prs2026/Lyra-flight-computer/Hardware/datasheets/Radio module based TI CC1200. - Radio modules, Dongles_files/ABUIABACGAAgv4mNmwYokPiDzgMw6Ac46Ac.jpg

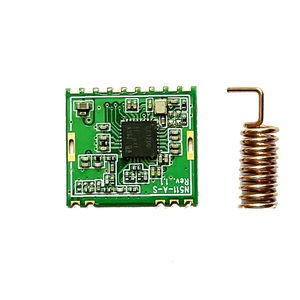
Hardware/datasheets/Radio module based TI CC1200. - Radio modules, Dongles_files/ABUIABACGAAgv4mNmwYokPiDzgMw6Ac46Ac.jpg
