prs2026/Lyra-flight-computer/Hardware/datasheets/Radio module based TI CC1200. - Radio modules, Dongles_files/ABUIABACGAAguJqjggYo55KYYjDoBzjnBw.jpg

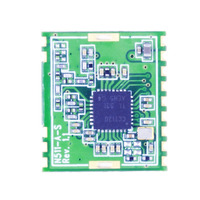
Hardware/datasheets/Radio module based TI CC1200. - Radio modules, Dongles_files/ABUIABACGAAguJqjggYo55KYYjDoBzjnBw.jpg
