prs2026/Lyra-flight-computer/README.md

# Lyra-flight-computer
 repo for the lyra flight computer
