prs2026/Lyra-flight-computer/Hardware/kicad/lero ground station/design.rtf

Overview:
pico connected to a 4 line LCD, speaker, radio and sd

voice sythesis? or otherwise voice output on a speaker
battery charging circuit?

workings:
recieve data from lyra, log to sd card and display on the lcd.

stuff to display
Altitude
lat + long when I add gps
MET
