prs2026/Lyra-flight-computer/Hardware/datasheets/Radio module based TI CC1200. - Radio modules, Dongles_files/ABUIABAEGAAg1KeBlQYo9vu29QQwpAc46gY.png

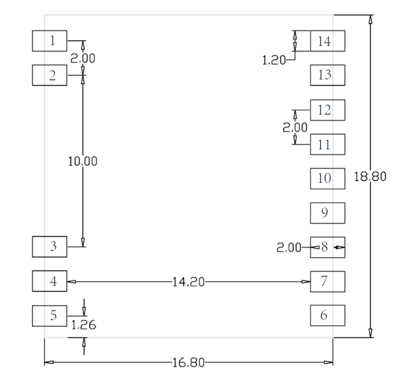
Hardware/datasheets/Radio module based TI CC1200. - Radio modules, Dongles_files/ABUIABAEGAAg1KeBlQYo9vu29QQwpAc46gY.png
