prs2026/Lyra-flight-computer/Hardware/datasheets/Radio module based TI CC1200. - Radio modules, Dongles_files/ABUIABAEGAAgr9ThggYow-nh9QQwoAY4wAI.png

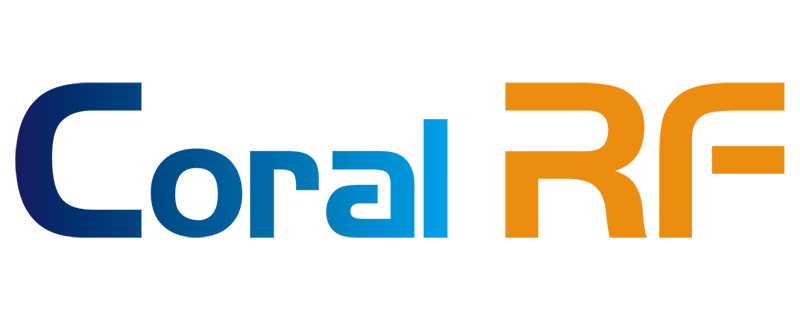
Hardware/datasheets/Radio module based TI CC1200. - Radio modules, Dongles_files/ABUIABAEGAAgr9ThggYow-nh9QQwoAY4wAI.png
