prs2026/Lyra-flight-computer/Hardware/datasheets/Radio module based TI CC1200. - Radio modules, Dongles_files/ABUIABAEGAAgvt3XlAYovsDUowUwhgo4zQQ.png

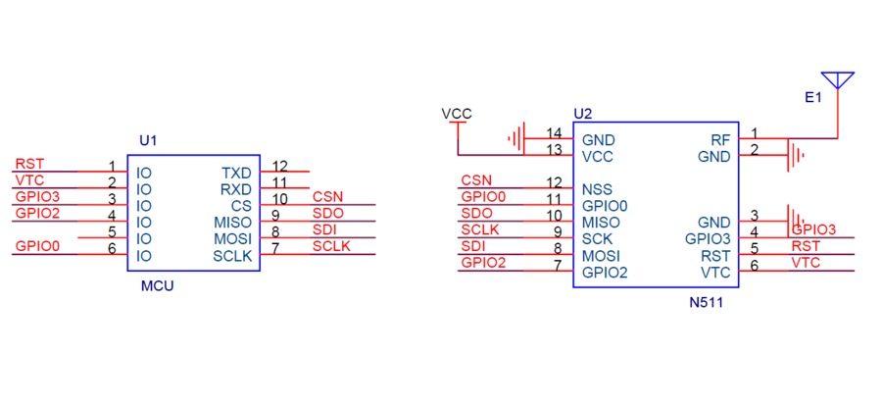
Hardware/datasheets/Radio module based TI CC1200. - Radio modules, Dongles_files/ABUIABAEGAAgvt3XlAYovsDUowUwhgo4zQQ.png
