prs2026/Lyra-flight-computer/Software/Ground/lero reciver/audio player arduino/circuit sd addeptor.jpg

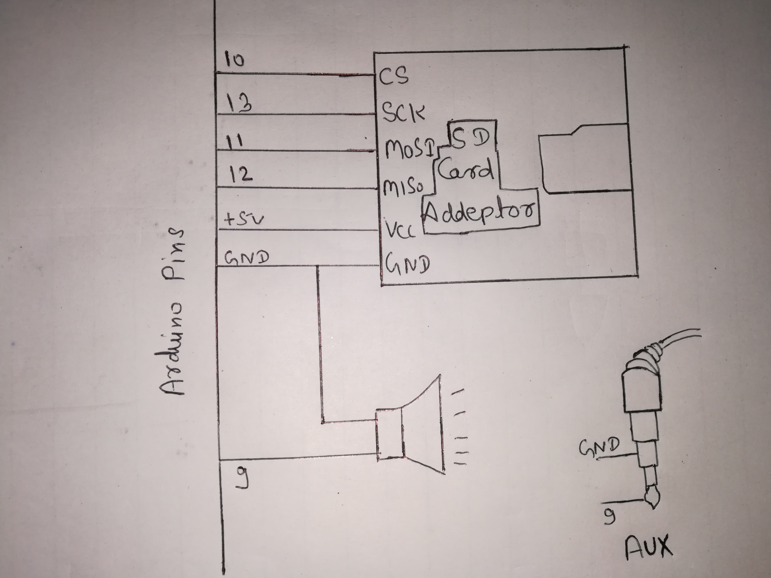
Software/Ground/lero reciver/audio player arduino/circuit sd addeptor.jpg
