prs2026/Lyra-flight-computer/Hardware/kicad/Leo/jlcpcb/production_files/BOM-LEO.csv

Comment | Designator | Footprint | LCSC
1k | R10,R11,R12,R14,R17,R28,R3 | R_0402_1005Metric | C11702
AO3401A | Q1,Q3 | SOT-23 | C15127
100n | C1,C12,C13,C16,C17,C2,C21,C22,C23,C24,C25,C26,C27,C3,C4,C50,C8,C9 | C_0402_1005Metric | C1525
D_Schottky | D1 | D_SOD-323F | C191023
RT9013-33GB_C19268157 | U6 | SOT-23-5_L2.9-W1.6-P0.95-LS2.8-BR | C19268157
BMI088 | U2 | LGA-16_L4.5-W3.0-P0.50-BL | C194919
RP2040 | U8 | QFN-56-1EP_7x7mm_P0.4mm_EP3.2x3.2mm | C2040
AO3400A | Q2,Q4,Q5,Q9 | SOT-23 | C20917
22R | R15,R18 | R_0402_1005Metric | C25092
30k | R2,R20,R22,R24,R26 | R_0402_1005Metric | C25105
51k | R21,R23,R25,R27,R4 | R_0402_1005Metric | C25794
5.1k | R1,R13,R16 | R_0402_1005Metric | C25905
SX1M12.000M10F30TNN | X2 | OSC-SMD_4P-L2.0-W1.6-BL | C2901608
USB_B_Micro | J7 | MICRO-USB-SMD_U254-051T-4BHJ25-F2S | C381143
LIS3MDLTR | U4 | LGA-12_L2.0-W2.0-P0.50-BL | C478483
ADXL375BCCZ-RL7 | U5 | LGA-14_L5.0-W3.0-P0.80-BL | C481898
1u | C18,C19,C32,C5,C6 | C_0402_1005Metric | C52923
BMP388 | U3 | SENSORM-SMD_BMP388 | C779278
10u | C7 | C_0603_1608Metric | C96446
W25Q128JVS | U9 | SOIC-8_5.23x5.23mm_P1.27mm | C97521
