prs2026/Lyra-flight-computer/Hardware/kicad/Lyra_flight_computer/lyrav3revised/lyrav3r1/power use.xlsx

part | datasheet | max power draw (mA) | total power draw
rp2040 | https://datasheets.raspberrypi.com/rp2040/rp2040-datasheet.pdf | 50 | 201
flash | http://www.winbond.com/resource-files/w25q128jv_dtr%20revc%2003272018%20plus.pdf | 25
high g accel | https://lcsc.com/product-detail/New-Arrivals_Analog-Devices-ADI-ADXL375BCCZ-RL7_C481898.html | 0.2
bmp390 | https://www.mouser.com/pdfdocs/BST-BMP388-DS001-01.pdf | 0.8
bmi088 | https://download.mikroe.com/documents/datasheets/BMI088_Datasheet.pdf | 5
sx1262 |  | 120
