prs2026/Lyra-flight-computer/CamControl/camcontrol stm32/camcontrol stm32.step

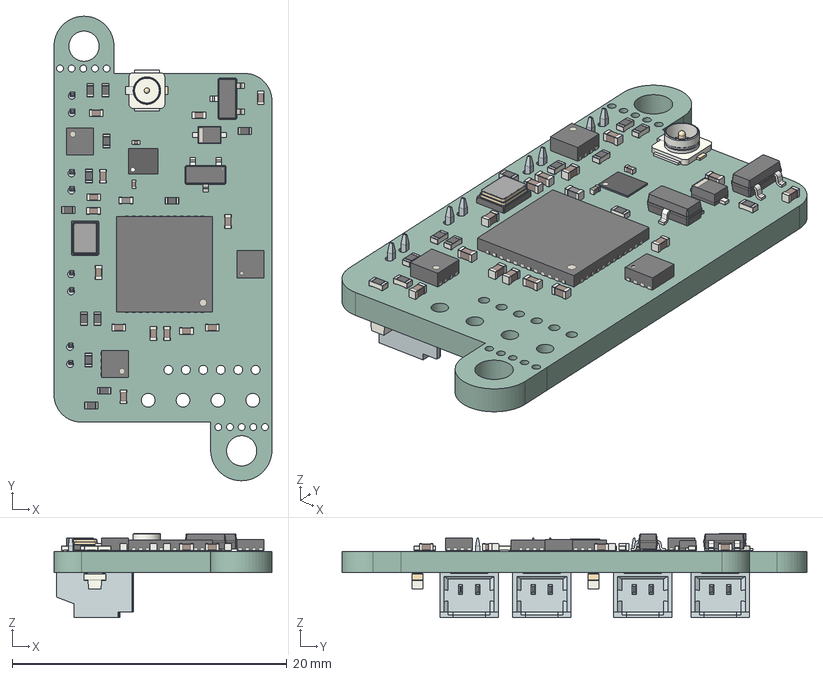
[picture p7: CAD file, 2025-12-25]
CamControl/camcontrol stm32/camcontrol stm32.step
15.9 x 33.8 x 6.13 mm
C_0402_1005Metric x 14
R_0402_1005Metric x 12
D_SOD-323F
C_0201_0603Metric x 2
CSPG-8_L2.1-W1.8_BALFHB-WL-03D3
SOT-23 x 2
DFN-8_2x2mm_P0.5mm x 2
WSON-8-1EP_2x2mm_P0.5mm_EP0.9x1.6mm
QFN-48-1EP_7x7mm_P0.5mm_EP5.15x5.15mm
Crystal_SMD_2520-4Pin_2.5x2.0mm
U.FL_Hirose_U.FL-R-SMT-1_Vertical
L_0402_1005Metric
LED_0603_1608Metric x 2
camcontrol stm32_PCB
