prs2026/Lyra-flight-computer/Hardware/kicad/Lyra_flight_computer/lyrav3r1/lyrav3r2/Lyrav3r2.step

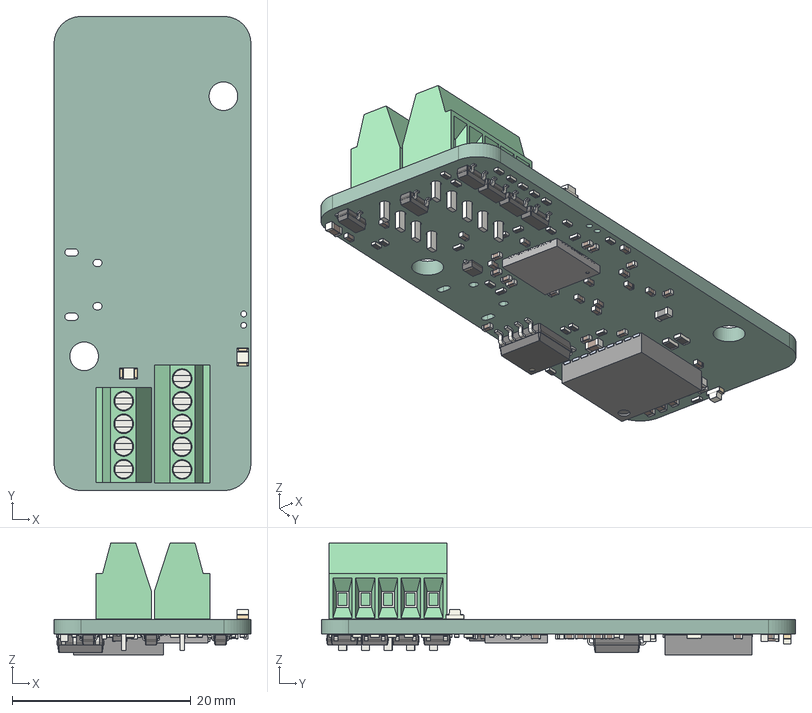
[picture p9: CAD file, 2024-06-25]
Hardware/kicad/Lyra_flight_computer/lyrav3r1/lyrav3r2/Lyrav3r2.step
22.0 x 53.0 x 12.5 mm
TerminalBlock_Phoenix_MPT_05_5_254_1x05_P254mm_Horizontal
TerminalBlock_Phoenix_MPT_05_4_254_1x04_P254mm_Horizontal
LED_0805_2012Metric x 2
C_0402_1005Metric x 28
R_0402_1005Metric x 24
C_0603_1608Metric x 7
SOT_23 x 6
SOIC_8_5275x5275mm_P127mm
D_SOD_323F
QFN_56_1EP_7x7mm_P04mm_EP32x32mm
R_0603_1608Metric x 2
L_0603_1608Metric
LED_0603_1608Metric
L_0402_1005Metric
ASSEMBLY
lyrav3r2_PCB
