prs2026/Lyra-flight-computer/Hardware/kicad/Lyra_flight_computer/lyrav3r1/recivier/recivier.step

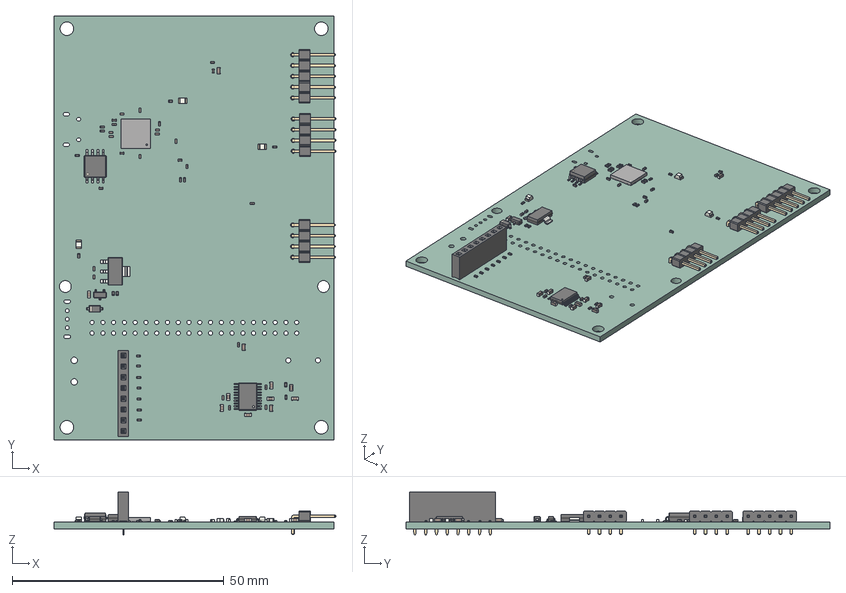
[picture p10: CAD file, 2024-04-02]
Hardware/kicad/Lyra_flight_computer/lyrav3r1/recivier/recivier.step
66.4 x 100.0 x 10.1 mm
R_0402_1005Metric x 20
QFN_56_1EP_7x7mm_P04mm_EP32x32mm
C_0402_1005Metric x 24
TSSOP_20_44x65mm_P065mm
C_0603_1608Metric x 11
PinHeader_1x04_P254mm_Horizontal x 2
D_SOD_123
PinHeader_1x05_P254mm_Horizontal
SOT_23
LED_0805_2012Metric x 3
SOIC_8_5275x5275mm_P127mm
PinSocket_1x08_P254mm_Vertical
SOT_223
recivier_PCB
