prs2026/Lyra-flight-computer/Hardware/kicad/Lyra_flight_computer/lyrav3revised/lyrav3r1/Lyrav3.step

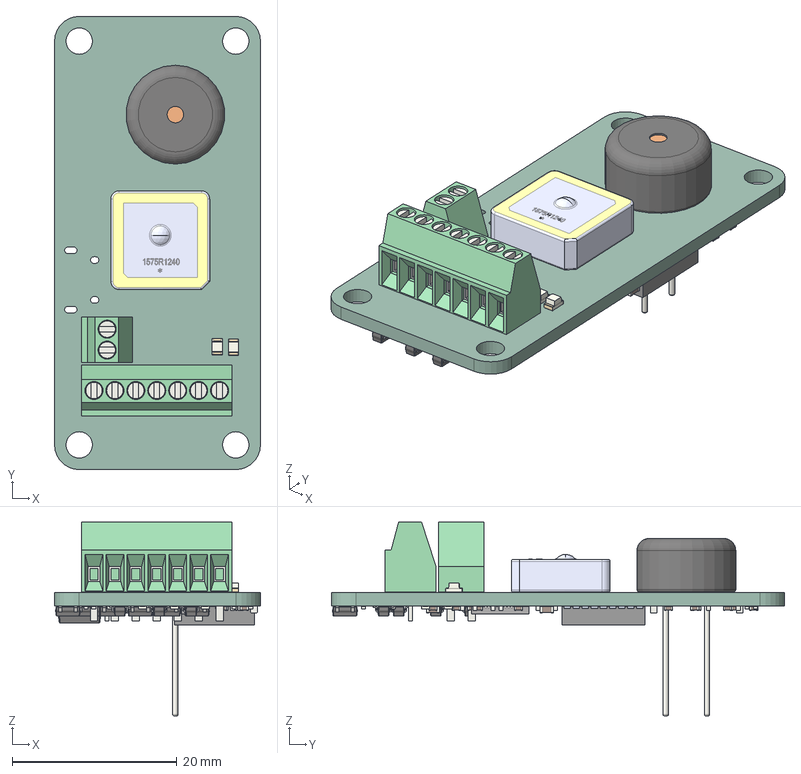
[picture p11: CAD file, 2024-10-01]
Hardware/kicad/Lyra_flight_computer/lyrav3revised/lyrav3r1/Lyrav3.step
25.0 x 55.0 x 23.5 mm
Buzzer_TDK_PS1240P02BT
TerminalBlock_Phoenix_MPT_05_7_254_1x07_P254mm_Horizontal
APAE1575R1240ABDD1-T
TerminalBlock_Phoenix_MPT_05_2_254_1x02_P254mm_Horizontal
LED_0805_2012Metric x 2
C_0402_1005Metric x 29
R_0402_1005Metric x 18
SOT_23 x 10
SOIC_8_5275x5275mm_P127mm
D_SOD_323F
QFN_56_1EP_7x7mm_P04mm_EP32x32mm
C_0603_1608Metric x 4
L_0402_1005Metric x 2
DFN-6_L1.5-W1.0-H0.7-P0.50
ASSEMBLY
lyrav3r1_PCB
