prs2026/Lyra-flight-computer/Hardware/kicad/Lyra_flight_computer/lyrav3revised/lyrav3r2/Lora E22-900MM22S.STEP

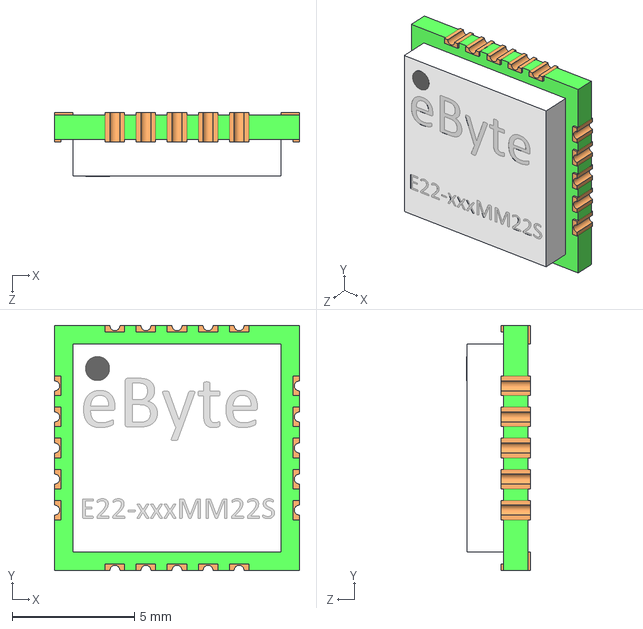
[picture p12: CAD file, 2024-06-25]
Hardware/kicad/Lyra_flight_computer/lyrav3revised/lyrav3r2/Lora E22-900MM22S.STEP
10.0 x 10.0 x 2.61 mm
