prs2026/Lyra-flight-computer/Hope/Hope/Hope.step

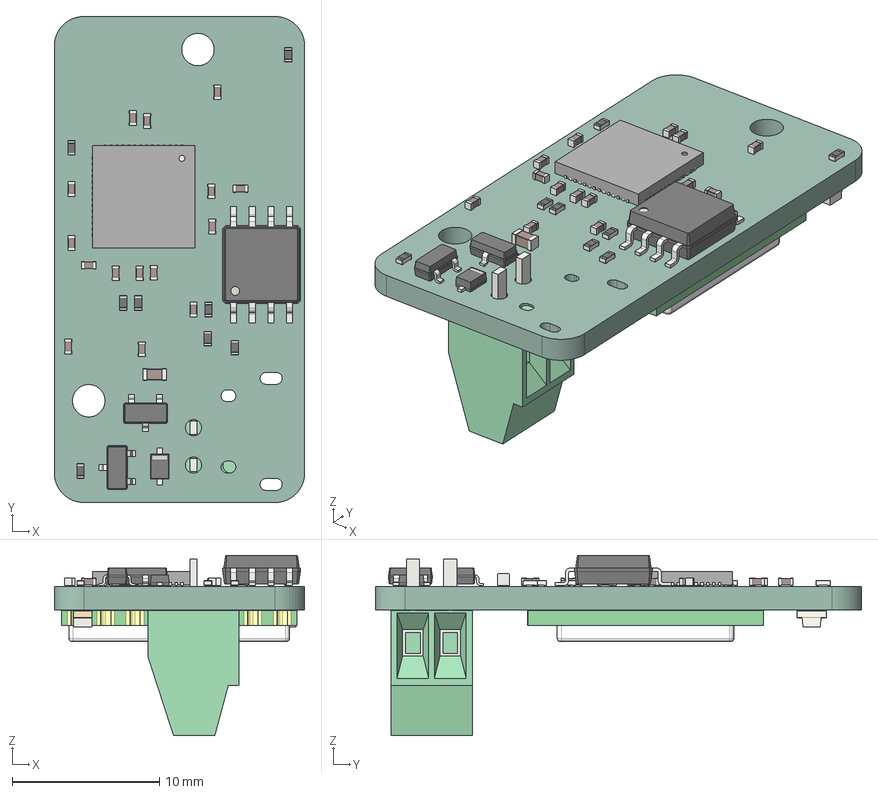
[picture p13: CAD file, 2025-02-11]
Hope/Hope/Hope.step
17.0 x 33.0 x 12.3 mm
C_0402_1005Metric x 15
R_0402_1005Metric x 8
SOT_23 x 2
D_SOD_323F
SOIC_8_5275x5275mm_P127mm
QFN_56_1EP_7x7mm_P04mm_EP32x32mm
C_0603_1608Metric
TerminalBlock_Phoenix_MPT_05_2_254_1x02_P254mm_Horizontal
WIRELM-SMD_16P-L16.0-W16.0-P2.00_LORA-CC68-915MHZ-TCXO
LED_0805_2012Metric x 2
Hope_PCB
