prs2026/Lyra-flight-computer/it sure is getting hot in here/it sure is getting ROUND in here/it sure is getting hot in hererev1.step

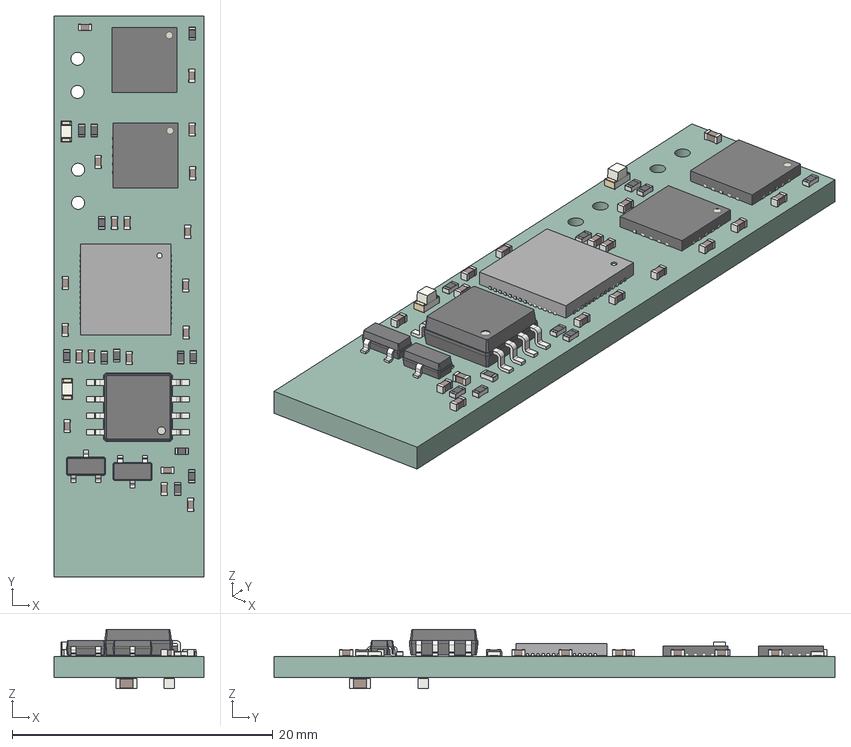
[picture p14: CAD file, 2025-09-30]
it sure is getting hot in here/it sure is getting ROUND in here/it sure is getting hot in hererev1.step
11.5 x 43.0 x 4.55 mm
LED_0603_1608Metric x 2
C_0402_1005Metric x 19
R_0402_1005Metric x 12
QFN-20-1EP_5x5mm_Pitch0.65mm x 2
SOT_23 x 2
QFN_56_1EP_7x7mm_P04mm_EP32x32mm
SOIC_8_5275x5275mm_P127mm
C_0603_1608Metric x 2
it sure is getting hot in here_PCB
