prs2026/Lyra-flight-computer/Metrumizer/metrumizer/metrumizer.step

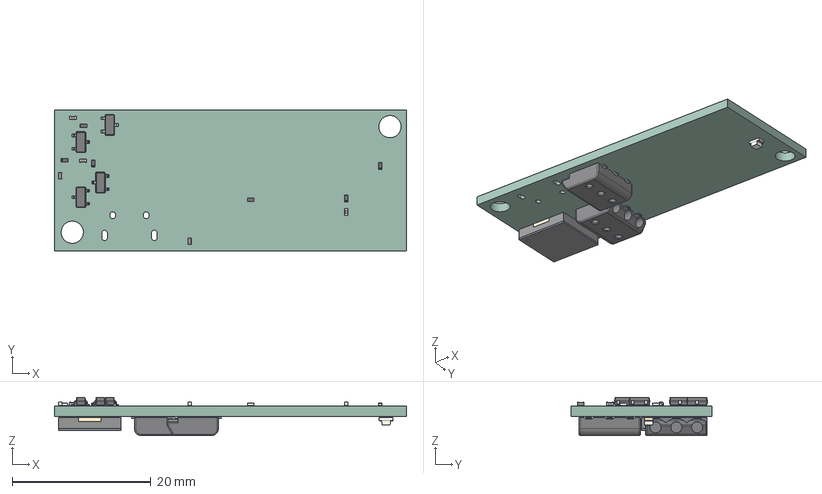
[picture p15: CAD file, 2025-12-25]
Metrumizer/metrumizer/metrumizer.step
50.8 x 20.3 x 5.53 mm
C_0402_1005Metric x 4
R_0402_1005Metric x 6
SOT-23 x 4
L_0402_1005Metric
LED_0805_2012Metric
PKMCS0909E4000-R1
2059-323_998-403_HI x 2
metrumizer_PCB
