prs2026/Lyra-flight-computer/Hardware/kicad/Leo/LEO.step

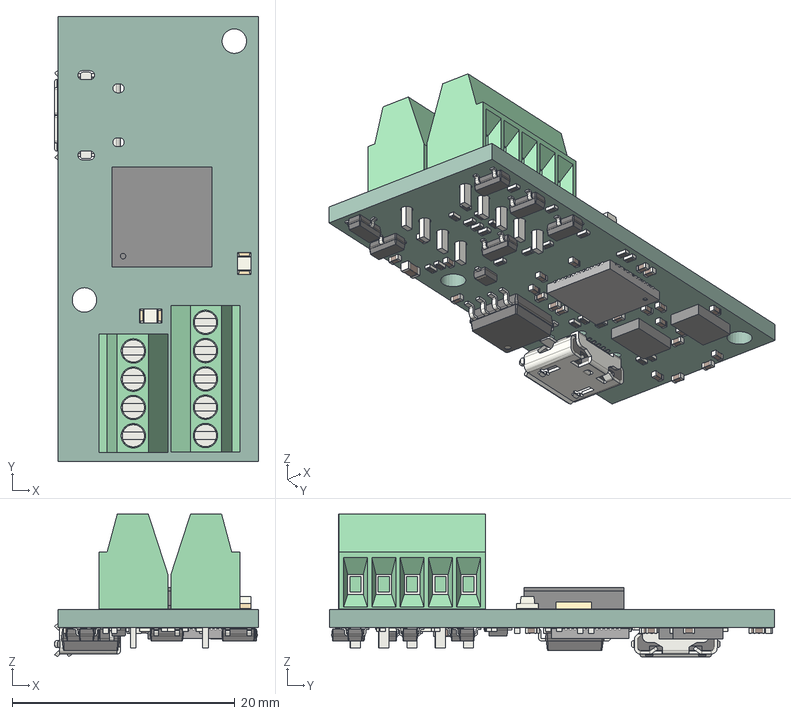
[picture p16: CAD file, 2024-10-01]
Hardware/kicad/Leo/LEO.step
18.3 x 40.0 x 12.8 mm
PKMCS0909E4000-R1
TerminalBlock_Phoenix_MPT_05_5_254_1x05_P254mm_Horizontal
TerminalBlock_Phoenix_MPT_05_4_254_1x04_P254mm_Horizontal
LED_0805_2012Metric x 2
R_0402_1005Metric x 22
C_0402_1005Metric x 23
SOT_23 x 6
SOIC_8_5275x5275mm_P127mm
D_SOD_323F
QFN_56_1EP_7x7mm_P04mm_EP32x32mm
C_0603_1608Metric
BMI088 x 2
USB_Micro-B_Molex_47346-0001
lyrav3r2_PCB
