prs2026/Lyra-flight-computer/Hardware/kicad/Lyra_flight_computer/lyrav3revised/lyrav3r1/Lyrav3r2.step

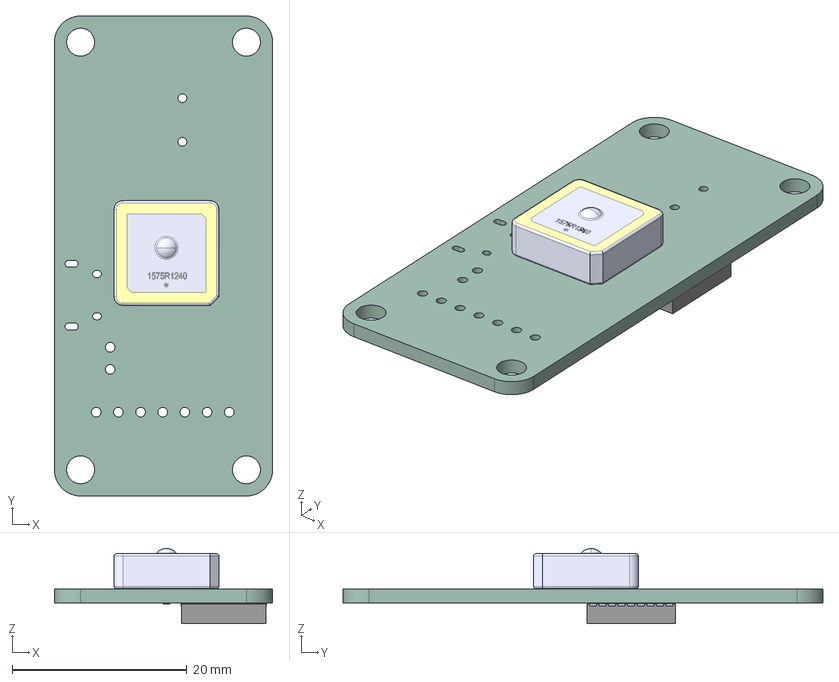
[picture p17: CAD file, 2024-04-06]
Hardware/kicad/Lyra_flight_computer/lyrav3revised/lyrav3r1/Lyrav3r2.step
25.0 x 55.0 x 8.60 mm
APAE1575R1240ABDD1-T
ASSEMBLY
lyrav3r1_PCB
