prs2026/Lyra-flight-computer/it sure is getting hot in here/it sure is getting ROUND in here/it sure is getting hot in hererev2.step

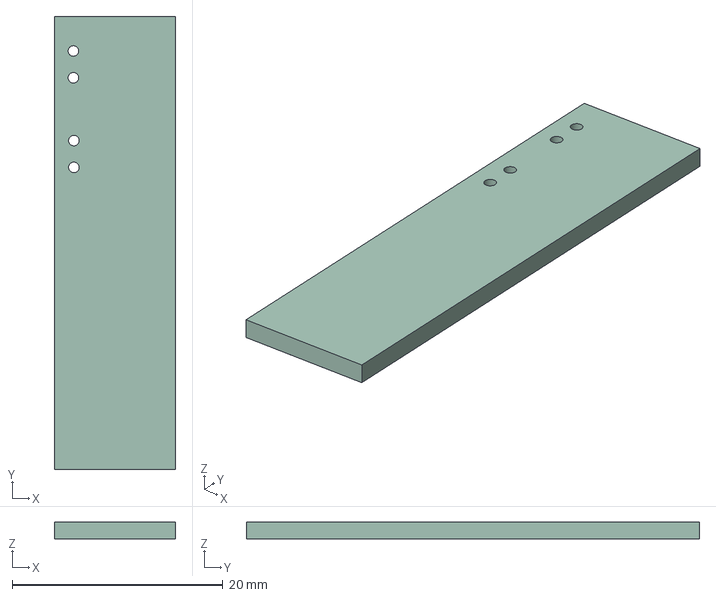
[picture p18: CAD file, 2025-09-30]
it sure is getting hot in here/it sure is getting ROUND in here/it sure is getting hot in hererev2.step
11.5 x 43.0 x 1.60 mm
