prs2026/Lyra-flight-computer/it sure is getting hot in here/it sure is getting ROUND in here/it sure is getting hot in here.step

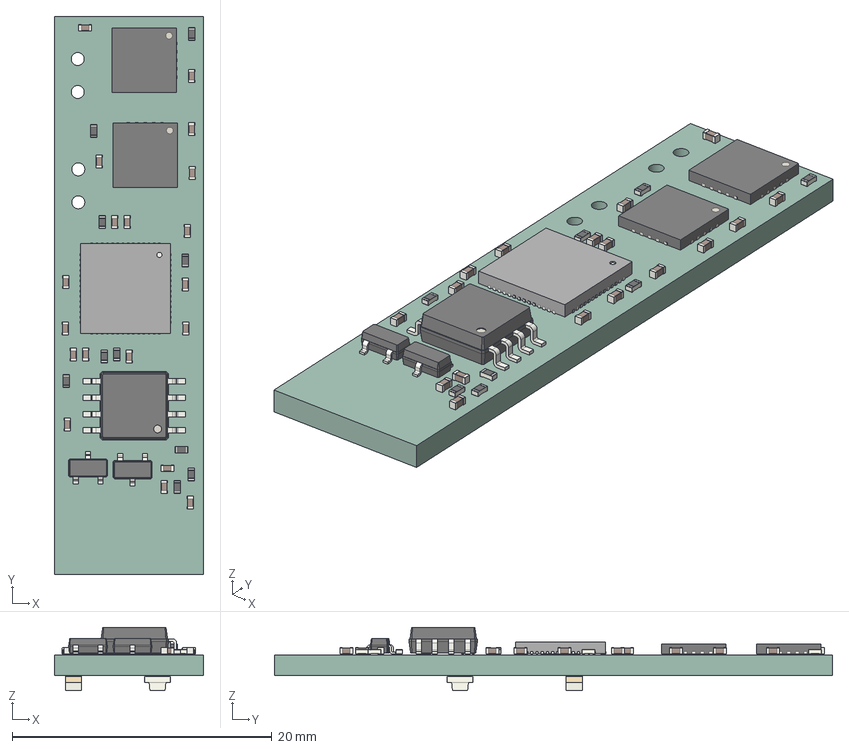
[picture p19: CAD file, 2025-08-10]
it sure is getting hot in here/it sure is getting ROUND in here/it sure is getting hot in here.step
11.5 x 43.0 x 4.86 mm
C_0402_1005Metric x 19
R_0402_1005Metric x 10
QFN-20-1EP_5x5mm_Pitch0.65mm x 2
SOT_23 x 2
QFN_56_1EP_7x7mm_P04mm_EP32x32mm
SOIC_8_5275x5275mm_P127mm
LED_0805_2012Metric x 2
it sure is getting hot in here_PCB
