prs2026/Lyra-flight-computer/Hardware/kicad/screw switch/screw switch.step

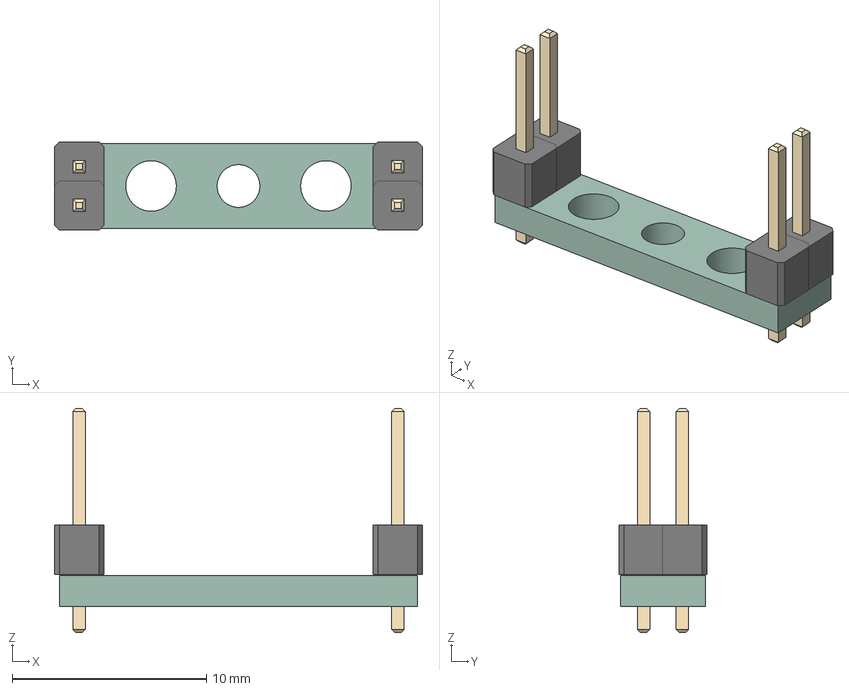
[picture p20: CAD file, 2024-04-09]
Hardware/kicad/screw switch/screw switch.step
18.9 x 4.54 x 11.5 mm
PinHeader_1x01_P254mm_Vertical x 4
screw switch_PCB
