prs2026/Lyra-flight-computer/it sure is getting hot in here/ISIGHIH Firmware/test/test.csv

index | checksum | uptime mp | uptime nav | missiontime | errorflag mp | errorflag NAV | accel x | accel y | accel z | accelworld x | accelworld y | accelworld z | mag x | mag y | mag z | accelhighg x | accelhighg y | accelhighg z | gyro x | gyro y | gyro z | euler x | euler y | euler z | quat w | quat x | quat y | quat z | quatadj w | quatadj x | quatadj y | quatadj z | altitude | presusre | verticalvel | filtered vvel | maxalt | altitudeagl | filtered alt | imutemp | barotemp | abs imu accel | abs adxl accel | pad altitude | baro max alt | mag raw x | mag raw y | mag raw z | cov x | cov y | cov z | sats | status | met | filtered accel | state | battstate | pyros fired | pyros cont
newfile
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
