prs2026/Lyra-flight-computer/it sure is getting hot in here/ISIGHIH Firmware/datatesting/test1.csv

index | checksum | uptime mp | uptime nav | errorflag mp | errorflag NAV | accel x | accel y | accel z | accelworld x | accelworld y | accelworld z | accelhighg x | accelhighg y | accelhighg z | gyro x | gyro y | gyro z | euler x | euler y | euler z | quat w | quat x | quat y | quat z | altitude | presusre | verticalvel | filtered vvel | altitudeagl | filtered alt | imutemp | barotemp | state | checksum2
0 | 101 | 0 | 0 | 1 | 1 | 0.000000 | 0.000000 | 0.000000 | 0.000000 | 0.000000 | 0.000000 | 0.000000 | 0.000000 | 0.000000 | 0.000000 | 0.000000 | 0.000000 | 0.000000 | 0.000000 | 0.000000 | 1.000000 | 0.000000 | 0.000000 | 0.000000 | 0.000000 | 0.000000 | 0.000000 | 0.000000 | 0.000000 | 0.000000 | 0.000000 | 0.000000 | 0.000000 | 0 | 0.000000 | 202
1 | 101 | 3313 | 0 | 1 | 1 | 0.000000 | 0.000000 | 0.000000 | 0.000000 | 0.000000 | 0.000000 | 0.000000 | 0.000000 | 0.000000 | 0.000000 | 0.000000 | 0.000000 | 0.000000 | 0.000000 | 0.000000 | 1.000000 | 0.000000 | 0.000000 | 0.000000 | 0.000000 | 0.000000 | 0.000000 | 0.000000 | 0.000000 | 0.000000 | 0.000000 | 0.000000 | 0.000000 | 0 | 0.000000 | 202
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
