prs2026/Lyra-flight-computer/avionics/Lyra_flight_computer/flight logs/pyxisflight1.CSV

checksum | uptime mp | uptime nav | errorflag mp | errorflag nav | accel x | accel y | accel z | gyro x | gyro y | gyro z | mag x | mag y | mag z | magraw x | magraw y | magraw z | euler x | euler y | euler z | quat w | quat x | quat y | quat z | altitude | pressure | verticalvel | maxrecorded alt | altitudeagl | filteredalt | imutemp | barotemp | state | checksum2
101 | 1260387 | 1252626 | 0 | 0 | -0.177125 | 0.500252 | 9.898839 | 0.354960 | 0.654396 | 0.094211 | -18.479397 | 40.888618 | -0.321543 | -3787.000000 | 3631.000000 | -22.000000 | 4.268216 | -86.976380 | 69.927217 | 0.608846 | -0.371965 | -0.579086 | 0.394471 | 1214.335449 | 87473.000000 | -0.153709 | 1.551636 | 1.353394 | 1.311904 | 35.000000 | 38.999214 | 0 | 202
101 | 1262394 | 1262310 | 0 | 0 | -0.164170 | 0.498941 | 9.900160 | -0.031020 | -0.137473 | 0.366430 | -18.503839 | 40.928665 | -0.643087 | -3791.000000 | 3638.000000 | -44.000000 | 6.118524 | -86.963007 | 71.786914 | 0.608505 | -0.371485 | -0.579361 | 0.395046 | 1214.402954 | 87475.445312 | 0.144479 | 1.561157 | 1.420898 | 1.417515 | 35.000000 | 39.003880 | 0 | 202
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
