prs2026/Lyra-flight-computer/avionics/Lyra_flight_computer/flight logs/zubeflight2.CSV

checksum | uptime mp | uptime nav | errorflag mp | errorflag nav | accel x | accel y | accel z | gyro x | gyro y | gyro z | mag x | mag y | mag z | magraw x | magraw y | magraw z | euler x | euler y | euler z | quat w | quat x | quat y | quat z | altitude | pressure | verticalvel | maxrecorded alt | altitudeagl | filteredalt | imutemp | barotemp | state | checksum2
101 | 322135 | 319105 | 0 | 0 | 0.817812 | -0.598308 | 9.834366 | 0.809239 | 0.152227 | 0.883112 | -6.972553 | 43.217102 | 1.885414 | -1904.000000 | 4038.000000 | 129.000000 | 135.472240 | -84.195230 | -143.862936 | 0.502630 | -0.454448 | -0.574046 | 0.459687 | 1232.238037 | 87282.765625 | -0.061910 | 1.455688 | 1.273315 | 1.265883 | 24.500000 | 26.545038 | 0 | 202
101 | 324143 | 324058 | 0 | 0 | 0.809029 | -0.578547 | 9.845196 | -0.207328 | -0.027697 | 1.396003 | -6.862555 | 43.148449 | 2.002338 | -1886.000000 | 4026.000000 | 137.000000 | 134.648765 | -84.231286 | -144.430975 | 0.501874 | -0.455240 | -0.572778 | 0.461307 | 1232.297607 | 87282.640625 | -0.013684 | 1.455688 | 1.332886 | 1.337708 | 24.500000 | 26.582432 | 0 | 202
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
