prs2026/Lyra-flight-computer/Hardware/kicad/Lyra_flight_computer/lyra2/flightlogs/LOGFILE1.CSV

rkf | accel_x | accel_y | accel_z | gyro_x | gyro_y | gyro_z | yaw | pitch | roll | imutemp | pressure | altitude | bmptemp | verticalvelocity | apoogee | state | uptime(milliseconds) | errorflag
0 | 7.6707 | 2.2548 | 6.0145 | -2.6630 | -0.3867 | -7.9365 | -12.9903 | 52.2393 | 115.8277 | 42.2500 | 87770.4375 | 0.7114 | 44.9905 | 0.2433 | 1.1755 | 0 | 10086 | 1
0 | 8.1281 | 2.4733 | 6.9114 | -2.7241 | -18.9009 | 1.4930 | -24.4018 | 40.8634 | 112.7664 | 42.2500 | 87768.1953 | 0.9207 | 45.0091 | 0.4742 | 0.9836 | 0 | 15105 | 1
0 | 7.2967 | 0.4414 | 6.7489 | 10.6792 | -3.0667 | 6.2736 | -14.8426 | 43.7264 | 103.0412 | 42.3750 | 87771.7578 | 0.5874 | 45.0371 | 0.2137 | 0.8574 | 0 | 20126 | 1
0 | 0.4011 | 4.0184 | 6.9703 | 26.1231 | 9.7951 | 99.4248 | -8.1210 | 4.0689 | 118.1751 | 42.2500 | 87775.4688 | 0.2404 | 45.0558 | 0.0591 | 0.4431 | 0 | 25144 | 1
0 | 7.6908 | 1.2518 | -6.9152 | 1.7443 | 4.4224 | -64.9015 | -13.7254 | 129.7925 | 196.4875 | 42.2500 | 87778.9922 | -0.0884 | 45.0745 | 0.8932 | 0.0254 | 0 | 30168 | 1
0 | 7.6858 | 2.2824 | -6.2808 | 2.4095 | -1.6501 | -0.1044 | -8.1023 | 126.9644 | 205.8139 | 42.3750 | 87784.9766 | -0.6482 | 45.0978 | -0.1191 | -0.0959 | 0 | 35187 | 1
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
