prs2026/Lyra-flight-computer/Hardware/kicad/Lyra_flight_computer/lyra2/flightlogs/LOGFILE2.CSV

rkf | accel_x | accel_y | accel_z | gyro_x | gyro_y | gyro_z | yaw | pitch | roll | imutemp | pressure | altitude | bmptemp | verticalvelocity | apoogee | state | uptime(milliseconds) | errorflag
0 | -3.7295 | -3.6840 | 8.2413 | 33.6469 | 25.9462 | 10.0709 | 22.4820 | 72.9950 | -118.7534 | 36.7500 | 87765.0469 | -0.1695 | 39.0041 | -0.3835 | 0.6638 | 0 | 5044 | 13
0 | -9.1001 | 1.9223 | 0.0818 | 0.5207 | 0.6981 | 3.0420 | 28.9402 | 45.6147 | -104.1561 | 37.0000 | 87764.7500 | -0.1423 | 39.2377 | 0.7099 | 1.1240 | 0 | 10079 | 13
0 | -9.3395 | -1.0897 | 0.0492 | 1.2762 | 2.3584 | -67.7009 | 28.8891 | 44.0842 | -98.6166 | 37.0000 | 87768.8828 | -0.5283 | 39.3218 | -1.4756 | 0.1786 | 0 | 15119 | 13
0 | -9.2847 | 0.1643 | 0.1077 | 0.6949 | 1.0328 | 2.9314 | 28.4602 | 43.1427 | -75.2206 | 37.1250 | 87766.6016 | -0.3149 | 39.5647 | 0.2551 | 0.1786 | 0 | 20159 | 13
0 | -9.2298 | 0.1659 | 0.1012 | -0.8025 | 1.1831 | -0.2098 | 28.2379 | 43.6688 | -75.5935 | 37.2500 | 87768.4219 | -0.4853 | 39.6534 | -0.5595 | -0.2153 | 1 | 23169 | 13
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
