prs2026/Lyra-flight-computer/Hardware/kicad/Lyra_flight_computer/lyra2/flightlogs/logfile1extra.csv

rkf | accel_x | accel_y | accel_z | gyro_x | gyro_y | gyro_z | yaw | pitch | roll | imutemp | pressure | altitude | bmptemp | verticalvelocity | apoogee | state | uptime(milliseconds) | errorflag
0 | -5.2565 | 7.7158 | 0.0306 | -1.1594 | 0.5281 | -0.5354 | 7.9160 | 3.6631 | 1.6007 | 35.3750 | 87792.5859 | -0.0549 | 37.5651 | 0.0201 | 0.0413 | 0 | 24377 | 17
0 | -4.5564 | 8.2435 | 0.0412 | -1.1815 | 0.1890 | -0.1505 | -8.0245 | 3.1181 | 15.5720 | 35.5000 | 87789.5313 | 0.2303 | 37.6118 | 0.5812 | 0.2303 | 0 | 29405 | 17
0 | -4.5749 | 8.2821 | 0.0289 | 1.3406 | -1.3274 | -0.4210 | -8.1074 | 3.9333 | 16.5389 | 35.3750 | 87791.8203 | 0.0164 | 37.6165 | 0.2073 | 0.2179 | 0 | 34434 | 17
0 | -4.5648 | 8.2559 | 0.0379 | 1.8378 | 0.0462 | 0.7308 | -6.8887 | 3.8337 | 17.8306 | 35.5000 | 87789.9609 | 0.1902 | 37.6118 | 0.9829 | 0.3293 | 0 | 39462 | 17
0 | -4.5641 | 8.2812 | 0.0279 | 0.9119 | 1.7478 | -0.4768 | -6.2480 | 4.9239 | 18.0851 | 35.5000 | 87790.1250 | 0.1749 | 37.6118 | 0.5542 | 0.1749 | 0 | 44491 | 17
0 | -4.5375 | 8.2948 | 0.0337 | -2.3078 | 1.0144 | 1.0347 | -6.4187 | 6.7012 | 18.6357 | 35.3750 | 87792.4141 | -0.0391 | 37.5511 | -0.6751 | 0.3639 | 0 | 49519 | 17
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
