prs2026/Lyra-flight-computer/LOGS/far 2 2.3/testtoob log extended - Copy.csv

index | checksum | uptime mp | uptime nav | errorflag mp | errorflag NAV | accel x | accel y | accel z | accelworld x | accelworld y | accelworld z | accelhighg x | accelhighg y | accelhighg z | gyro x | gyro y | gyro z | euler x | euler y | euler z | quat w | quat x | quat y | quat z | altitude | presusre | verticalvel | filtered vvel | maxalt | altitudeagl | filtered alt | imutemp | barotemp | state | battstate | pyros fired | pyros cont | pyros state | checksum2\r
402 | 101 | 0 | 4762 | 1 | 1 | 5.561176 | 7.471936 | -2.966817 | -0.603268 | -0.905820 | 0.106805 | 4.613962 | 3.926993 | -2.289769 | -21.898614 | 3.279074 | 51.950026 | 23.021863 | 28.322990 | 30.302933 | 0.904320 | 0.249424 | 0.180828 | 0.295456 | 665.099548 | 94178.500000 | -0.238210 | 0.871282 | 0.153809 | 0.044678 | 0.054113 | 14.375000 | 18.877949 | 0 | 4.900000 | 8 | 0 | 0 | 202
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
