prs2026/Lyra-flight-computer/LOGS/tubular ( 1-28-24)/testtube flight 1 01,28,2024, 10,42,35.csv

index | checksum | uptime mp | uptime nav | errorflag mp | errorflag NAV | accel x | accel y | accel z | accelworld x | accelworld y | accelworld z | accelhighg x | accelhighg y | accelhighg z | gyro x | gyro y | gyro z | euler x | euler y | euler z | quat w | quat x | quat y | quat z | altitude | presusre | verticalvel | filtered vvel | maxalt | altitudeagl | filtered alt | imutemp | barotemp | state | battstate | pyros fired | checksum2\r
1506 | 101 | 0 | 4903 | 1 | 1 | 0.604244 | 8.325612 | 4.687630 | -1.343446 | -1.501359 | -0.441733 | -0.191296 | 3.926993 | 5.398644 | 18.185664 | 22.453166 | 30.348269 | 141.085699 | 141.591584 | -135.261651 | 0.864001 | -0.207666 | 0.432524 | 0.152647 | 1306.548096 | 87044.625000 | -1.100749 | 0.323913 | 0.548218 | 0.090820 | 0.198481 | 12.000000 | 16.719513 | 0 | 0.000000 | 0 | 202
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
