prs2026/Lyra-flight-computer/Hardware/kicad/Lyra_flight_computer/lyrav3revised/lyrav3r1/lyrav3r1.pdf

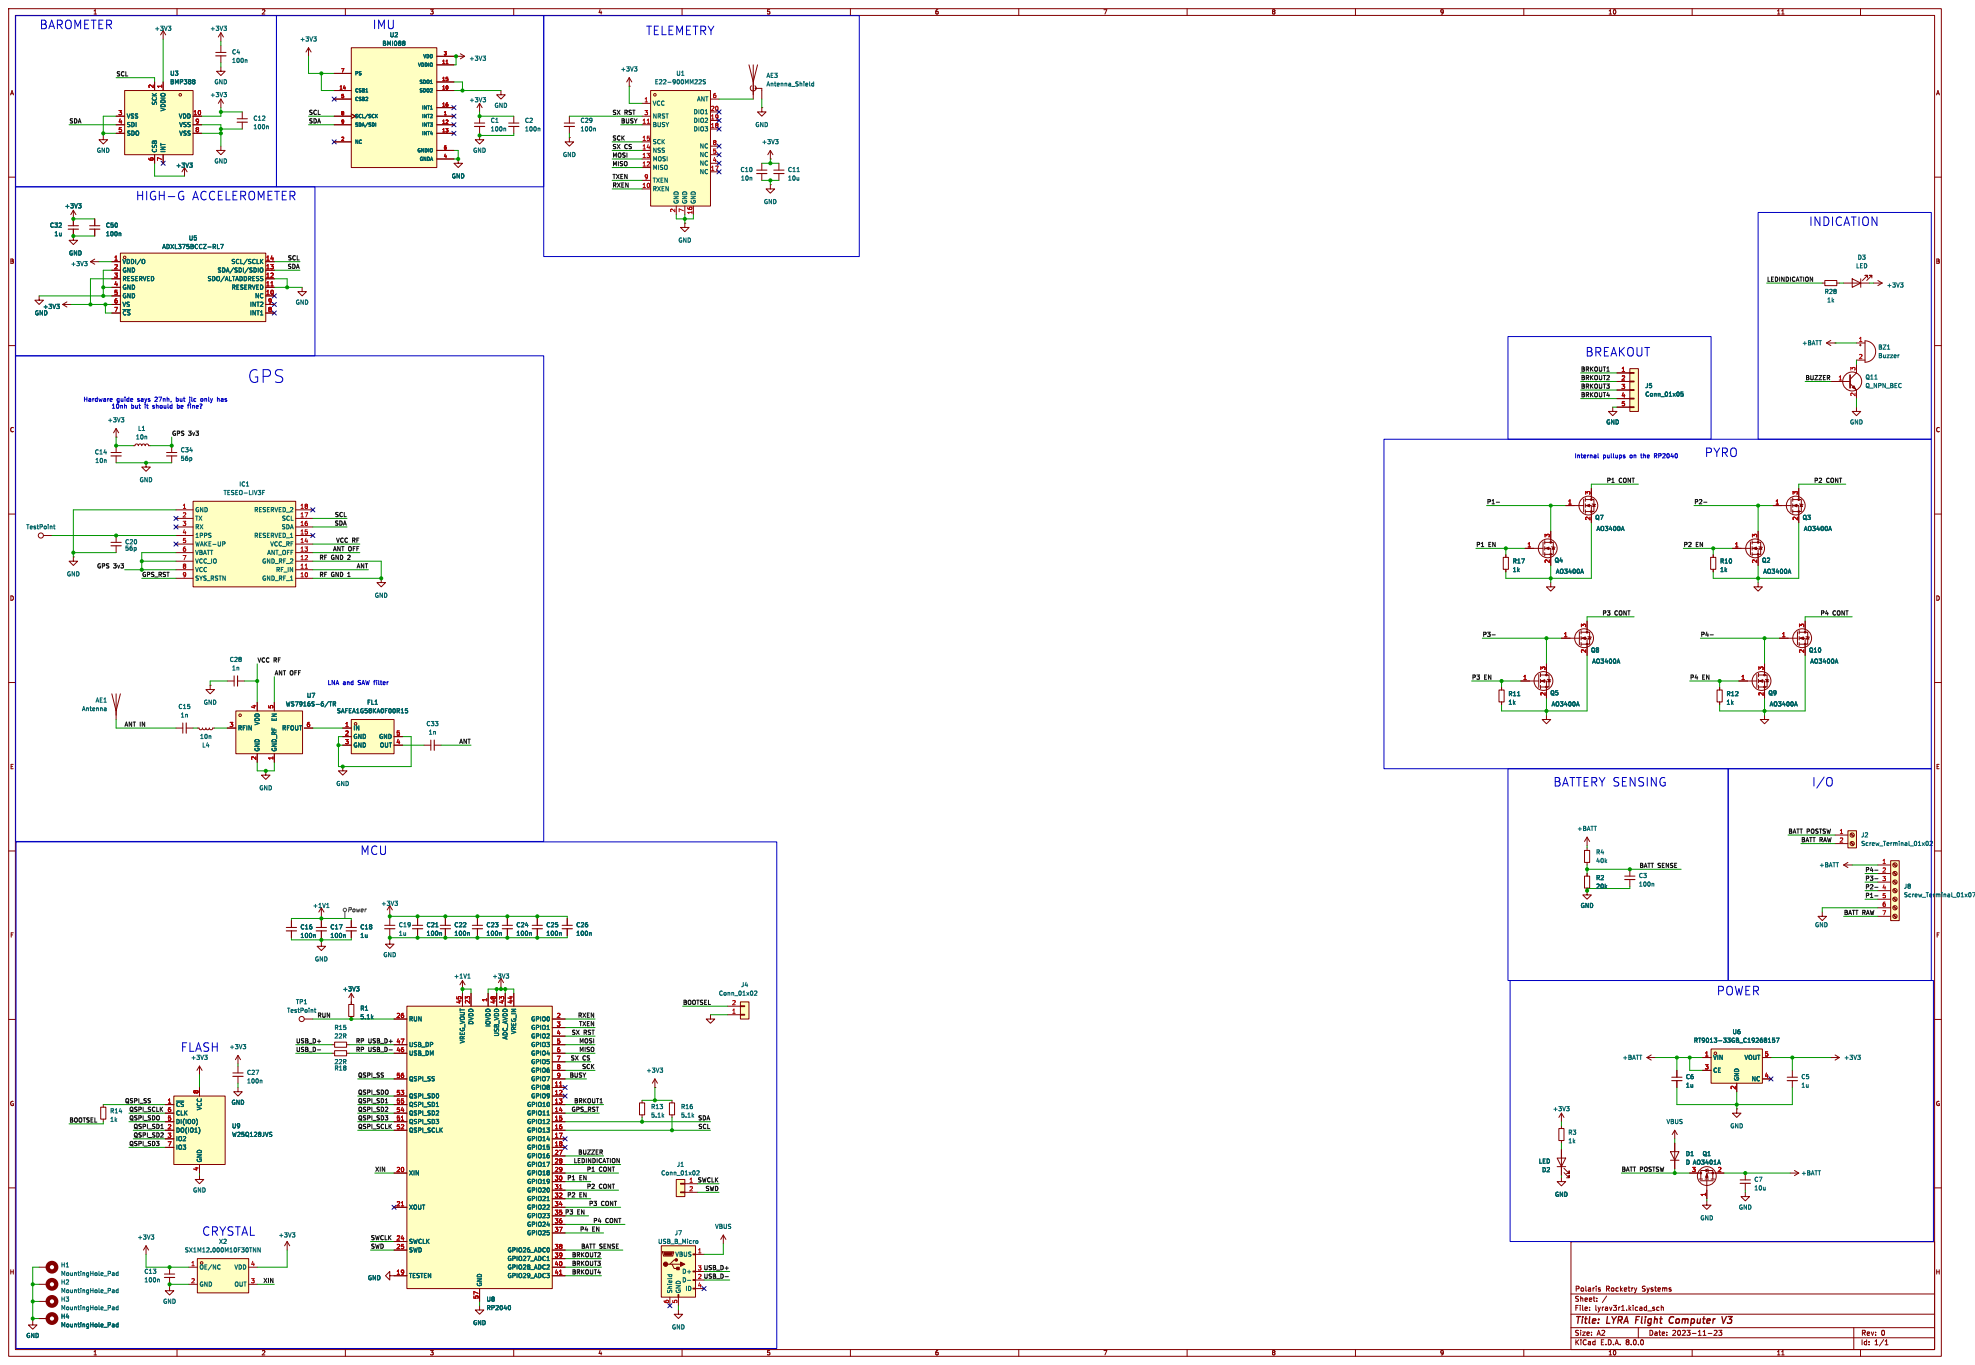
[picture p21: page 1]

+3V3 +3V3 GND
Hardware guide says 27nh, but jlc only has 10nh but it should be fine? FLASH

BATT SENSE RF GND 1

ANT OFF VCC RF
