prs2026/Lyra-flight-computer/CamControl/camcontrol stm32/shhematic print 12.5.25 1.10 pm.pdf

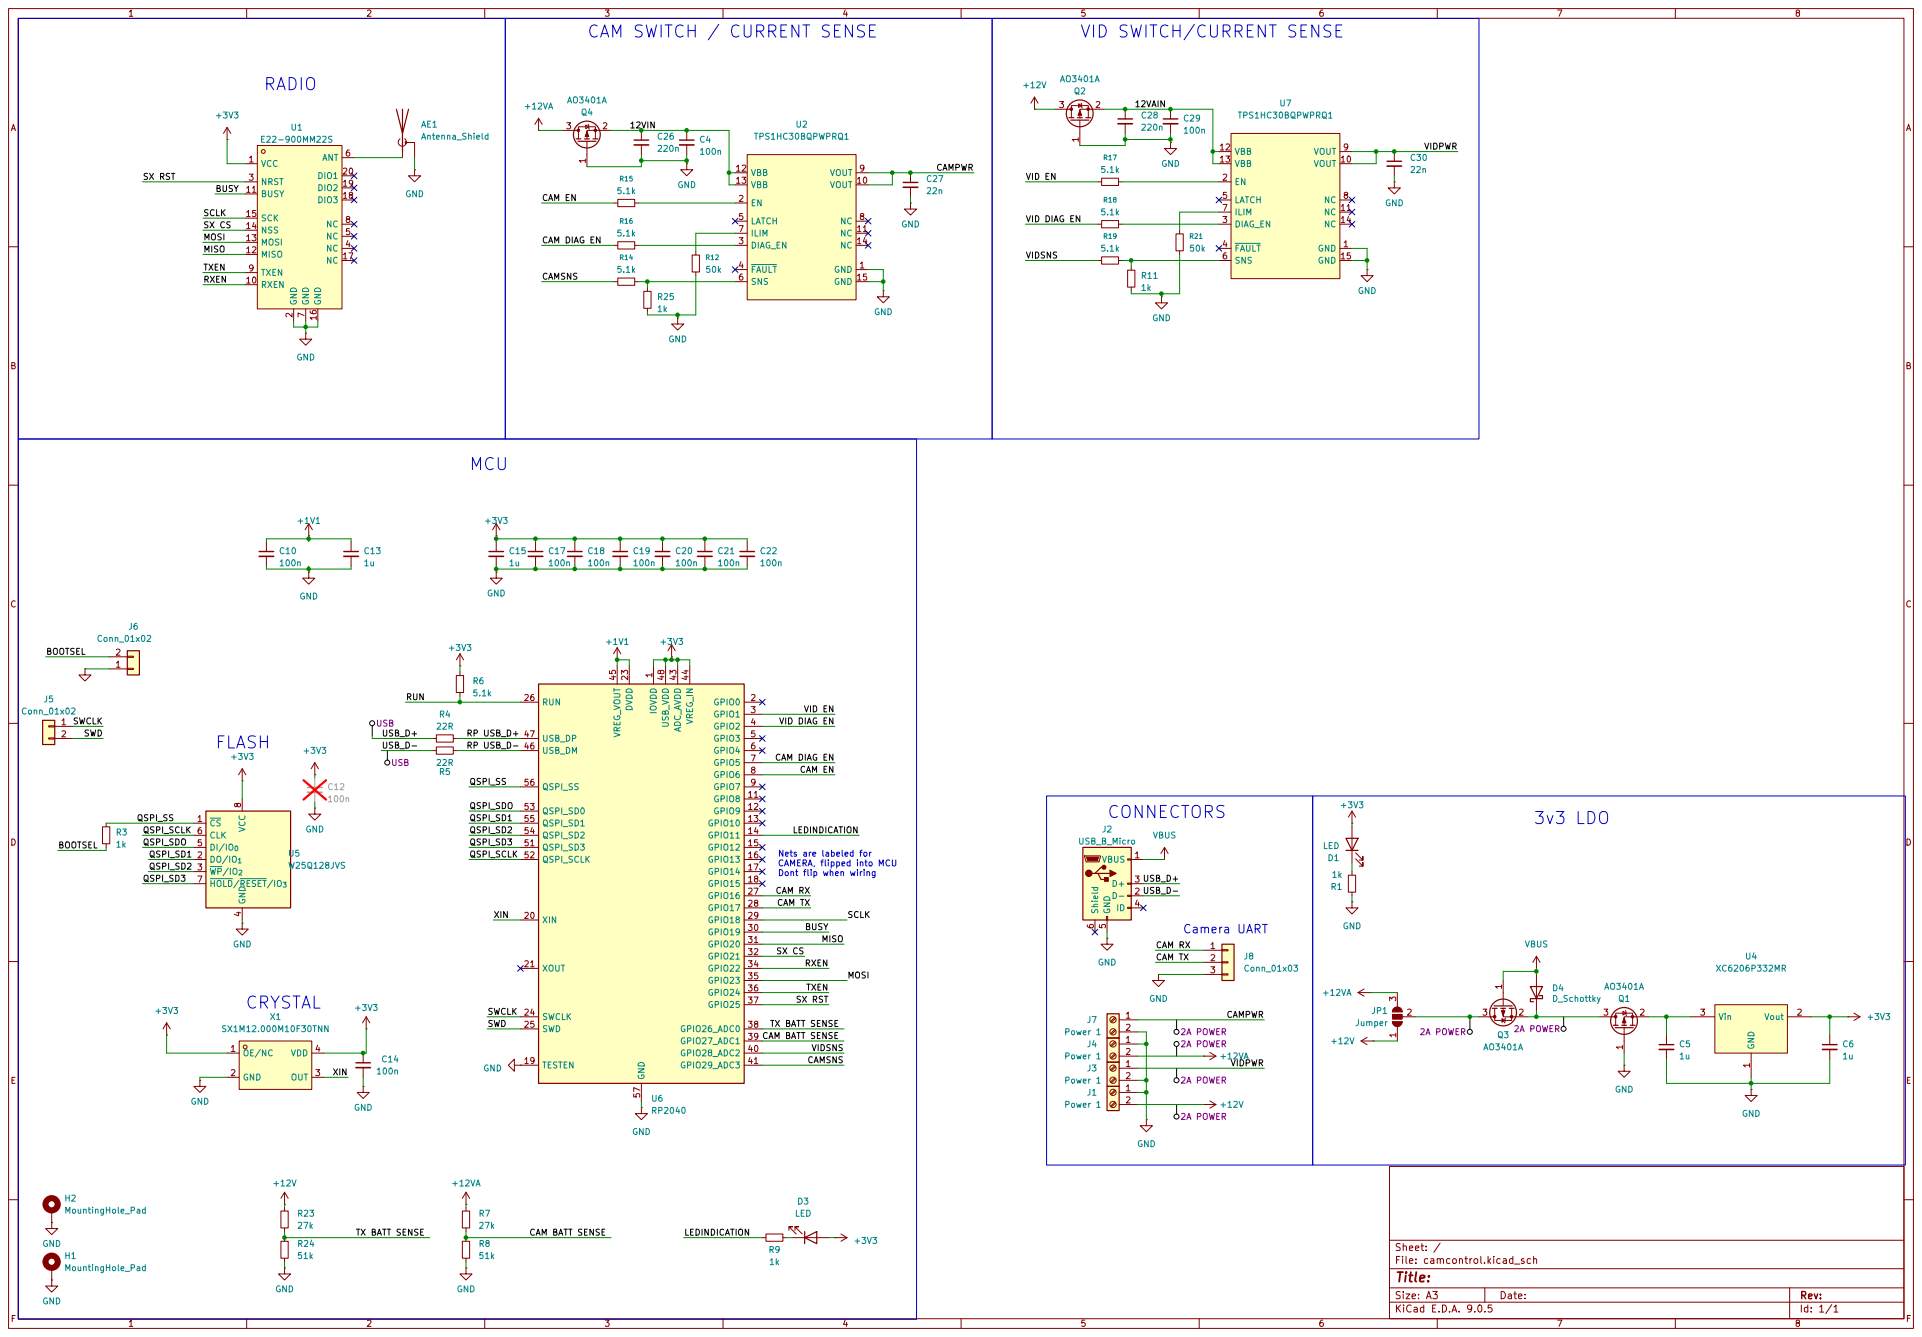
[picture p22: page 1]
