prs2026/Lyra-flight-computer/Hardware/kicad/Lyra_flight_computer/lyrav3revised/lyrav3r1/schematic fixedled.pdf

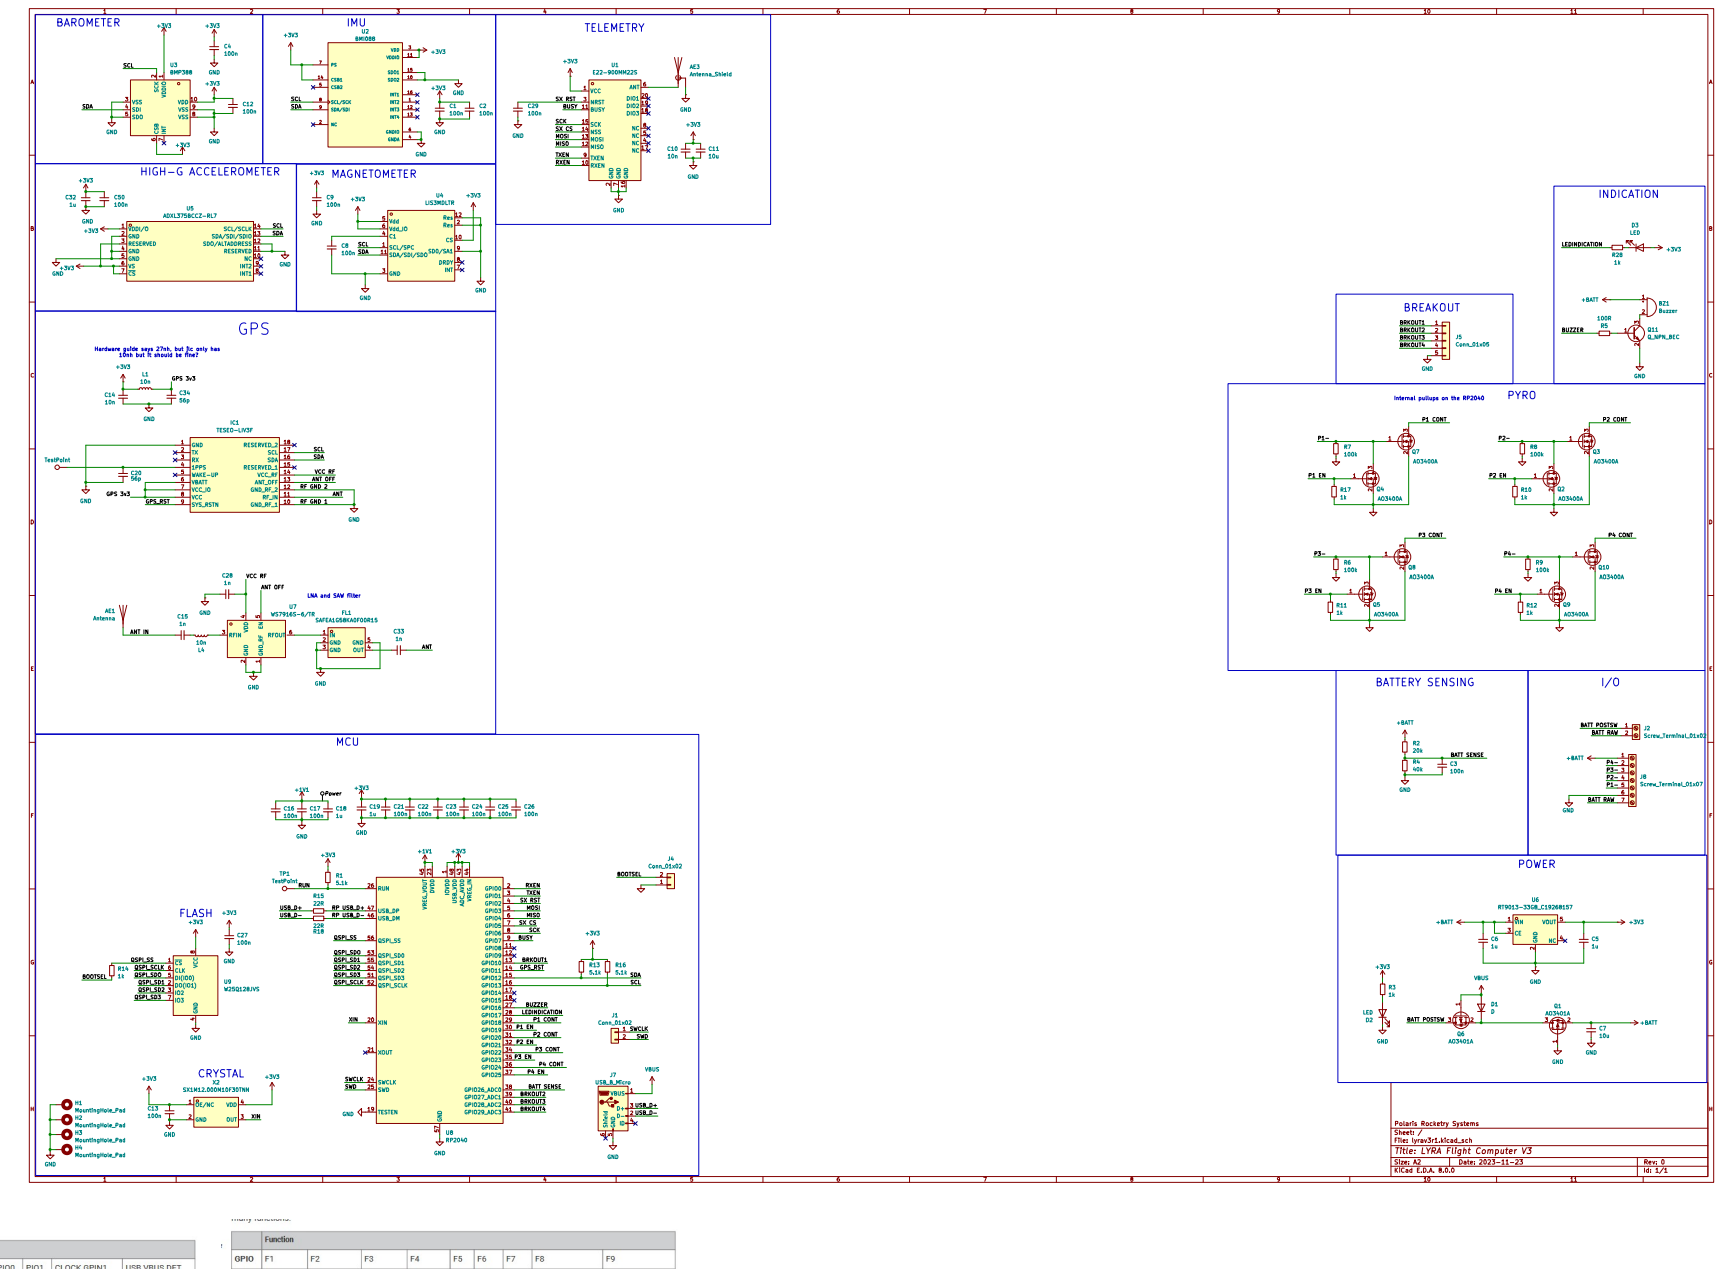
[picture p27: page 1]
