prs2026/Lyra-flight-computer/Hardware/kicad/Lyra_flight_computer/lyrav3revised/lyrav3r1/schematicfixe2d.pdf

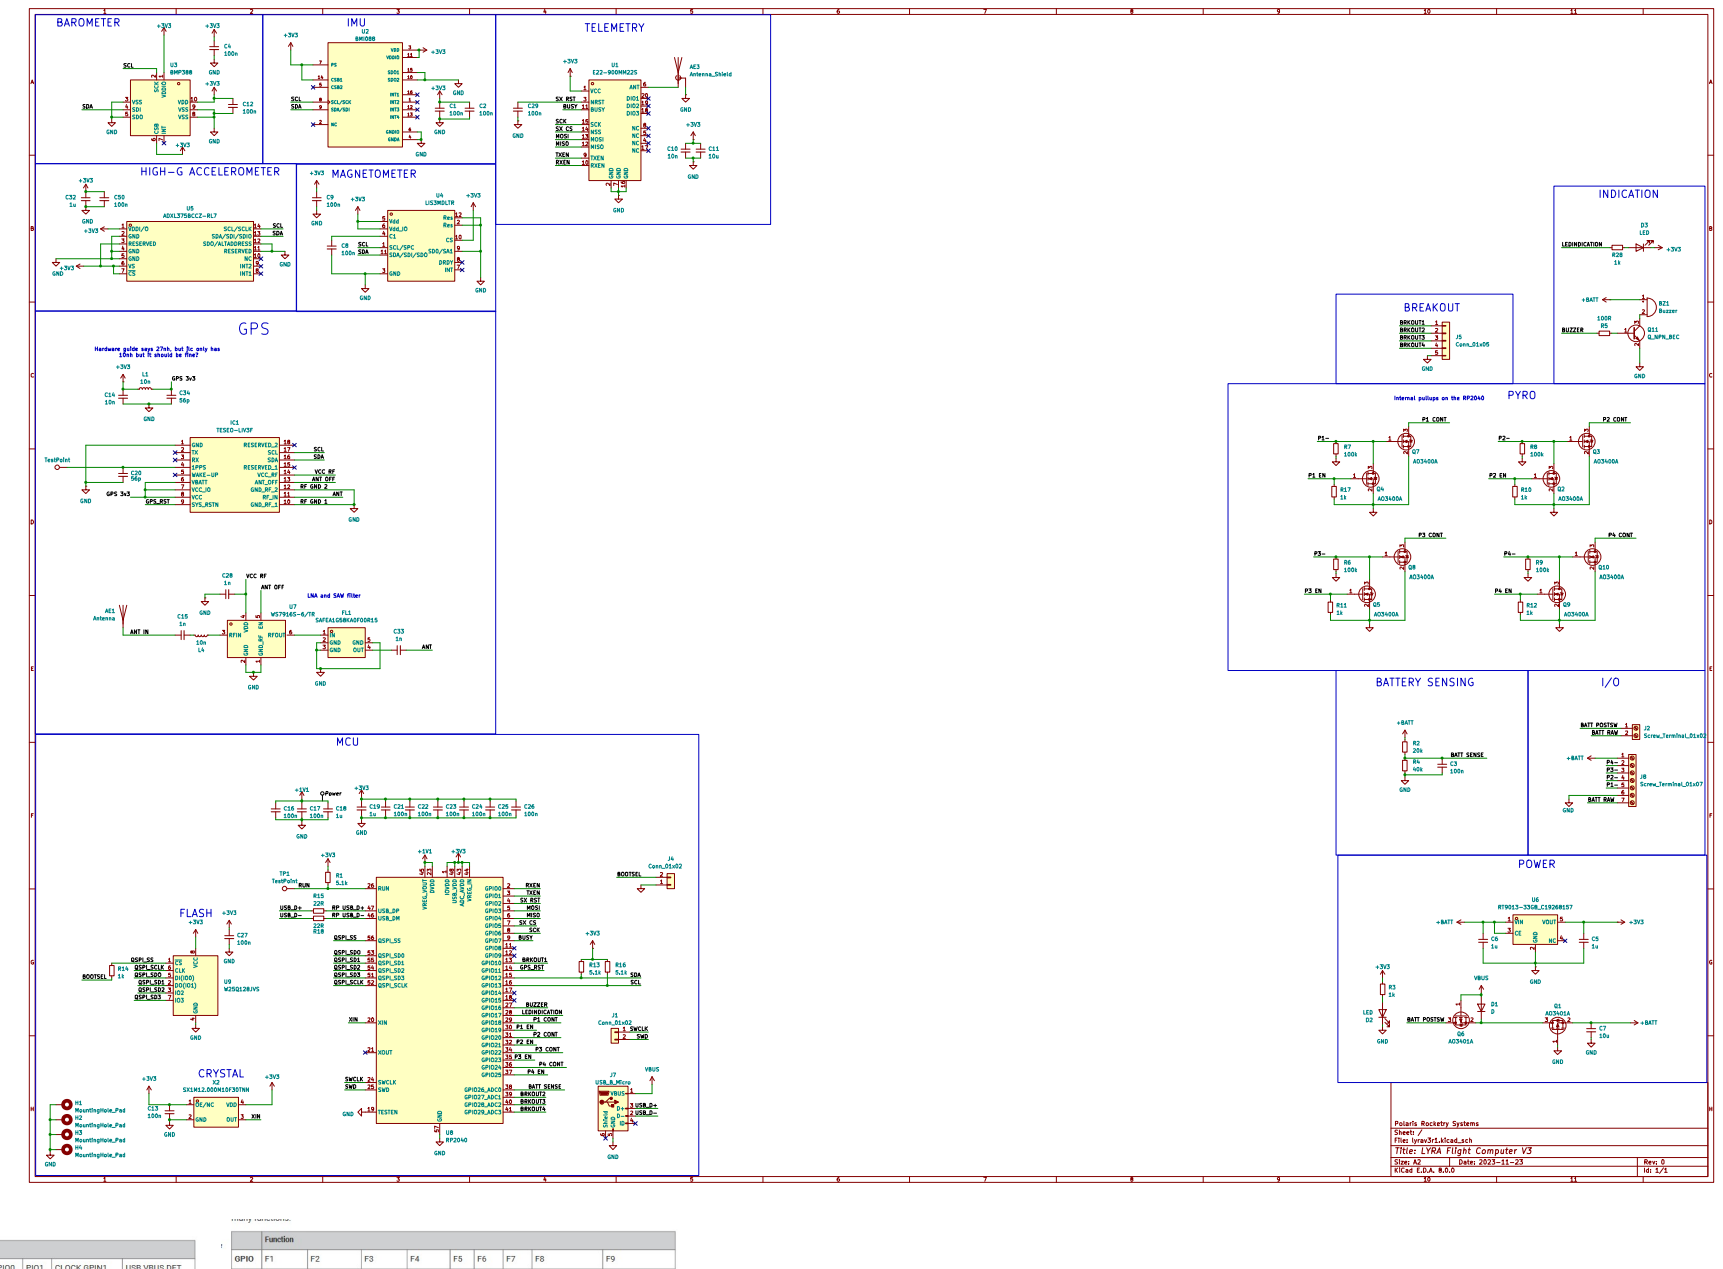
[picture p28: page 1]
