prs2026/Lyra-flight-computer/Hardware/kicad/Lyra_flight_computer/lyrav3revised/lyrav3r1/schematicfixed.pdf

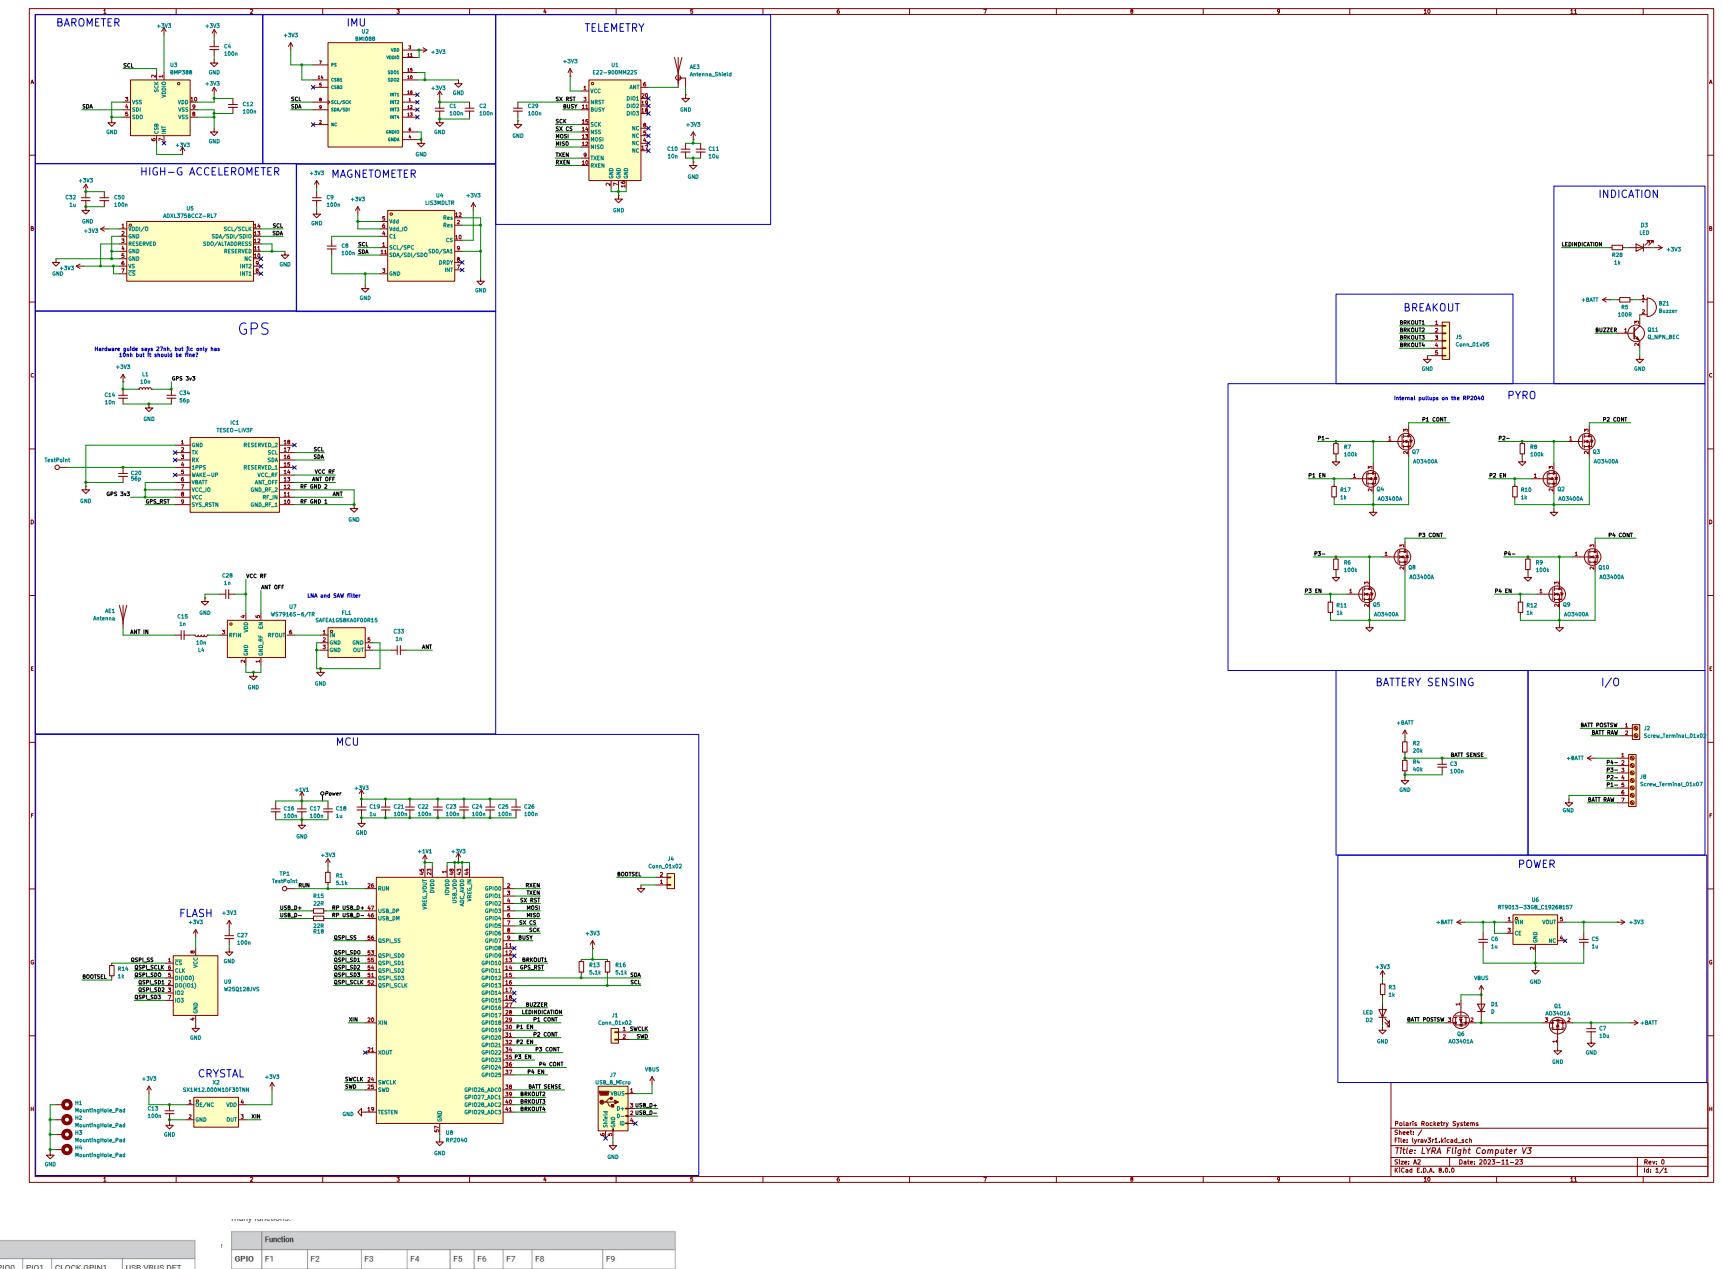
[picture p29: page 1]
