prs2026/Lyra-flight-computer/Hardware/kicad/Lyra_flight_computer/lyrav3revised/recivier/schematicr1.pdf

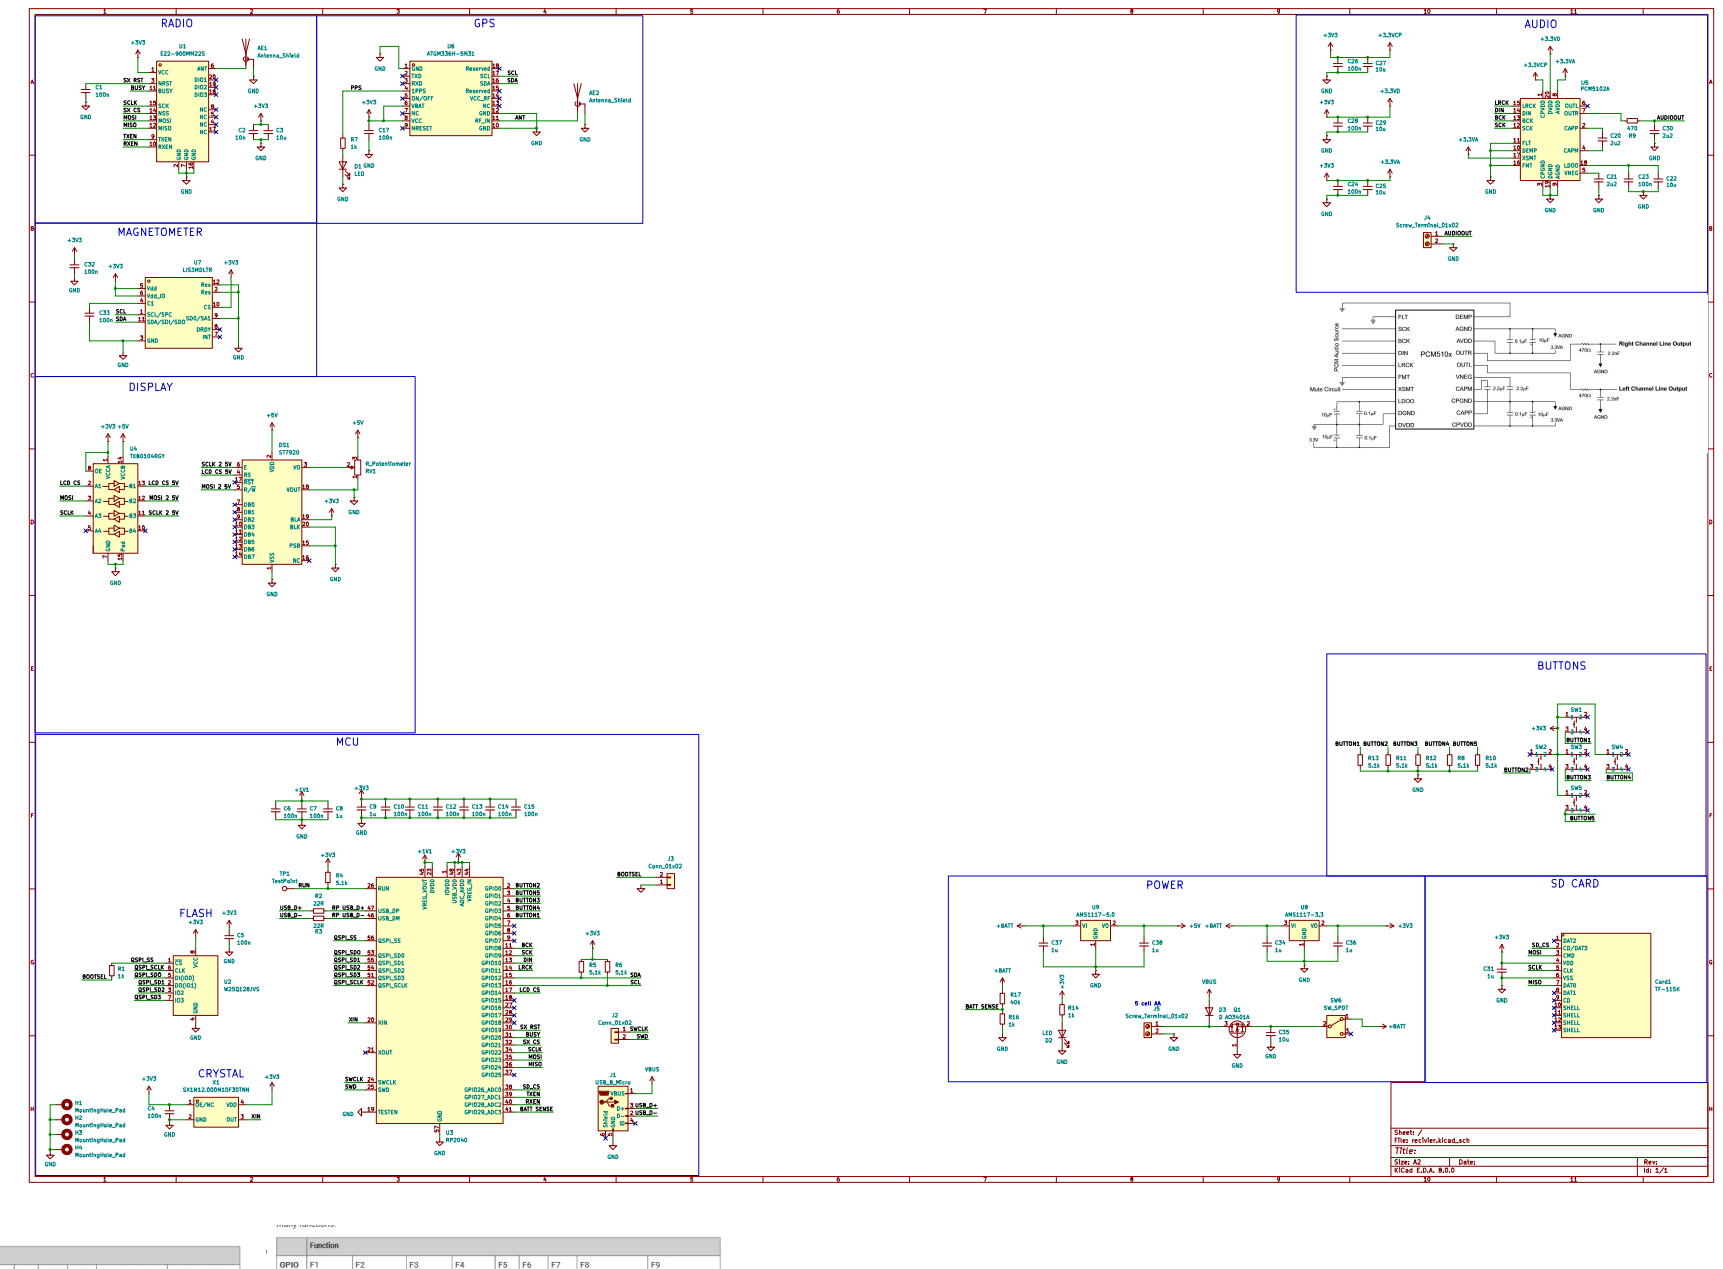
[picture p34: page 1]
