prs2026/Lyra-flight-computer/Hardware/kicad/Lyra_flight_computer/lyrav3revised/lyrav3r1/schematic pdf.pdf

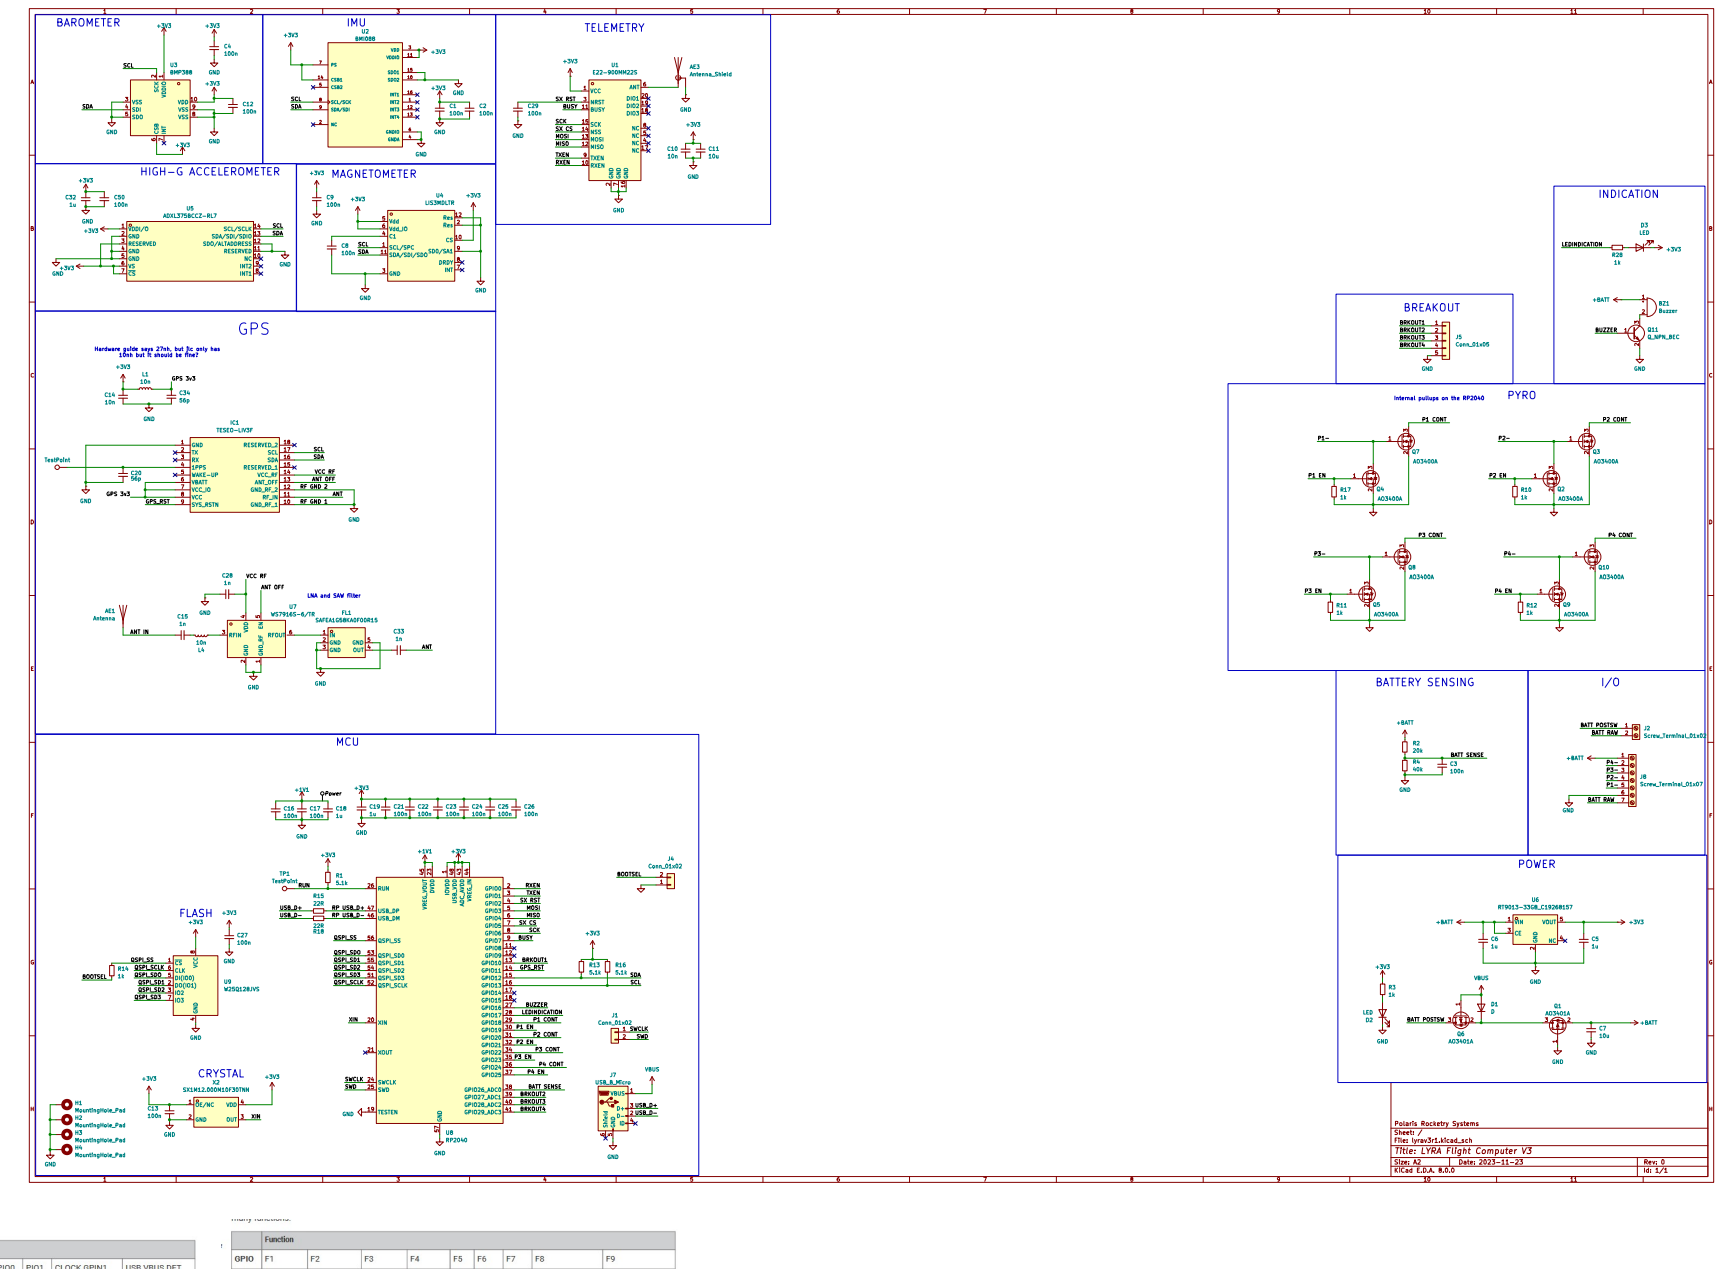
[picture p39: page 1]
