prs2026/Lyra-flight-computer/Hardware/kicad/Lyra_flight_computer/lyrav3revised/lyrav3r1/lyrav3r1-B_Cu.pdf

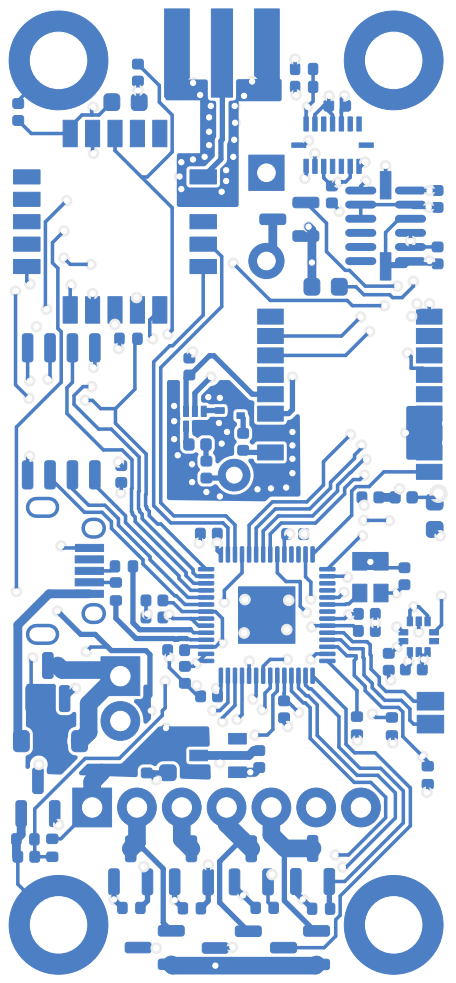
[picture p44: page 1]
