prs2026/Lyra-flight-computer/Hardware/kicad/Lyra_flight_computer/lyrav3revised/lyrav3r1/lyrav3r1-In1_Cu.pdf

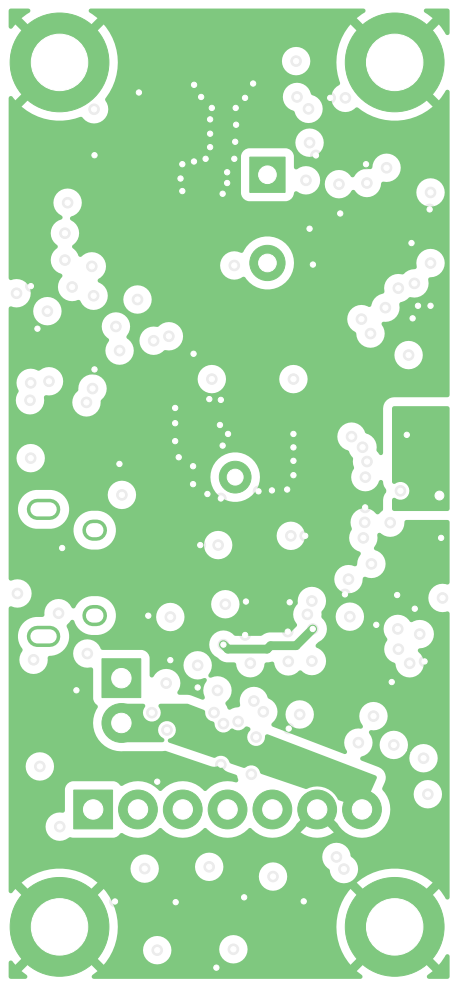
[picture p46: page 1]
