prs2026/Lyra-flight-computer/Hardware/kicad/Lyra_flight_computer/lyrav3revised/lyrav3r1/lyrav3r1-In2_Cu.pdf

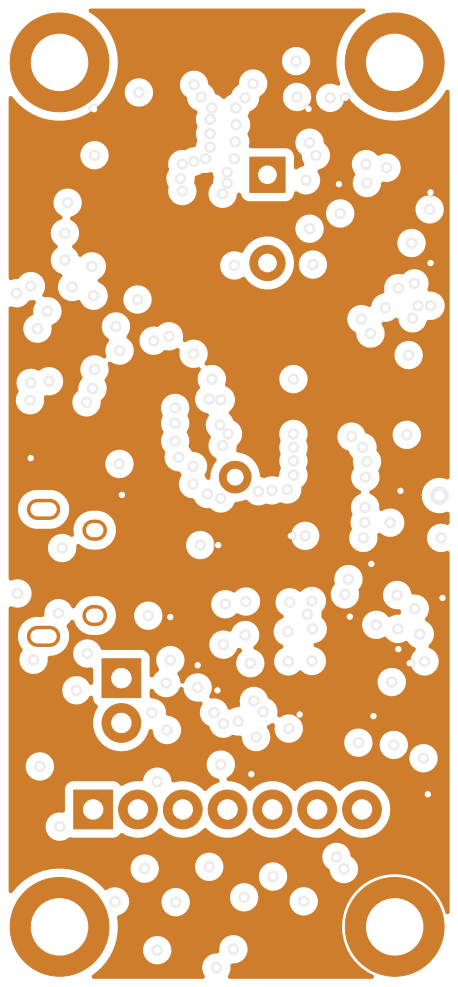
[picture p47: page 1]
