prs2026/Lyra-flight-computer/(list of files, drawings)

Other design files:
avionics/kicad/Lyra_flight_computer/lyra V3/freerouting.dsn
