prs2026/Lyra-flight-computer/CamControl/camcontrol stm32/camcontrol stm32.kicad_pcb

## KiCad design CamControl/camcontrol stm32/camcontrol stm32.kicad_pcb (2026-04-21)

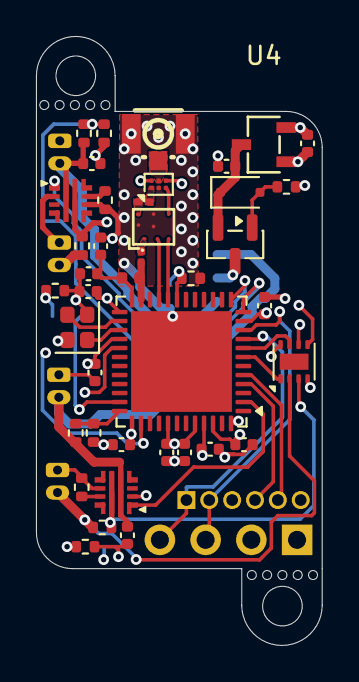
[picture p48: board camcontrol stm32.kicad_pcb from above]

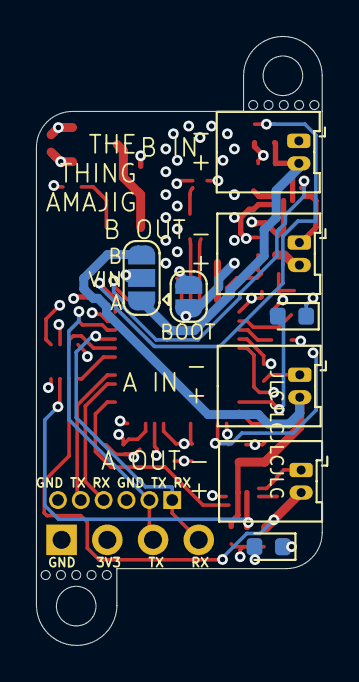
[picture p49: board camcontrol stm32.kicad_pcb from below]

Board: 4 copper layers, 15.9 x 33.8 mm, 52 parts (12 on the bottom side), 40 nets.

Parts:
AE1: Antenna_Shield; ANT-SMD_1909763-1
C1, C5, C6, C12: 1u; C_0402_1005Metric
C2: 68p; C_0201_0603Metric
C3: 100p; C_0201_0603Metric
C4, C7: 47n; C_0402_1005Metric
C8, C9, C10, C11, C13, C14, C22: 100n; C_0402_1005Metric
C18: 470n; C_0402_1005Metric
D1, D2: LED; LED_0603_1608Metric
D3: D_Zener; D_SOD-323F
H1, H2: MountingHole; MountingHole_2.2mm_M2_DIN965
J1, J3, J4, J7: Power 1; Molex_PicoBlade_53048-0210_1x02_P1.25mm_Horizontal
J2: Conn_01x04; PinHeader_1x04_P2.54mm_Vertical
J5: Conn_01x06; PinHeader_1x06_P1.27mm_Vertical
J6: Conn_01x02; SolderJumper-2_P1.3mm_Open_RoundedPad1.0x1.5mm
JP1: Jumper; SolderJumper-3_P1.3mm_Open_RoundedPad1.0x1.5mm
L1: 47n; L_0402_1005Metric
Q1: AO3401A; SOT-23
R1, R7: 1k; R_0402_1005Metric
R2, R6: 510; R_0402_1005Metric
R3, R5: 10m; R_0402_1005Metric
R4: 33k; R_0402_1005Metric
R8, R23: 15k; R_0402_1005Metric
R9, R10, R24: 51k; R_0402_1005Metric
U1: BGS12P2L6; Infineon_PG-TSNP-6-10_0.7x1.1mm_0.7x1.1mm_P0.4mm
U2: BALFHB-WL-02D3; CSPG-8_L2.1-W1.8_BALFHB-WL-03D3
U3: STM32WLE4CCUx; QFN-48-1EP_7x7mm_P0.5mm_EP5.6x5.6mm
U4: DS8242; SOT-23-3_L2.9-W1.6-P1.90-LS2.8-BR
U5, U6: TPS25970LRPWR; QFN-10-2x2-hotrod
U7: INA2180; WSON-8-1EP_2x2mm_P0.5mm_EP0.9x1.6mm
Y1: 32MHz; Crystal_SMD_2016-4Pin_2.0x1.6mm

Connections:
+3V3: C6.1, C8.1, C9.1, C10.1, C11.1, C13.1, C14.1, C22.1, D1.2 (A), J2.2, U1.4 (VDD), U3.11 (VDD), U3.25 (VDDPA), U3.28 (VDDRF), U3.37 (VBAT), U3.41 (VDDA), U3.44 (VDD), U3.46 (VDDSMPS), U4.2 (Vout), U7.8 (VS)
+12V: C12.1, J1.2, JP1.1 (A), R23.1, U6.5 (IN)
+12VA: C1.1, J4.2, JP1.3 (B), R8.1, U5.5 (IN)
/BATT SENSE A: R8.2, R9.1, U3.36 (PA13)
/BATT SENSE B: R23.2, R24.1, U3.12 (PA4)
/BOOTSEL: J6.2, R4.2, U3.19 (PH3)
/CAM1 RX: J2.4, J5.1, U3.9 (PA2)
/CAM1 TX: J2.3, J5.2, U3.10 (PA3)
/CAM2 RX: J5.4, U3.4 (PB6)
/CAM2 TX: J5.5, U3.5 (PB7)
/CURRENT SENSE A: U3.7 (PA0), U7.1 (OUT1)
/CURRENT SENSE B: U3.8 (PA1), U7.7 (OUT2)
/LED INDICATION: D2.2 (A), U3.35 (PA12)
/OSC_IN: U3.26 (OSC_IN), Y1.3
/OSC_OUT: U3.27 (OSC_OUT), Y1.1
/PRWA EN: U3.2 (PB4), U5.1 (EN/UVLO)
/PWR A: J7.2, R5.2, U7.2 (IN-1)
/PWR A SENS: R5.1, U5.6 (OUT), U7.3 (IN+1)
/PWR B: J3.2, R3.2, U7.6 (IN-2)
/PWR B SENS: R3.1, U6.6 (OUT), U7.5 (IN+2)
/PWRB EN: U3.13 (PA5), U6.1 (EN/UVLO)
/RF CTRL: U1.6 (CTRL), U3.38 (PC13)
/VFBSMPS: C18.1, U3.29 (VDDRF1V55), U3.45 (VFBSMPS)
/VR_PA: C4.2, C7.2, L1.1, U3.24 (VR_PA)
GND: AE1.2 (Shield), C1.2, C4.1, C5.2, C6.2, C7.1, C8.2, C9.2, C10.2, C11.2, C12.2, C13.2, C14.2, C18.2, C22.2, J1.1, J2.1, J3.1, J4.1, J5.3, J5.6, J6.1, J7.1, R1.2, R2.2, R4.1, R6.2, R7.2, R9.2, R10.2, R24.2, U1.2 (GND), U2.B1 (GND2), U2.B2 (GND3), U2.C2 (GND1), U3.48 (VSSSMPS), U3.49 (VSS), U4.1 (GND), U5.2 (OLVO), U5.8 (GND), U6.2 (OLVO), U6.8 (GND), U7.4 (GND), Y1.2, Y1.4
unnamed: AE1.1 (A), U1.5 (RFIN)
unnamed: D1.1 (K), R1.1
unnamed: D2.1 (K), R7.1
unnamed: D3.2 (A), Q1.1 (G), R10.1
unnamed: C5.1, D3.1 (K), Q1.2 (S), U4.3 (Vin)
unnamed: JP1.2 (C), Q1.3 (D)
unnamed: U1.3 (RF1), U2.C3 (RFI_in)
unnamed: C2.1, U1.1 (RF2)
unnamed: U2.A2 (RFI_N_out), U3.21 (RFI_N)
unnamed: U2.A3 (RFI_P_out), U3.20 (RFI_P)
unnamed: C3.1, U2.A1 (RFO_in)
unnamed: C2.2, U2.C1 (RFO_out)
unnamed: C3.2, L1.2, U3.23 (RFO_HP)
unnamed: R6.1, U5.9 (ILM)
unnamed: R2.1, U6.9 (ILM)
