prs2026/Lyra-flight-computer/Hardware/kicad/Leo/LEO.kicad_pcb

## KiCad design Hardware/kicad/Leo/LEO.kicad_pcb (2025-12-25)

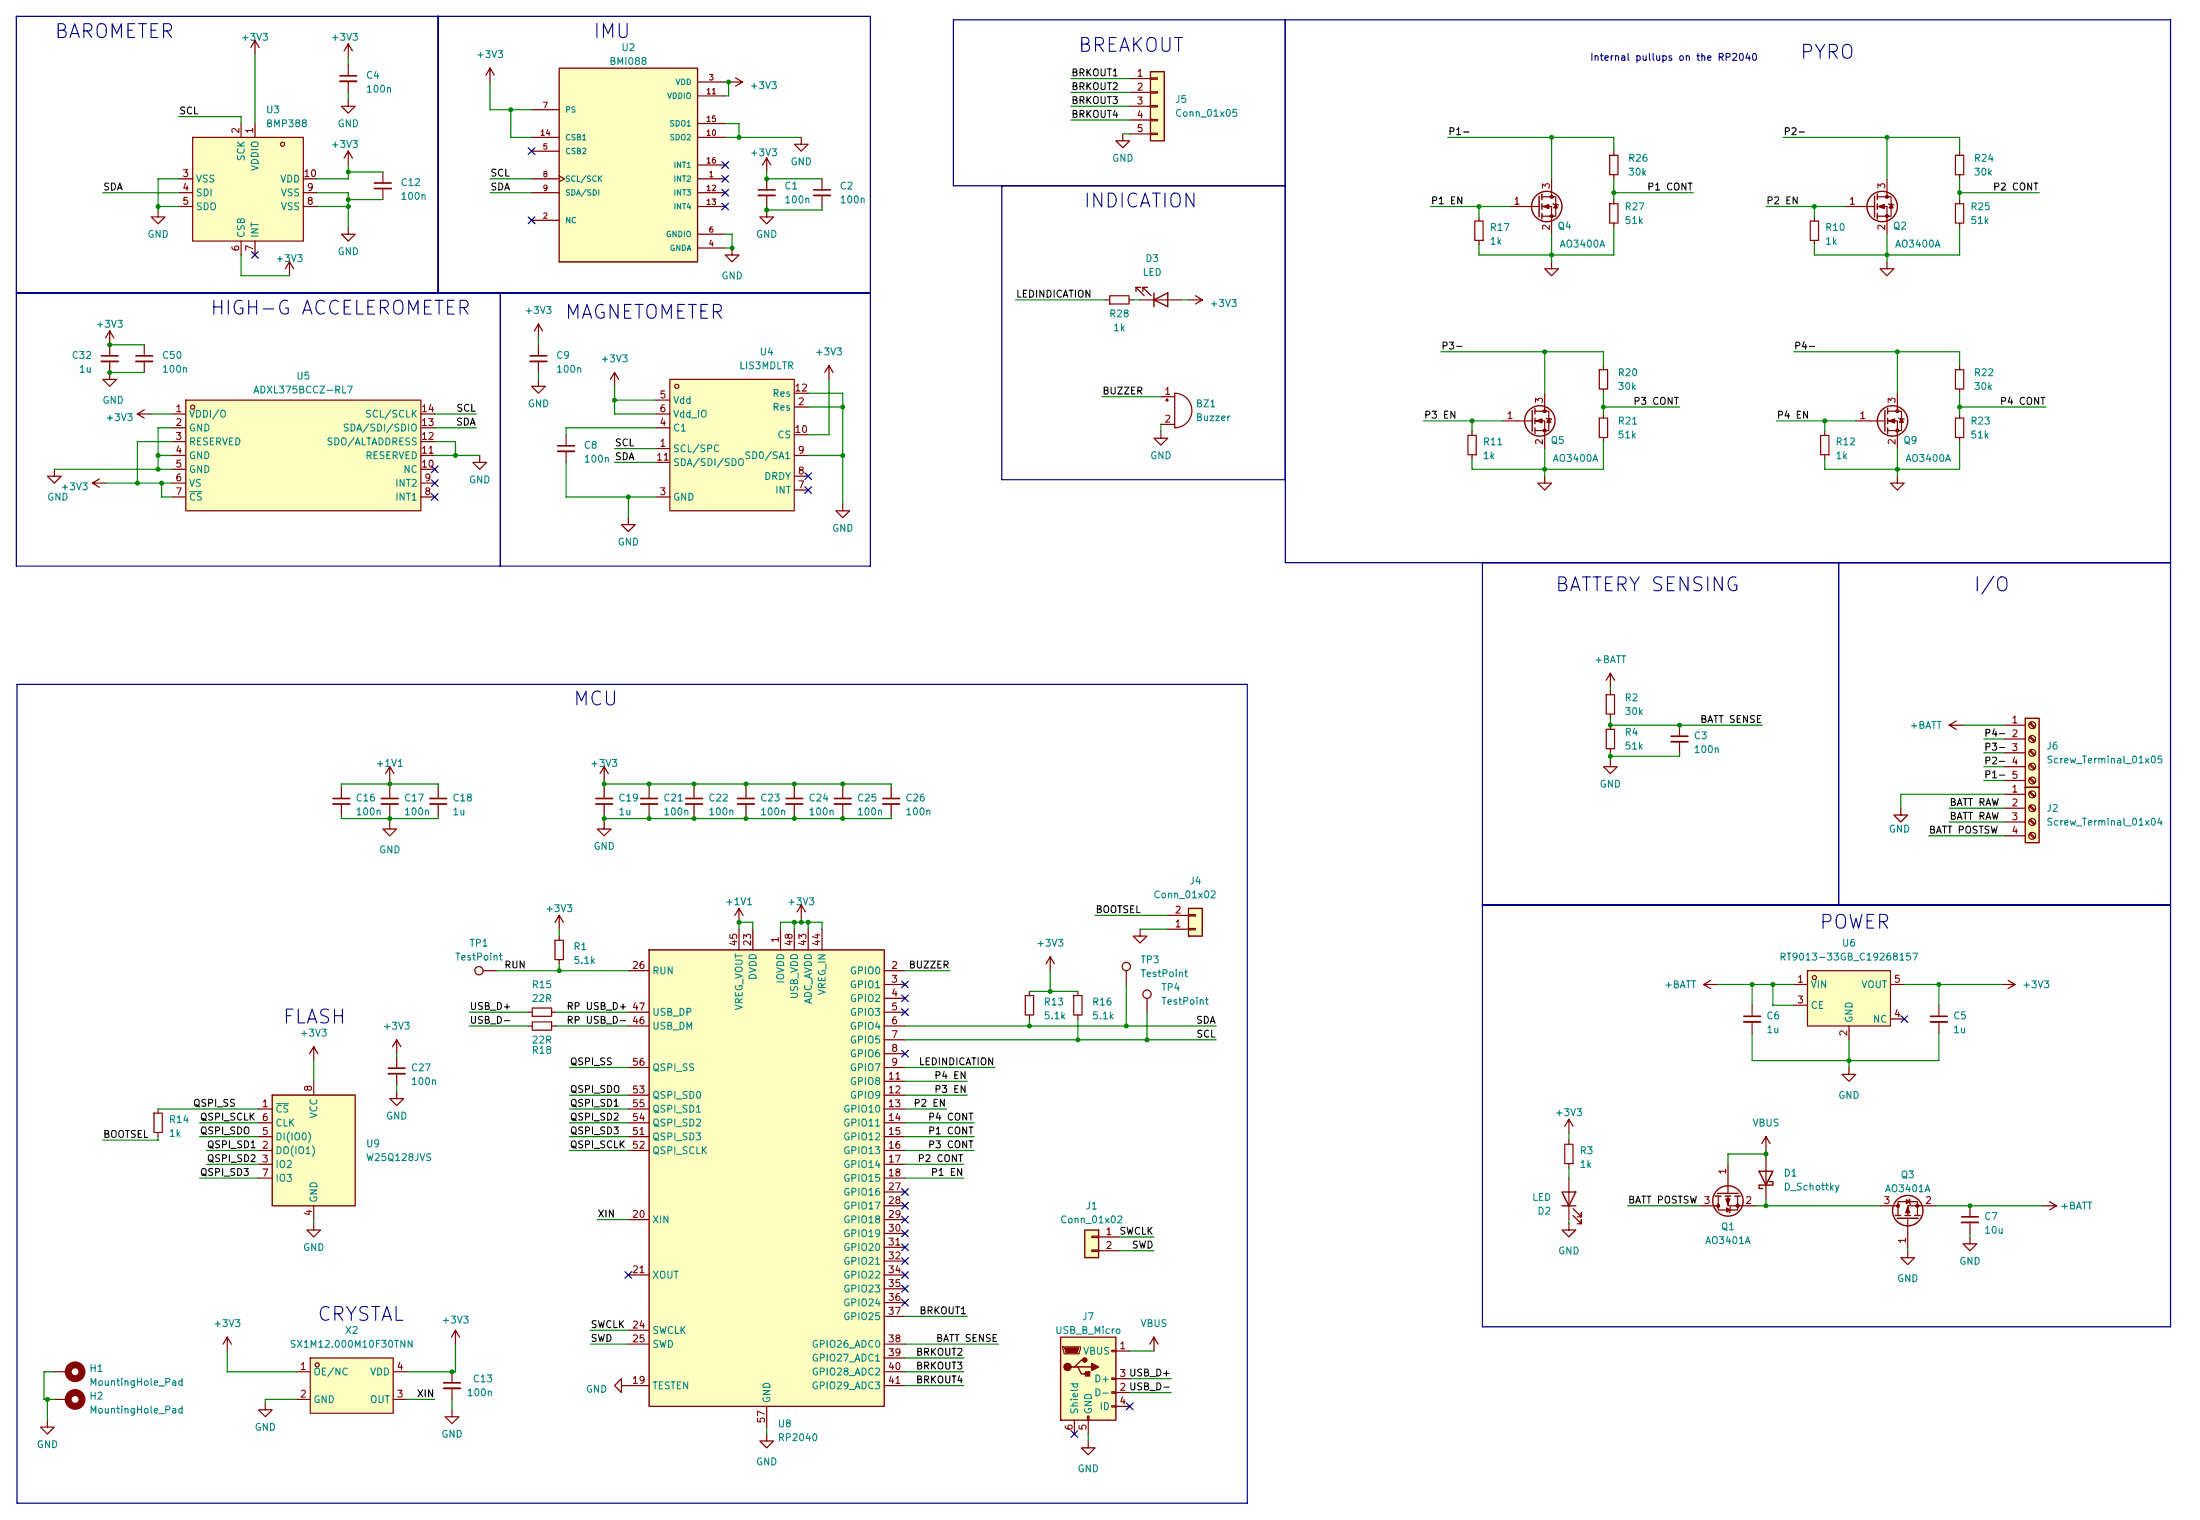
[picture p50: schematic LEO.kicad_sch, LYRA Flight Computer V3]

Parts:
BZ1: Buzzer; PKMCS0909E4000R1; Part # CPE-163
C1, C2, C3, C4, C8, C9, C12, C13, C16, C17, C21, C22, C23, C24, C25, C26, C27, C50: 100n; C_0402_1005Metric; LCSC Part C1525
C5, C6, C18, C19, C32: 1u; C_0402_1005Metric; LCSC Part C52923
C7: 10u; C_0603_1608Metric; LCSC Part C96446
D1: D_Schottky; D_SOD-323F; LCSC Part C191023
D2, D3: LED; LED_0805_2012Metric
H1, H2: MountingHole_Pad; MountingHole_2.2mm_M2_DIN965_Pad
J1: Conn_01x02; SolderJumper-2_P1.3mm_Open_Pad1.0x1.5mm
J2: Screw_Terminal_01x04; TerminalBlock_Phoenix_MPT-0,5-4-2.54_1x04_P2.54mm_Horizontal
J4: Conn_01x02; SolderJumper-2_P1.3mm_Open_RoundedPad1.0x1.5mm
J5: Conn_01x05; Pad_01x_05
J6: Screw_Terminal_01x05; TerminalBlock_Phoenix_MPT-0,5-5-2.54_1x05_P2.54mm_Horizontal
J7: USB_B_Micro; MICRO-USB-SMD_U254-051T-4BHJ25-F2S; LCSC Part C381143
Q1, Q3: AO3401A; SOT-23; LCSC Part C15127
Q2, Q4, Q5, Q9: AO3400A; SOT-23; LCSC Part C20917
R1, R13, R16: 5.1k; R_0402_1005Metric; LCSC Part C25905
R2, R20, R22, R24, R26: 30k; R_0402_1005Metric; LCSC Part C25105
R3, R10, R11, R12, R14, R17, R28: 1k; R_0402_1005Metric; LCSC Part C11702
R4, R21, R23, R25, R27: 51k; R_0402_1005Metric
R15, R18: 22R; R_0402_1005Metric; LCSC Part C25092
TP1, TP3, TP4: TestPoint; TestPoint_Pad_1.0x1.0mm
U2: BMI088; LGA-16_L4.5-W3.0-P0.50-BL; LCSC Part C194919
U3: BMP388; SENSORM-SMD_BMP388; LCSC Part C779278
U4: LIS3MDLTR; LGA-12_L2.0-W2.0-P0.50-BL; LCSC Part C478483
U5: ADXL375BCCZ-RL7; LGA-14_L5.0-W3.0-P0.80-BL; LCSC Part C481898
U6: RT9013-33GB_C19268157; SOT-23-5_L2.9-W1.6-P0.95-LS2.8-BR; LCSC Part C19268157
U8: RP2040; QFN-56-1EP_7x7mm_P0.4mm_EP3.2x3.2mm; LCSC Part C2040
U9: W25Q128JVS; SOIC-8_5.23x5.23mm_P1.27mm; LCSC Part C97521
X2: SX1M12.000M10F30TNN; OSC-SMD_4P-L2.0-W1.6-BL; LCSC Part C2901608

Connections:
+1V1: C16.1, C17.1, C18.1, U8.23 (DVDD), U8.45 (VREG_VOUT), U8.50 (DVDD)
+3V3: C1.1, C2.1, C4.1, C5.1, C9.1, C12.1, C13.1, C19.1, C21.1, C22.1, C23.1, C24.1, C25.1, C26.1, C27.1, C32.1, C50.1, D3.2 (A), R1.1, R3.2, R13.1, R16.1, U2.3 (VDD), U2.7 (PS), U2.11 (VDDIO), U2.14 (CSB1), U3.1 (VDDIO), U3.6 (CSB), U3.10 (VDD), U4.5 (Vdd), U4.6 (Vdd_IO), U4.10 (CS), U5.1 (VDDI/O), U5.3 (RESERVED), U5.6 (VS), U5.7 (~CS), U6.5 (VOUT), U8.1 (IOVDD), U8.10 (IOVDD), U8.22 (IOVDD), U8.33 (IOVDD), U8.42 (IOVDD), U8.43 (ADC_AVDD), U8.44 (VREG_IN), U8.48 (USB_VDD), U8.49 (IOVDD), U9.8 (VCC), X2.1 (OE/NC), X2.4 (VDD)
+BATT: C6.1, C7.1, J6.1, Q3.2 (S), R2.1, U6.1 (VIN), U6.3 (CE)
/BATT POSTSW: J2.4, Q1.3 (D)
/BATT RAW: J2.2, J2.3
/BATT SENSE: C3.1, R2.2, R4.1, U8.38 (GPIO26_ADC0)
/BOOTSEL: J4.2, R14.2
/BRKOUT1: J5.1, U8.37 (GPIO25)
/BRKOUT2: J5.2, U8.39 (GPIO27_ADC1)
/BRKOUT3: J5.3, U8.40 (GPIO28_ADC2)
/BRKOUT4: J5.4, U8.41 (GPIO29_ADC3)
/BUZZER: BZ1.1 (+), U8.2 (GPIO0)
/LEDINDICATION: R28.1, U8.9 (GPIO7)
/P1 CONT: R26.2, R27.1, U8.15 (GPIO12)
/P1 EN: Q4.1 (G), R17.2, U8.18 (GPIO15)
/P1-: J6.5, Q4.3 (D), R26.1
/P2 CONT: R24.2, R25.1, U8.17 (GPIO14)
/P2 EN: Q2.1 (G), R10.2, U8.13 (GPIO10)
/P2-: J6.4, Q2.3 (D), R24.1
/P3 CONT: R20.2, R21.1, U8.16 (GPIO13)
/P3 EN: Q5.1 (G), R11.2, U8.12 (GPIO9)
/P3-: J6.3, Q5.3 (D), R20.1
/P4 CONT: R22.2, R23.1, U8.14 (GPIO11)
/P4 EN: Q9.1 (G), R12.2, U8.11 (GPIO8)
/P4-: J6.2, Q9.3 (D), R22.1
/QSPI_SCLK: U8.52 (QSPI_SCLK), U9.6 (CLK)
/QSPI_SD1: U8.55 (QSPI_SD1), U9.2 (DO(IO1))
/QSPI_SD2: U8.54 (QSPI_SD2), U9.3 (IO2)
/QSPI_SD3: U8.51 (QSPI_SD3), U9.7 (IO3)
/QSPI_SDO: U8.53 (QSPI_SD0), U9.5 (DI(IO0))
/QSPI_SS: R14.1, U8.56 (QSPI_SS), U9.1 (~CS)
/RP USB_D+: R15.2, U8.47 (USB_DP)
/RP USB_D-: R18.1, U8.46 (USB_DM)
/RUN: R1.2, TP1.1, U8.26 (RUN)
/SCL: R16.2, TP4.1, U2.8 (SCL/SCK), U3.2 (SCK), U4.1 (SCL/SPC), U5.14 (SCL/SCLK), U8.7 (GPIO5)
/SDA: R13.2, TP3.1, U2.9 (SDA/SDI), U3.4 (SDI), U4.11 (SDA/SDI/SDO), U5.13 (SDA/SDI/SDIO), U8.6 (GPIO4)
/SWCLK: J1.1, U8.24 (SWCLK)
/SWD: J1.2, U8.25 (SWD)
/USB_D+: J7.3 (D+), R15.1
/USB_D-: J7.2 (D-), R18.2
/XIN: U8.20 (XIN), X2.3 (OUT)
GND: BZ1.2 (-), C1.2, C2.2, C3.2, C4.2, C5.2, C6.2, C7.2, C8.2, C9.2, C12.2, C13.2, C16.2, C17.2, C18.2, C19.2, C21.2, C22.2, C23.2, C24.2, C25.2, C26.2, C27.2, C32.2, C50.2, D2.1 (K), H1.1, H2.1, J2.1, J4.1, J5.5, J7.5 (GND), Q2.2 (S), Q3.1 (G), Q4.2 (S), Q5.2 (S), Q9.2 (S), R4.2, R10.1, R11.1, R12.1, R17.1, R21.2, R23.2, R25.2, R27.2, U2.4 (GNDA), U2.6 (GNDIO), U2.10 (SDO2), U2.15 (SDO1), U3.3 (VSS), U3.5 (SDO), U3.8 (VSS), U3.9 (VSS), U4.2 (Res), U4.3 (GND), U4.9 (SD0/SA1), U4.12 (Res), U5.2 (GND), U5.4 (GND), U5.5 (GND), U5.11 (RESERVED), U5.12 (SDO/ALTADDRESS), U6.2 (GND), U8.19 (TESTEN), U8.57 (GND), U9.4 (GND), X2.2 (GND)
unnamed: D1.1 (K), Q1.2 (S), Q3.3 (D)
unnamed: D2.2 (A), R3.1
unnamed: D3.1 (K), R28.2
unnamed: C8.1, U4.4 (C1)
VBUS: D1.2 (A), J7.1 (VBUS), Q1.1 (G)

Notes on the sheet:
HIGH-G ACCELEROMETER
I/O
CRYSTAL
FLASH
IMU
POWER
MAGNETOMETER
BATTERY SENSING
Internal pullups on the RP2040
INDICATION
MCU
PYRO
BAROMETER
BREAKOUT

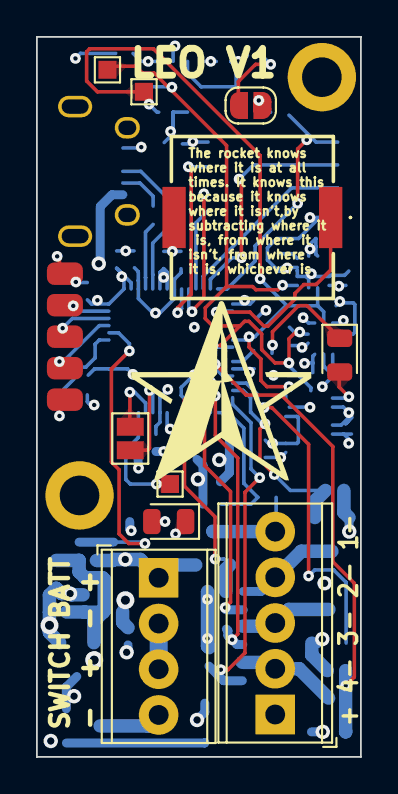
[picture p51: board LEO.kicad_pcb from above]

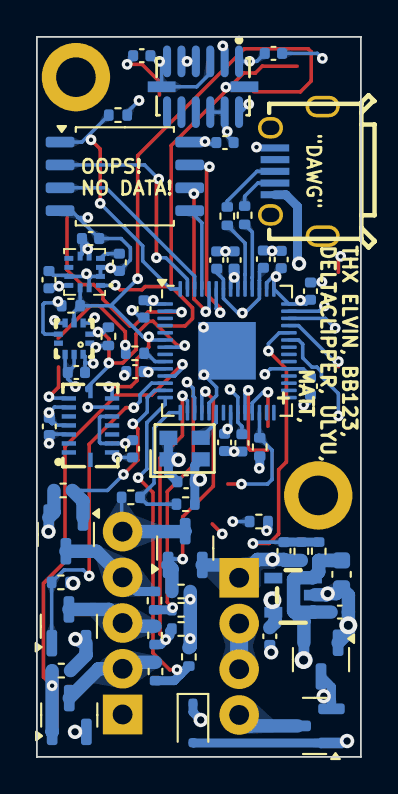
[picture p52: board LEO.kicad_pcb from below]

Board: 4 copper layers, 18.0 x 40.0 mm, 75 parts (62 on the bottom side), 47 nets.
