prs2026/Lyra-flight-computer/Metrumizer/metrumizer/metrumizer.kicad_pcb

## KiCad design Metrumizer/metrumizer/metrumizer.kicad_pcb (2025-12-25)

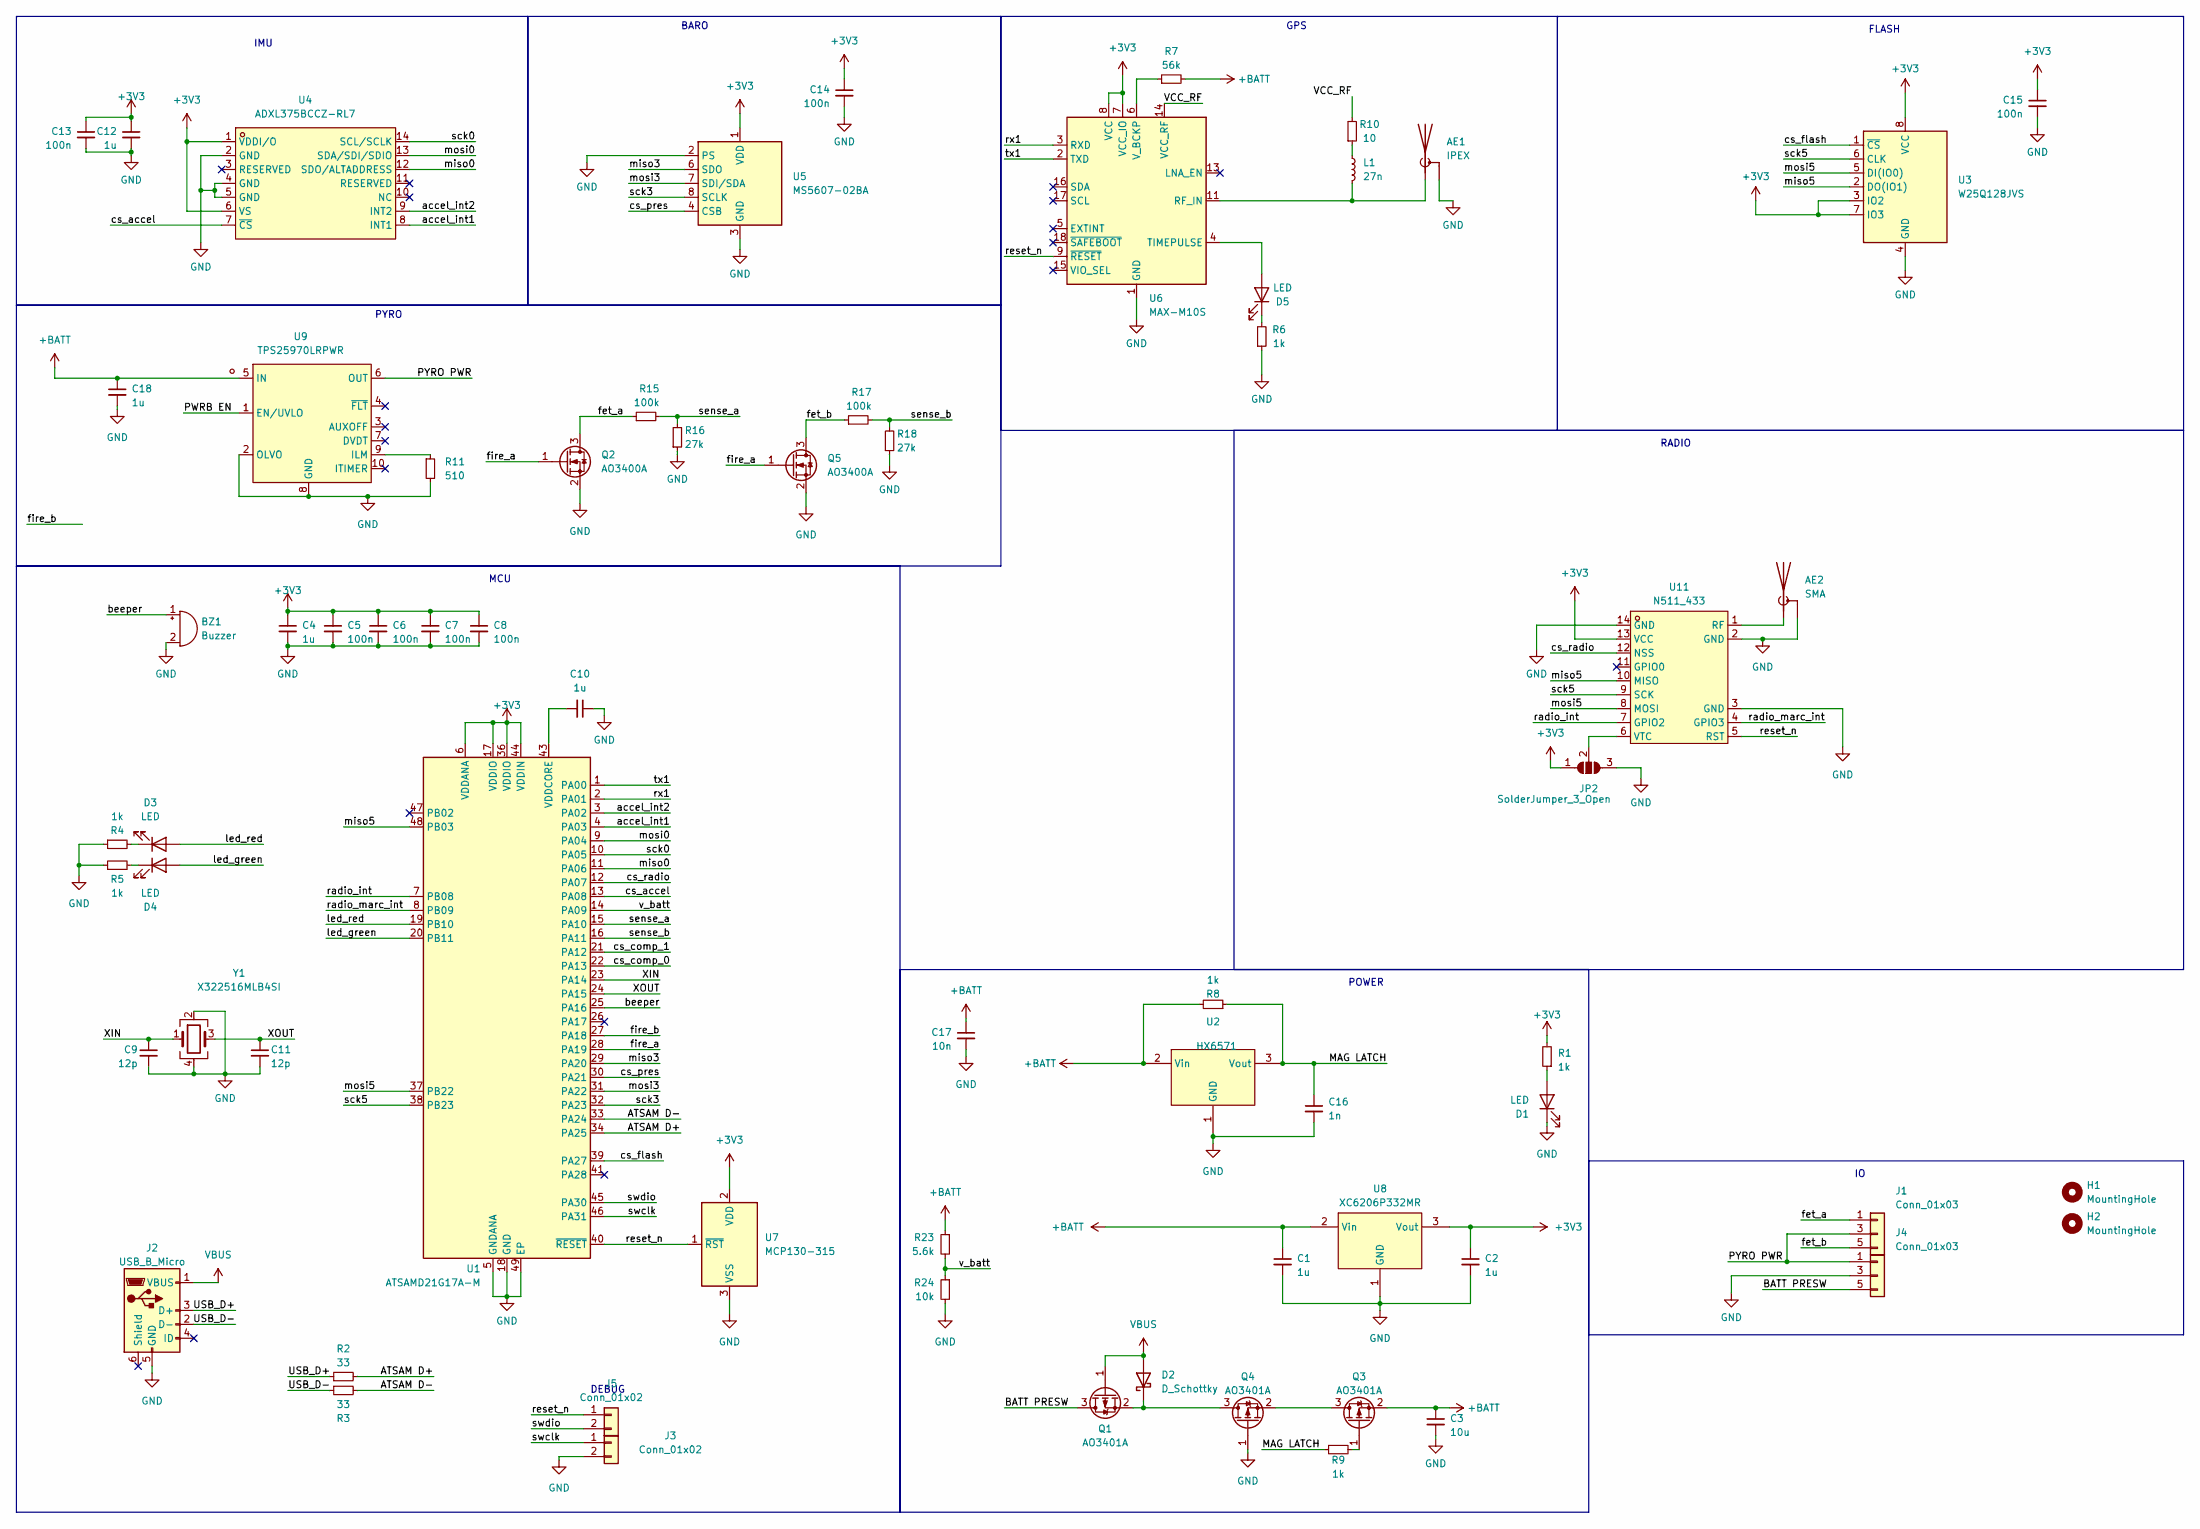
[picture p53: schematic metrumizer.kicad_sch]

Parts:
AE1: IPEX; ANT-SMD_1909763-1; LCSC Part C392444
AE2: SMA; CONN-SMD_KH-SMA-KE8-G; LCSC Part C530661
BZ1: Buzzer; PKMCS0909E4000R1; Part # CPE-163
C1, C2, C4, C10, C12, C18: 1u; C_0402_1005Metric; LCSC Part C52923
C3: 10u; C_0603_1608Metric; LCSC Part C96446
C5, C6, C7, C8, C13, C14, C15: 100n; C_0402_1005Metric; LCSC Part C1525
C9, C11: 12p; C_0402_1005Metric; LCSC Part C1547
C16: 1n; C_0402_1005Metric; LCSC Part C1523
C17: 10n; C_0402_1005Metric; LCSC Part C15195
D1, D3, D4, D5: LED; LED_0805_2012Metric
D2: D_Schottky; D_SOD-323F; LCSC Part C191023
H1, H2: MountingHole; MountingHole_3.2mm_M3
J1, J4: Conn_01x03; CONN3_2059-303&slash_998-403_WAG; Part # 2059-323/998-403
J2: USB_B_Micro; MICRO-USB-SMD_U254-051T-4BHJ25-F2S; LCSC Part C381143
J3, J5: Conn_01x02; SolderJumper-2_P1.3mm_Open_Pad1.0x1.5mm
JP2: SolderJumper_3_Open; SolderJumper-3_P1.3mm_Open_RoundedPad1.0x1.5mm
L1: 27n; L_0402_1005Metric; Part # LQG15HS27NJ02D; LCSC Part C18830
Q1, Q3, Q4: AO3401A; SOT-23; LCSC Part C15127
Q2, Q5: AO3400A; SOT-23
R1, R4, R5, R6, R8, R9: 1k; R_0402_1005Metric; LCSC Part C11702
R2, R3: 33; R_0402_1005Metric; LCSC Part C25105
R7: 56k; R_0402_1005Metric; LCSC Part C25796
R10: 10; R_0402_1005Metric; LCSC Part C11702
R11: 510; R_0402_1005Metric; LCSC Part C25123
R15, R17: 100k; R_0402_1005Metric; LCSC Part C11702
R16, R18: 27k; R_0402_1005Metric; LCSC Part C25771
R23: 5.6k; R_0402_1005Metric; LCSC Part C25908
R24: 10k; R_0402_1005Metric; LCSC Part C25744
U1: ATSAMD21G17A-M; QFN-48-1EP_7x7mm_P0.5mm_EP5.15x5.15mm; LCSC Part C614532
U2: HX6571; SOT-23-3_L2.9-W1.6-P1.90-LS2.8-BR; LCSC Part C495738
U3: W25Q128JVS; SOIC-8_5.23x5.23mm_P1.27mm; LCSC Part C97521
U4: ADXL375BCCZ-RL7; LGA-14_L5.0-W3.0-P0.80-BL; LCSC Part C481898
U5: MS5607-02BA; LGA-8_3x5mm_P1.25mm; LCSC Part C97627
U6: MAX-M10S; ublox_MAX
U7: MCP130-315; SOT-23; LCSC Part C625194
U8: XC6206P332MR; SOT-23-3; LCSC Part C5446
U9: TPS25970LRPWR; QFN-10-2x2-hotrod; LCSC Part C3662801
U11: N511_433; N511 433
Y1: X322516MLB4SI; Crystal_SMD_3225-4Pin_3.2x2.5mm; LCSC Part C5444547

Connections:
+3V3: C2.1, C4.1, C5.1, C6.1, C7.1, C8.1, C12.1, C13.1, C14.1, C15.1, JP2.1 (A), R1.2, U1.6 (VDDANA), U1.17 (VDDIO), U1.36 (VDDIO), U1.44 (VDDIN), U3.3 (IO2), U3.7 (IO3), U3.8 (VCC), U4.1 (VDDI/O), U4.6 (VS), U5.1 (VDD), U6.7 (VCC_IO), U6.8 (VCC), U7.2 (VDD), U8.3 (Vout), U11.13 (VCC)
+BATT: C1.1, C3.1, C17.1, C18.1, Q3.2 (S), R7.2, R8.2, R23.1, U2.2 (Vin), U8.2 (Vin), U9.5 (IN)
/ATSAM D+: R2.2, U1.34 (PA25)
/ATSAM D-: R3.2, U1.33 (PA24)
/BATT PRESW: J4.5 (Pin_3), J4.6 (Pin_3), Q1.3 (D)
/MAG LATCH: C16.1, R8.1, R9.1, U2.3 (Vout)
/PWRB EN: U9.1 (EN/UVLO)
/PYRO PWR: J1.3 (Pin_2), J1.4 (Pin_2), J4.1, J4.2 (Pin_1), U9.6 (OUT)
/USB_D+: J2.3 (D+), R2.1
/USB_D-: J2.2 (D-), R3.1
/VCC_RF: R10.2, U6.14 (VCC_RF)
/XIN: C9.1, U1.23 (PA14), Y1.1
/XOUT: C11.1, U1.24 (PA15), Y1.3
/accel_int1: U1.4 (PA03), U4.8 (INT1)
/accel_int2: U1.3 (PA02), U4.9 (INT2)
/beeper: BZ1.1 (+), U1.25 (PA16)
/cs_accel: U1.13 (PA08), U4.7 (~CS)
/cs_comp_0: U1.22 (PA13)
/cs_comp_1: U1.21 (PA12)
/cs_flash: U1.39 (PA27), U3.1 (~CS)
/cs_pres: U1.30 (PA21), U5.4 (CSB), U5.5 (CSB)
/cs_radio: U1.12 (PA07), U11.12 (NSS)
/fet_a: J1.1, J1.2 (Pin_1), Q2.3 (D), R15.1
/fet_b: J1.5 (Pin_3), J1.6 (Pin_3), Q5.3 (D), R17.1
/fire_a: Q2.1 (G), Q5.1 (G), U1.28 (PA19)
/fire_b: U1.27 (PA18)
/led_green: D4.2 (A), U1.20 (PB11)
/led_red: D3.2 (A), U1.19 (PB10)
/miso0: U1.11 (PA06), U4.12 (SDO/ALTADDRESS)
/miso3: U1.29 (PA20), U5.6 (SDO)
/miso5: U1.48 (PB03), U3.2 (DO(IO1)), U11.10 (MISO)
/mosi0: U1.9 (PA04), U4.13 (SDA/SDI/SDIO)
/mosi3: U1.31 (PA22), U5.7 (SDI/SDA)
/mosi5: U1.37 (PB22), U3.5 (DI(IO0)), U11.8 (MOSI)
/radio_int: U1.7 (PB08), U11.7 (GPIO2)
/radio_marc_int: U1.8 (PB09), U11.4 (GPIO3)
/reset_n: J5.1, U1.40 (~RESET), U6.9 (~RESET), U7.1 (~RST), U11.5 (RST)
/rx1: U1.2 (PA01), U6.3 (RXD)
/sck0: U1.10 (PA05), U4.14 (SCL/SCLK)
/sck3: U1.32 (PA23), U5.8 (SCLK)
/sck5: U1.38 (PB23), U3.6 (CLK), U11.9 (SCK)
/sense_a: R15.2, R16.2, U1.15 (PA10)
/sense_b: R17.2, R18.2, U1.16 (PA11)
/swclk: J3.1, U1.46 (PA31)
/swdio: J5.2, U1.45 (PA30)
/tx1: U1.1 (PA00), U6.2 (TXD)
/v_batt: R23.2, R24.1, U1.14 (PA09)
GND: AE1.2 (Shield), AE2.2 (Shield), BZ1.2 (-), C1.2, C2.2, C3.2, C4.2, C5.2, C6.2, C7.2, C8.2, C9.2, C10.1, C11.2, C12.2, C13.2, C14.2, C15.2, C16.2, C17.2, C18.2, D1.1 (K), J2.5 (GND), J3.2, J4.3 (Pin_2), J4.4 (Pin_2), JP2.3 (B), Q2.2 (S), Q4.1 (G), Q5.2 (S), R4.1, R5.1, R6.1, R11.2, R16.1, R18.1, R24.2, U1.5 (GNDANA), U1.18 (GND), U1.35 (GND), U1.42 (GND), U1.49 (EP), U2.1 (GND), U3.4 (GND), U4.2 (GND), U4.4 (GND), U4.5 (GND), U5.2 (PS), U5.3 (GND), U6.1 (GND), U6.10 (GND), U6.12 (GND), U7.3 (VSS), U8.1 (GND), U9.2 (OLVO), U9.8 (GND), U11.2 (GND), U11.3 (GND), U11.14 (GND), Y1.2, Y1.4
unnamed: AE1.1 (A), L1.2, U6.11 (RF_IN)
unnamed: AE2.1 (A), U11.1 (RF)
unnamed: D1.2 (A), R1.1
unnamed: D2.1 (K), Q1.2 (S), Q4.3 (D)
unnamed: D3.1 (K), R4.2
unnamed: D4.1 (K), R5.2
unnamed: D5.2 (A), U6.4 (TIMEPULSE)
unnamed: D5.1 (K), R6.2
unnamed: JP2.2 (C), U11.6 (VTC)
unnamed: L1.1, R10.1
unnamed: Q3.3 (D), Q4.2 (S)
unnamed: Q3.1 (G), R9.2
unnamed: C10.2, U1.43 (VDDCORE)
unnamed: R7.1, U6.6 (V_BCKP)
unnamed: R11.1, U9.9 (ILM)
VBUS: D2.2 (A), J2.1 (VBUS), Q1.1 (G)

Notes on the sheet:
IMU
PYRO
DEBUG
GPS
MCU
BARO
RADIO
POWER
FLASH

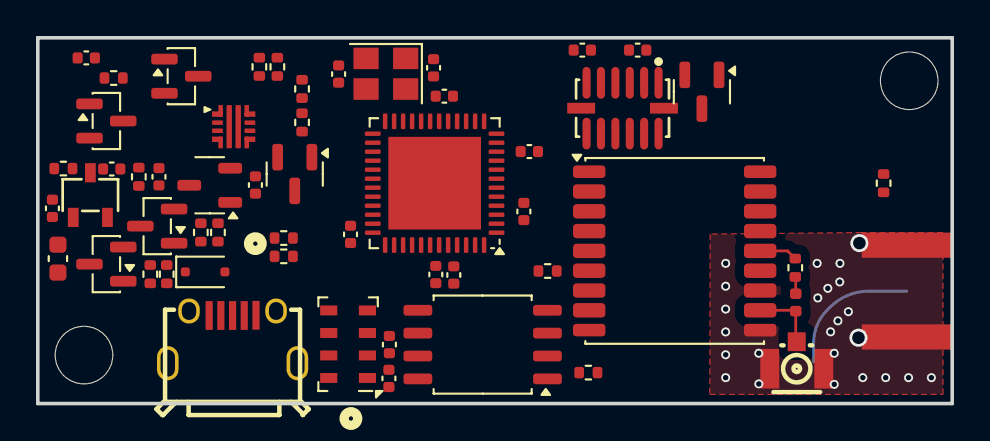
[picture p54: board metrumizer.kicad_pcb from above]

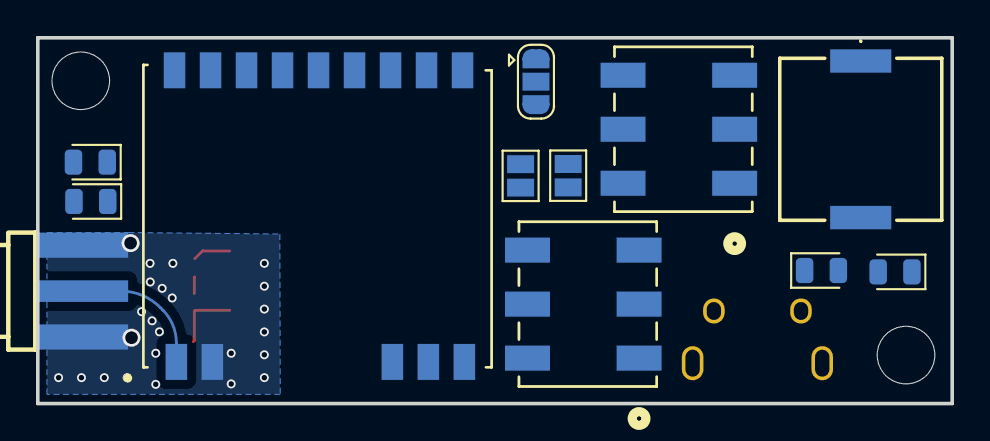
[picture p55: board metrumizer.kicad_pcb from below]

Board: 4 copper layers, 50.8 x 20.3 mm, 68 parts (13 on the bottom side), 60 nets.
