prs2026/Lyra-flight-computer/CamControl/camcontrol/camcontrol.kicad_pcb

## KiCad design CamControl/camcontrol/camcontrol.kicad_pcb (2025-12-04)

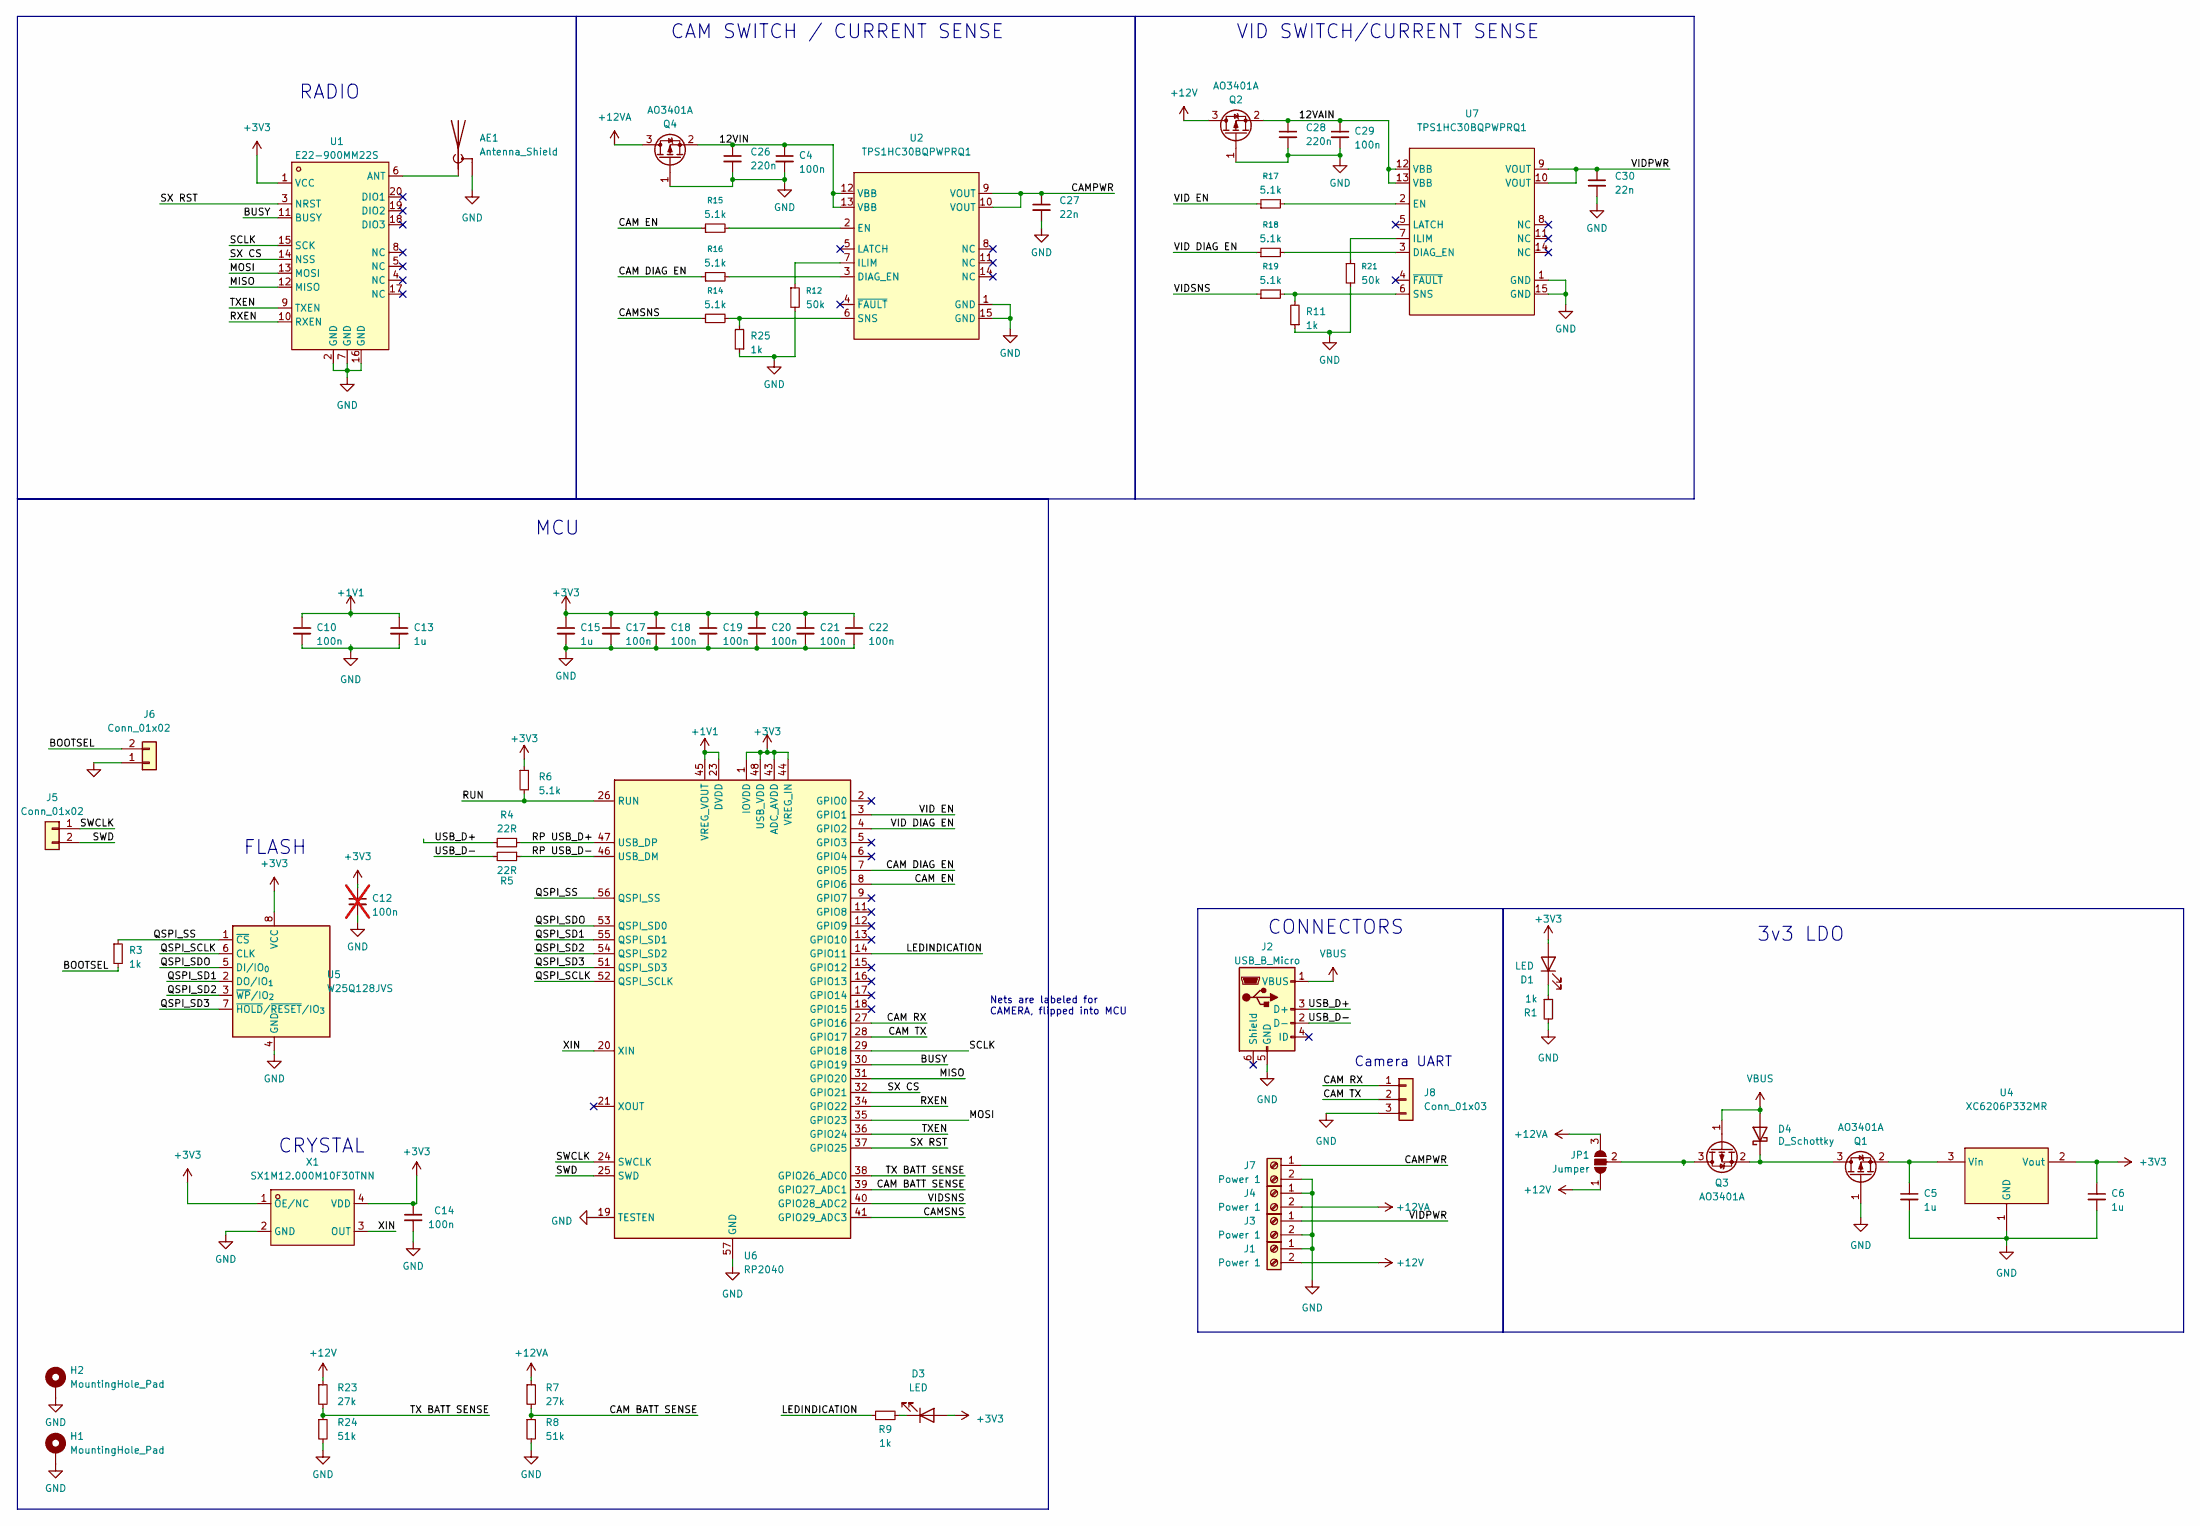
[picture p56: schematic camcontrol.kicad_sch]

Parts:
AE1: Antenna_Shield; ANT-SMD_1909763-1; LCSC Part C392444
C4, C10, C14, C17, C18, C19, C20, C21, C22, C29: 100n; C_0402_1005Metric; LCSC Part C1525
C5, C6, C13, C15: 1u; C_0402_1005Metric; LCSC Part C52923
C12: 100n; C_0402_1005Metric; LCSC Part C1525; not fitted
C26, C28: 220n; C_0402_1005Metric; LCSC Part C16772
C27, C30: 22n; C_0402_1005Metric; LCSC Part C1532
D1, D3: LED; LED_0603_1608Metric; LCSC Part C89811
D4: D_Schottky; D_SOD-323F; LCSC Part C191023
H1, H2: MountingHole_Pad; MountingHole_2.2mm_M2_DIN965_Pad
J1, J3, J4, J7: Power 1; wago2pin3mmspace
J2: USB_B_Micro; MICRO-USB-SMD_U254-051T-4BHJ25-F2S; LCSC Part C381143
J5: Conn_01x02; SolderJumper-2_P1.3mm_Open_Pad1.0x1.5mm
J6: Conn_01x02; SolderJumper-2_P1.3mm_Open_RoundedPad1.0x1.5mm
J8: Conn_01x03; PinHeader_1x03_P2.00mm_Vertical
JP1: Jumper; SolderJumper-3_P1.3mm_Open_RoundedPad1.0x1.5mm
Q1, Q2, Q3, Q4: AO3401A; SOT-23; LCSC Part C15127
R1, R3, R9, R11, R25: 1k; R_0402_1005Metric; LCSC Part C11702
R4, R5: 22R; R_0402_1005Metric; LCSC Part C25092
R6, R14, R15, R16, R17, R18, R19: 5.1k; R_0402_1005Metric; LCSC Part C25905
R7, R23: 27k; R_0402_1005Metric; LCSC Part C25771
R8, R24: 51k; R_0402_1005Metric; LCSC Part C25794
R12, R21: 50k; R_0402_1005Metric; LCSC Part C25897
U1: E22-900MM22S; WIRELM-SMD_E22-400MM22S; LCSC Part C5333984
U2, U7: TPS1HC30BQPWPRQ1; HTSSOP-14_L5.0-W4.4-P0.65-LS6.4-BL-EP-3; LCSC Part C7496534
U4: XC6206P332MR; SOT-23-3; LCSC Part C5446
U5: W25Q128JVS; SOIC-8_5.3x5.3mm_P1.27mm; LCSC Part C97521
U6: RP2040; QFN-56-1EP_7x7mm_P0.4mm_EP3.2x3.2mm; LCSC Part C2040
X1: SX1M12.000M10F30TNN; OSC-SMD_4P-L2.0-W1.6-BL; LCSC Part C2901608

Connections:
+1V1: C10.1, C13.1, U6.23 (DVDD), U6.45 (VREG_VOUT), U6.50 (DVDD)
+3V3: C6.1, C12.1, C14.1, C15.1, C17.1, C18.1, C19.1, C20.1, C21.1, C22.1, D1.2 (A), D3.2 (A), R6.1, U1.1 (VCC), U4.2 (Vout), U5.8 (VCC), U6.1 (IOVDD), U6.10 (IOVDD), U6.22 (IOVDD), U6.33 (IOVDD), U6.42 (IOVDD), U6.43 (ADC_AVDD), U6.44 (VREG_IN), U6.48 (USB_VDD), U6.49 (IOVDD), X1.1 (OE/NC), X1.4 (VDD)
+12V: J1.2, JP1.1 (A), Q2.3 (D), R23.1
+12VA: J4.2, JP1.3 (B), Q4.3 (D), R7.1
/12VAIN: C28.1, C29.1, Q2.2 (S), U7.12 (VBB), U7.13 (VBB)
/12VIN: C4.1, C26.1, Q4.2 (S), U2.12 (VBB), U2.13 (VBB)
/BOOTSEL: J6.2, R3.2
/BUSY: U1.11 (BUSY), U6.30 (GPIO19)
/CAM BATT SENSE: R7.2, R8.1, U6.39 (GPIO27_ADC1)
/CAM DIAG EN: R16.1, U6.7 (GPIO5)
/CAM EN: R15.1, U6.8 (GPIO6)
/CAM RX: J8.1, U6.27 (GPIO16)
/CAM TX: J8.2, U6.28 (GPIO17)
/CAMPWR: C27.1, J7.1, U2.9 (VOUT), U2.10 (VOUT)
/CAMSNS: R14.1, U6.41 (GPIO29_ADC3)
/LEDINDICATION: R9.1, U6.14 (GPIO11)
/MISO: U1.12 (MISO), U6.31 (GPIO20)
/MOSI: U1.13 (MOSI), U6.35 (GPIO23)
/QSPI_SCLK: U5.6 (CLK), U6.52 (QSPI_SCLK)
/QSPI_SD1: U5.2 (DO/IO_{1}), U6.55 (QSPI_SD1)
/QSPI_SD2: U5.3 (~WP/IO_{2}), U6.54 (QSPI_SD2)
/QSPI_SD3: U5.7 (~HOLD/~RESET/IO_{3}), U6.51 (QSPI_SD3)
/QSPI_SDO: U5.5 (DI/IO_{0}), U6.53 (QSPI_SD0)
/QSPI_SS: R3.1, U5.1 (~CS), U6.56 (QSPI_SS)
/RP USB_D+: R4.2, U6.47 (USB_DP)
/RP USB_D-: R5.1, U6.46 (USB_DM)
/RUN: R6.2, U6.26 (RUN)
/RXEN: U1.10 (RXEN), U6.34 (GPIO22)
/SCLK: U1.15 (SCK), U6.29 (GPIO18)
/SWCLK: J5.1, U6.24 (SWCLK)
/SWD: J5.2, U6.25 (SWD)
/SX CS: U1.14 (NSS), U6.32 (GPIO21)
/SX RST: U1.3 (NRST), U6.37 (GPIO25)
/TX BATT SENSE: R23.2, R24.1, U6.38 (GPIO26_ADC0)
/TXEN: U1.9 (TXEN), U6.36 (GPIO24)
/USB_D+: J2.3 (D+), R4.1
/USB_D-: J2.2 (D-), R5.2
/VID DIAG EN: R18.1, U6.4 (GPIO2)
/VID EN: R17.1, U6.3 (GPIO1)
/VIDPWR: C30.1, J3.1, U7.9 (VOUT), U7.10 (VOUT)
/VIDSNS: R19.1, U6.40 (GPIO28_ADC2)
/XIN: U6.20 (XIN), X1.3 (OUT)
GND: AE1.2 (Shield), C4.2, C5.2, C6.2, C10.2, C12.2, C13.2, C14.2, C15.2, C17.2, C18.2, C19.2, C20.2, C21.2, C22.2, C26.2, C27.2, C28.2, C29.2, C30.2, H1.1, H2.1, J1.1, J2.5 (GND), J3.2, J4.1, J6.1, J7.2, J8.3, Q1.1 (G), Q2.1 (G), Q4.1 (G), R1.2, R8.2, R11.1, R12.2, R21.2, R24.2, R25.1, U1.2 (GND), U1.7 (GND), U1.16 (GND), U2.1 (GND), U2.15 (GND), U4.1 (GND), U5.4 (GND), U6.19 (TESTEN), U6.57 (GND), U7.1 (GND), U7.15 (GND), X1.2 (GND)
unnamed: AE1.1 (A), U1.6 (ANT)
unnamed: D1.1 (K), R1.1
unnamed: D3.1 (K), R9.2
unnamed: D4.1 (K), Q1.3 (D), Q3.2 (S)
unnamed: JP1.2 (C), Q3.3 (D)
unnamed: C5.1, Q1.2 (S), U4.3 (Vin)
unnamed: R16.2, U2.3 (DIAG_EN)
unnamed: R15.2, U2.2 (EN)
unnamed: R12.1, U2.7 (ILIM)
unnamed: R14.2, R25.2, U2.6 (SNS)
unnamed: R18.2, U7.3 (DIAG_EN)
unnamed: R17.2, U7.2 (EN)
unnamed: R21.1, U7.7 (ILIM)
unnamed: R11.2, R19.2, U7.6 (SNS)
VBUS: D4.2 (A), J2.1 (VBUS), Q3.1 (G)

Notes on the sheet:
CONNECTORS
RADIO
FLASH
Camera UART
MCU
Nets are labeled for CAMERA, flipped into MCU
VID SWITCH/CURRENT SENSE
CAM SWITCH / CURRENT SENSE
3v3 LDO
CRYSTAL

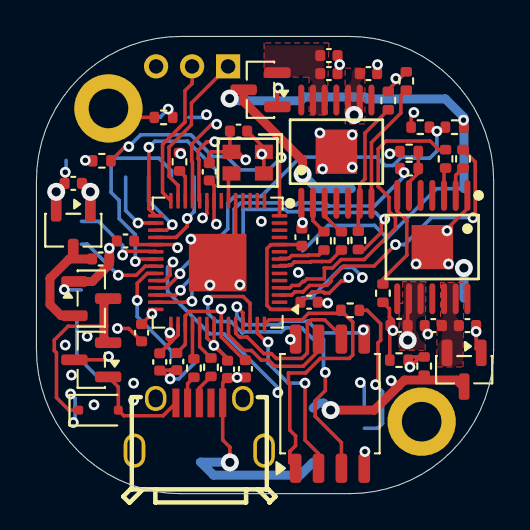
[picture p57: board camcontrol.kicad_pcb from above]

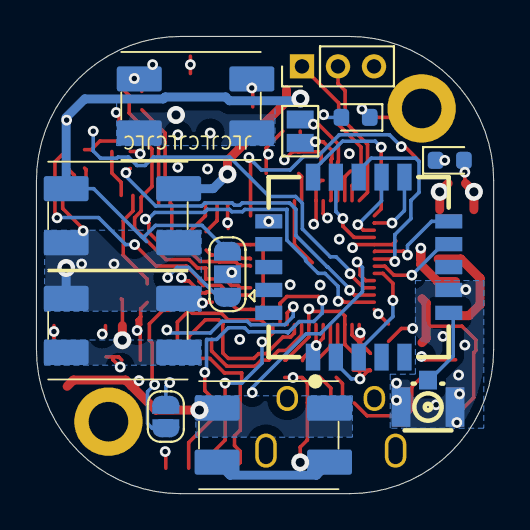
[picture p58: board camcontrol.kicad_pcb from below]

Board: 4 copper layers, 25.4 x 25.4 mm, 64 parts (12 on the bottom side), 58 nets.
