prs2026/Lyra-flight-computer/Hope/Hope/Hope.kicad_pcb

## KiCad design Hope/Hope/Hope.kicad_pcb (2025-12-03)

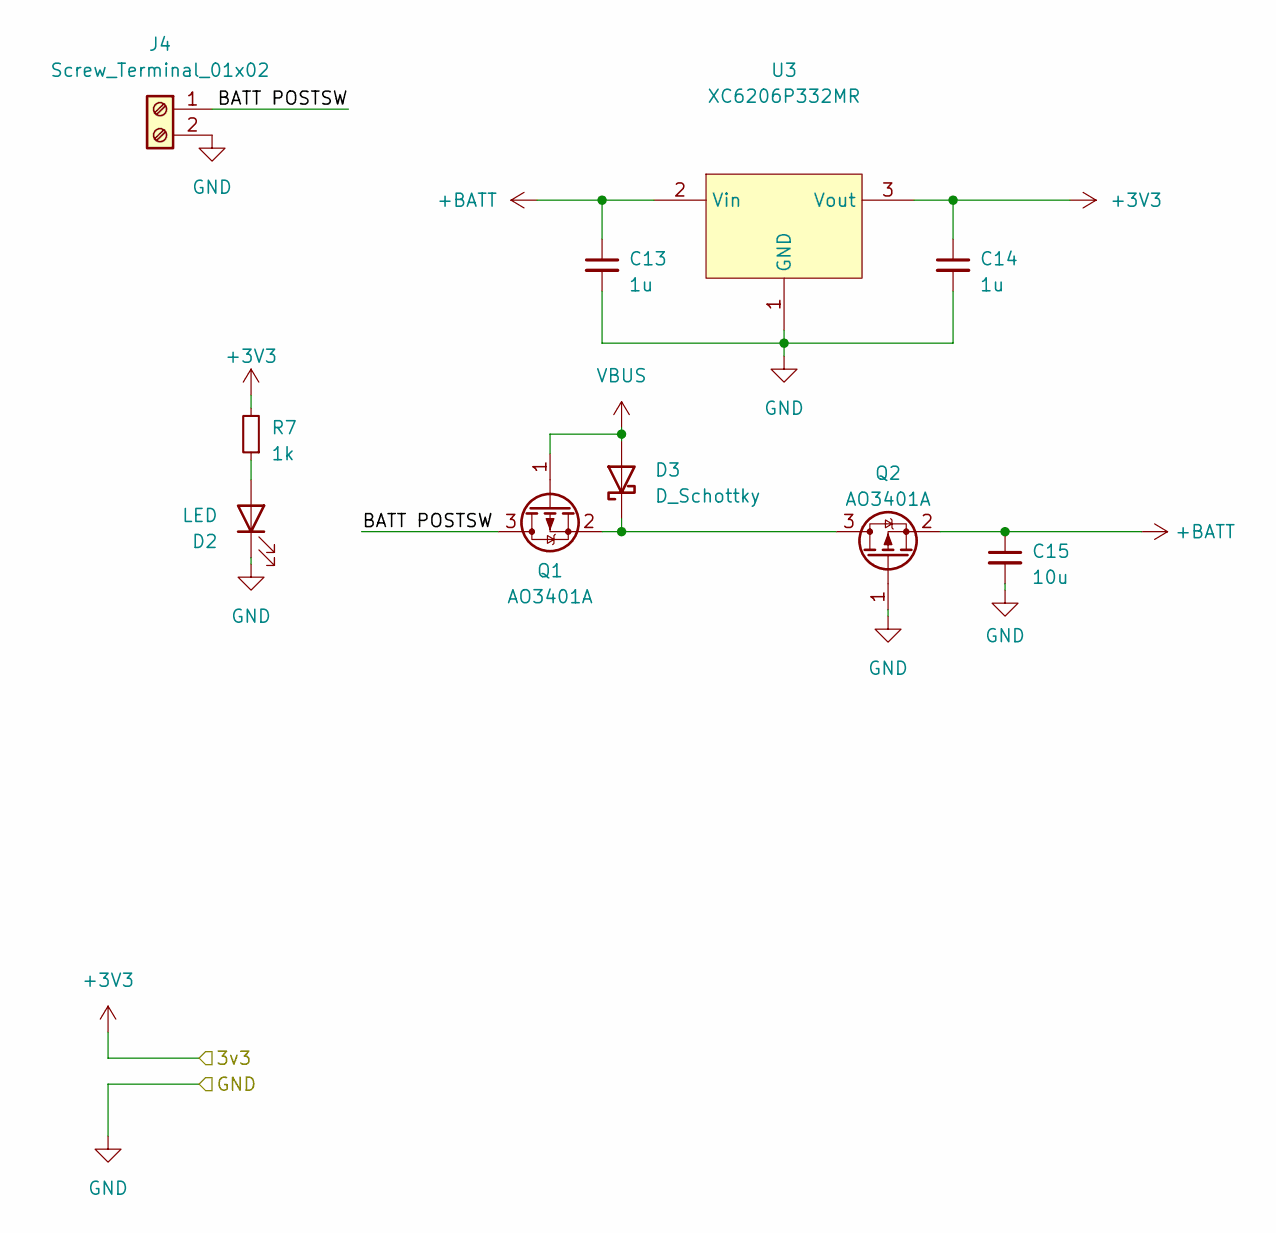
[picture p59: schematic Power.kicad_sch]

Parts:
C13, C14: 1u; C_0402_1005Metric; LCSC Part C52923
C15: 10u; C_0603_1608Metric; LCSC Part C96446
D2: LED; LED_0805_2012Metric
D3: D_Schottky; D_SOD-323F; LCSC Part C191023
J4: Screw_Terminal_01x02; TerminalBlock_Phoenix_MPT-0,5-2-2.54_1x02_P2.54mm_Horizontal
Q1, Q2: AO3401A; SOT-23; LCSC Part C15127
R7: 1k; R_0402_1005Metric; LCSC Part C11702
U3: XC6206P332MR; SOT-23-3_L2.9-W1.6-P1.90-LS2.8-BR; LCSC Part C5446

Connections:
+3V3: C14.1, R7.2, U3.3 (Vout); also elsewhere on the board
+BATT: C13.1, C15.1, Q2.2 (S), U3.2 (Vin); also elsewhere on the board
/Power/BATT POSTSW: J4.1, Q1.3 (D)
GND: C13.2, C14.2, C15.2, D2.1 (K), J4.2, Q2.1 (G), U3.1 (GND); also elsewhere on the board
unnamed: D2.2 (A), R7.1
unnamed: D3.1 (K), Q1.2 (S), Q2.3 (D)
VBUS: D3.2 (A), Q1.1 (G); also elsewhere on the board

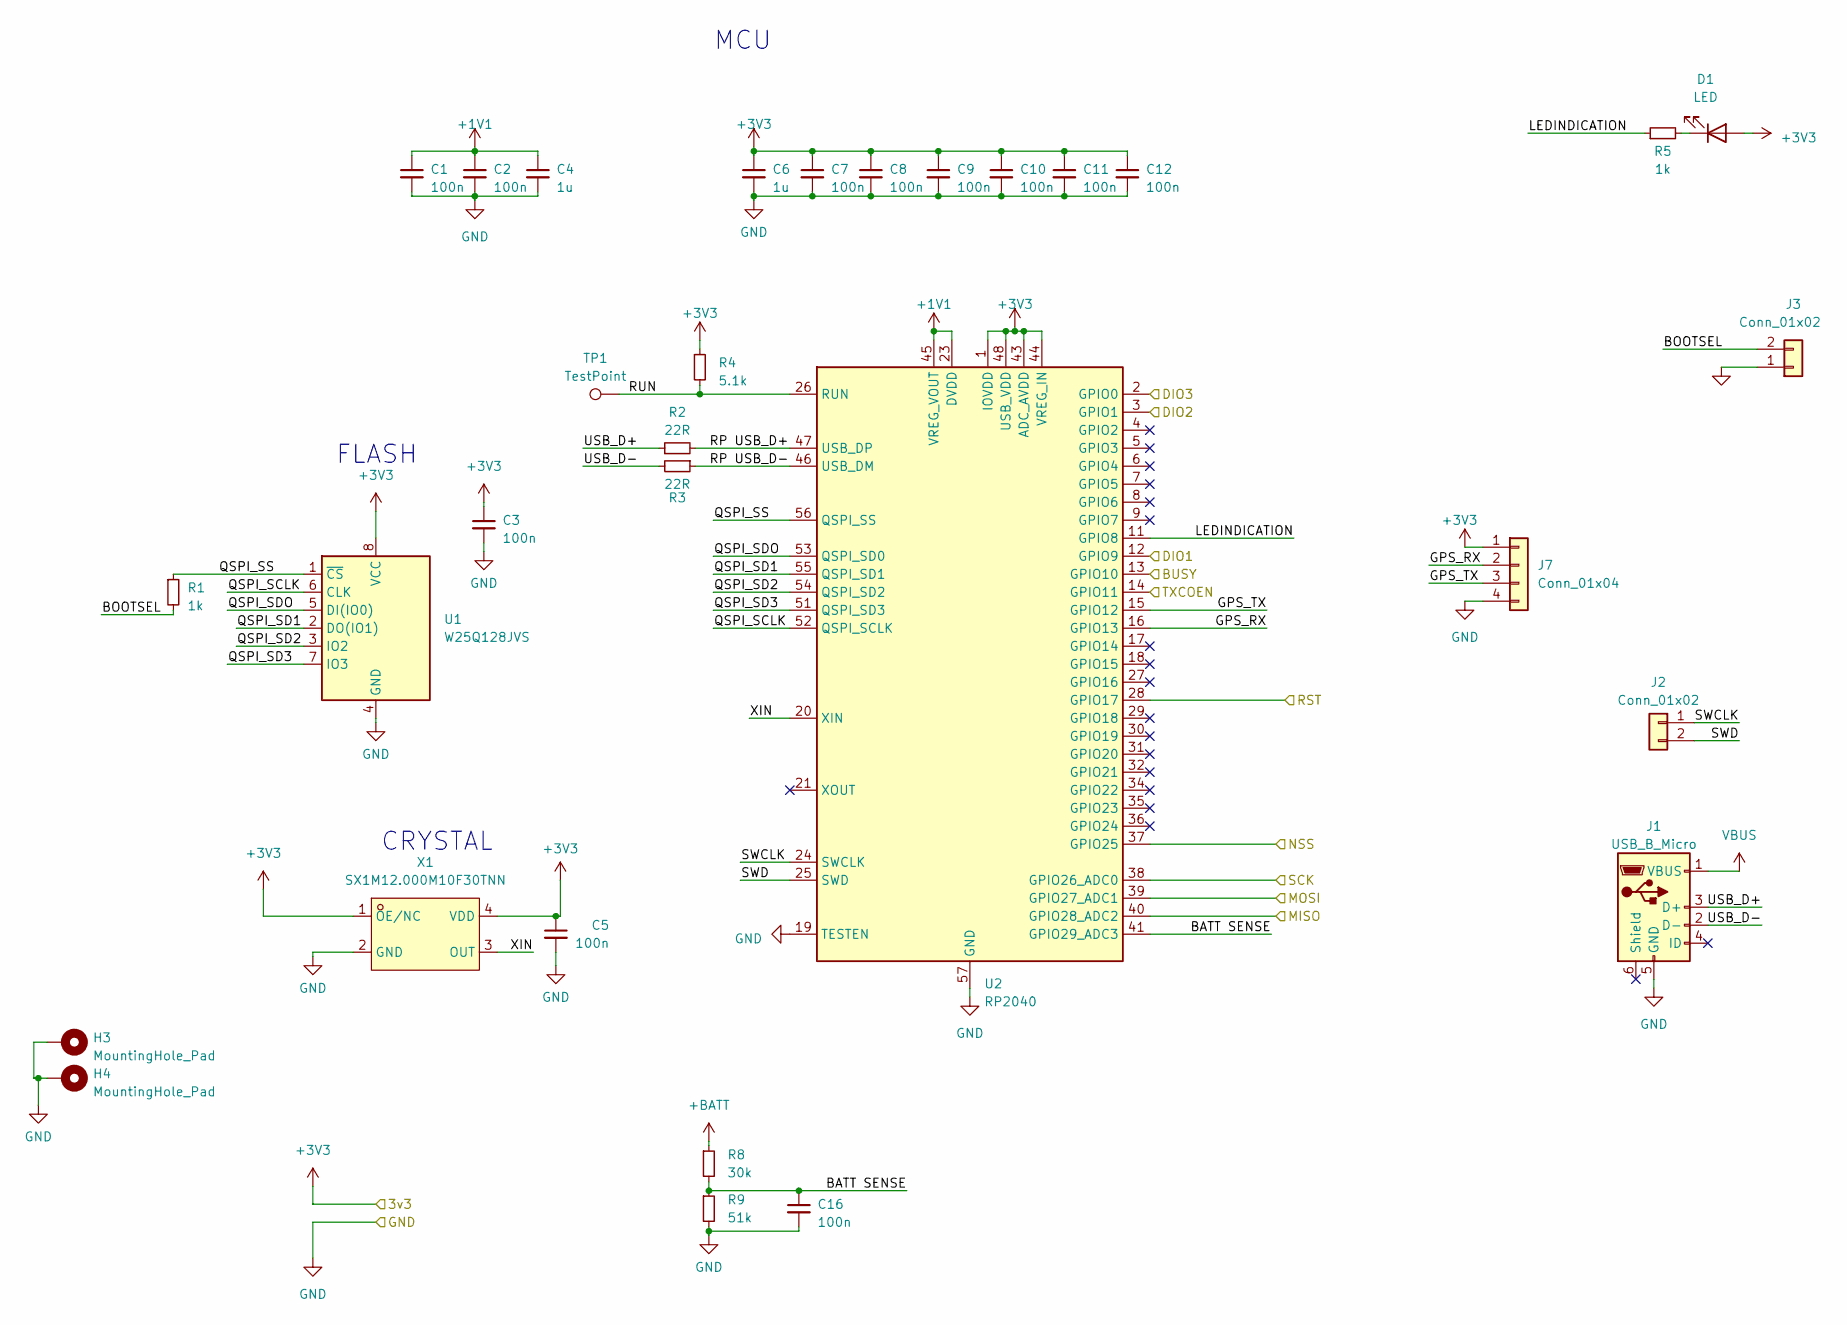
[picture p60: schematic MCU.kicad_sch]

Parts:
C1, C2, C3, C5, C7, C8, C9, C10, C11, C12, C16: 100n; C_0402_1005Metric; LCSC Part C1525
C4, C6: 1u; C_0402_1005Metric; LCSC Part C52923
D1: LED; LED_0805_2012Metric
H3, H4: MountingHole_Pad; MountingHole_2.2mm_M2_DIN965_Pad
J1: USB_B_Micro; MICRO-USB-SMD_U254-051T-4BHJ25-F2S; LCSC Part C381143
J2: Conn_01x02; SolderJumper-2_P1.3mm_Open_Pad1.0x1.5mm
J3: Conn_01x02; SolderJumper-2_P1.3mm_Open_RoundedPad1.0x1.5mm
J7: Conn_01x04; 4 pads 2.54mm spacign; LCSC Part C160404
R1, R5: 1k; R_0402_1005Metric; LCSC Part C11702
R2, R3: 22R; R_0402_1005Metric; LCSC Part C25092
R4: 5.1k; R_0402_1005Metric; LCSC Part C25905
R8: 30k; R_0402_1005Metric; LCSC Part C25105
R9: 51k; R_0402_1005Metric; LCSC Part C25794
TP1: TestPoint; TestPoint_Pad_1.0x1.0mm
U1: W25Q128JVS; SOIC-8_5.23x5.23mm_P1.27mm; LCSC Part C97521
U2: RP2040; QFN-56-1EP_7x7mm_P0.4mm_EP3.2x3.2mm; LCSC Part C2040
X1: SX1M12.000M10F30TNN; OSC-SMD_4P-L2.0-W1.6-BL; LCSC Part C2901608

Connections:
+1V1: C1.1, C2.1, C4.1, U2.23 (DVDD), U2.45 (VREG_VOUT), U2.50 (DVDD)
+3V3: C3.1, C5.1, C6.1, C7.1, C8.1, C9.1, C10.1, C11.1, C12.1, D1.2 (A), J7.1, R4.1, U1.8 (VCC), U2.1 (IOVDD), U2.10 (IOVDD), U2.22 (IOVDD), U2.33 (IOVDD), U2.42 (IOVDD), U2.43 (ADC_AVDD), U2.44 (VREG_IN), U2.48 (USB_VDD), U2.49 (IOVDD), X1.1 (OE/NC), X1.4 (VDD); also elsewhere on the board
+BATT: R8.1; also elsewhere on the board
/MCU/BATT SENSE: C16.1, R8.2, R9.1, U2.41 (GPIO29_ADC3)
/MCU/BOOTSEL: J3.2, R1.2
/MCU/BUSY: U2.13 (GPIO10); also elsewhere on the board
/MCU/DIO1: U2.12 (GPIO9); also elsewhere on the board
/MCU/DIO2: U2.3 (GPIO1); also elsewhere on the board
/MCU/DIO3: U2.2 (GPIO0); also elsewhere on the board
/MCU/GPS_RX: J7.2, U2.16 (GPIO13)
/MCU/GPS_TX: J7.3, U2.15 (GPIO12)
/MCU/LEDINDICATION: R5.1, U2.11 (GPIO8)
/MCU/MISO: U2.40 (GPIO28_ADC2); also elsewhere on the board
/MCU/MOSI: U2.39 (GPIO27_ADC1); also elsewhere on the board
/MCU/NSS: U2.37 (GPIO25); also elsewhere on the board
/MCU/QSPI_SCLK: U1.6 (CLK), U2.52 (QSPI_SCLK)
/MCU/QSPI_SD1: U1.2 (DO(IO1)), U2.55 (QSPI_SD1)
/MCU/QSPI_SD2: U1.3 (IO2), U2.54 (QSPI_SD2)
/MCU/QSPI_SD3: U1.7 (IO3), U2.51 (QSPI_SD3)
/MCU/QSPI_SDO: U1.5 (DI(IO0)), U2.53 (QSPI_SD0)
/MCU/QSPI_SS: R1.1, U1.1 (~CS), U2.56 (QSPI_SS)
/MCU/RP USB_D+: R2.2, U2.47 (USB_DP)
/MCU/RP USB_D-: R3.1, U2.46 (USB_DM)
/MCU/RST: U2.28 (GPIO17)
/MCU/RUN: R4.2, TP1.1, U2.26 (RUN)
/MCU/SCK: U2.38 (GPIO26_ADC0); also elsewhere on the board
/MCU/SWCLK: J2.1, U2.24 (SWCLK)
/MCU/SWD: J2.2, U2.25 (SWD)
/MCU/TXCOEN: U2.14 (GPIO11); also elsewhere on the board
/MCU/USB_D+: J1.3 (D+), R2.1
/MCU/USB_D-: J1.2 (D-), R3.2
/MCU/XIN: U2.20 (XIN), X1.3 (OUT)
GND: C1.2, C2.2, C3.2, C4.2, C5.2, C6.2, C7.2, C8.2, C9.2, C10.2, C11.2, C12.2, C16.2, H3.1, H4.1, J1.5 (GND), J3.1, J7.4, R9.2, U1.4 (GND), U2.19 (TESTEN), U2.57 (GND), X1.2 (GND); also elsewhere on the board
unnamed: D1.1 (K), R5.2
VBUS: J1.1 (VBUS); also elsewhere on the board

Notes on the sheet:
FLASH
MCU
CRYSTAL

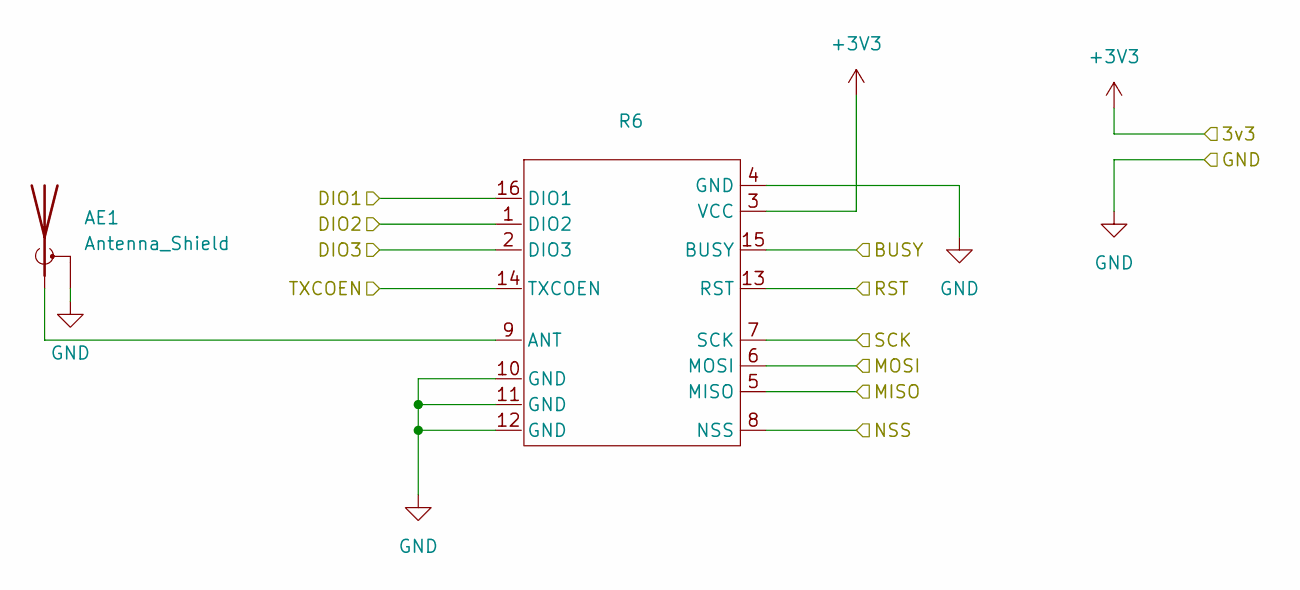
[picture p61: schematic Radio Module.kicad_sch]

Parts:
AE1: Antenna_Shield; CONN-SMD_KH-SMA-KE8-G; LCSC Part C530661
R6: WIRELM-SMD_16P-L16.0-W16.0-P2.00_LORA1280-TCXO

Connections:
+3V3: R6.3 (VCC); also elsewhere on the board
/MCU/BUSY: R6.15 (BUSY); also elsewhere on the board
/MCU/DIO1: R6.16 (DIO1); also elsewhere on the board
/MCU/DIO2: R6.1 (DIO2); also elsewhere on the board
/MCU/DIO3: R6.2 (DIO3); also elsewhere on the board
/MCU/MISO: R6.5 (MISO); also elsewhere on the board
/MCU/MOSI: R6.6 (MOSI); also elsewhere on the board
/MCU/NSS: R6.8 (NSS); also elsewhere on the board
/MCU/SCK: R6.7 (SCK); also elsewhere on the board
/MCU/TXCOEN: R6.14 (TXCOEN); also elsewhere on the board
/Radio Module/RST: R6.13 (RST)
GND: AE1.2 (Shield), R6.4 (GND), R6.10 (GND), R6.11 (GND), R6.12 (GND); also elsewhere on the board
unnamed: AE1.1 (A), R6.9 (ANT)

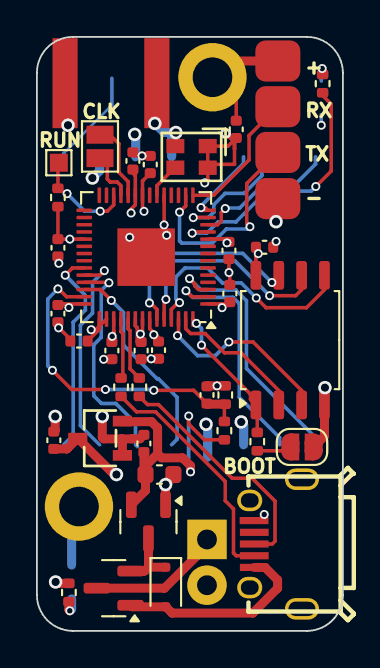
[picture p62: board Hope.kicad_pcb from above]

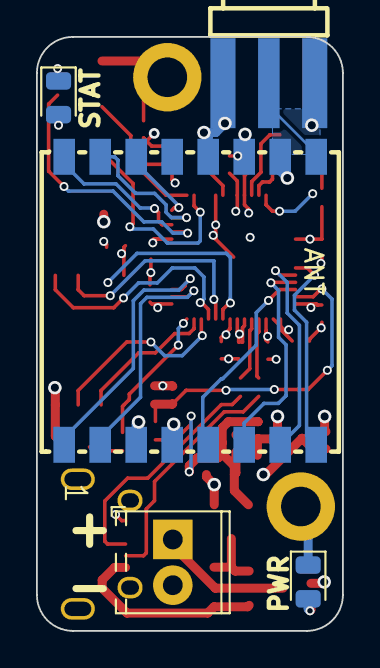
[picture p63: board Hope.kicad_pcb from below]

Board: 4 copper layers, 17.0 x 33.0 mm, 43 parts (5 on the bottom side), 38 nets.
