prs2026/Lyra-flight-computer/it sure is getting hot in here/it sure is getting ROUND in here/it sure is getting ROUND in here.kicad_pcb

## KiCad design it sure is getting hot in here/it sure is getting ROUND in here/it sure is getting ROUND in here.kicad_pcb (2025-10-21)

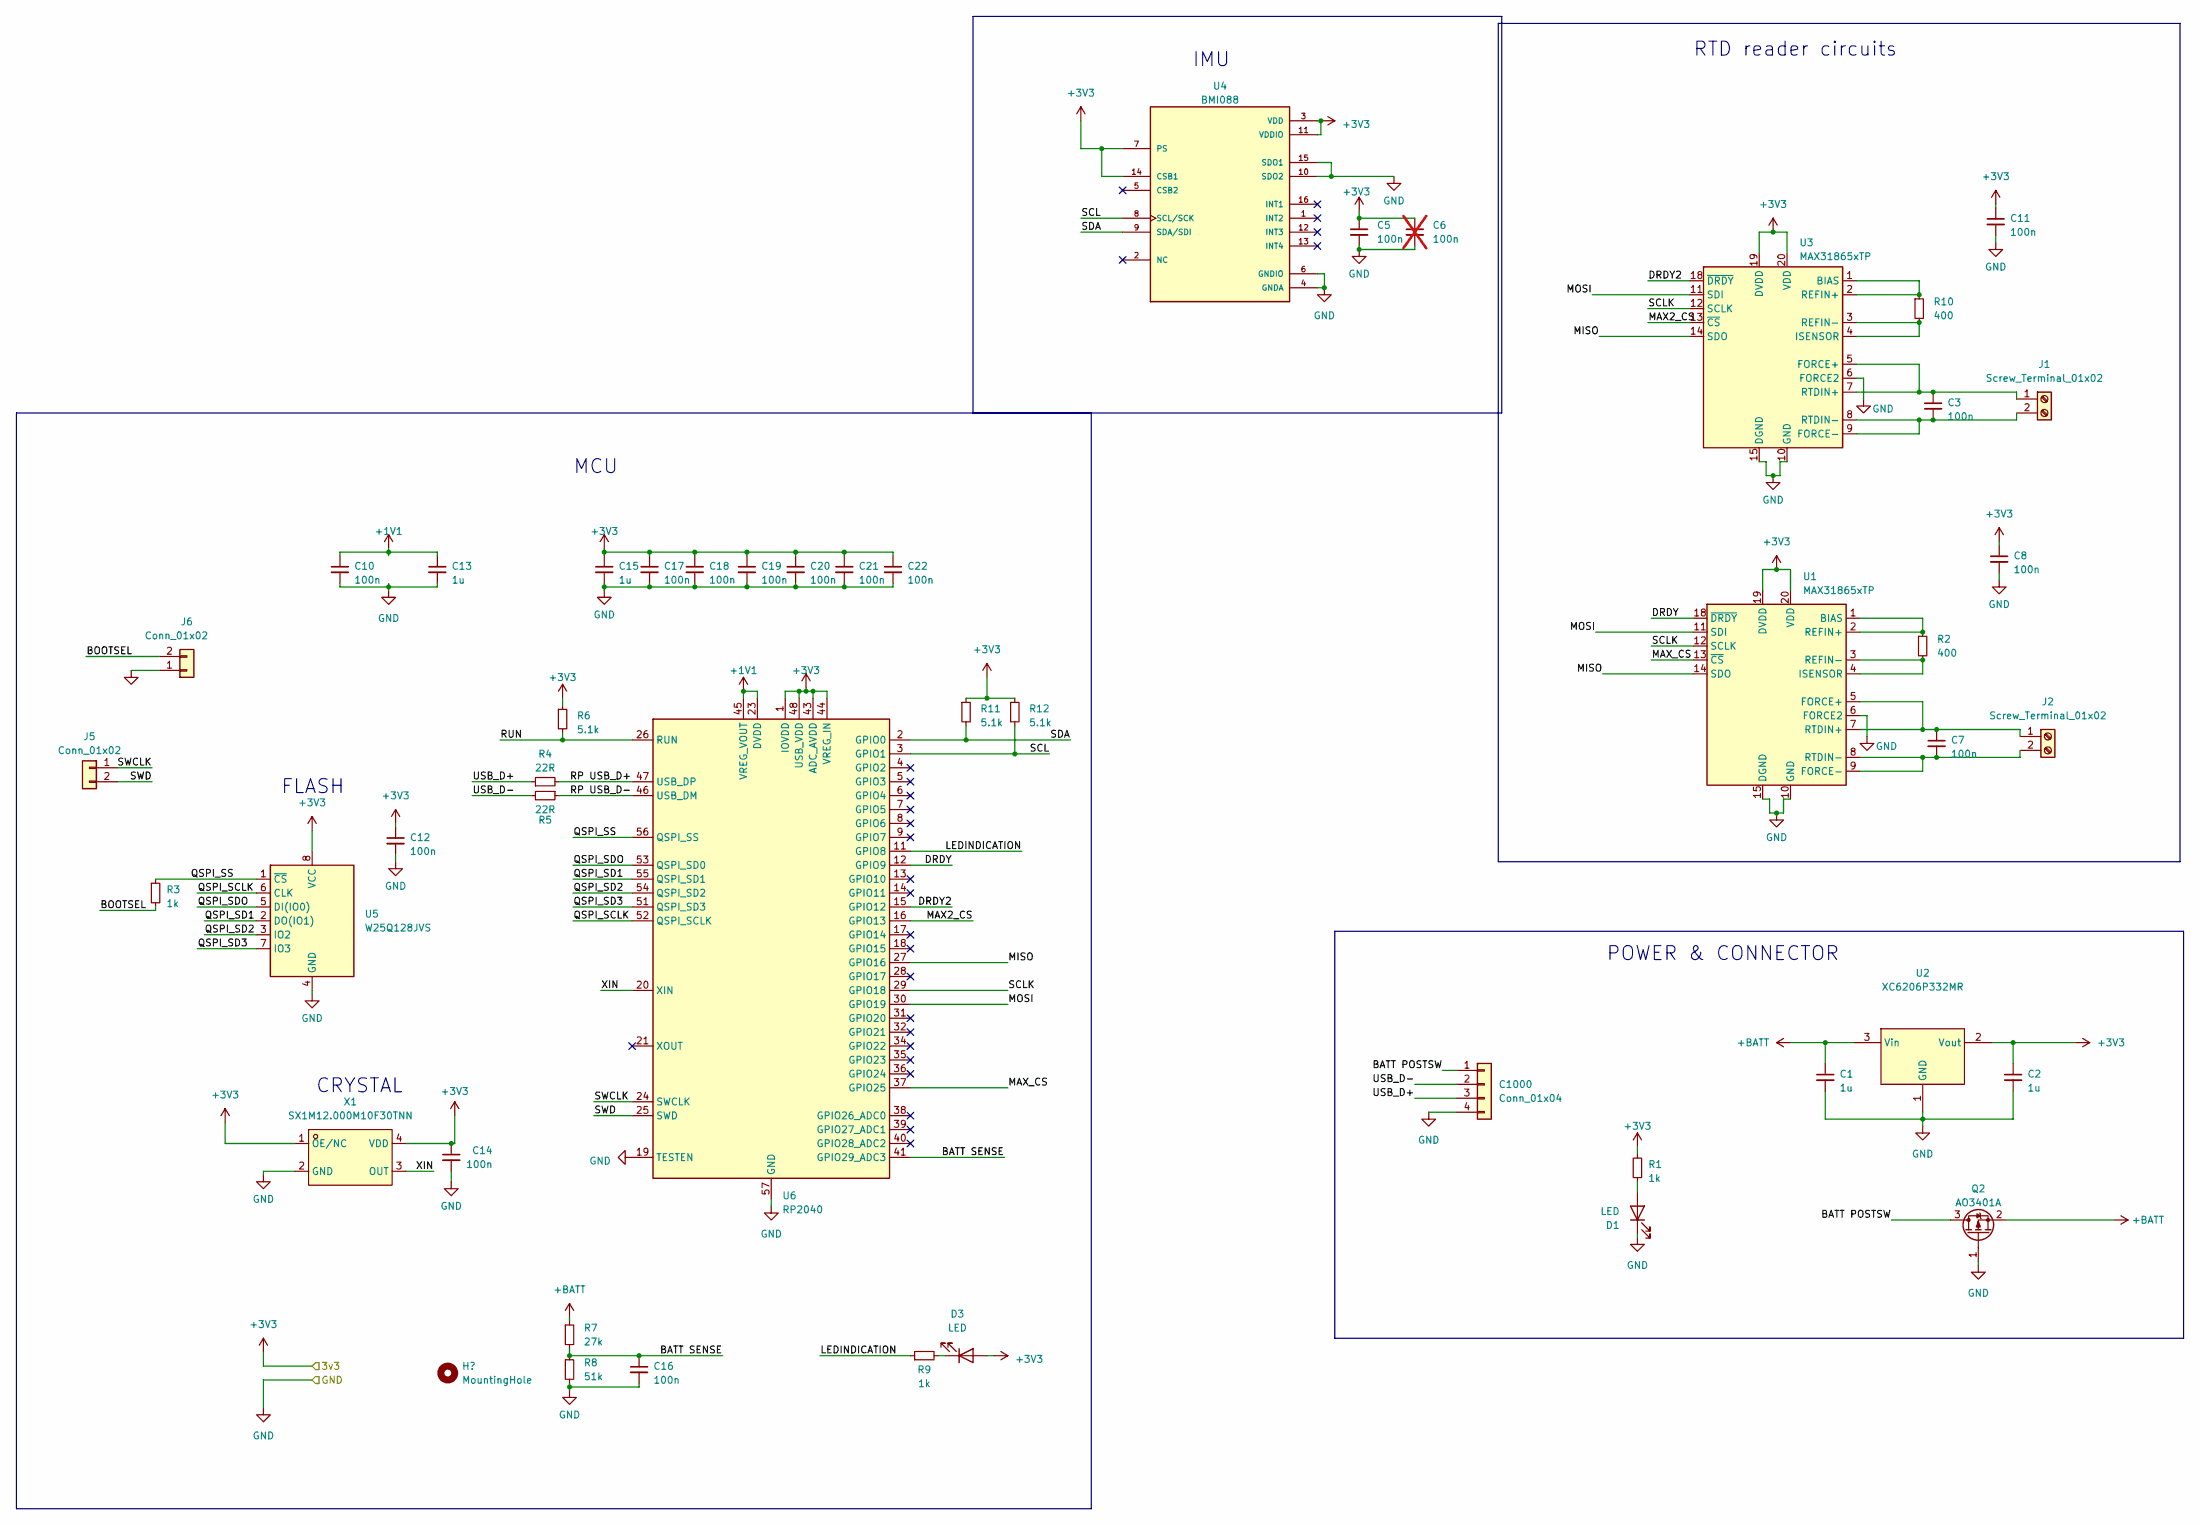
[picture p64: schematic it sure is getting ROUND in here.kicad_sch]

Parts:
C1, C2, C13, C15: 1u; C_0402_1005Metric; LCSC Part C52923
C3, C7, C8, C10, C11, C12, C14, C16, C17, C18, C19, C20, C21, C22: 100n; C_0402_1005Metric; LCSC Part C1525
C5: 100n; C_0603_1608Metric_Pad1.08x0.95mm_HandSolder; LCSC Part C1525
C6: 100n; C_0603_1608Metric_Pad1.08x0.95mm_HandSolder; LCSC Part C1525; not fitted
C1000: Conn_01x04; CONN-SMD_1.25-4PWB; LCSC Part C2905011
D1, D3: LED; LED_0603_1608Metric; LCSC Part C89811
J1, J2: Screw_Terminal_01x02; SolderJumper-2_P1.3mm_Open_Pad1.0x1.5mm
J5: Conn_01x02; SolderJumper-2_P1.3mm_Open_Pad1.0x1.5mm
J6: Conn_01x02; SolderJumper-2_P1.3mm_Open_RoundedPad1.0x1.5mm
Q2: AO3401A; SOT-23; LCSC Part C15127
R1, R3, R9: 1k; R_0402_1005Metric; LCSC Part C11702
R2, R10: 400; R_0402_1005Metric; LCSC Part C41042
R4, R5: 22R; R_0402_1005Metric; LCSC Part C25092
R6, R11, R12: 5.1k; R_0402_1005Metric; LCSC Part C25905
R7: 27k; R_0402_1005Metric; LCSC Part C25771
R8: 51k; R_0402_1005Metric; LCSC Part C25794
U1, U3: MAX31865xTP; TQFN-20-1EP_5x5mm_P0.65mm_EP3.25x3.25mm; LCSC Part C118474
U2: XC6206P332MR; SOT-23-3; LCSC Part C5446
U4: BMI088; LGA-16_L4.5-W3.0-P0.50-BL; LCSC Part C194919
U5: W25Q128JVS; SOIC-8_5.23x5.23mm_P1.27mm; LCSC Part C97521
U6: RP2040; QFN-56-1EP_7x7mm_P0.4mm_EP3.2x3.2mm; LCSC Part C2040
X1: SX1M12.000M10F30TNN; OSC-SMD_4P-L2.0-W1.6-BL; LCSC Part C2901608

Connections:
+1V1: C10.1, C13.1, U6.23 (DVDD), U6.45 (VREG_VOUT), U6.50 (DVDD)
+3V3: C2.1, C5.1, C6.1, C8.1, C11.1, C12.1, C14.1, C15.1, C17.1, C18.1, C19.1, C20.1, C21.1, C22.1, D3.2 (A), R1.2, R6.1, R11.1, R12.1, U1.19 (DVDD), U1.20 (VDD), U2.2 (Vout), U3.19 (DVDD), U3.20 (VDD), U4.3 (VDD), U4.7 (PS), U4.11 (VDDIO), U4.14 (CSB1), U5.8 (VCC), U6.1 (IOVDD), U6.10 (IOVDD), U6.22 (IOVDD), U6.33 (IOVDD), U6.42 (IOVDD), U6.43 (ADC_AVDD), U6.44 (VREG_IN), U6.48 (USB_VDD), U6.49 (IOVDD), X1.1 (OE/NC), X1.4 (VDD)
+BATT: C1.1, Q2.2 (S), R7.1, U2.3 (Vin)
/BATT POSTSW: C1000.1, Q2.3 (D)
/BATT SENSE: C16.1, R7.2, R8.1, U6.41 (GPIO29_ADC3)
/BOOTSEL: J6.2, R3.2
/DRDY: U1.18 (~DRDY), U6.12 (GPIO9)
/DRDY2: U3.18 (~DRDY), U6.15 (GPIO12)
/LEDINDICATION: R9.1, U6.11 (GPIO8)
/MAX2_CS: U3.13 (~CS), U6.16 (GPIO13)
/MAX_CS: U1.13 (~CS), U6.37 (GPIO25)
/MISO: U1.14 (SDO), U3.14 (SDO), U6.27 (GPIO16)
/MOSI: U1.11 (SDI), U3.11 (SDI), U6.30 (GPIO19)
/QSPI_SCLK: U5.6 (CLK), U6.52 (QSPI_SCLK)
/QSPI_SD1: U5.2 (DO(IO1)), U6.55 (QSPI_SD1)
/QSPI_SD2: U5.3 (IO2), U6.54 (QSPI_SD2)
/QSPI_SD3: U5.7 (IO3), U6.51 (QSPI_SD3)
/QSPI_SDO: U5.5 (DI(IO0)), U6.53 (QSPI_SD0)
/QSPI_SS: R3.1, U5.1 (~CS), U6.56 (QSPI_SS)
/RP USB_D+: R4.2, U6.47 (USB_DP)
/RP USB_D-: R5.1, U6.46 (USB_DM)
/RUN: R6.2, U6.26 (RUN)
/SCL: R12.2, U4.8 (SCL/SCK), U6.3 (GPIO1)
/SCLK: U1.12 (SCLK), U3.12 (SCLK), U6.29 (GPIO18)
/SDA: R11.2, U4.9 (SDA/SDI), U6.2 (GPIO0)
/SWCLK: J5.1, U6.24 (SWCLK)
/SWD: J5.2, U6.25 (SWD)
/USB_D+: C1000.3, R4.1
/USB_D-: C1000.2, R5.2
/XIN: U6.20 (XIN), X1.3 (OUT)
GND: C1.2, C2.2, C5.2, C6.2, C8.2, C10.2, C11.2, C12.2, C13.2, C14.2, C15.2, C16.2, C17.2, C18.2, C19.2, C20.2, C21.2, C22.2, C1000.4, D1.1 (K), J6.1, Q2.1 (G), R8.2, U1.6 (FORCE2), U1.10 (GND), U1.15 (DGND), U1.16 (GND), U1.21 (GND), U2.1 (GND), U3.6 (FORCE2), U3.10 (GND), U3.15 (DGND), U3.16 (GND), U3.21 (GND), U4.4 (GNDA), U4.6 (GNDIO), U4.10 (SDO2), U4.15 (SDO1), U5.4 (GND), U6.19 (TESTEN), U6.57 (GND), X1.2 (GND)
unnamed: D1.2 (A), R1.1
unnamed: D3.1 (K), R9.2
unnamed: C3.1, J1.1, U3.5 (FORCE+), U3.7 (RTDIN+)
unnamed: C3.2, J1.2, U3.8 (RTDIN-), U3.9 (FORCE-)
unnamed: C7.1, J2.1, U1.5 (FORCE+), U1.7 (RTDIN+)
unnamed: C7.2, J2.2, U1.8 (RTDIN-), U1.9 (FORCE-)
unnamed: R2.1, U1.1 (BIAS), U1.2 (REFIN+)
unnamed: R2.2, U1.3 (REFIN-), U1.4 (ISENSOR)
unnamed: R10.1, U3.1 (BIAS), U3.2 (REFIN+)
unnamed: R10.2, U3.3 (REFIN-), U3.4 (ISENSOR)

Notes on the sheet:
CRYSTAL
POWER & CONNECTOR
RTD reader circuits
FLASH
MCU
IMU

Board: 4 copper layers, 47 parts (16 on the bottom side), 41 nets, no tracks yet.
