prs2026/Lyra-flight-computer/Hardware/kicad/Lyra_flight_computer/lyrav3revised/recivier/recivier.kicad_pcb

## KiCad design Hardware/kicad/Lyra_flight_computer/lyrav3revised/recivier/recivier.kicad_pcb (2024-04-03)

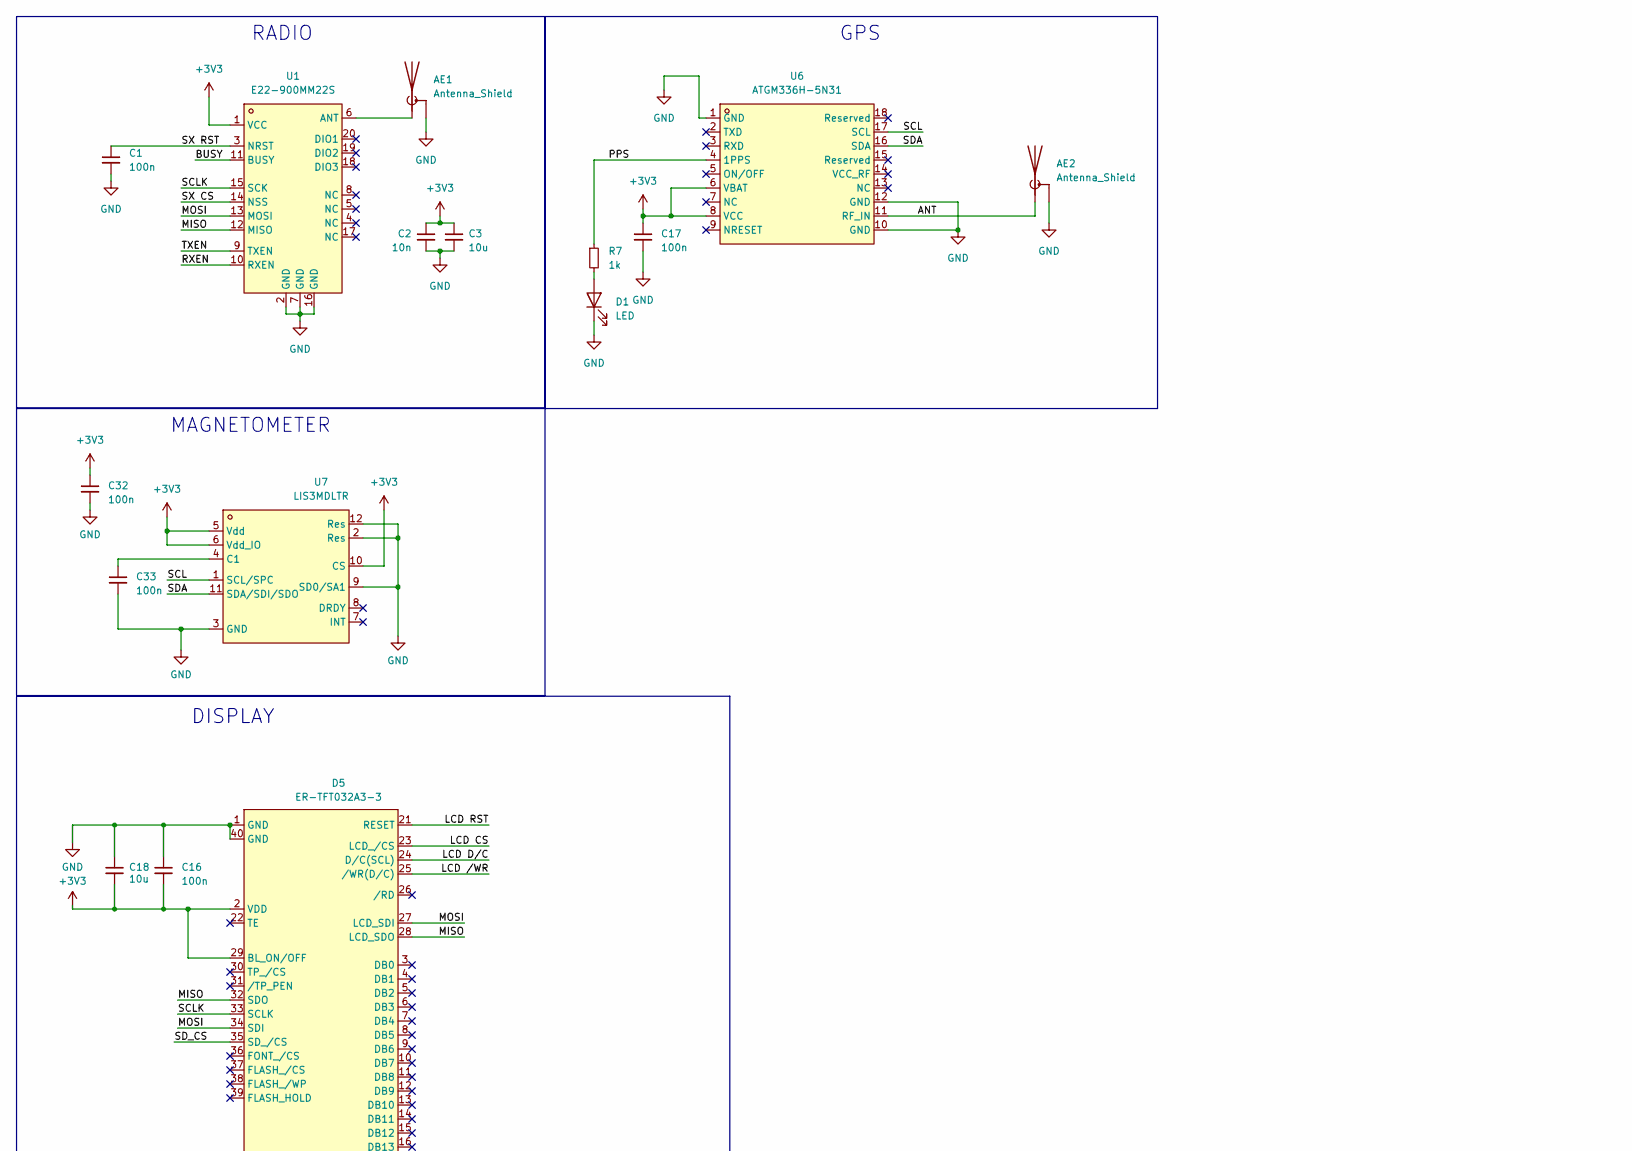
[picture p65: schematic recivier.kicad_sch, part in row 1, column 1]

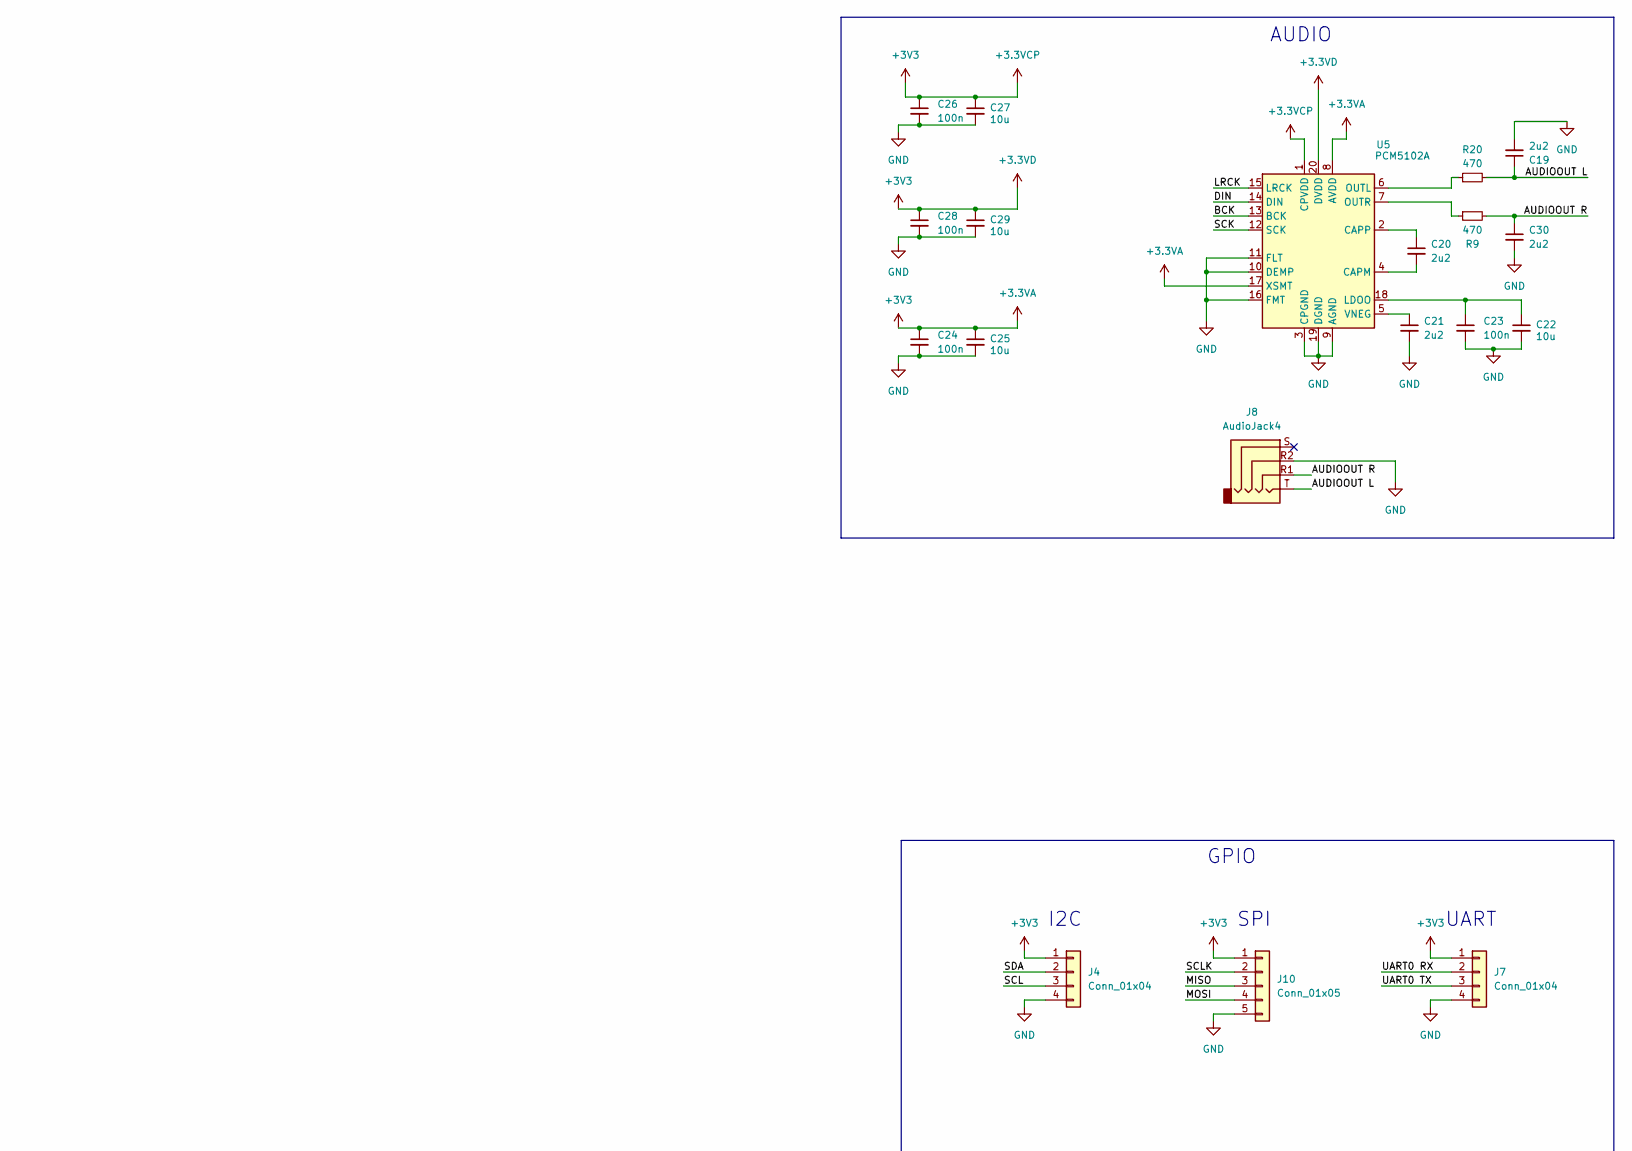
[picture p66: schematic recivier.kicad_sch, part in row 1, column 2]

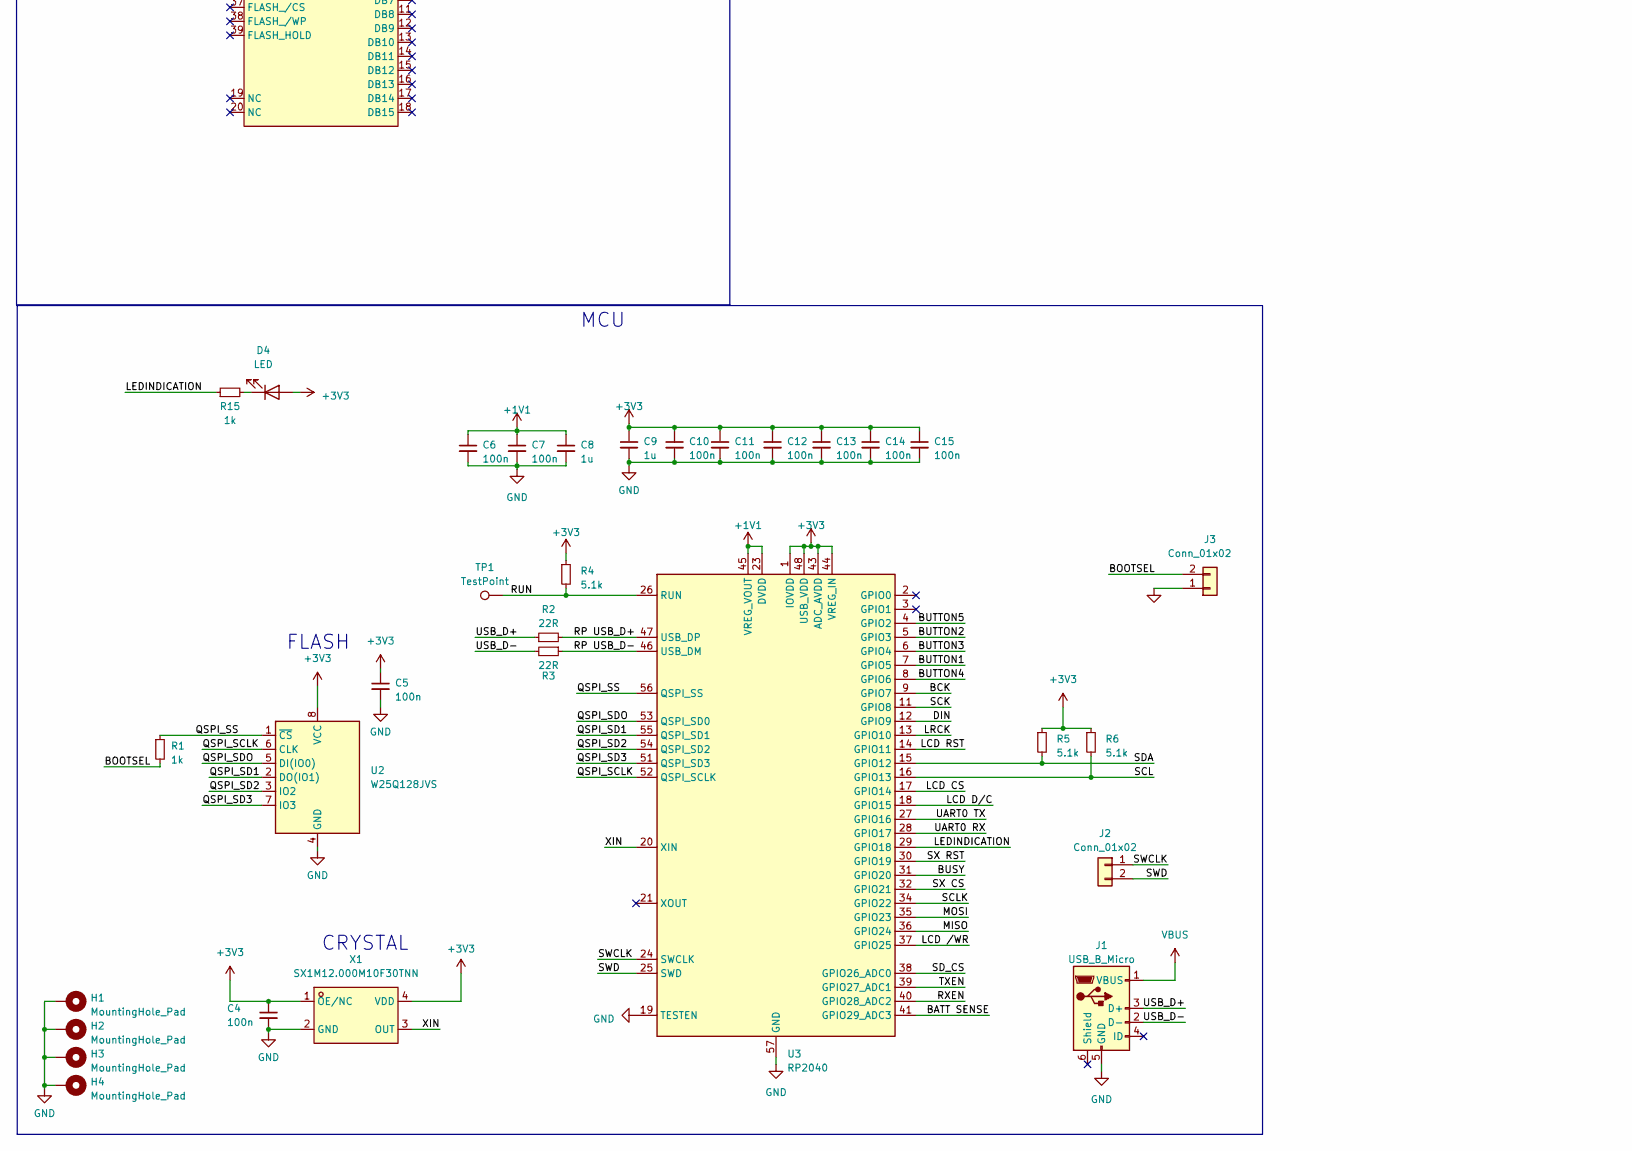
[picture p67: schematic recivier.kicad_sch, part in row 2, column 1]

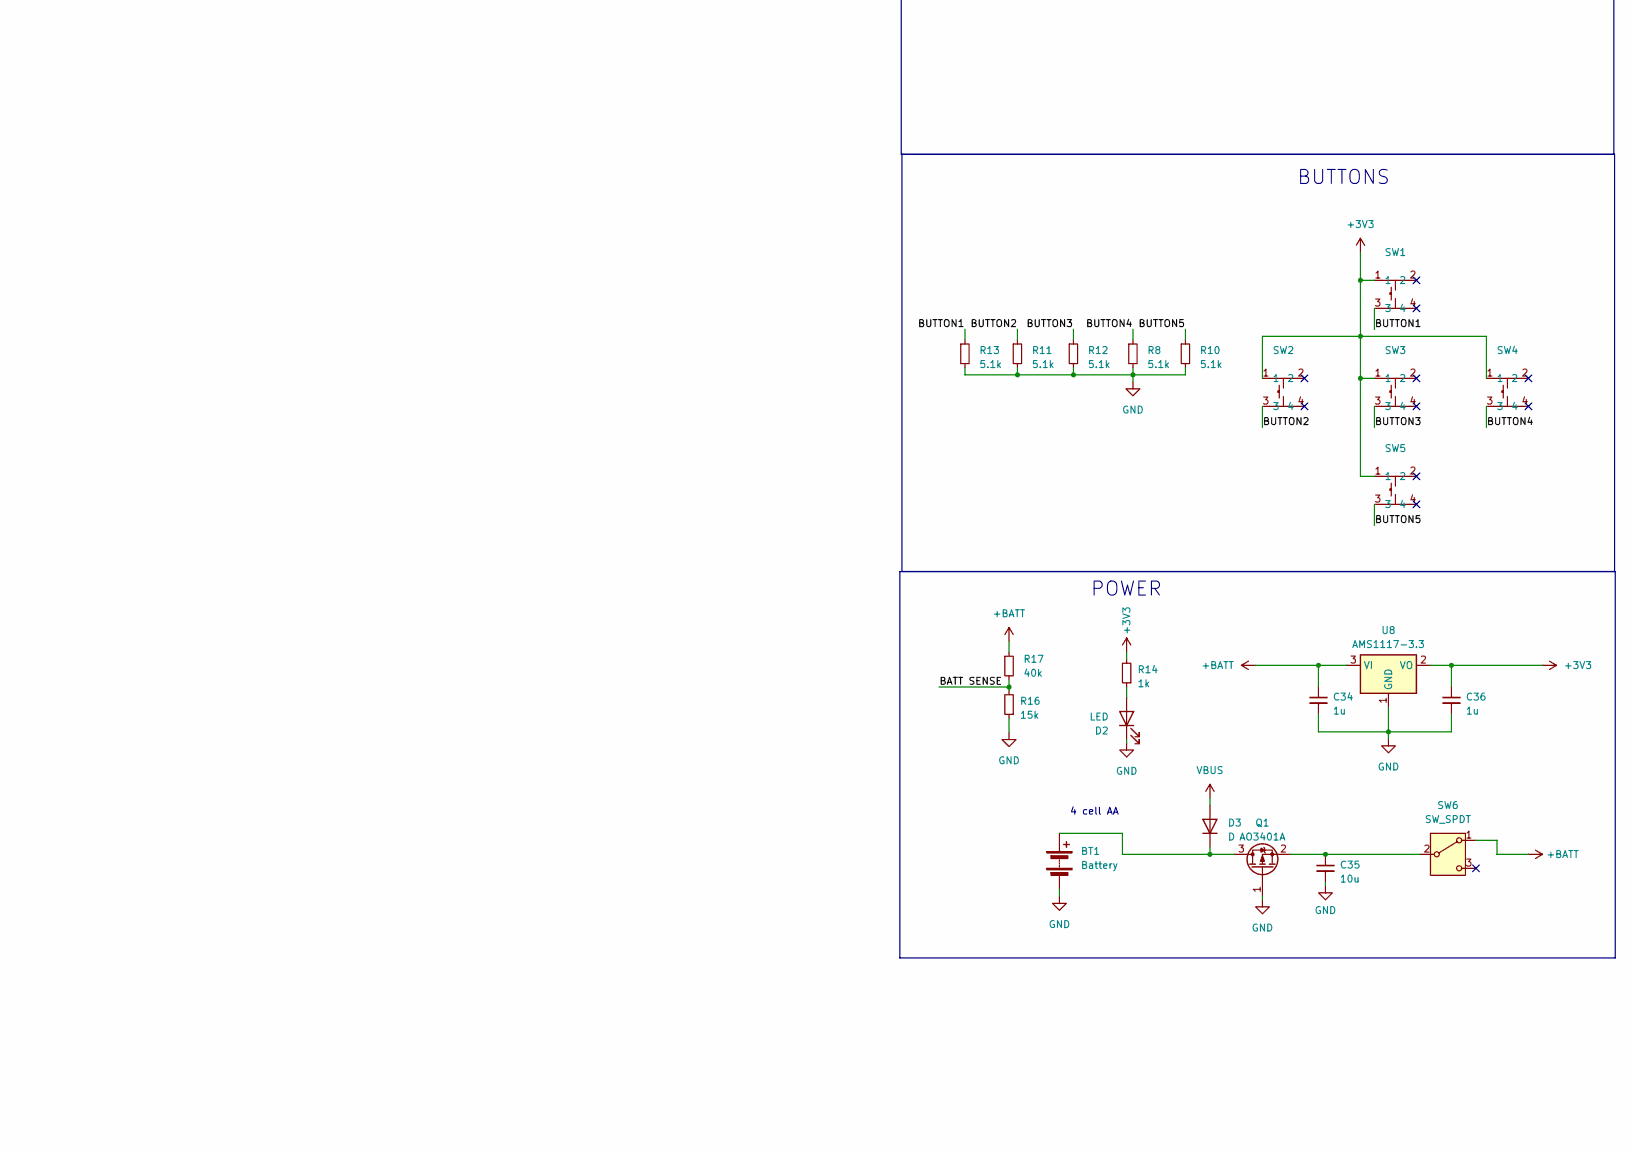
[picture p68: schematic recivier.kicad_sch, part in row 2, column 2]

Parts:
AE1: Antenna_Shield; CONN-SMD_KH-SMA-KE8-G; LCSC Part C530661
AE2: Antenna_Shield; ANT-SMD_1909763-1; LCSC Part C392444
BT1: Battery; 12BH349GR
C1, C4, C5, C6, C7, C10, C11, C12, C13, C14, C15, C16, C17, C23, C24, C26, C28, C32, C33: 100n; C_0402_1005Metric; LCSC Part C1525
C2: 10n; C_0402_1005Metric; LCSC Part C15195
C3, C18, C22, C25, C27, C29, C35: 10u; C_0603_1608Metric; LCSC Part C96446
C8, C9, C34, C36: 1u; C_0402_1005Metric; LCSC Part C52923
C19, C20, C21, C30: 2u2; C_0603_1608Metric; LCSC Part C23630
D1, D2, D4: LED; LED_0805_2012Metric; LCSC Part C2297
D3: D; D_SOD-123; LCSC Part C64898
D5: ER-TFT032A3-3; R-TFT032IPS-3.2
H1, H2, H3, H4: MountingHole_Pad; MountingHole_3.2mm_M3_DIN965_Pad
J1: USB_B_Micro; MICRO-USB-SMD_U254-051T-4BHJ25-F2S; LCSC Part C381143
J2: Conn_01x02; SolderJumper-2_P1.3mm_Open_Pad1.0x1.5mm
J3: Conn_01x02; SolderJumper-2_P1.3mm_Open_RoundedPad1.0x1.5mm
J4, J7: Conn_01x04; PinHeader_1x04_P2.54mm_Horizontal
J8: AudioJack4; AUDIO-SMD_PJ-320D; LCSC Part C521460
J10: Conn_01x05; PinHeader_1x05_P2.54mm_Horizontal
Q1: AO3401A; SOT-23; LCSC Part C15127
R1, R7, R14, R15: 1k; R_0402_1005Metric; LCSC Part C11702
R2, R3: 22R; R_0402_1005Metric; LCSC Part C25092
R4, R5, R6, R8, R10, R11, R12, R13: 5.1k; R_0402_1005Metric; LCSC Part C25905
R9, R20: 470; R_0402_1005Metric; LCSC Part C25117
R16: 15k; R_0402_1005Metric; LCSC Part C25756
R17: 40k; R_0402_1005Metric; LCSC Part C25086
SW1, SW2, SW3, SW4, SW5: K2-1102DP-L3SW-04; SW-TH_4P-L6.0-W6.0-P4.50-LS6.5; LCSC Part C493026
SW6: SW_SPDT; SW-TH_SK12D07VG4; LCSC Part C393937
TP1: TestPoint; TestPoint_Pad_1.0x1.0mm
U1: E22-900MM22S; WIRELM-SMD_E22-400MM22S
U2: W25Q128JVS; SOIC-8_5.23x5.23mm_P1.27mm; LCSC Part C97521
U3: RP2040; QFN-56-1EP_7x7mm_P0.4mm_EP3.2x3.2mm; LCSC Part C2040
U5: PCM5102A; TSSOP-20_4.4x6.5mm_P0.65mm; LCSC Part C107671
U6: ATGM336H-5N31; GPSM-SMD_ATGM336H-TR; LCSC Part C90770
U7: LIS3MDLTR; LGA-12_L2.0-W2.0-P0.50-BL; LCSC Part C478483
U8: AMS1117-3.3; SOT-223-3_TabPin2; LCSC Part C6186
X1: SX1M12.000M10F30TNN; OSC-SMD_4P-L2.0-W1.6-BL; LCSC Part C2901608

Connections:
+1V1: C6.1, C7.1, C8.1, U3.23 (DVDD), U3.45 (VREG_VOUT), U3.50 (DVDD)
+3.3VA: C2.1, C3.1, C4.1, C5.1, C9.1, C10.1, C11.1, C12.1, C13.1, C14.1, C15.1, C16.2, C17.1, C18.2, C24.1, C25.1, C26.1, C27.1, C28.1, C29.1, C32.1, C36.1, D4.2 (A), D5.2 (VDD), D5.29 (BL_ON/OFF), J4.1, J7.1, J10.1, R4.1, R5.1, R6.1, R14.2, SW1.1, SW2.1, SW3.1, SW4.1, SW5.1, U1.1 (VCC), U2.8 (VCC), U3.1 (IOVDD), U3.10 (IOVDD), U3.22 (IOVDD), U3.33 (IOVDD), U3.42 (IOVDD), U3.43 (ADC_AVDD), U3.44 (VREG_IN), U3.48 (USB_VDD), U3.49 (IOVDD), U5.1 (CPVDD), U5.8 (AVDD), U5.17 (XSMT), U5.20 (DVDD), U6.6 (VBAT), U6.8 (VCC), U7.5 (Vdd), U7.6 (Vdd_IO), U7.10 (CS), U8.2 (VO), X1.1 (OE/NC), X1.4 (VDD)
+BATT: C34.1, R17.1, SW6.1 (A), U8.3 (VI)
/ANT: AE2.1 (A), U6.11 (RF_IN)
/AUDIOOUT L: C19.1, J8.T, R20.2
/AUDIOOUT R: C30.1, J8.R1, R9.2
/BATT SENSE: R16.2, R17.2, U3.41 (GPIO29_ADC3)
/BCK: U3.9 (GPIO7), U5.13 (BCK)
/BOOTSEL: J3.2, R1.2
/BUSY: U1.11 (BUSY), U3.31 (GPIO20)
/BUTTON1: R13.1, SW1.3, U3.7 (GPIO5)
/BUTTON2: R11.1, SW2.3, U3.5 (GPIO3)
/BUTTON3: R12.1, SW3.3, U3.6 (GPIO4)
/BUTTON4: R8.1, SW4.3, U3.8 (GPIO6)
/BUTTON5: R10.1, SW5.3, U3.4 (GPIO2)
/DIN: U3.12 (GPIO9), U5.14 (DIN)
/LCD CS: D5.23 (LCD_/CS), U3.17 (GPIO14)
/LCD D/C: D5.24 (D/C(SCL)), U3.18 (GPIO15)
/LCD RST: D5.21 (RESET), U3.14 (GPIO11)
/LCD /WR: D5.25 (/WR(D/C)), U3.37 (GPIO25)
/LEDINDICATION: R15.1, U3.29 (GPIO18)
/LRCK: U3.13 (GPIO10), U5.15 (LRCK)
/MISO: D5.28 (LCD_SDO), D5.32 (SDO), J10.3, U1.12 (MISO), U3.36 (GPIO24)
/MOSI: D5.27 (LCD_SDI), D5.34 (SDI), J10.4, U1.13 (MOSI), U3.35 (GPIO23)
/PPS: R7.1, U6.4 (1PPS)
/QSPI_SCLK: U2.6 (CLK), U3.52 (QSPI_SCLK)
/QSPI_SD1: U2.2 (DO(IO1)), U3.55 (QSPI_SD1)
/QSPI_SD2: U2.3 (IO2), U3.54 (QSPI_SD2)
/QSPI_SD3: U2.7 (IO3), U3.51 (QSPI_SD3)
/QSPI_SDO: U2.5 (DI(IO0)), U3.53 (QSPI_SD0)
/QSPI_SS: R1.1, U2.1 (~CS), U3.56 (QSPI_SS)
/RP USB_D+: R2.2, U3.47 (USB_DP)
/RP USB_D-: R3.1, U3.46 (USB_DM)
/RUN: R4.2, TP1.1, U3.26 (RUN)
/RXEN: U1.10 (RXEN), U3.40 (GPIO28_ADC2)
/SCK: U3.11 (GPIO8), U5.12 (SCK)
/SCL: J4.3, R6.2, U3.16 (GPIO13), U6.17 (SCL), U7.1 (SCL/SPC)
/SCLK: D5.33 (SCLK), J10.2, U1.15 (SCK), U3.34 (GPIO22)
/SDA: J4.2, R5.2, U3.15 (GPIO12), U6.16 (SDA), U7.11 (SDA/SDI/SDO)
/SD_CS: D5.35 (SD_/CS), U3.38 (GPIO26_ADC0)
/SWCLK: J2.1, U3.24 (SWCLK)
/SWD: J2.2, U3.25 (SWD)
/SX CS: U1.14 (NSS), U3.32 (GPIO21)
/SX RST: C1.1, U1.3 (NRST), U3.30 (GPIO19)
/TXEN: U1.9 (TXEN), U3.39 (GPIO27_ADC1)
/UART0 RX: J7.2, U3.28 (GPIO17)
/UART0 TX: J7.3, U3.27 (GPIO16)
/USB_D+: J1.3 (D+), R2.1
/USB_D-: J1.2 (D-), R3.2
/XIN: U3.20 (XIN), X1.3 (OUT)
GND: AE1.2 (Shield), AE2.2 (Shield), BT1.2 (-), C1.2, C2.2, C3.2, C4.2, C5.2, C6.2, C7.2, C8.2, C9.2, C10.2, C11.2, C12.2, C13.2, C14.2, C15.2, C16.1, C17.2, C18.1, C19.2, C21.2, C22.2, C23.2, C24.2, C25.2, C26.2, C27.2, C28.2, C29.2, C30.2, C32.2, C33.2, C34.2, C35.2, C36.2, D1.1 (K), D2.1 (K), D5.1 (GND), D5.40 (GND), H1.1, H2.1, H3.1, H4.1, J1.5 (GND), J3.1, J4.4, J7.4, J8.R2, J10.5, Q1.1 (G), R8.2, R10.2, R11.2, R12.2, R13.2, R16.1, U1.2 (GND), U1.7 (GND), U1.16 (GND), U2.4 (GND), U3.19 (TESTEN), U3.57 (GND), U5.3 (CPGND), U5.9 (AGND), U5.10 (DEMP), U5.11 (FLT), U5.16 (FMT), U5.19 (DGND), U6.1 (GND), U6.10 (GND), U6.12 (GND), U7.2 (Res), U7.3 (GND), U7.9 (SD0/SA1), U7.12 (Res), U8.1 (GND), X1.2 (GND)
unnamed: AE1.1 (A), U1.6 (ANT)
unnamed: BT1.1 (+), D3.1 (K), Q1.3 (D)
unnamed: D1.2 (A), R7.2
unnamed: D2.2 (A), R14.1
unnamed: D4.1 (K), R15.2
unnamed: C35.1, Q1.2 (S), SW6.2 (B)
unnamed: C20.2, U5.4 (CAPM)
unnamed: C20.1, U5.2 (CAPP)
unnamed: C22.1, C23.1, U5.18 (LDOO)
unnamed: R20.1, U5.6 (OUTL)
unnamed: R9.1, U5.7 (OUTR)
unnamed: C21.1, U5.5 (VNEG)
unnamed: C33.1, U7.4 (C1)
VBUS: D3.2 (A), J1.1 (VBUS)

Notes on the sheet:
FLASH
4 cell AA
I2C
AUDIO
MAGNETOMETER
CRYSTAL
POWER
BUTTONS
GPS
RADIO
GPIO
DISPLAY
UART
SPI
MCU

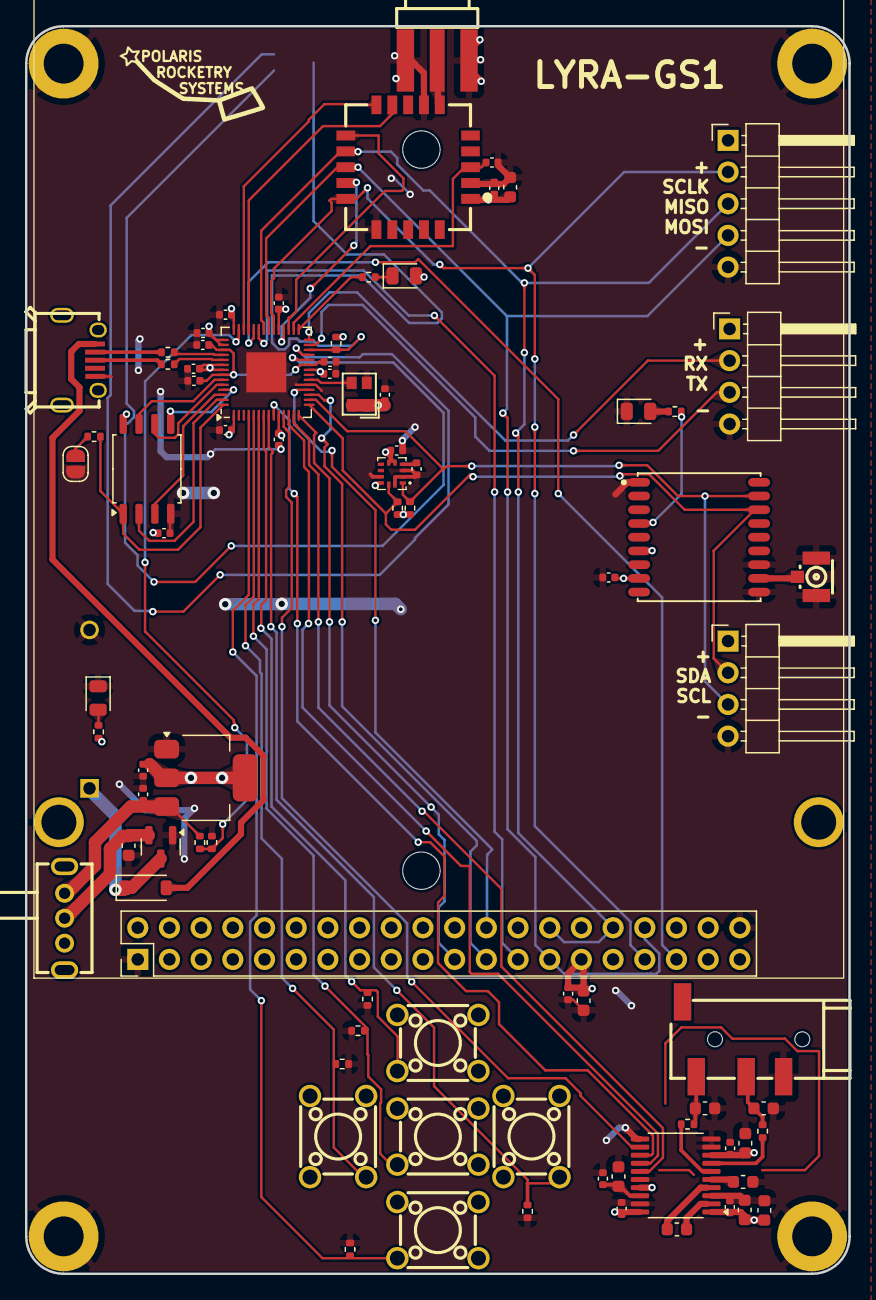
[picture p69: board recivier.kicad_pcb from above]

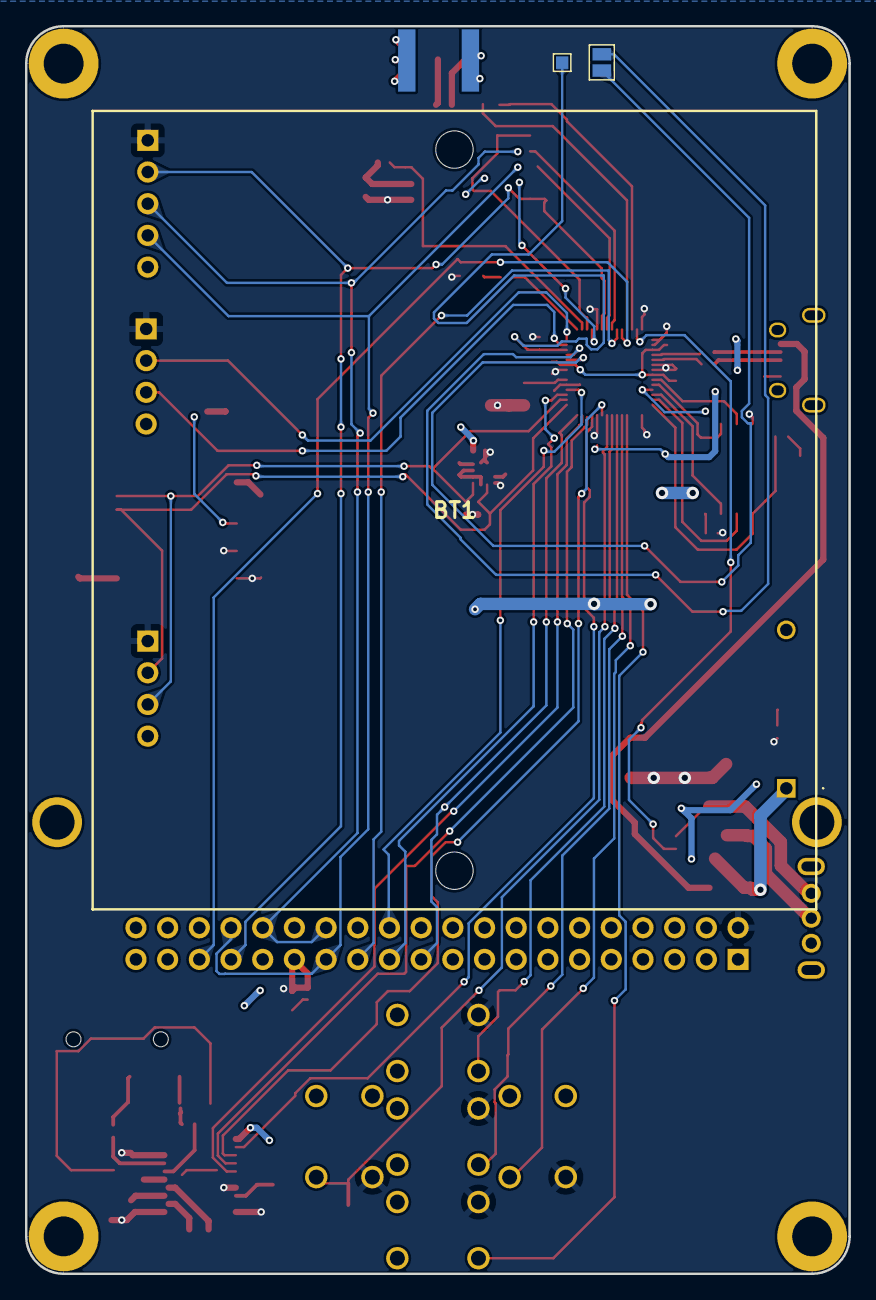
[picture p70: board recivier.kicad_pcb from below]

Board: 2 copper layers, 66.0 x 100.0 mm, 88 parts (3 on the bottom side), 65 nets.
