prs2026/Lyra-flight-computer/Hardware/kicad/screw switch/screw switch.kicad_pcb

## KiCad design Hardware/kicad/screw switch/screw switch.kicad_pcb (2024-04-09)

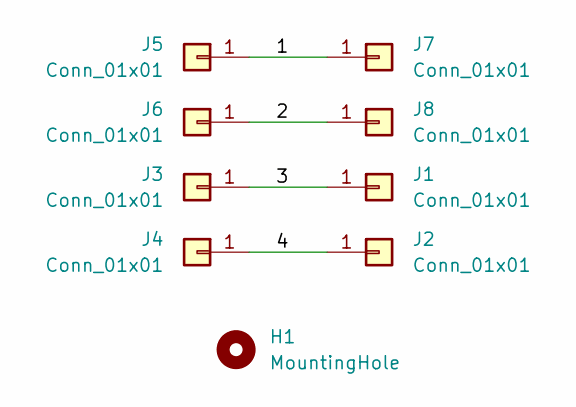
[picture p71: schematic screw switch.kicad_sch]

Parts:
H1: MountingHole; MountingHole_2.2mm_M2_DIN965
J1, J2, J7, J8: Conn_01x01; screwswitchpad
J3, J4, J5, J6: Conn_01x01; PinHeader_1x01_P2.54mm_Vertical

Connections:
/1: J5.1, J7.1
/2: J6.1, J8.1
/3: J1.1, J3.1
/4: J2.1, J4.1

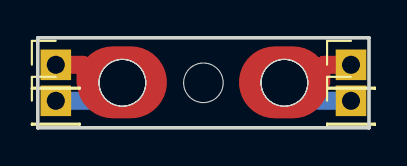
[picture p72: board screw switch.kicad_pcb from above]

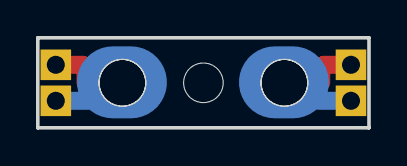
[picture p73: board screw switch.kicad_pcb from below]

Board: 2 copper layers, 18.4 x 5.0 mm, 9 parts (2 on the bottom side), 4 nets.
