prs2026/Lyra-flight-computer/Hardware/kicad/magswitch/magswitch/magswitch.kicad_pcb

## KiCad design Hardware/kicad/magswitch/magswitch/magswitch.kicad_pcb (2024-04-02, an earlier design)

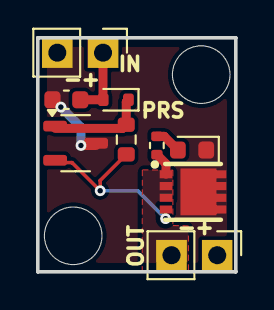
[picture p74: board magswitch.kicad_pcb from above]

Board: 2 copper layers, 11.0 x 13.0 mm, 11 parts (0 on the bottom side), 6 nets.

Parts:
C1: 10u; C_0603_1608Metric
D1: LED; LED_0603_1608Metric
D3: D_Schottky; D_SOD-523
H1, H2: MountingHole; MountingHole_3.2mm_M3
J1, J3: Conn_01x02; PinHeader_1x02_P2.54mm_Vertical
Q1: AON7508; PQFN-8_L3.0-W3.0-P0.65-LS3.2-BL
R1: 10k; R_0603_1608Metric
R3: 10k; R_0402_1005Metric
U1: SK1816G-AE3-R; SOT-23-3

Connections:
+BATT: C1.1, D3.2 (A), J1.1, J3.1
/SENSE OUT: Q1.4 (G), R1.2, U1.2 (VOUT)
/SWITCH: J1.2, Q1.1 (S), Q1.2 (S), Q1.3 (S), R3.2
GND: C1.2, D1.1 (K), J3.2, Q1.5 (D), Q1.6 (D), Q1.7 (D), Q1.8 (D), U1.3 (GND)
unnamed: D1.2 (A), R3.1
unnamed: D3.1 (K), R1.1, U1.1 (VIN)
