prs2026/Lyra-flight-computer/Hardware/kicad/Lyra_flight_computer/Lyra v2/Lyra V2/Lyra V2.kicad_pcb

## KiCad design Hardware/kicad/Lyra_flight_computer/Lyra v2/Lyra V2/Lyra V2.kicad_pcb (2023-11-15, an earlier design)

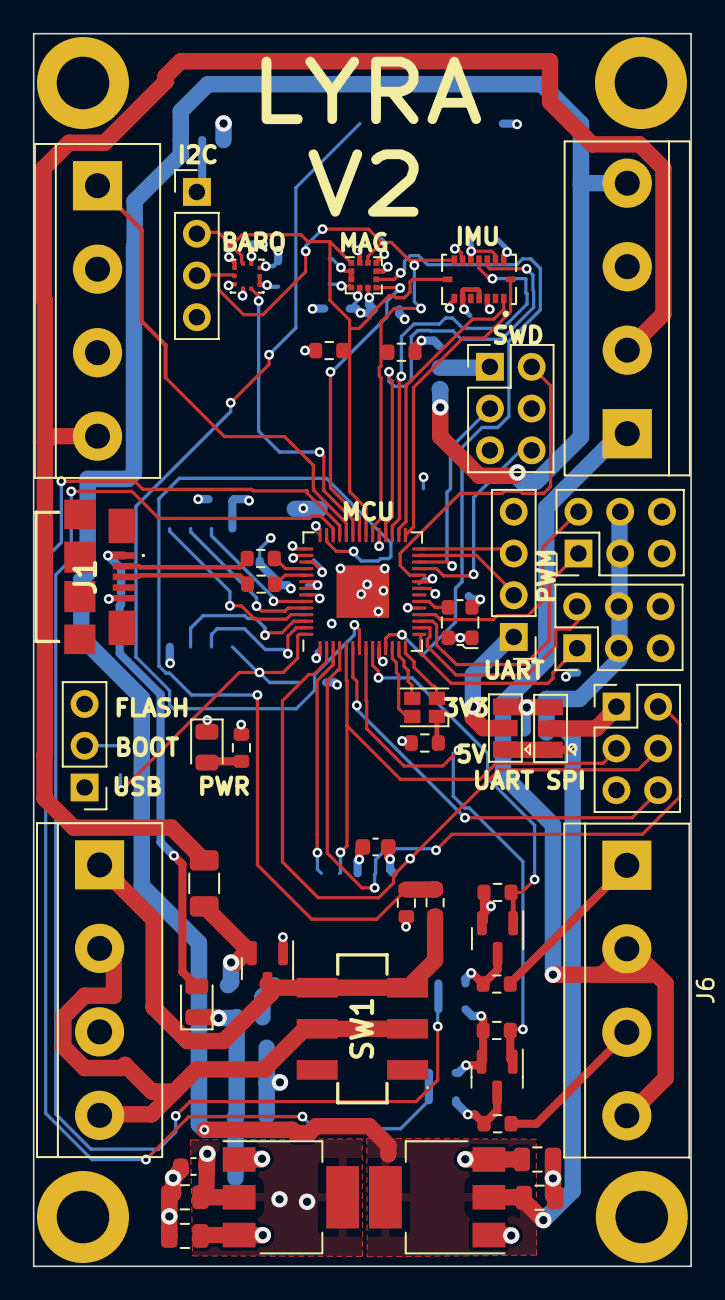
[picture p75: board Lyra V2.kicad_pcb from above]

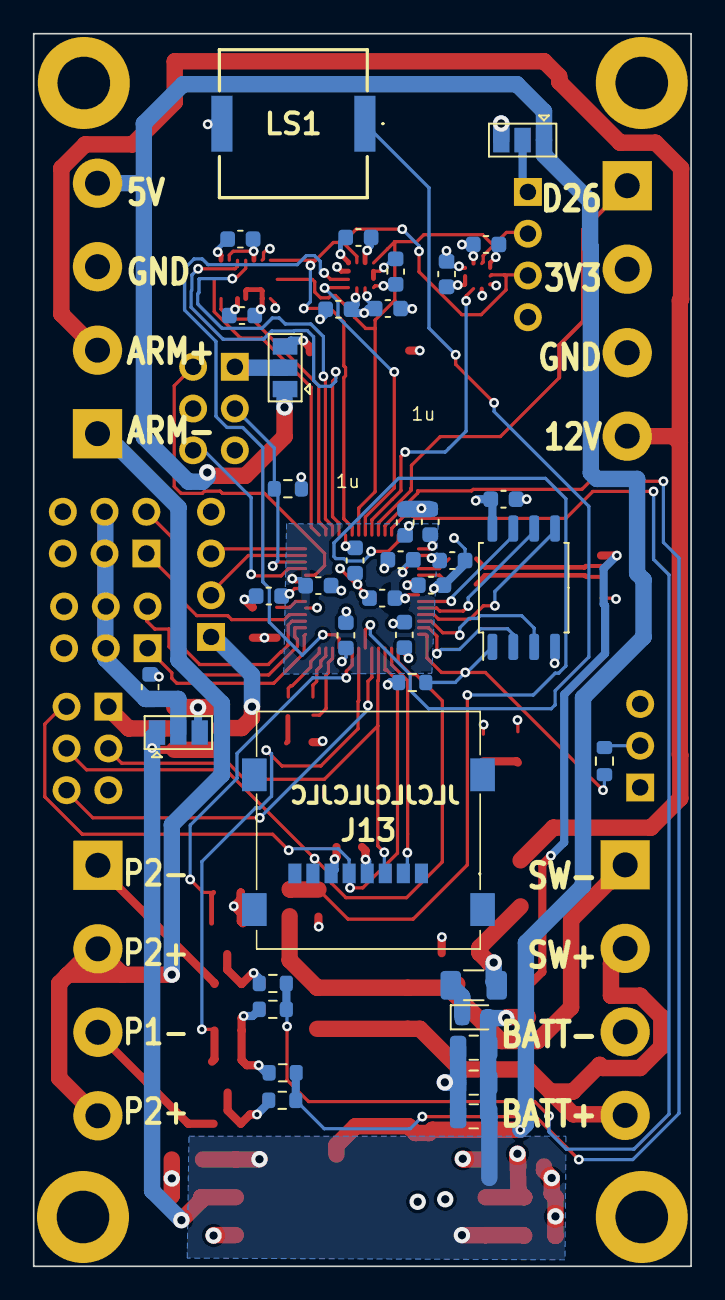
[picture p76: board Lyra V2.kicad_pcb from below]

Board: 4 copper layers, 40.0 x 75.0 mm, 90 parts (39 on the bottom side), 69 nets.

Parts:
C1, C4, C5, C6: 10u; C_0805_2012Metric
C2, C8: 22u; C_0805_2012Metric
C3, C9, C10, C14, C20, C21: 1u; C_0603_1608Metric
C7: 1u; C_0805_2012Metric
C11, C12, C13, C15, C16, C17, C18, C19, C22, C23, C24, C25, C27, C29, C30: 100n; C_0603_1608Metric
C26, C28: 100nf; C_0603_1608Metric
D1: D_Small; D_0805_2012Metric
D2: LED; LED_0805_2012Metric
D3: CLV1L-FKB; LED_Cree-PLCC4_2x2mm_CW
F1: 2a; Fuse_1206_3216Metric
F2: 200ma; Fuse_1206_3216Metric
FB1: FerriteBead_Small; D_0603_1608Metric
H1, H2, H3, H4: MountingHole_Pad; MountingHole_3.2mm_M3_DIN965_Pad
J1: USB_B_Micro; 101181920001LF
J2, J3, J5, J6: Screw_Terminal_01x04; TerminalBlock_bornier-4_P5.08mm
J4, J7, J8, J9: Conn_02x03_Odd_Even; PinHeader_2x03_P2.54mm_Vertical
J10, J11: Conn_01x04; PinHeader_1x04_P2.54mm_Vertical
J12: Conn_01x03; PinHeader_1x03_P2.54mm_Vertical
J13: MEM2067-02-180-00-A; MEM20670218000A
JP1, JP2, JP3, JP4, JP5: SolderJumper_3_Open; SolderJumper-3_P1.3mm_Open_Pad1.0x1.5mm
LS1: PKMCS0909E4000-R1; PKMCS0909E4000R1
Q1: AO3401A; SOT-23
Q2, Q3: BSS138; SOT-23
R1, R13: 1k; R_0603_1608Metric
R2, R3: 470R; R_0603_1608Metric
R4, R5: 10R; R_0603_1608Metric
R6, R8, R10: 20k; R_0603_1608Metric
R7, R9, R11: 6k; R_0603_1608Metric
R12: R_Small; R_0603_1608Metric
R14: DNF; R_0603_1608Metric
R15, R16: 27R; R_0603_1608Metric
R17, R18: 2k2; R_0603_1608Metric
R19: 10k; R_0603_1608Metric
SW1: SW_Push_DPDT; JS202011SCQN
U1: AZ1117-3.3; SOT-223-3_TabPin2
U2: AZ1117-5.0; SOT-223-3_TabPin2
U3: LIS3MDL; LGA-12_2x2mm_P0.5mm
U4: BMP390L; XDCR_BMP390L
U5: W25Q128JVS; SOIC-8_5.23x5.23mm_P1.27mm
U6: RP2040; QFN-56-1EP_7x7mm_P0.4mm_EP3.2x3.2mm
U7: BMI088; PQFN50P450X300X100-16N
X1: ECS-2520MV-xxx-xx; Oscillator_SMD_ECS_2520MV-xxx-xx-4Pin_2.5x2.0mm

Connections:
+1V1: C15.1, C17.1, C20.1, U6.23 (DVDD), U6.45 (VREG_VOUT), U6.50 (DVDD)
+3V3: C2.1, C3.1, C10.1, C11.1, C13.1, C14.2, C16.1, C18.1, C19.1, C21.1, C22.1, C23.1, C24.1, C25.1, C26.1, C27.1, C28.1, C29.1, C30.1, J2.2, J13.P4 (VDD), JP1.3 (B), JP2.3 (B), JP3.3 (B), JP4.3 (B), JP5.3 (B), R1.2, R12.2, R14.1, R17.1, R18.1, R19.1, U1.2 (VO), U3.5 (Vdd), U3.6 (Vdd_IO), U3.10 (~CS), U4.1 (VDDIO), U4.6 (~CS), U4.10 (VDD), U5.8 (VCC), U6.1 (IOVDD), U6.10 (IOVDD), U6.22 (IOVDD), U6.33 (IOVDD), U6.42 (IOVDD), U6.43 (ADC_AVDD), U6.44 (VREG_IN), U6.48 (USB_VDD), U6.49 (IOVDD), U7.3 (VDD), U7.7 (PS), U7.11 (VDDIO), U7.14 (CSB1), X1.1 (Tri-State), X1.4 (VDD)
+5V: C8.1, J5.4, JP1.1 (A), JP2.1 (A), JP3.1 (A), JP4.1 (A), JP5.1 (A), U2.2 (VO)
+12P: F1.2, J2.4, J5.2
+12V: J3.1, Q1.3 (D), R10.1, SW1.3 (C), SW1.4 (A)
+12VA: C1.1, C4.1, C5.1, C6.1, C7.1, D1.1 (K), FB1.2, U1.3 (VI), U2.3 (VI)
+BATT: J3.2, J3.4, SW1.2 (B), SW1.5 (B)
/ACCEL INT1: U6.29 (GPIO18), U7.16 (INT1)
/ACCEL INT2: U6.30 (GPIO19), U7.1 (INT2)
/BARO INT: U4.7 (INT/DNC), U6.37 (GPIO25)
/BATT SENSE: R10.2, R11.1, U6.41 (GPIO29_ADC3)
/BOOTSEL: J12.2, R13.2
/BRKOUT CS: J4.6, U6.6 (GPIO4)
/BUZZER: LS1.1 (+), U6.7 (GPIO5)
/GPIO26: J2.1, U6.38 (GPIO26_ADC0)
/GYRO INT3: U6.31 (GPIO20), U7.12 (INT3)
/GYRO INT4: U6.32 (GPIO21), U7.13 (INT4)
/I2C1 SCL: J10.2, R17.2, U3.1 (SCL/SPC), U4.2 (SCK/SCL), U6.35 (GPIO23), U7.8 (SCL/SCK)
/I2C1 SDA: J10.3, R18.2, U3.11 (SDA/SDI/SDO), U4.4 (SDI/SDO/SDA), U6.34 (GPIO22), U7.9 (SDA/SDI)
/I2C PWR: J10.1, JP2.2 (C)
/LEDBLUE: D3.4 (BK), U6.14 (GPIO11)
/LEDGREEN: D3.3 (GK), U6.13 (GPIO10)
/LEDRED: D3.2 (RK), U6.12 (GPIO9)
/MAG DRDY: U3.8 (DRDY), U6.11 (GPIO8)
/MAG INT: U3.7 (INT), U6.36 (GPIO24)
/P1 CONT: R6.2, R7.1, U6.40 (GPIO28_ADC2)
/P1 EN: Q3.1 (G), R3.2, U6.8 (GPIO6)
/P1-: J6.3, R5.1
/P2 CONT: R8.2, R9.1, U6.39 (GPIO27_ADC1)
/P2 EN: Q2.1 (G), R2.2, U6.9 (GPIO7)
/P2-: J6.1, R4.1
/PYRO PWR: J5.1, J6.2, J6.4
/QSPI_SCLK: U5.6 (CLK), U6.52 (QSPI_SCLK)
/QSPI_SD1: U5.2 (DO(IO1)), U6.55 (QSPI_SD1)
/QSPI_SD2: U5.3 (IO2), U6.54 (QSPI_SD2)
/QSPI_SD3: U5.7 (IO3), U6.51 (QSPI_SD3)
/QSPI_SDO: U5.5 (DI(IO0)), U6.53 (QSPI_SD0)
/QSPI_SS: R13.1, R14.2, U5.1 (~CS), U6.56 (QSPI_SS)
/RP USB_D+: R15.2, U6.47 (USB_DP)
/RP USB_D-: R16.1, U6.46 (USB_DM)
/RUN: J7.3, R19.2, U6.26 (RUN)
/SD CS: J13.P2 (CD/DAT3), U6.3 (GPIO1)
/SERVO1: J9.1, U6.15 (GPIO12)
/SERVO2: J9.2, U6.16 (GPIO13)
/SERVO3: J8.1, U6.17 (GPIO14)
/SERVO4: J8.2, U6.18 (GPIO15)
/SERVO PWR: C9.1, J8.3, J8.4, J9.3, J9.4, JP1.2 (C)
/SPI0 MISO: J4.4, J13.P7 (DAT0), U6.2 (GPIO0)
/SPI0 MOSI: J4.3, J13.P3 (CMD), U6.5 (GPIO3)
/SPI0 SCLK: J4.2, J13.P5 (CLK), U6.4 (GPIO2)
/SPI PWR: J4.1, JP3.2 (C)
/SWCLK: J7.2, U6.24 (SWCLK)
/SWD: J7.6, U6.25 (SWD)
/SWD PWR: J7.1, JP5.2 (C)
/UART0 RX: J11.3, U6.28 (GPIO17)
/UART0 TX: J11.2, U6.27 (GPIO16)
/UART PWR: J11.1, JP4.2 (C)
/USB_D+: J1.3 (D+), R15.1
/USB_D-: J1.2 (D-), R16.2
/XIN: U6.20 (XIN), X1.3 (OUT)
GND: C1.2, C2.2, C3.2, C4.2, C5.2, C6.2, C7.2, C8.2, C9.2, C10.2, C11.2, C12.2, C13.2, C14.1, C15.2, C16.2, C17.2, C18.2, C19.2, C20.2, C21.2, C22.2, C23.2, C24.2, C25.2, C26.2, C27.2, C28.2, C29.2, C30.2, D2.1 (K), H1.1, H2.1, H3.1, H4.1, J1.5 (GND), J2.3, J3.3, J4.5, J5.3, J7.4, J7.5, J8.5, J8.6, J9.5, J9.6, J10.4, J11.4, J12.1, J13.P6 (VSS), LS1.2 (-), Q1.1 (G), Q2.2 (S), Q3.2 (S), R2.1, R3.1, R7.2, R9.2, R11.2, U1.1 (GND), U2.1 (GND), U3.2 (GND), U3.3 (GND), U3.9 (SDO/SA1), U3.12 (GND), U4.3 (VSS/GND), U4.5 (SDO/DNC/SA0), U4.8 (VSS/GND__1), U4.9 (VSS/GND__2), U5.4 (GND), U6.19 (TESTEN), U6.57 (GND), U7.4 (GNDA), U7.6 (GNDIO), U7.10 (SDO2), U7.15 (SDO1), X1.2 (GND)
unnamed: D2.2 (A), R1.1
unnamed: D3.1 (A), R12.1
unnamed: F2.2, FB1.1
unnamed: F1.1, F2.1, Q1.2 (S)
unnamed: Q2.3 (D), R4.2, R6.1
unnamed: Q3.3 (D), R5.2, R8.1
unnamed: C12.1, U3.4 (C1)
VBUS: D1.2 (A), J1.1 (VBUS)
