prs2026/Lyra-flight-computer/Hardware/kicad/Lyra_flight_computer/lyra r1/lyra r1/lyra r1.kicad_pcb

## KiCad design Hardware/kicad/Lyra_flight_computer/lyra r1/lyra r1/lyra r1.kicad_pcb (2023-11-15)

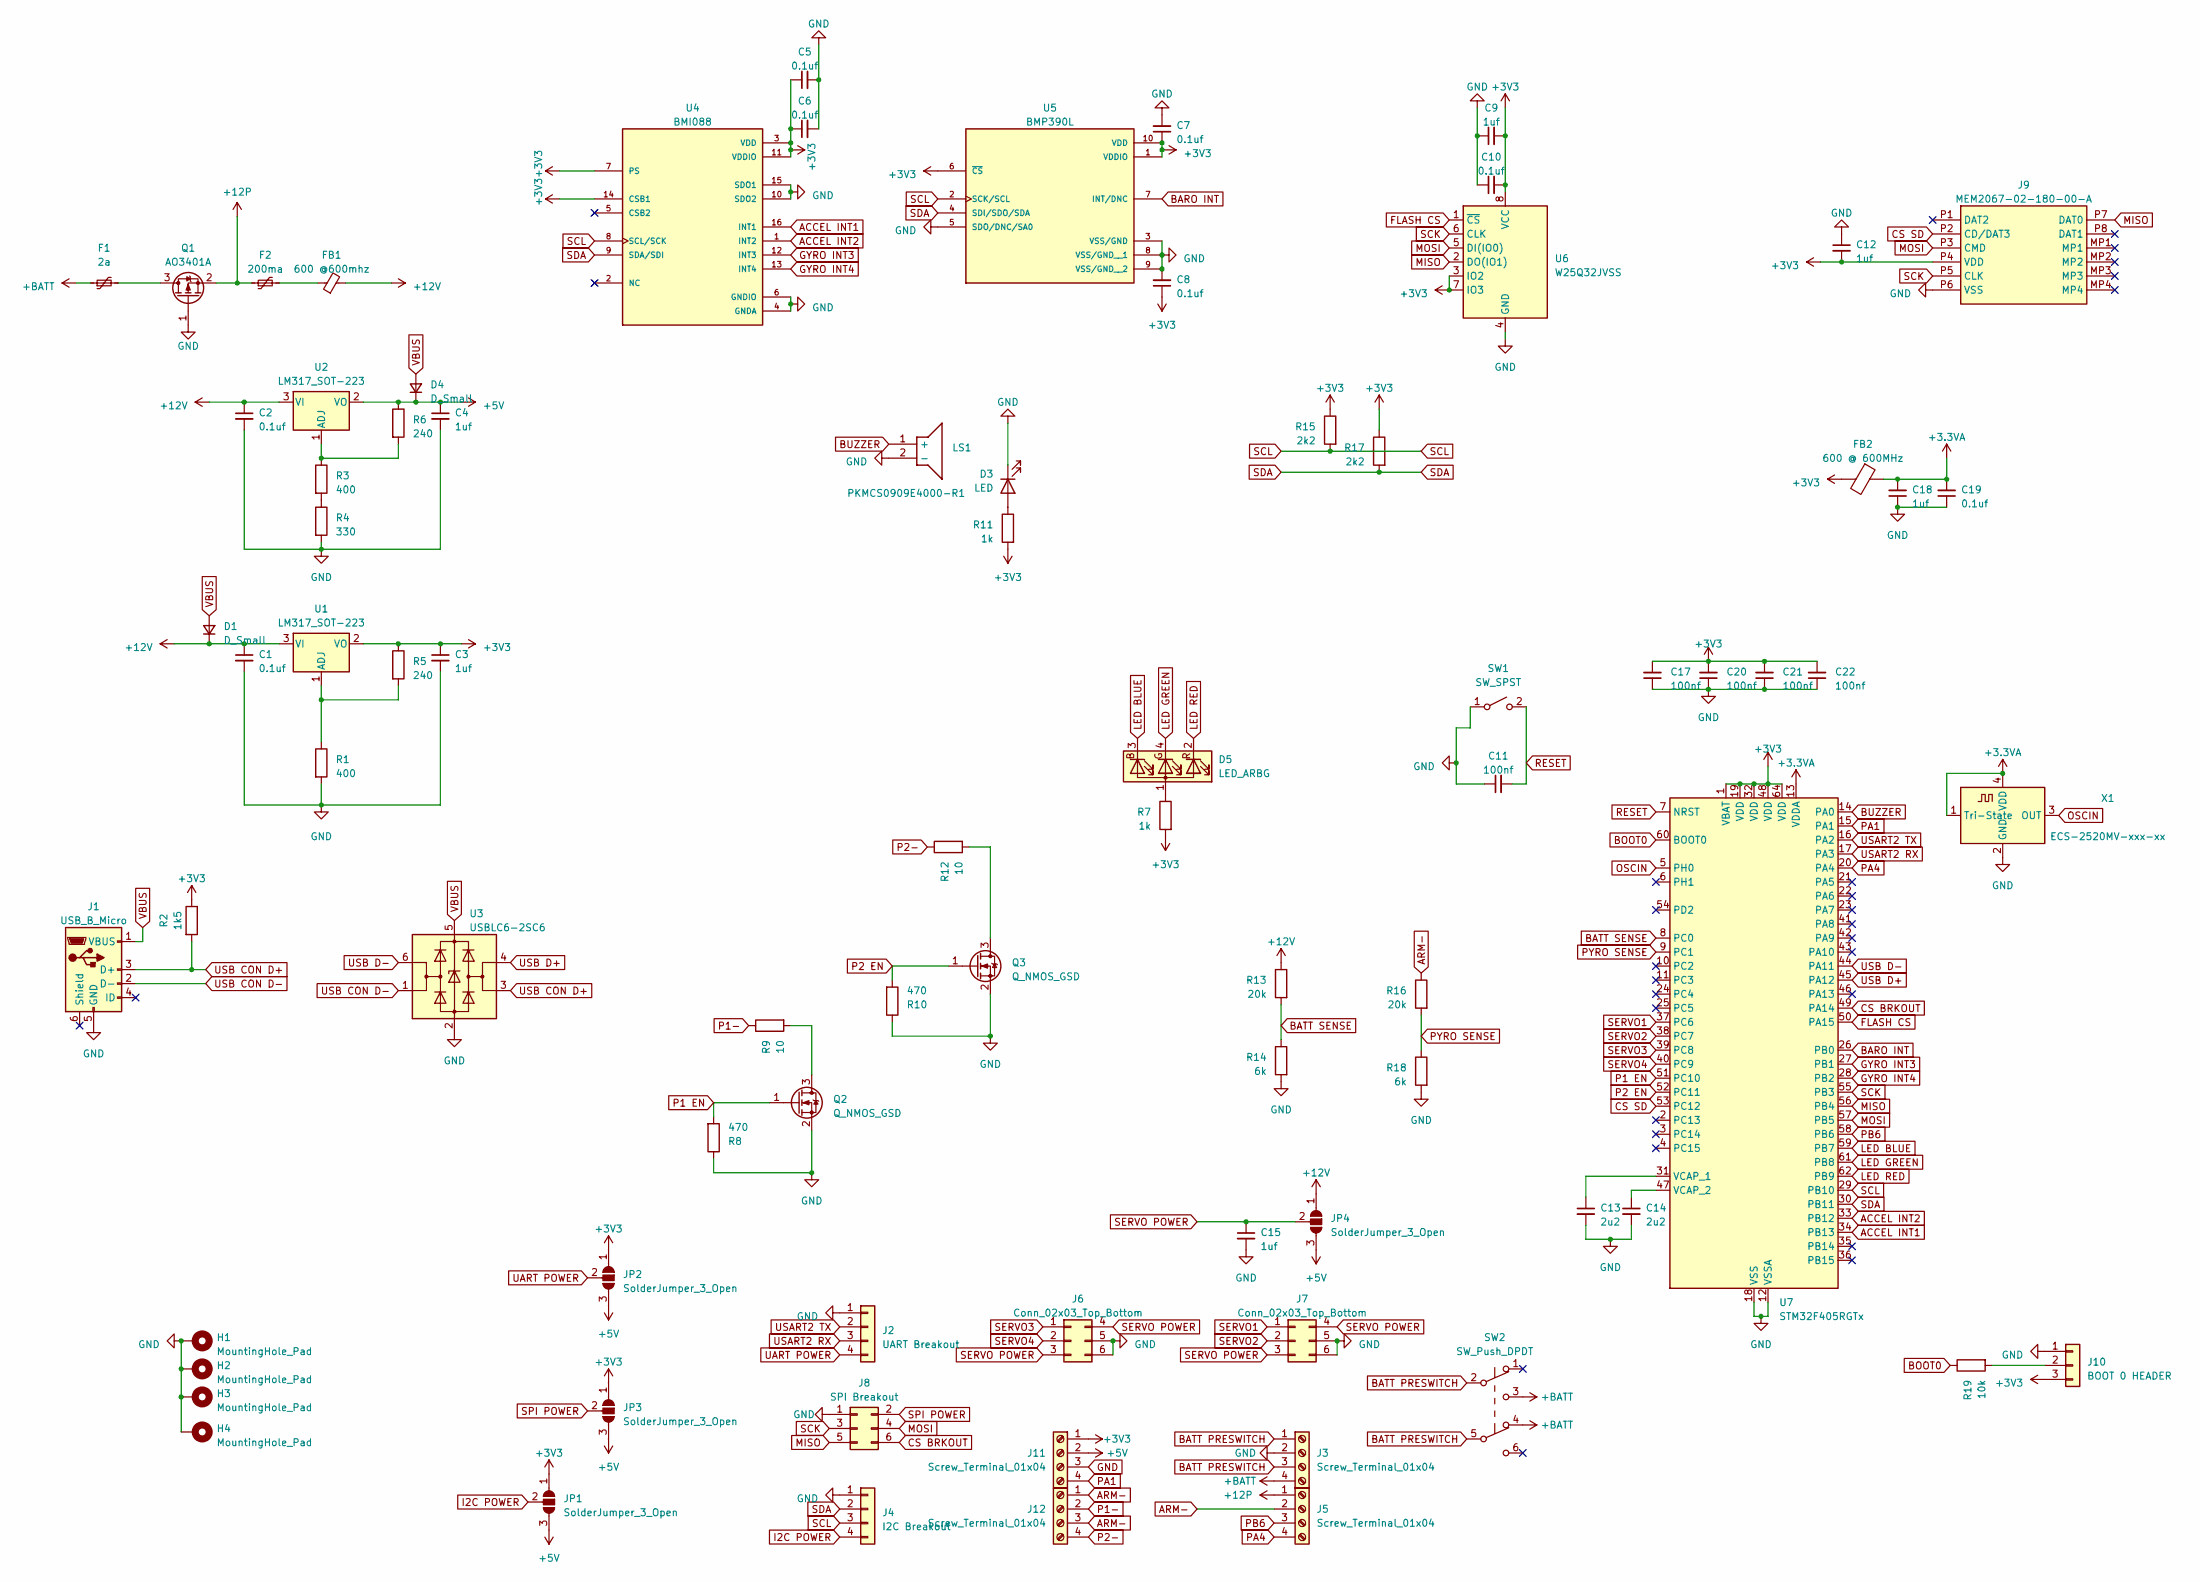
[picture p77: schematic lyra r1.kicad_sch]

Parts:
C1, C2: 0.1uf; C_0805_2012Metric
C3, C4, C15: 1uf; C_0805_2012Metric
C5, C6, C7, C8, C10, C19: 0.1uf; C_0603_1608Metric
C9, C12, C18: 1uf; C_0603_1608Metric
C11, C17, C20, C21, C22: 100nf; C_0603_1608Metric
C13, C14: 2u2; C_0603_1608Metric
D1, D4: D_Small; D_0805_2012Metric
D3: LED; LED_0805_2012Metric
D5: LED_ARBG; LED_Cree-PLCC4_2x2mm_CW
F1: 2a; Fuse_1206_3216Metric
F2: 200ma; Fuse_1206_3216Metric
FB1: 600 @600mhz; L_0603_1608Metric
FB2: 600 @ 600MHz; L_0603_1608Metric
H1, H2, H3, H4: MountingHole_Pad; MountingHole_3.2mm_M3_DIN965_Pad
J1: USB_B_Micro; USB_Micro-B_Amphenol_10104110_Horizontal
J2: UART Breakout; PinHeader_1x04_P2.54mm_Vertical
J3, J5, J11, J12: Screw_Terminal_01x04; TerminalBlock_bornier-4_P5.08mm
J4: I2C Breakout; PinHeader_1x04_P2.54mm_Vertical
J6, J7: Conn_02x03_Top_Bottom; PinHeader_2x03_P2.54mm_Vertical
J8: SPI Breakout; PinHeader_2x03_P2.54mm_Vertical
J9: MEM2067-02-180-00-A; MEM20670218000A; Mouser Part Number 640-MEM20670218000A
J10: BOOT 0 HEADER; PinHeader_1x03_P2.54mm_Vertical
JP1, JP2, JP3, JP4: SolderJumper_3_Open; SolderJumper-3_P1.3mm_Open_Pad1.0x1.5mm
LS1: PKMCS0909E4000-R1; PKMCS0909E4000R1; Mouser Part Number 81-PKMCS0909E4000-R1
Q1: AO3401A; SOT-23-3
Q2, Q3: Q_NMOS_GSD; SOT-23-3
R1: 400; R_0603_1608Metric
R2: 1k5; R_0603_1608Metric
R3: 400; R_0603_1608Metric_Pad0.98x0.95mm_HandSolder
R4: 330; R_0603_1608Metric_Pad0.98x0.95mm_HandSolder
R5, R6: 240; R_0603_1608Metric_Pad0.98x0.95mm_HandSolder
R7, R11: 1k; R_0603_1608Metric
R8, R10: 470; R_0603_1608Metric
R9, R12: 10; R_0603_1608Metric
R13, R16: 20k; R_0603_1608Metric
R14, R18: 6k; R_0603_1608Metric
R15, R17: 2k2; R_0603_1608Metric
R19: 10k; R_0603_1608Metric
SW1: SW_SPST; SW_SPST_CK_RS282G05A3
SW2: SW_Push_DPDT; JS202011SCQN
U1, U2: LM317_SOT-223; SOT-223-3_TabPin2
U3: USBLC6-2SC6; SOT-23-6
U4: BMI088; PQFN50P450X300X100-16N
U5: BMP390L; XDCR_BMP390L; PARTREV 1.7
U6: W25Q32JVSS; SOIC-8_5.23x5.23mm_P1.27mm
U7: STM32F405RGTx; LQFP-64_10x10mm_P0.5mm
X1: ECS-2520MV-xxx-xx; Oscillator_SMD_ECS_2520MV-xxx-xx-4Pin_2.5x2.0mm

Connections:
+3.3VA: C18.2, C19.2, FB2.1, U7.13 (VDDA), X1.1 (Tri-State), X1.4 (VDD)
+3V3: C3.1, C5.1, C6.1, C7.1, C8.1, C9.2, C10.2, C12.2, C17.2, C20.2, C21.2, C22.2, FB2.2, J9.P4 (VDD), J10.3, J11.1, JP1.1 (A), JP2.1 (A), JP3.1 (A), R2.1, R5.1, R7.2, R11.2, R15.1, R17.1, U1.2 (VO), U4.3 (VDD), U4.7 (PS), U4.11 (VDDIO), U4.14 (CSB1), U5.1 (VDDIO), U5.6 (~CS), U5.10 (VDD), U6.3 (IO2), U6.7 (IO3), U6.8 (VCC), U7.1 (VBAT), U7.19 (VDD), U7.32 (VDD), U7.48 (VDD), U7.64 (VDD)
+5V: C4.1, D4.1 (K), J11.2, JP1.3 (B), JP2.3 (B), JP3.3 (B), JP4.3 (B), R6.1, U2.2 (VO)
+12P: F2.1, J5.1, Q1.2 (S)
+12V: C1.1, C2.1, D1.1 (K), FB1.2, JP4.1 (A), R13.1, U1.3 (VI), U2.3 (VI)
+BATT: F1.1, J3.4, SW2.3 (C), SW2.4 (A)
ACCEL INT1: U4.16 (INT1), U7.34 (PB13)
ACCEL INT2: U4.1 (INT2), U7.33 (PB12)
ARM-: J5.2, J12.1, J12.3, R16.1
BARO INT: U5.7 (INT/DNC), U7.26 (PB0)
BATT PRESWITCH: J3.1, J3.3, SW2.2 (B), SW2.5 (B)
BATT SENSE: R13.2, R14.1, U7.8 (PC0)
BOOT0: R19.1, U7.60 (BOOT0)
BUZZER: LS1.1 (+), U7.14 (PA0)
CS BRKOUT: J8.6, U7.49 (PA14)
CS SD: J9.P2 (CD/DAT3), U7.53 (PC12)
FLASH CS: U6.1 (~CS), U7.50 (PA15)
GND: C1.2, C2.2, C3.2, C4.2, C5.2, C6.2, C7.2, C8.2, C9.1, C10.1, C11.1, C12.1, C13.2, C14.2, C15.2, C17.1, C18.1, C19.1, C20.1, C21.1, C22.1, D3.1 (K), H1.1, H2.1, H3.1, H4.1, J1.5 (GND), J2.1, J3.2, J4.1, J6.5, J6.6, J7.5, J7.6, J8.1, J9.P6 (VSS), J10.1, J11.3, LS1.2 (-), Q1.1 (G), Q2.2 (S), Q3.2 (S), R1.2, R4.2, R8.1, R10.1, R14.2, R18.2, SW1.1 (A), U3.2 (GND), U4.4 (GNDA), U4.6 (GNDIO), U4.10 (SDO2), U4.15 (SDO1), U5.3 (VSS/GND), U5.5 (SDO/DNC/SA0), U5.8 (VSS/GND__1), U5.9 (VSS/GND__2), U6.4 (GND), U7.12 (VSSA), U7.18 (VSS), U7.63 (VSS), X1.2 (GND)
GYRO INT3: U4.12 (INT3), U7.27 (PB1)
GYRO INT4: U4.13 (INT4), U7.28 (PB2)
I2C POWER: J4.4, JP1.2 (C)
LED BLUE: D5.3 (BK), U7.59 (PB7)
LED GREEN: D5.4 (GK), U7.61 (PB8)
LED RED: D5.2 (RK), U7.62 (PB9)
MISO: J8.5, J9.P7 (DAT0), U6.2 (DO(IO1)), U7.56 (PB4)
MOSI: J8.4, J9.P3 (CMD), U6.5 (DI(IO0)), U7.57 (PB5)
unnamed: D3.2 (A), R11.1
unnamed: D5.1 (A), R7.1
unnamed: F2.2, FB1.1
unnamed: J10.2, R19.2
unnamed: F1.2, Q1.3 (D)
unnamed: Q2.3 (D), R9.2
unnamed: Q3.3 (D), R12.2
unnamed: R3.2, R4.1
unnamed: R1.1, R5.2, U1.1 (ADJ)
unnamed: R3.1, R6.2, U2.1 (ADJ)
unnamed: C13.1, U7.31 (VCAP_1)
unnamed: C14.1, U7.47 (VCAP_2)
OSCIN: U7.5 (PH0), X1.3 (OUT)
P1 EN: Q2.1 (G), R8.2, U7.51 (PC10)
P1-: J12.2, R9.1
P2 EN: Q3.1 (G), R10.2, U7.52 (PC11)
P2-: J12.4, R12.1
PA1: J11.4, U7.15 (PA1)
PA4: J5.4, U7.20 (PA4)
PB6: J5.3, U7.58 (PB6)
PYRO SENSE: R16.2, R18.1, U7.9 (PC1)
RESET: C11.2, SW1.2 (B), U7.7 (NRST)
SCK: J8.3, J9.P5 (CLK), U6.6 (CLK), U7.55 (PB3)
SCL: J4.3, R15.2, U4.8 (SCL/SCK), U5.2 (SCK/SCL), U7.29 (PB10)
SDA: J4.2, R17.2, U4.9 (SDA/SDI), U5.4 (SDI/SDO/SDA), U7.30 (PB11)
SERVO1: J7.1, U7.37 (PC6)
SERVO2: J7.2, U7.38 (PC7)
SERVO3: J6.1, U7.39 (PC8)
SERVO4: J6.2, U7.40 (PC9)
SERVO POWER: C15.1, J6.3, J6.4, J7.3, J7.4, JP4.2 (C)
SPI POWER: J8.2, JP3.2 (C)
UART POWER: J2.4, JP2.2 (C)
USART2 RX: J2.3, U7.17 (PA3)
USART2 TX: J2.2, U7.16 (PA2)
USB CON D+: J1.3 (D+), R2.2, U3.3 (I/O2)
USB CON D-: J1.2 (D-), U3.1 (I/O1)
USB D+: U3.4 (I/O2), U7.45 (PA12)
USB D-: U3.6 (I/O1), U7.44 (PA11)
VBUS: D1.2 (A), D4.2 (A), J1.1 (VBUS), U3.5 (VBUS)

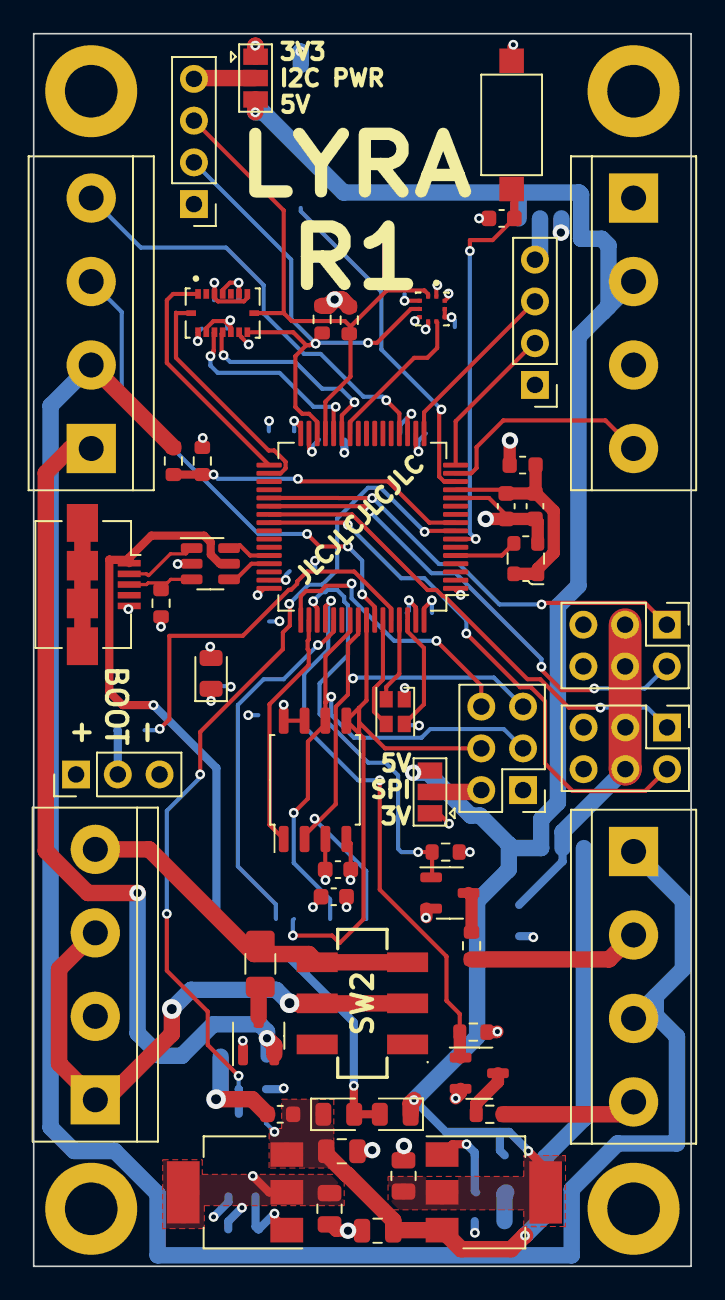
[picture p78: board lyra r1.kicad_pcb from above]

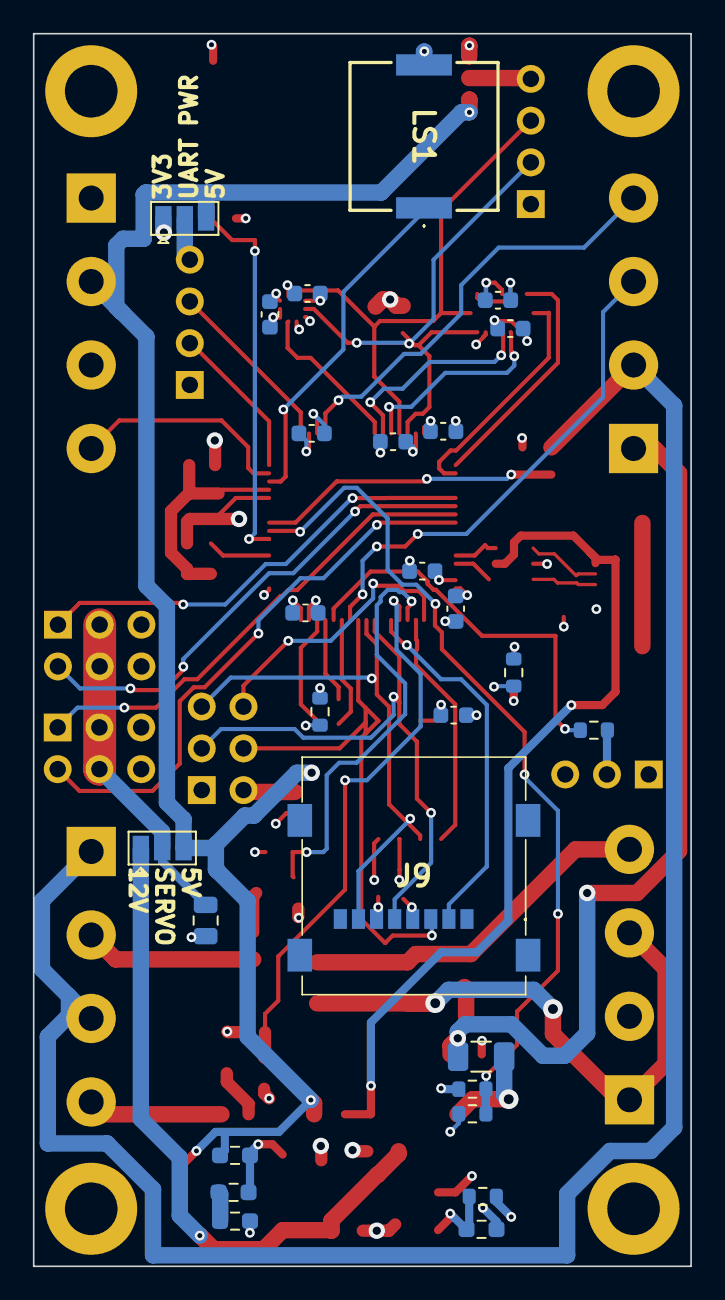
[picture p79: board lyra r1.kicad_pcb from below]

Board: 4 copper layers, 40.0 x 75.0 mm, 82 parts (27 on the bottom side), 65 nets.
