prs2026/Lyra-flight-computer/Hardware/kicad/Lyra_flight_computer/lyra flight comp/wolf flight comp.kicad_pcb

## KiCad design Hardware/kicad/Lyra_flight_computer/lyra flight comp/wolf flight comp.kicad_pcb (2023-11-15)

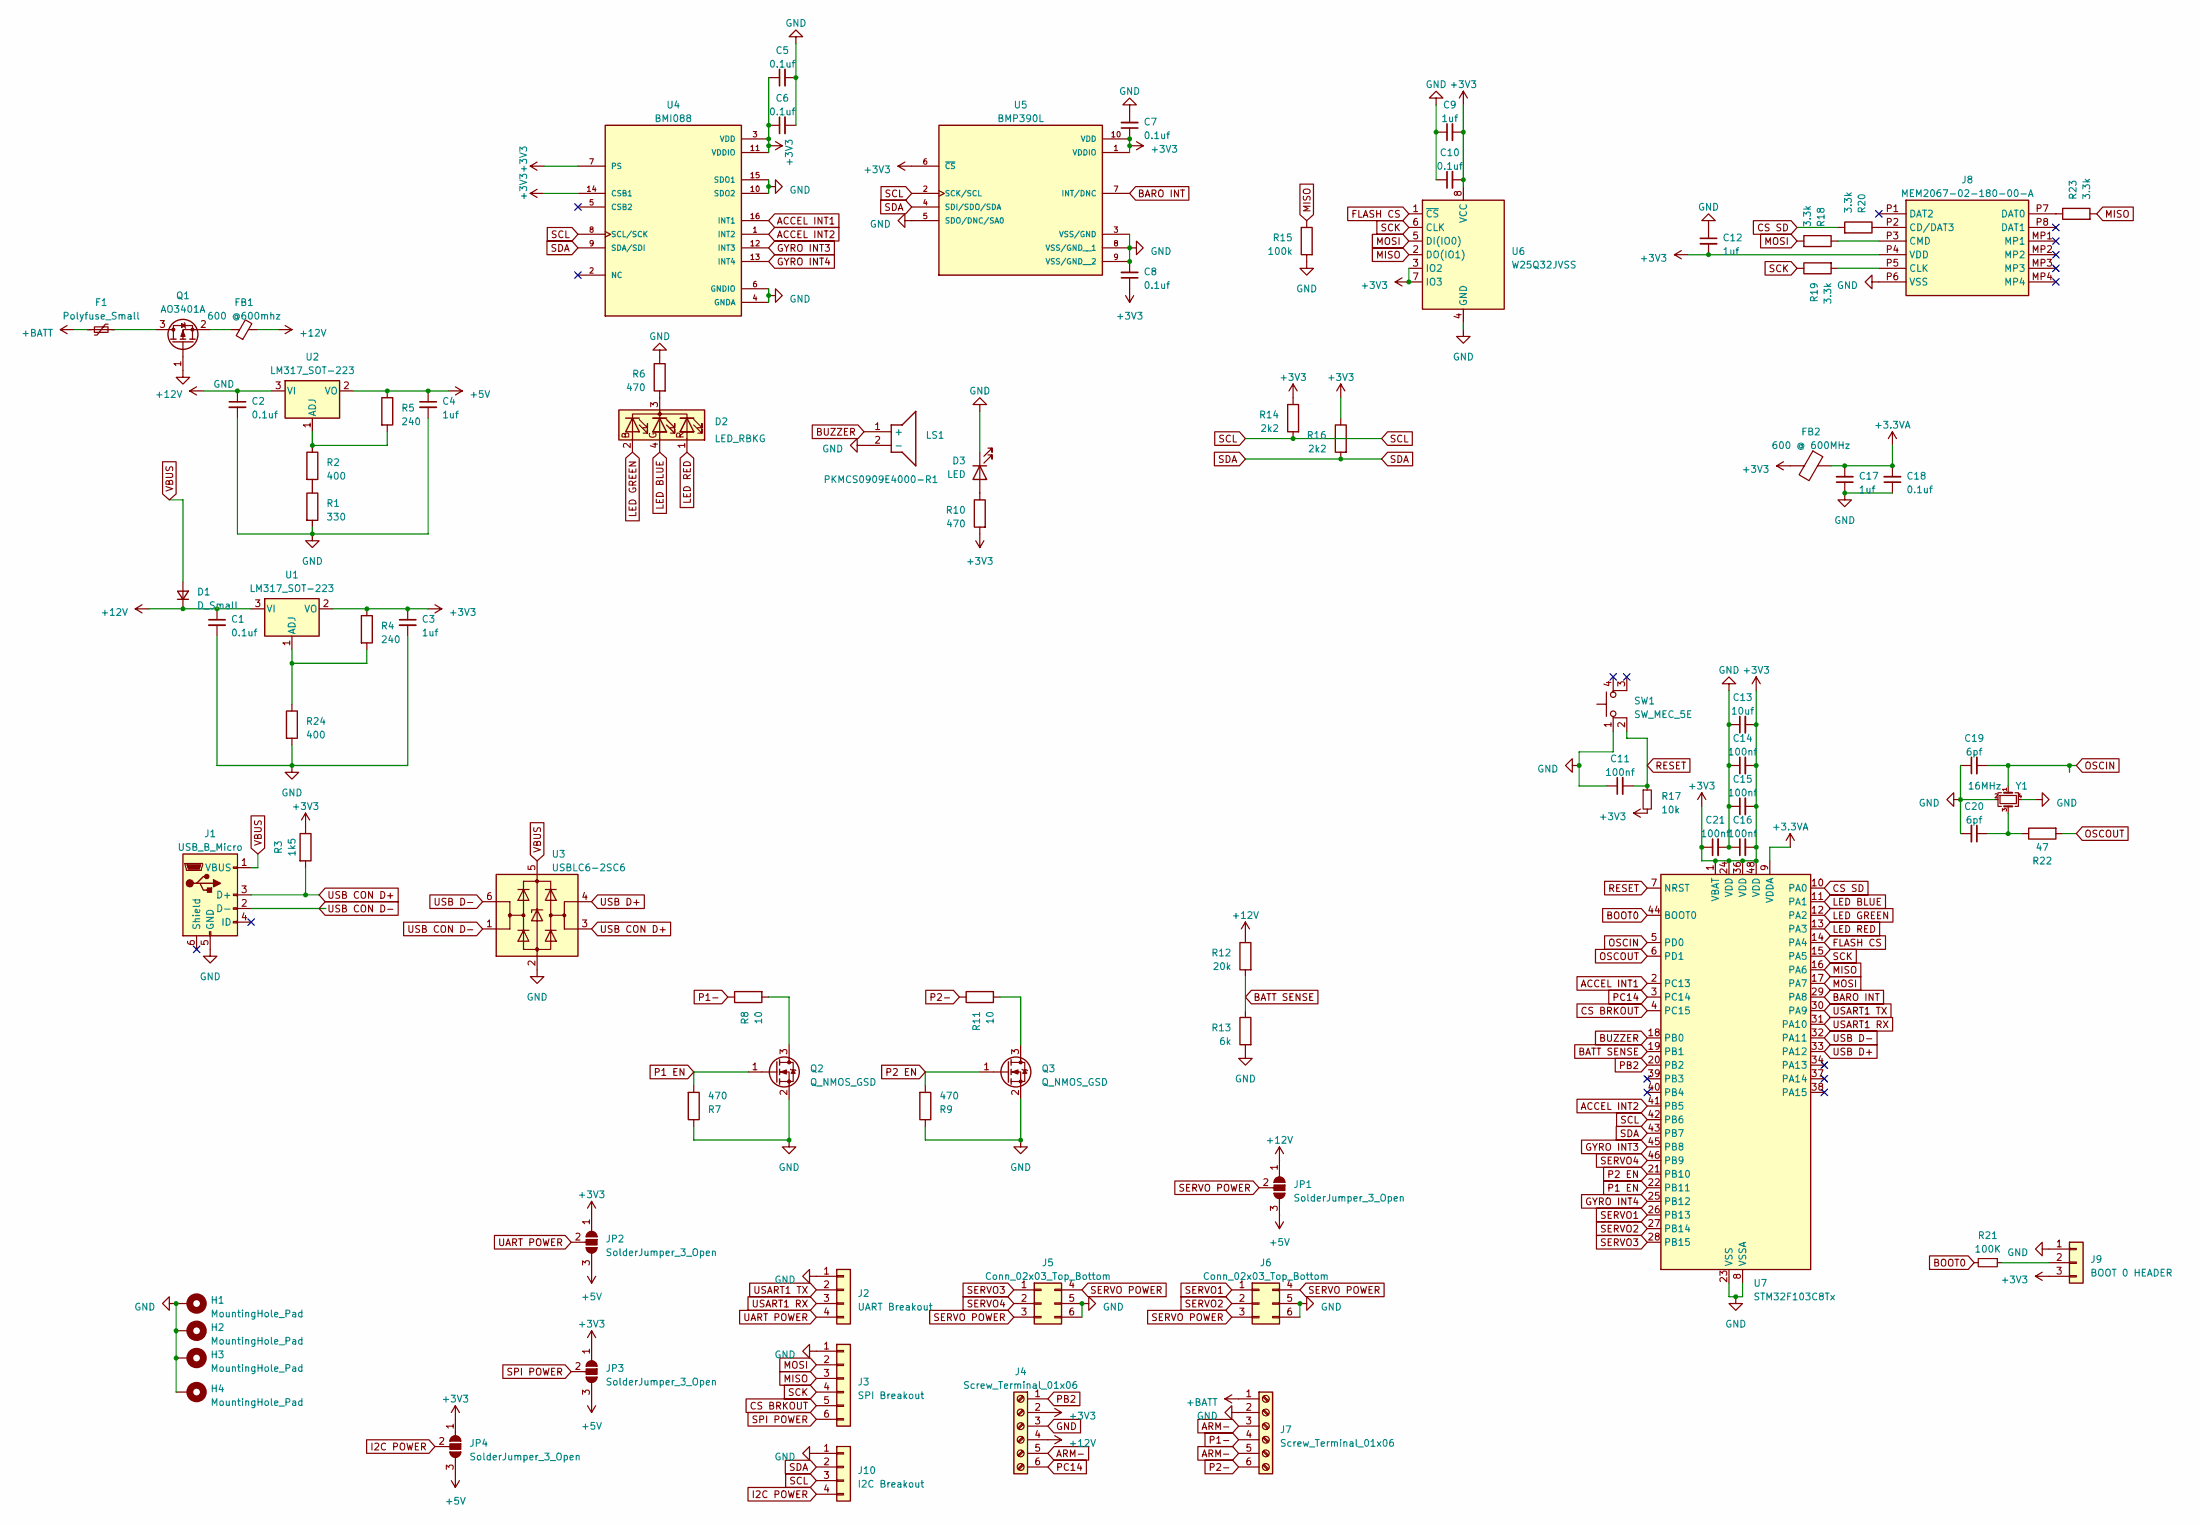
[picture p80: schematic wolf flight comp.kicad_sch]

Parts:
C1, C2: 0.1uf; C_0805_2012Metric
C3, C4: 1uf; C_0805_2012Metric
C5, C6, C7, C8, C10, C18: 0.1uf; C_0603_1608Metric
C9, C12, C17: 1uf; C_0603_1608Metric
C11, C14, C15, C16, C21: 100nf; C_0603_1608Metric
C13: 10uf; C_0805_2012Metric
C19, C20: 6pf; C_0603_1608Metric
D1: D_Small; D_0805_2012Metric
D2: LED_RBKG; LED_D5.0mm-4_RGB
D3: LED; LED_0805_2012Metric
F1: Polyfuse_Small; Fuse_1206_3216Metric
FB1: 600 @600mhz; L_0603_1608Metric
FB2: 600 @ 600MHz; L_0603_1608Metric
H1, H2, H3, H4: MountingHole_Pad; MountingHole_3.2mm_M3_DIN965_Pad
J1: USB_B_Micro; USB_Micro-B_Amphenol_10104110_Horizontal
J2: UART Breakout; PinHeader_1x04_P2.54mm_Vertical
J3: SPI Breakout; PinHeader_1x06_P2.54mm_Vertical
J4, J7: Screw_Terminal_01x06; TerminalBlock_Phoenix_MPT-0,5-6-2.54_1x06_P2.54mm_Horizontal
J5, J6: Conn_02x03_Top_Bottom; PinHeader_2x03_P2.54mm_Vertical
J8: MEM2067-02-180-00-A; MEM20670218000A; Mouser Part Number 640-MEM20670218000A
J9: BOOT 0 HEADER; PinHeader_1x03_P2.54mm_Vertical
J10: I2C Breakout; PinHeader_1x04_P2.54mm_Vertical
JP1, JP2, JP3, JP4: SolderJumper_3_Open; SolderJumper-3_P1.3mm_Open_Pad1.0x1.5mm
LS1: PKMCS0909E4000-R1; PKMCS0909E4000R1; Mouser Part Number 81-PKMCS0909E4000-R1
Q1: AO3401A; SOT-23-3
Q2, Q3: Q_NMOS_GSD; SOT-23-3
R1: 330; R_0603_1608Metric_Pad0.98x0.95mm_HandSolder
R2: 400; R_0603_1608Metric_Pad0.98x0.95mm_HandSolder
R3: 1k5; R_0603_1608Metric
R4, R5: 240; R_0603_1608Metric_Pad0.98x0.95mm_HandSolder
R6, R7, R9, R10: 470; R_0603_1608Metric
R8, R11: 10; R_0603_1608Metric
R12: 20k; R_0603_1608Metric
R13: 6k; R_0603_1608Metric
R14, R16: 2k2; R_0603_1608Metric
R15: 100k; R_0603_1608Metric
R17: 10k; R_0603_1608Metric
R18, R19, R20, R23: 3.3k; R_0603_1608Metric
R21: 100K; R_0603_1608Metric
R22: 47; R_0603_1608Metric
R24: 400; R_0603_1608Metric
SW1: SW_MEC_5E; SW_PUSH_6mm
U1, U2: LM317_SOT-223; SOT-223-3_TabPin2
U3: USBLC6-2SC6; SOT-666
U4: BMI088; PQFN50P450X300X100-16N
U5: BMP390L; XDCR_BMP390L; PARTREV 1.7
U6: W25Q32JVSS; SOIC-8_5.23x5.23mm_P1.27mm
U7: STM32F103C8Tx; LQFP-48_7x7mm_P0.5mm
Y1: 16MHz; Crystal_SMD_2520-4Pin_2.5x2.0mm; LCSC Part # C13738

Connections:
+3.3VA: C17.2, C18.2, FB2.1, U7.9 (VDDA)
+3V3: C3.1, C5.1, C6.1, C7.1, C8.1, C9.2, C10.2, C12.2, C13.2, C14.2, C15.2, C16.2, C21.1, FB2.2, J4.2, J8.P4 (VDD), J9.3, JP2.1 (A), JP3.1 (A), JP4.1 (A), R3.1, R4.1, R10.2, R14.1, R16.1, R17.2, U1.2 (VO), U4.3 (VDD), U4.7 (PS), U4.11 (VDDIO), U4.14 (CSB1), U5.1 (VDDIO), U5.6 (~CS), U5.10 (VDD), U6.3 (IO2), U6.7 (IO3), U6.8 (VCC), U7.1 (VBAT), U7.24 (VDD), U7.36 (VDD), U7.48 (VDD)
+5V: C4.1, JP1.3 (B), JP2.3 (B), JP3.3 (B), JP4.3 (B), R5.1, U2.2 (VO)
+12V: C1.1, C2.1, D1.1 (K), FB1.2, J4.4, JP1.1 (A), R12.1, U1.3 (VI), U2.3 (VI)
+BATT: F1.1, J7.1
ACCEL INT1: U4.16 (INT1), U7.2 (PC13)
ACCEL INT2: U4.1 (INT2), U7.41 (PB5)
ARM-: J4.5, J7.3, J7.5
BARO INT: U5.7 (INT/DNC), U7.29 (PA8)
BATT SENSE: R12.2, R13.1, U7.19 (PB1)
BOOT0: R21.2, U7.44 (BOOT0)
BUZZER: LS1.1 (+), U7.18 (PB0)
CS BRKOUT: J3.5, U7.4 (PC15)
CS SD: R20.2, U7.10 (PA0)
FLASH CS: U6.1 (~CS), U7.14 (PA4)
GYRO INT3: U4.12 (INT3), U7.45 (PB8)
GYRO INT4: U4.13 (INT4), U7.25 (PB12)
I2C POWER: J10.4, JP4.2 (C)
LED BLUE: D2.4 (GA), U7.11 (PA1)
LED GREEN: D2.2 (BA), U7.12 (PA2)
LED RED: D2.1 (RA), U7.13 (PA3)
MISO: J3.3, R15.1, R23.2, U6.2 (DO(IO1)), U7.16 (PA6)
MOSI: J3.2, R18.2, U6.5 (DI(IO0)), U7.17 (PA7)
unnamed: C20.1, R22.1, Y1.3
unnamed: D2.3 (K), R6.2
unnamed: D3.2 (A), R10.1
unnamed: J8.P2 (CD/DAT3), R20.1
unnamed: J8.P5 (CLK), R19.2
unnamed: J8.P3 (CMD), R18.1
unnamed: J8.P7 (DAT0), R23.1
unnamed: J9.2, R21.1
unnamed: F1.2, Q1.3 (D)
unnamed: FB1.1, Q1.2 (S)
unnamed: Q2.3 (D), R8.2
unnamed: Q3.3 (D), R11.2
unnamed: R2.1, R5.2, U2.1 (ADJ)
OSCIN: C19.2, U7.5 (PD0), Y1.1
OSCOUT: R22.2, U7.6 (PD1)
P1 EN: Q2.1 (G), R7.2, U7.22 (PB11)
P1-: J7.4, R8.1
P2 EN: Q3.1 (G), R9.2, U7.21 (PB10)
P2-: J7.6, R11.1
PB2: J4.1, U7.20 (PB2)
PC14: J4.6, U7.3 (PC14)
RESET: C11.2, R17.1, SW1.2, U7.7 (NRST)
SCK: J3.4, R19.1, U6.6 (CLK), U7.15 (PA5)
SCL: J10.3, R14.2, U4.8 (SCL/SCK), U5.2 (SCK/SCL), U7.42 (PB6)
SDA: J10.2, R16.2, U4.9 (SDA/SDI), U5.4 (SDI/SDO/SDA), U7.43 (PB7)
SERVO1: J6.1, U7.26 (PB13)
SERVO2: J6.2, U7.27 (PB14)
SERVO3: J5.1, U7.28 (PB15)
SERVO4: J5.2, U7.46 (PB9)
SERVO POWER: J5.3, J5.4, J6.3, J6.4, JP1.2 (C)
SPI POWER: J3.6, JP3.2 (C)
UART POWER: J2.4, JP2.2 (C)
USART1 RX: J2.3, U7.31 (PA10)
USART1 TX: J2.2, U7.30 (PA9)
USB CON D+: J1.3 (D+), R3.2, U3.3 (I/O2)
USB CON D-: J1.2 (D-), U3.1 (I/O1)
USB D+: U3.4 (I/O2), U7.33 (PA12)
USB D-: U3.6 (I/O1), U7.32 (PA11)
VBUS: D1.2 (A), J1.1 (VBUS), U3.5 (VBUS)

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
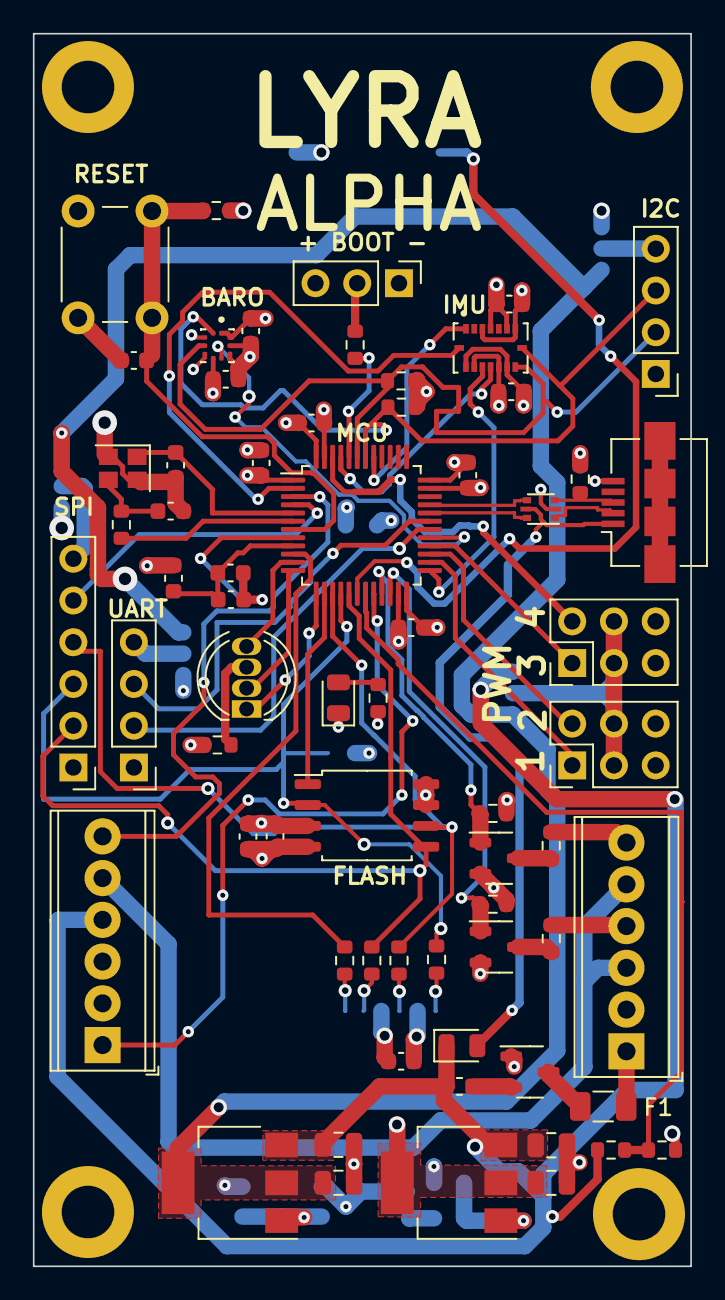
[picture p81: board wolf flight comp.kicad_pcb from above]

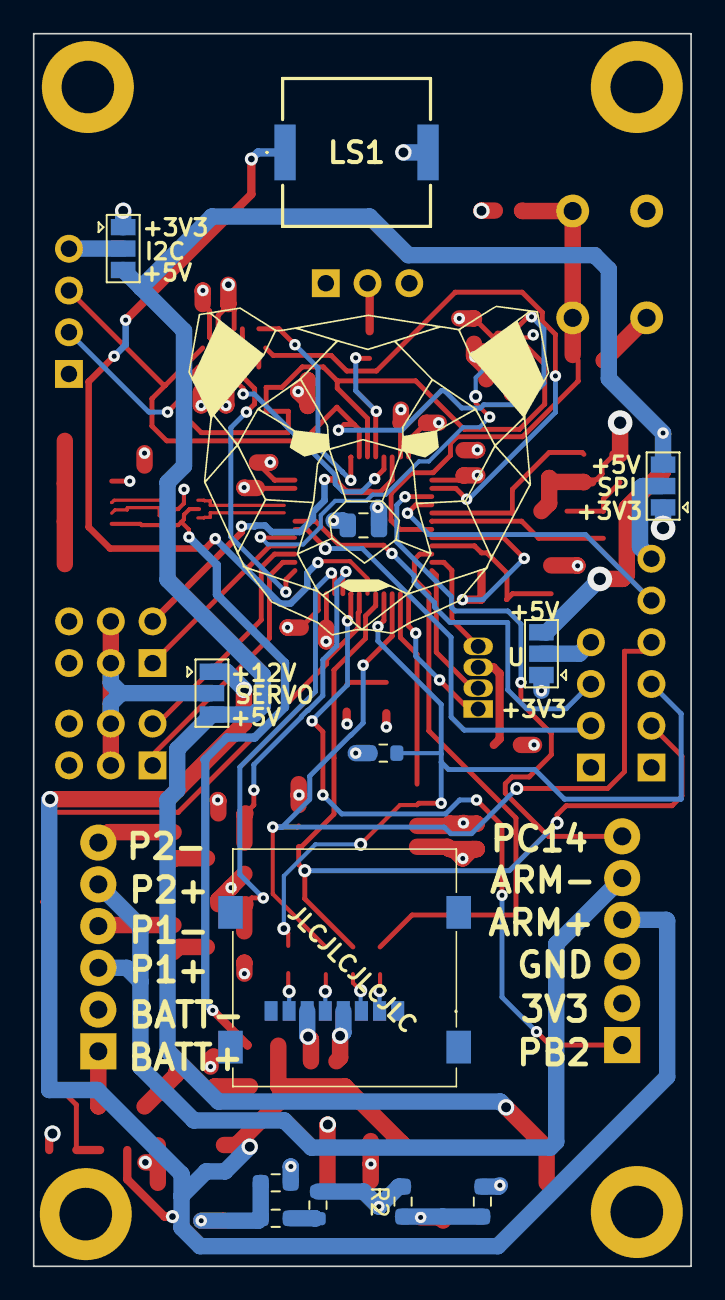
[picture p82: board wolf flight comp.kicad_pcb from below]

Board: 4 copper layers, 40.0 x 75.0 mm, 82 parts (13 on the bottom side), 65 nets.
