prs2026/Lyra-flight-computer/avionics/flight computer FOX/flight computer FOX.kicad_pcb

## KiCad design avionics/flight computer FOX/flight computer FOX.kicad_pcb (2023-11-15)

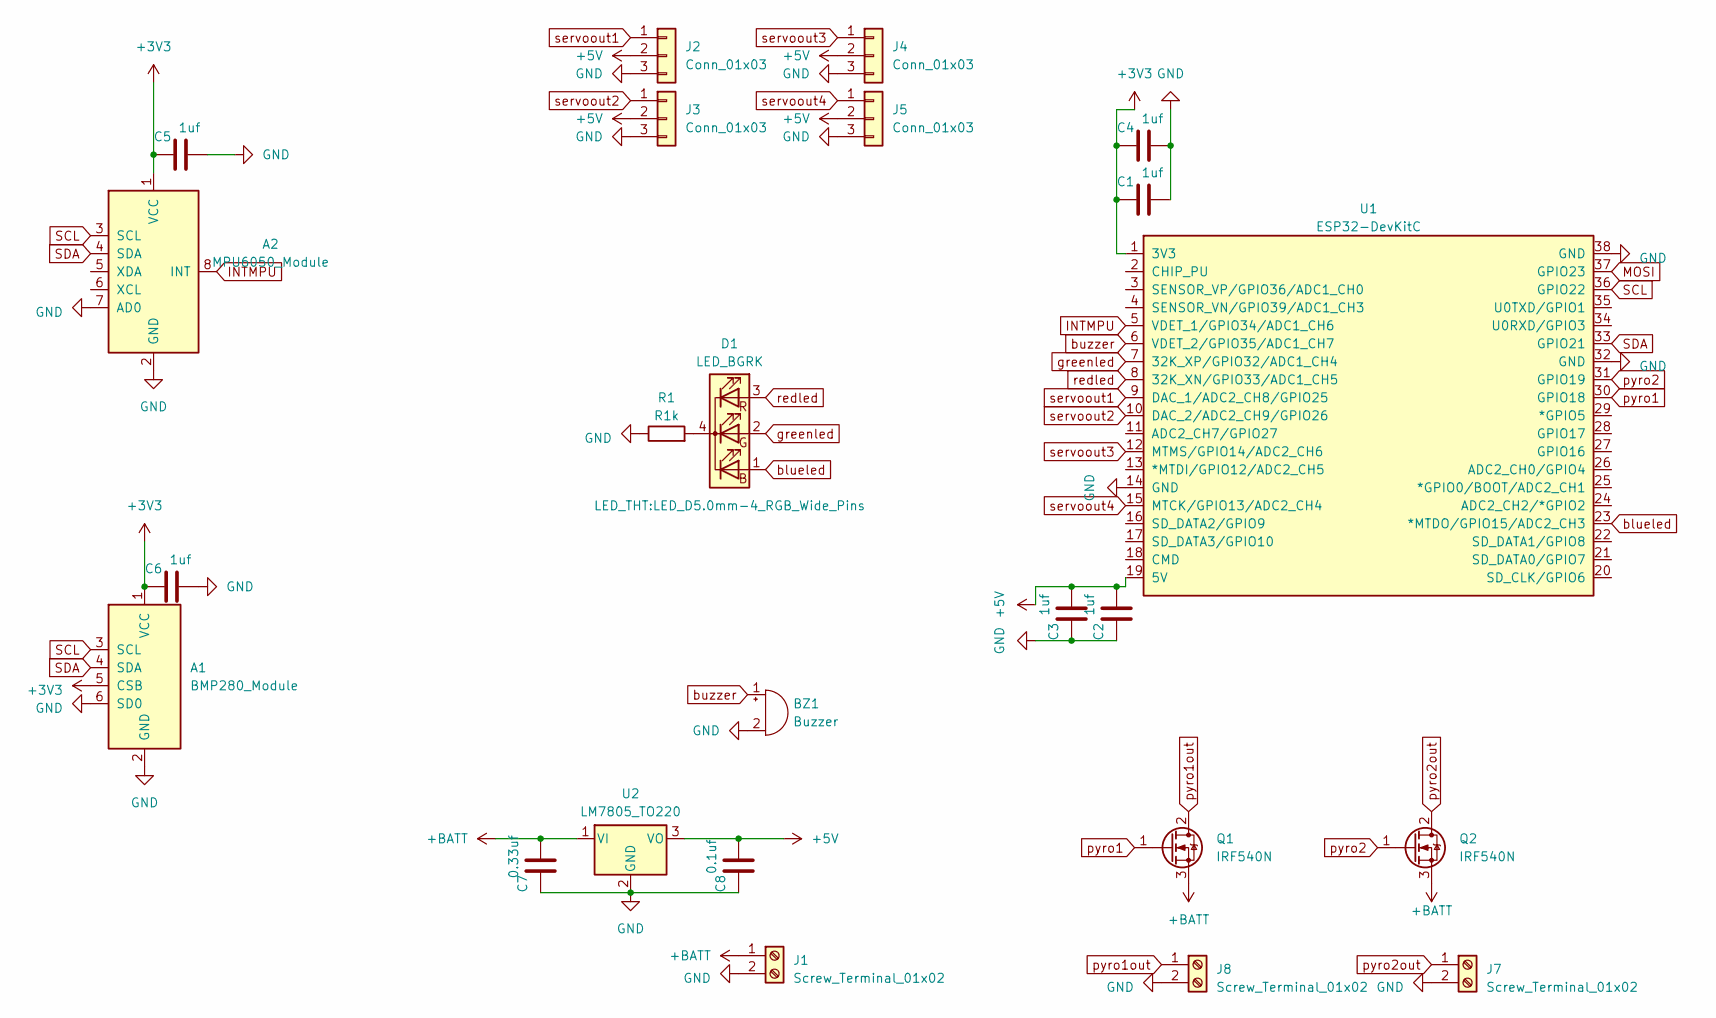
[picture p83: schematic flight computer FOX.kicad_sch]

Parts:
A1: BMP280_Module
A2: MPU6050_Module
BZ1: Buzzer; Buzzer_12x9.5RM7.6
C1, C2, C3, C4, C5, C6: 1uf; C_0805_2012Metric_Pad1.18x1.45mm_HandSolder
C7: 0.33uf; C_0805_2012Metric_Pad1.18x1.45mm_HandSolder
C8: 0.1uf; C_0805_2012Metric_Pad1.18x1.45mm_HandSolder
D1: LED_BGRK; LED_D5.0mm-4_RGB_Wide_Pins
J1, J7, J8: Screw_Terminal_01x02; TerminalBlock_bornier-2_P5.08mm
J2, J3, J4, J5: Conn_01x03; PinHeader_1x03_P2.54mm_Vertical
Q1, Q2: IRF540N; TO-220-3_Vertical
R1: R1k; R_0805_2012Metric_Pad1.20x1.40mm_HandSolder
U1: ESP32-DevKitC
U2: LM7805_TO220; TO-220-3_Vertical

Connections:
+3V3: A1.1 (VCC), A1.5 (CSB), A2.1 (VCC), C1.1, C4.1, C5.1, C6.1, U1.1 (3V3)
+5V: C2.2, C3.2, C8.2, J2.2, J3.2, J4.2, J5.2, U1.19 (5V), U2.3 (VO)
+BATT: C7.2, J1.1, Q1.3 (S), Q2.3 (S), U2.1 (VI)
GND: A1.2 (GND), A1.6 (SD0), A2.2 (GND), A2.7 (AD0), BZ1.2 (+), C1.2, C2.1, C3.1, C4.2, C5.2, C6.2, C7.1, C8.1, J1.2, J2.3, J3.3, J4.3, J5.3, J7.2, J8.2, R1.1, U1.14 (GND), U1.32 (GND), U1.38 (GND), U2.2 (GND)
INTMPU: A2.8 (INT), U1.5 (VDET_1/GPIO34/ADC1_CH6)
MOSI: U1.37 (GPIO23)
unnamed: D1.4 (K), R1.2
SCL: A1.3 (SCL), A2.3 (SCL), U1.36 (GPIO22)
SDA: A1.4 (SDA), A2.4 (SDA), U1.33 (GPIO21)
blueled: D1.1 (BA), U1.23 (*MTDO/GPIO15/ADC2_CH3)
buzzer: BZ1.1 (-), U1.6 (VDET_2/GPIO35/ADC1_CH7)
greenled: D1.2 (GA), U1.7 (32K_XP/GPIO32/ADC1_CH4)
pyro1: Q1.1 (G), U1.30 (GPIO18)
pyro1out: J8.1, Q1.2 (D)
pyro2: Q2.1 (G), U1.31 (GPIO19)
pyro2out: J7.1, Q2.2 (D)
redled: D1.3 (RA), U1.8 (32K_XN/GPIO33/ADC1_CH5)
servoout1: J2.1, U1.9 (DAC_1/ADC2_CH8/GPIO25)
servoout2: J3.1, U1.10 (DAC_2/ADC2_CH9/GPIO26)
servoout3: J4.1, U1.12 (MTMS/GPIO14/ADC2_CH6)
servoout4: J5.1, U1.15 (MTCK/GPIO13/ADC2_CH4)

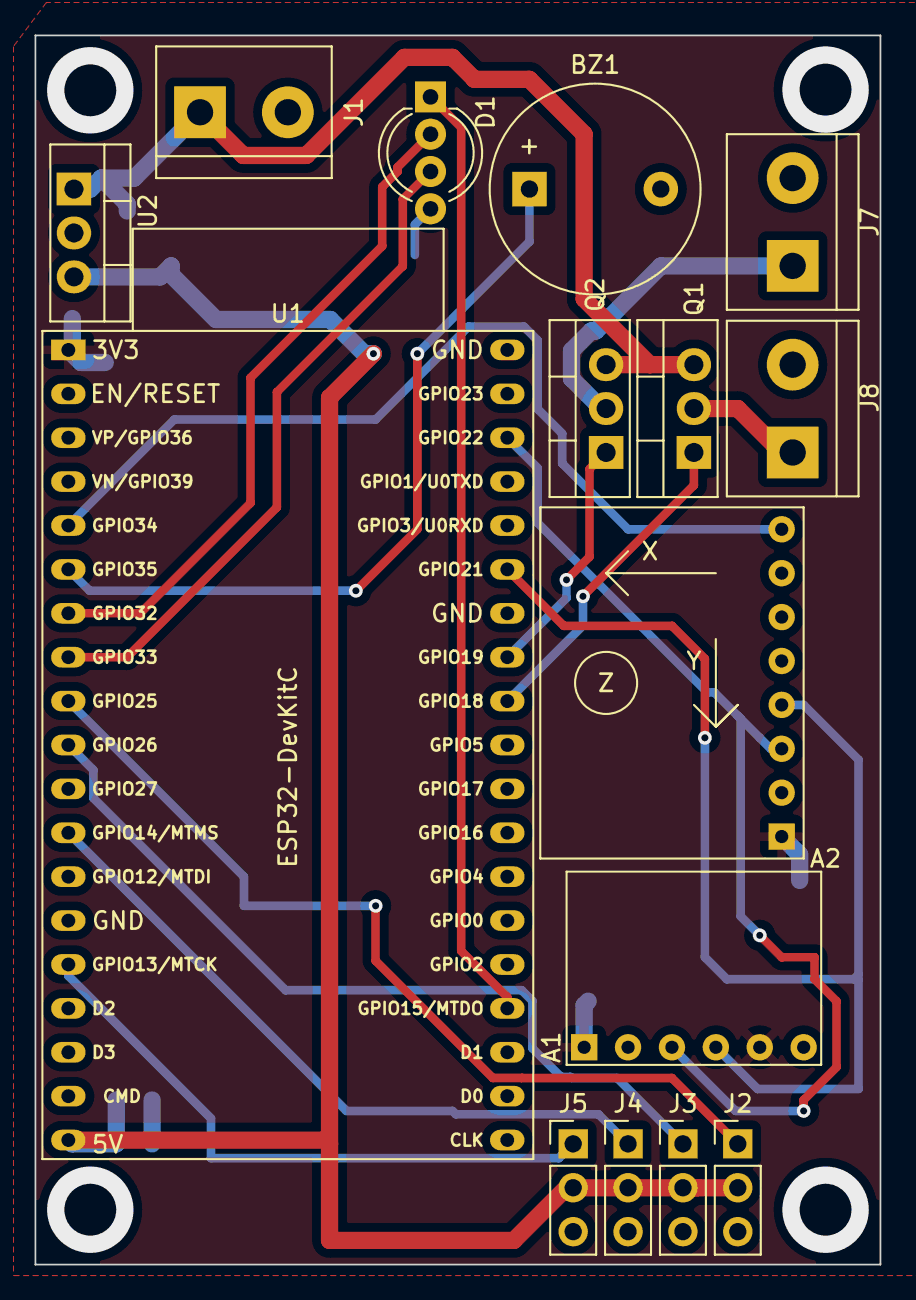
[picture p84: board flight computer FOX.kicad_pcb from above]

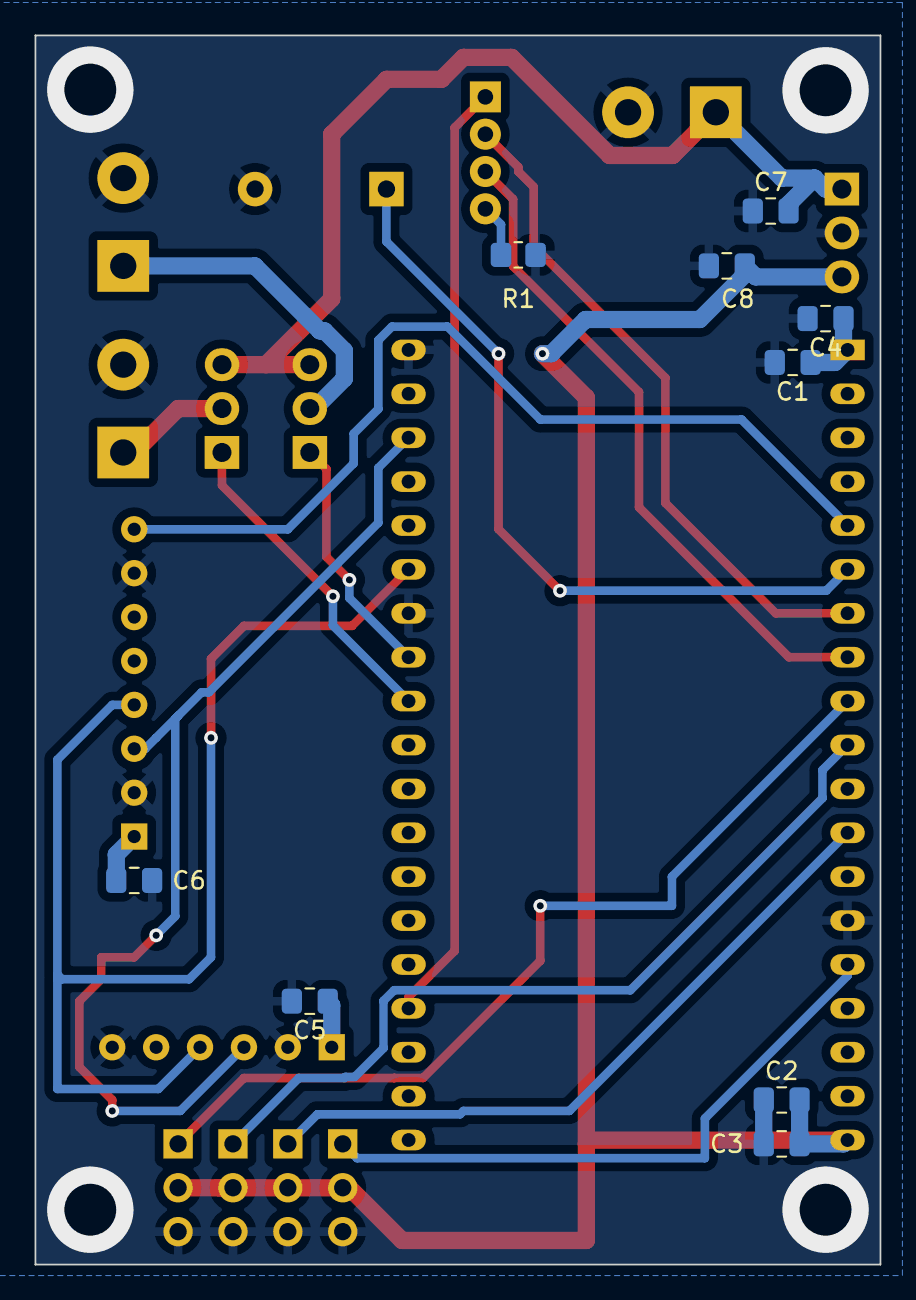
[picture p85: board flight computer FOX.kicad_pcb from below]

Board: 2 copper layers, 48.9 x 71.1 mm, 24 parts (9 on the bottom side), 20 nets.
