prs2026/Lyra-flight-computer/avionics/kicad/hyades/hyades/hyades.kicad_pcb

## KiCad design avionics/kicad/hyades/hyades/hyades.kicad_pcb (2023-11-15)

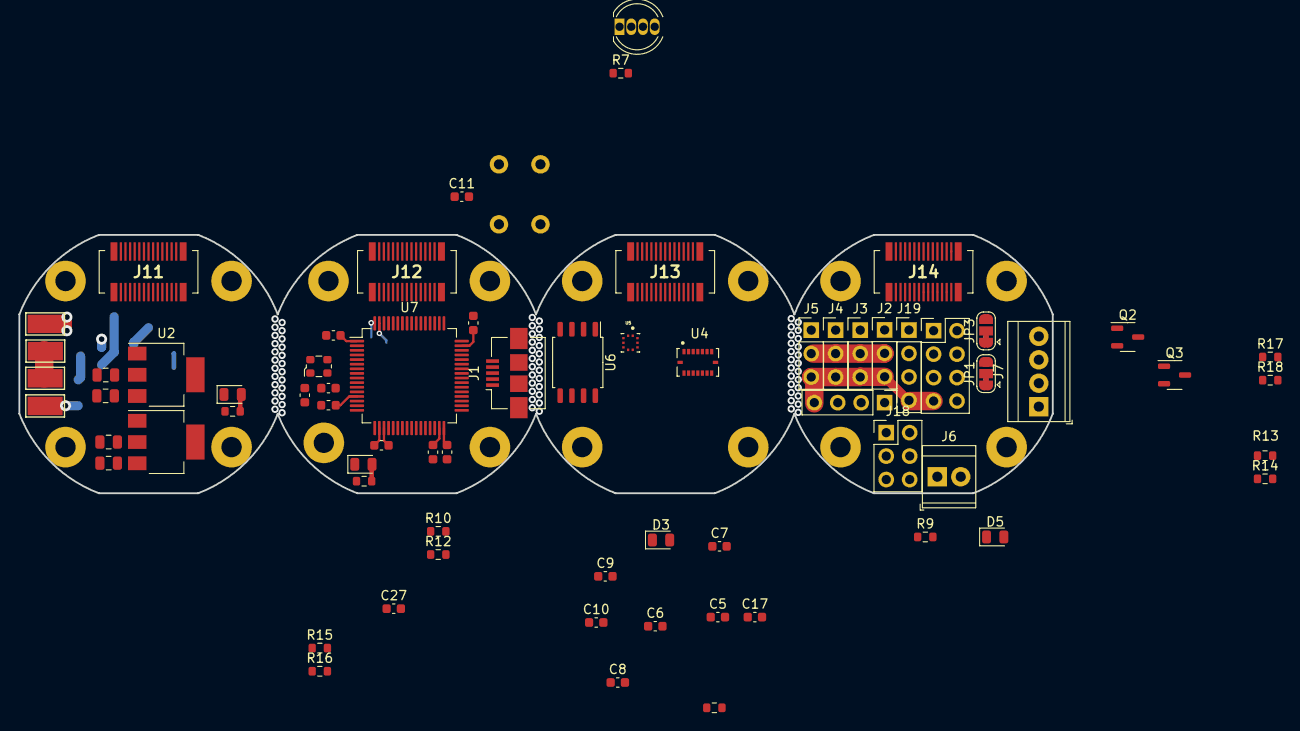
[picture p86: board hyades.kicad_pcb from above]

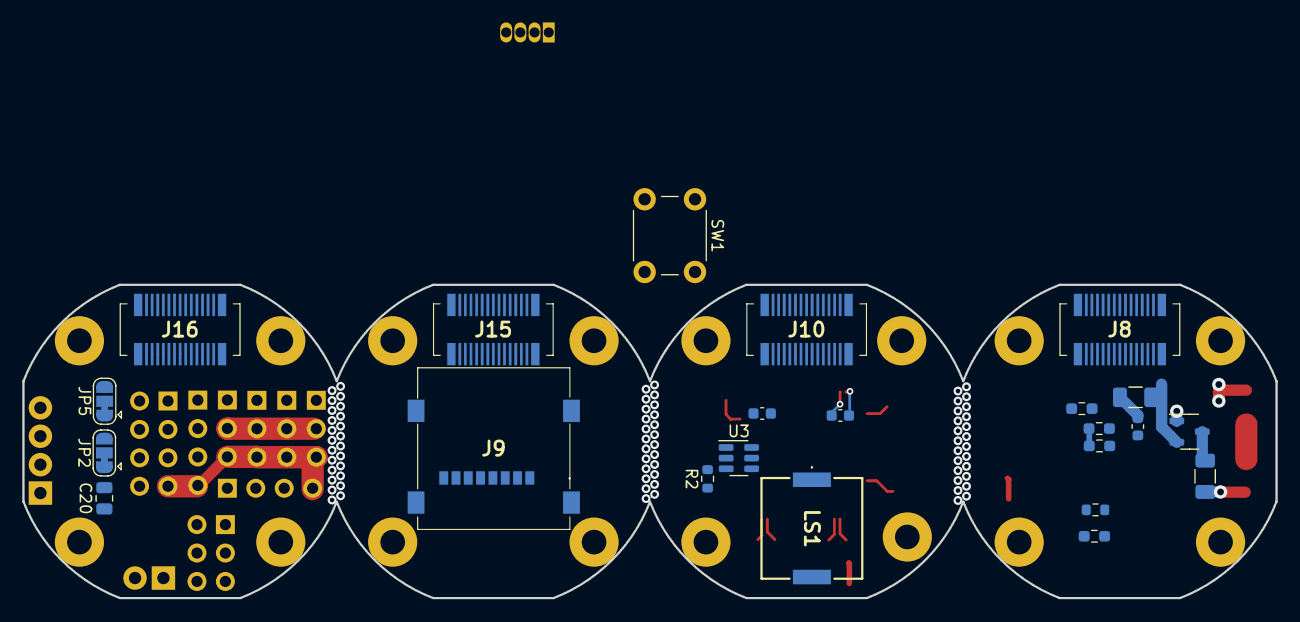
[picture p87: board hyades.kicad_pcb from below]

Board: 4 copper layers, 112.0 x 28.0 mm, 108 parts (23 on the bottom side), 64 nets.

Parts:
C1, C2: 0.1uf; C_0805_2012Metric
C3, C4: 1uf; C_0805_2012Metric
C5, C6, C7, C8, C10, C19: 0.1uf; C_0603_1608Metric
C9, C17, C18: 1uf; C_0603_1608Metric
C11, C12, C13, C14, C15, C16, C27: 100nf; C_0603_1608Metric
C20: 100uf; C_0805_2012Metric
C28, C29: 2u2; C_0603_1608Metric
D2: LED_GKRB; LED_D5.0mm-4_RGB
D3, D4, D5, D6: LED; LED_0805_2012Metric
F1: 2a; Fuse_1206_3216Metric
F2: 200ma; Fuse_1206_3216Metric
FB1: 600 @600mhz; L_0603_1608Metric
FB2: 600 @ 600MHz; L_0603_1608Metric
H1, H2, H3, H4, H5, H6, H7, H8, H9, H10, H11, H12, H13, H14, H15, H16: MountingHole_Pad; MountingHole_2.2mm_M2_Pad
J1: USB_B_Micro; USB_Micro-B_Amphenol_10104110_Horizontal
J2: Servo1; PinHeader_1x03_P2.54mm_Vertical
J3: Servo2; PinHeader_1x03_P2.54mm_Vertical
J4: Servo3; PinHeader_1x03_P2.54mm_Vertical
J5: Servo4; PinHeader_1x03_P2.54mm_Vertical
J6: Screw_Terminal_01x02; TerminalBlock_TE_282834-2_1x02_P2.54mm_Horizontal
J7: Screw_Terminal_01x04; TerminalBlock_TE_282834-4_1x04_P2.54mm_Horizontal
J8, J10, J15, J16: BOARDTOBOARDB; AXK5S30347YG
J9: MEM2067-02-180-00-A; MEM20670218000A
J11, J12, J13, J14: BOARDTOBOARDF; AXK5S30347YG
J17: Conn_02x04_Odd_Even; PinHeader_2x04_P2.54mm_Vertical
J18: SPI HEADER; PinHeader_2x03_P2.54mm_Vertical
J19: I2C HEADER; PinHeader_1x04_P2.54mm_Vertical
J20: UART HEADER; PinHeader_1x04_P2.54mm_Vertical
JP1: Servo Power; SolderJumper-3_P1.3mm_Bridged12_RoundedPad1.0x1.5mm
JP2: I2C POWER; SolderJumper-3_P1.3mm_Bridged12_RoundedPad1.0x1.5mm
JP3: UART POWER; SolderJumper-3_P1.3mm_Bridged12_RoundedPad1.0x1.5mm
JP5: SPI Power; SolderJumper-3_P1.3mm_Bridged12_RoundedPad1.0x1.5mm
LS1: PKMCS0909E4000-R1; PKMCS0909E4000R1
Q1: AO3401A; SOT-23-3
Q2, Q3: Q_NMOS_GSD; SOT-23-3
R1: 400; R_0603_1608Metric
R2: 1k5; R_0603_1608Metric
R3: 400; R_0603_1608Metric_Pad0.98x0.95mm_HandSolder
R4: 330; R_0603_1608Metric_Pad0.98x0.95mm_HandSolder
R5, R6: 240; R_0603_1608Metric_Pad0.98x0.95mm_HandSolder
R7, R8, R9, R11, R13, R17, R19: 470; R_0603_1608Metric
R10: 20k; R_0603_1608Metric
R12: 6k; R_0603_1608Metric
R14, R18: 10; R_0603_1608Metric
R15, R16: 2k2; R_0603_1608Metric
SW1: SW_MEC_5E; SW_PUSH_6mm
TP1, TP2, TP3, TP4: Connector; TestPoint_Keystone_5019_Minature
U1, U2: LM317_SOT-223; SOT-223-3_TabPin2
U3: USBLC6-2SC6; SOT-23-6
U4: BMI088; PQFN50P450X300X100-16N
U5: BMP390L; XDCR_BMP390L
U6: W25Q32JVSS; SOIC-8_5.23x5.23mm_P1.27mm
U7: STM32F405RGTx; LQFP-64_10x10mm_P0.5mm
X1: ECS-2520MV-xxx-xx; Oscillator_SMD_ECS_2520MV-xxx-xx-4Pin_2.5x2.0mm

Connections:
+3.3VA: C18.2, C19.2, FB2.1, U7.13 (VDDA), X1.1 (Tri-State), X1.4 (VDD)
+3V3: C3.1, C5.1, C6.1, C7.1, C8.1, C9.2, C10.2, C12.2, C13.2, C14.2, C15.2, C16.2, C17.2, C27.2, FB2.2, J8.1, J9.P4 (VDD), J10.1, J11.2, J12.2, J13.2, J14.2, J15.1, J16.1, J17.6, J17.8, JP2.1 (A), JP3.1 (A), JP5.1 (A), R2.1, R5.1, R8.2, R9.2, R11.2, R15.1, R16.1, R19.2, U1.2 (VO), U4.3 (VDD), U4.7 (PS), U4.11 (VDDIO), U4.14 (CSB1), U5.1 (VDDIO), U5.6 (~CS), U5.10 (VDD), U6.3 (IO2), U6.7 (IO3), U6.8 (VCC), U7.1 (VBAT), U7.19 (VDD), U7.32 (VDD), U7.48 (VDD), U7.64 (VDD)
+5V: C4.1, J8.4, J8.6, J10.4, J10.6, J11.3, J11.5, J12.3, J12.5, J13.3, J13.5, J14.3, J14.5, J15.4, J15.6, J16.4, J16.6, JP1.1 (A), JP2.3 (B), JP3.3 (B), JP5.3 (B), R6.1, U2.2 (VO)
+12P: F2.1, J6.1, J8.8, J8.10, J10.8, J10.10, J11.7, J11.9, J12.7, J12.9, J13.7, J13.9, J14.7, J14.9, J15.8, J15.10, J16.8, J16.10, J17.3, JP1.3 (B), Q1.2 (S), R10.1
+12V: C1.1, C2.1, FB1.2, U1.3 (VI), U2.3 (VI)
+BATT: TP1.1, TP3.1
ACCEL INT1: J8.18, J10.18, J11.17, J12.17, J13.17, J14.17, J15.18, J16.18, U4.16 (INT1), U7.28 (PB2)
ACCEL INT2: J8.16, J10.16, J11.15, J12.15, J13.15, J14.15, J15.16, J16.16, U4.1 (INT2), U7.27 (PB1)
ARM+: J6.2, J7.1, J7.3
BARO INT: J8.24, J10.24, J11.23, J12.23, J13.23, J14.23, J15.24, J16.24, U5.7 (INT/DNC), U7.57 (PB5)
BATT SENSE: R10.2, R12.1, U7.15 (PA1)
BUZZER: LS1.1 (+), U7.58 (PB6)
CS SD: J8.14, J9.P2 (CD/DAT3), J10.14, J11.13, J12.13, J13.13, J14.13, J15.14, J16.14, U7.25 (PC5)
FLASH CS: J8.12, J10.12, J11.11, J12.11, J13.11, J14.11, J15.12, J16.12, U6.1 (~CS), U7.24 (PC4)
GND: C1.2, C2.2, C3.2, C4.2, C5.2, C6.2, C7.2, C8.2, C9.1, C10.1, C11.1, C12.1, C13.1, C14.1, C15.1, C16.1, C17.1, C18.1, C19.1, C20.1, C27.1, C28.2, C29.2, D3.1 (K), D4.1 (K), D5.1 (K), D6.1 (K), H1.1, H2.1, H3.1, H4.1, H5.1, H6.1, H7.1, H8.1, H9.1, H10.1, H11.1, H12.1, H13.1, H14.1, H15.1, H16.1, J1.5 (GND), J2.3, J3.3, J4.3, J5.3, J8.29, J8.30, J9.P6 (VSS), J10.29, J10.30, J11.29, J11.30, J12.29, J12.30, J13.29, J13.30, J14.29, J14.30, J15.29, J15.30, J16.29, J16.30, J17.5, J17.7, J18.3, J19.4, J20.4, LS1.2 (-), Q1.1 (G), Q2.2 (S), Q3.2 (S), R1.2, R4.2, R7.1, R12.2, R13.1, R17.1, SW1.1, TP2.1, U3.2 (GND), U4.4 (GNDA), U4.6 (GNDIO), U4.10 (SDO2), U4.15 (SDO1), U5.3 (VSS/GND), U5.5 (SDO/DNC/SA0), U5.8 (VSS/GND__1), U5.9 (VSS/GND__2), U6.4 (GND), U7.12 (VSSA), U7.18 (VSS), U7.63 (VSS), X1.2 (GND)
GYRO INT3: J8.20, J10.20, J11.19, J12.19, J13.19, J14.19, J15.20, J16.20, U4.12 (INT3), U7.55 (PB3)
GYRO INT4: J8.22, J10.22, J11.21, J12.21, J13.21, J14.21, J15.22, J16.22, U4.13 (INT4), U7.56 (PB4)
I2C POWER: J19.1, JP2.2 (C)
LED BLUE: D2.4 (BA), U7.59 (PB7)
LED GREEN: D2.1 (GA), U7.61 (PB8)
LED RED: D2.3 (RA), U7.62 (PB9)
MISO: J8.23, J9.P7 (DAT0), J10.23, J11.24, J12.24, J13.24, J14.24, J15.23, J16.23, J18.5, U6.2 (DO(IO1)), U7.22 (PA6)
MOSI: J8.25, J9.P3 (CMD), J10.25, J11.26, J12.26, J13.26, J14.26, J15.25, J16.25, J18.6, U6.5 (DI(IO0)), U7.23 (PA7)
unnamed: D2.2 (K), R7.2
unnamed: D3.2 (A), R11.1
unnamed: D4.2 (A), R8.1
unnamed: D5.2 (A), R9.1
unnamed: D6.2 (A), R19.1
unnamed: F2.2, FB1.1
unnamed: F1.2, Q1.3 (D)
unnamed: Q2.3 (D), R14.2
unnamed: Q3.3 (D), R18.2
unnamed: R3.2, R4.1
unnamed: R1.1, R5.2, U1.1 (ADJ)
unnamed: R3.1, R6.2, U2.1 (ADJ)
unnamed: C29.1, U7.31 (VCAP_1)
unnamed: C28.1, U7.47 (VCAP_2)
OSCIN: U7.5 (PH0), X1.3 (OUT)
P1 EN: J8.26, J10.26, J11.25, J12.25, J13.25, J14.25, J15.26, J16.26, Q3.1 (G), R17.2, U7.33 (PB12)
P1-: J7.2, R18.1
P2 EN: J8.28, J10.28, J11.27, J12.27, J13.27, J14.27, J15.28, J16.28, Q2.1 (G), R13.2, U7.34 (PB13)
P2-: J7.4, R14.1
PB14: J8.27, J10.27, J11.28, J12.28, J13.28, J14.28, J15.27, J16.27, J17.1, U7.35 (PB14)
PB15: J8.7, J10.7, J11.8, J12.8, J13.8, J14.8, J15.7, J16.7, J17.2, U7.36 (PB15)
PC8: J8.2, J10.2, J11.1, J12.1, J13.1, J14.1, J15.2, J16.2, J18.2, U7.39 (PC8)
RESET: C11.2, SW1.2, U7.7 (NRST)
SCK: J8.21, J9.P5 (CLK), J10.21, J11.22, J12.22, J13.22, J14.22, J15.21, J16.21, J18.4, U6.6 (CLK), U7.21 (PA5)
SCL: J8.11, J10.11, J11.12, J12.12, J13.12, J14.12, J15.11, J16.11, J19.3, R15.2, U4.8 (SCL/SCK), U5.2 (SCK/SCL), U7.29 (PB10)
SDA: J8.9, J10.9, J11.10, J12.10, J13.10, J14.10, J15.9, J16.9, J19.2, R16.2, U4.9 (SDA/SDI), U5.4 (SDI/SDO/SDA), U7.30 (PB11)
SERVO1: J2.1, J8.13, J10.13, J11.14, J12.14, J13.14, J14.14, J15.13, J16.13, U7.37 (PC6)
SERVO2: J3.1, J8.15, J10.15, J11.16, J12.16, J13.16, J14.16, J15.15, J16.15, U7.38 (PC7)
SERVO3: J4.1, J8.17, J10.17, J11.18, J12.18, J13.18, J14.18, J15.17, J16.17, U7.40 (PC9)
SERVO4: J5.1, J8.19, J10.19, J11.20, J12.20, J13.20, J14.20, J15.19, J16.19, U7.26 (PB0)
SERVOPOWER: C20.2, J2.2, J3.2, J4.2, J5.2, JP1.2 (C)
SPI POWER: J18.1, JP5.2 (C)
TOGGLED12V: F1.1, TP4.1
UART POWER: J20.1, JP3.2 (C)
USART2 RX: J8.5, J10.5, J11.6, J12.6, J13.6, J14.6, J15.5, J16.5, J20.3, U7.17 (PA3)
USART2 TX: J8.3, J10.3, J11.4, J12.4, J13.4, J14.4, J15.3, J16.3, J20.2, U7.16 (PA2)
USB CON D+: J1.3 (D+), R2.2, U3.3 (I/O2)
USB CON D-: J1.2 (D-), U3.1 (I/O1)
USB D+: U3.4 (I/O2), U7.45 (PA12)
USB D-: U3.6 (I/O1), U7.44 (PA11)
VBUS: J1.1 (VBUS), U3.5 (VBUS)
