prs2026/Lyra-flight-computer/Hardware/kicad/Lyra_flight_computer/lyra flight comp/wolf flight compog.kicad_pcb

## KiCad design Hardware/kicad/Lyra_flight_computer/lyra flight comp/wolf flight compog.kicad_pcb (2023-11-15)

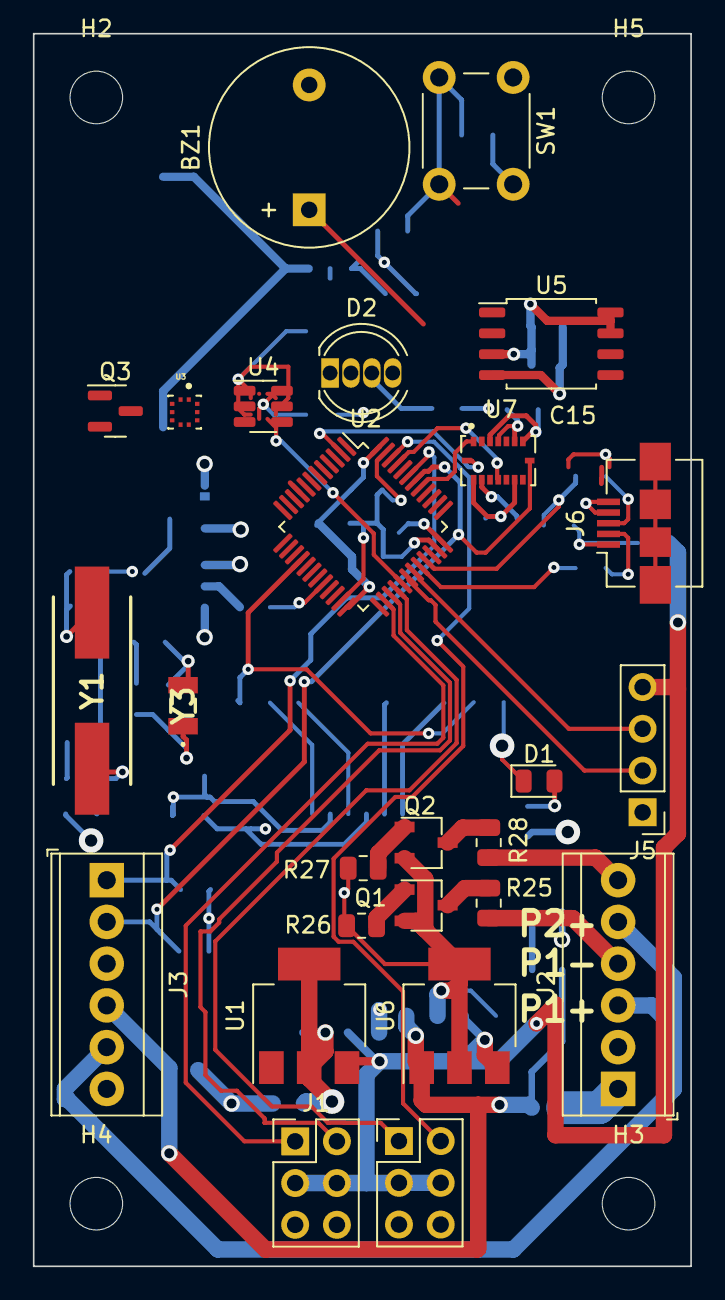
[picture p88: board wolf flight compog.kicad_pcb from above]

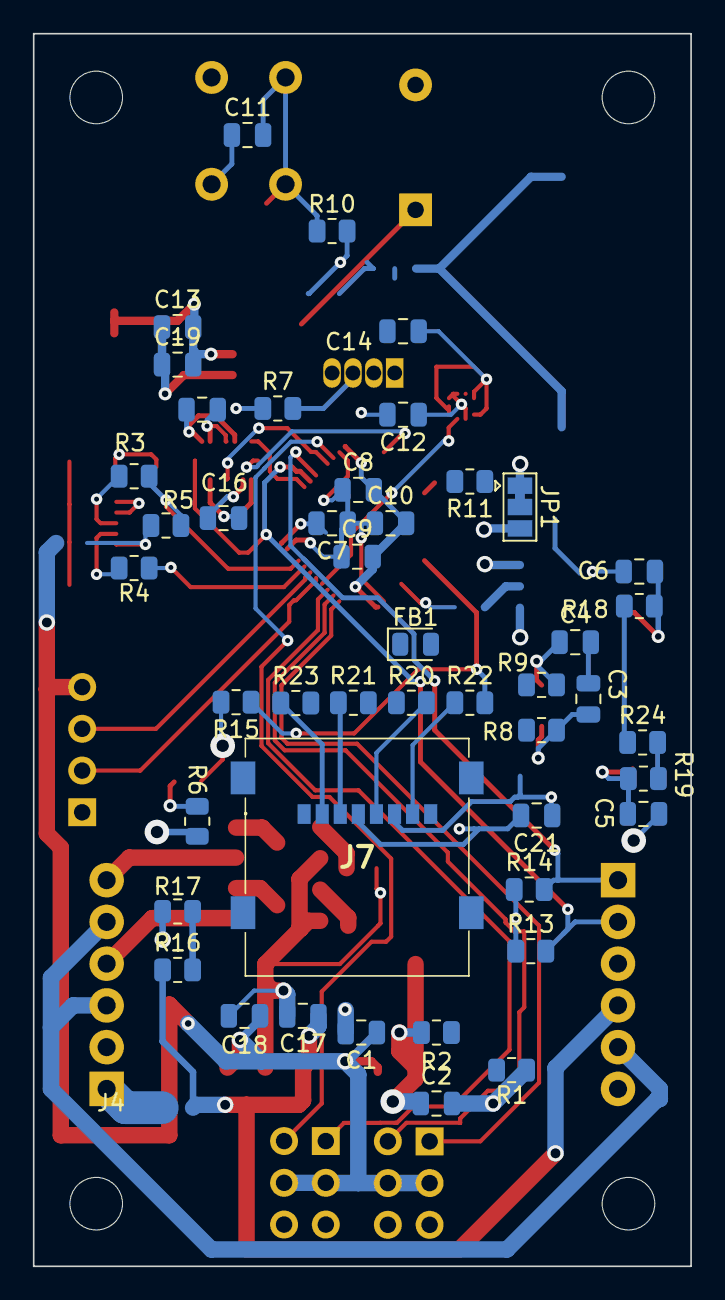
[picture p89: board wolf flight compog.kicad_pcb from below]

Board: 4 copper layers, 40.0 x 75.0 mm, 76 parts (46 on the bottom side), 58 nets.

Parts:
BZ1: Buzzer; Buzzer_12x9.5RM7.6
C1, C12, C13, C14, C15, C16, C17: 0.1uf; C_0805_2012Metric
C2, C18, C19, C21: 1uf; C_0805_2012Metric
C3, C4, C5, C6: 20pf; C_0805_2012Metric
C7: 10uf; C_0805_2012Metric
C8, C9, C10, C11: 100nf; C_0805_2012Metric
D1: LED; LED_0805_2012Metric
D2: LED_RBKG; LED_D5.0mm-4_RGB
FB1: FerriteBead; D_0805_2012Metric
H2, H3, H4, H5: MountingHole; MountingHole_3.2mm_M3
J1, J4: Conn_02x03_Top_Bottom; PinHeader_2x03_P2.54mm_Vertical
J2, J3: Screw_Terminal_01x06; TerminalBlock_TE_282834-6_1x06_P2.54mm_Horizontal
J5: Conn_01x04; PinHeader_1x04_P2.54mm_Vertical
J6: USB_B_Micro; USB_Micro-B_Amphenol_10104110_Horizontal
J7: MEM2067-02-180-00-A; MEM20670218000A
JP1: SolderJumper_3_Bridged12; SolderJumper-3_P1.3mm_Bridged12_Pad1.0x1.5mm
Q1, Q2: Q_NMOS_GSD; TSOT-23
Q3: AO3401A; SOT-23
R1: 390; R_0805_2012Metric
R2: 240; R_0805_2012Metric
R3, R4: 20; R_0805_2012Metric
R5: 1k5; R_0805_2012Metric
R6, R7, R26, R27: 470; R_0805_2012Metric
R8, R9, R18, R19: 0; R_0805_2012Metric
R10, R13, R14, R16, R17: 10k; R_0805_2012Metric
R11: 100K; R_0805_2012Metric
R15: 100k; R_0805_2012Metric
R20, R21, R22, R23: 3.3k; R_0805_2012Metric
R24: 1M; R_0805_2012Metric
R25, R28: 10; R_0805_2012Metric
SW1: SW_MEC_5E; SW_PUSH_6mm_H5mm
U1: LM317_SOT-223; SOT-223-3_TabPin2
U2: STM32F103C8Tx; LQFP-48_7x7mm_P0.5mm
U3: BMP390L; XDCR_BMP390L
U4: USBLC6-2SC6; SOT-23-6
U5: W25Q32JVSS; SOIC-8_5.23x5.23mm_P1.27mm
U6: LM7805_TO220; SOT-223-3_TabPin2
U7: BMI088; PQFN50P450X300X100-16N
Y1: ABLS-8.000MHZ-20-B-3-H-T; ABLS8000MHz20B3HT
Y3: SC32S-7PF20PPM; SC32S7PF20PPM

Connections:
+3V3: C2.1, C7.2, C8.2, C9.2, C10.2, C12.1, C13.2, C14.1, C15.1, C16.1, C19.2, C21.2, J7.P4 (VDD), JP1.3 (B), R2.1, R5.1, R6.2, R10.2, R13.1, R14.1, U1.2 (VO), U2.1 (VBAT), U2.24 (VDD), U2.36 (VDD), U2.48 (VDD), U3.1 (VDDIO), U3.6 (~CS), U3.10 (VDD), U5.3 (IO2), U5.7 (IO3), U5.8 (VCC), U7.3 (VDD), U7.7 (PS), U7.11 (VDDIO), U7.14 (CSB1)
+5V: C1.1, C18.1, J1.3, J1.4, J4.3, J4.4, J5.4, U1.3 (VI), U6.3 (VO)
+BATT: J2.1, J3.4, Q3.3 (D), R16.1
ACCEL INT1: U2.2 (PC13), U7.16 (INT1)
ACCEL INT2: U2.41 (PB5), U7.1 (INT2)
ARM-: J2.3, J2.5, J3.5
BARO INT: U2.29 (PA8), U3.7 (INT/DNC)
BATT SENSE: R16.2, R17.1
BOOT0: R11.2, U2.44 (BOOT0)
BUZZER: BZ1.1 (-), U2.18 (PB0)
CS SD: R23.2, U2.10 (PA0)
FLASH CS: U2.14 (PA4), U5.1 (~CS)
GND: BZ1.2 (+), C1.2, C2.2, C5.1, C6.2, C7.1, C8.1, C9.1, C10.1, C11.1, C12.2, C13.1, C14.2, C15.2, C16.2, C17.2, C18.2, C19.1, C21.1, D1.1 (K), J1.5, J1.6, J2.2, J3.3, J4.5, J4.6, J5.1, J6.4 (ID), J6.5 (GND), J7.P6 (VSS), JP1.1 (A), Q1.2 (S), Q2.2 (S), Q3.1 (G), R1.2, R7.1, R15.2, R17.2, R26.1, R27.1, SW1.1, U2.8 (VSSA), U2.23 (VSS), U2.35 (VSS), U2.47 (VSS), U3.3 (VSS/GND), U3.5 (SDO/DNC/SA0), U3.8 (VSS/GND__1), U3.9 (VSS/GND__2), U5.4 (GND), U6.2 (GND), U7.4 (GNDA), U7.6 (GNDIO), U7.10 (SDO2), U7.15 (SDO1)
GYRO INT3: U2.45 (PB8), U7.12 (INT3)
GYRO INT4: U2.25 (PB12), U7.13 (INT4)
LED BLUE: D2.4 (GA), U2.12 (PA2)
LED GREEN: D2.2 (BA), U2.13 (PA3)
LED RED: D2.1 (RA), U2.11 (PA1)
MISO: R15.1, R22.2, U2.16 (PA6), U5.2 (DO(IO1))
MOSI: R21.2, U2.17 (PA7), U5.5 (DI(IO0))
unnamed: C3.1, C4.2
unnamed: C3.2, R8.1, Y3.1
unnamed: C5.2, R19.1, Y1.2
unnamed: C6.1, R18.1, Y1.1
unnamed: D1.2 (A), R6.1
unnamed: D2.3 (K), R7.2
unnamed: J6.3 (D+), R3.2
unnamed: J6.2 (D-), R4.1
unnamed: J7.P2 (CD/DAT3), R23.1
unnamed: J7.P5 (CLK), R20.2
unnamed: J7.P3 (CMD), R21.1
unnamed: J7.P7 (DAT0), R22.1
unnamed: JP1.2 (C), R11.1
unnamed: Q1.3 (D), R25.2
unnamed: Q2.3 (D), R28.2
unnamed: C17.1, Q3.2 (S), U6.1 (VI)
unnamed: R1.1, R2.2, U1.1 (ADJ)
unnamed: C4.1, R9.1, Y3.2 (CRYSTAL_2)
OSCIN: R19.2, R24.2, U2.5 (PD0)
OSCIN2: R8.2, U2.3 (PC14)
OSCOUT: R18.2, R24.1, U2.6 (PD1)
OSCOUT2: R9.2, U2.4 (PC15)
P1-: J2.4, R25.1
P1EN: Q1.1 (G), R26.2
P2-: J2.6, R28.1
P2EN: Q2.1 (G), R27.2
RESET: C11.2, R10.1, SW1.2, U2.7 (NRST)
SCK: R20.1, U2.15 (PA5), U5.6 (CLK)
SCL: J3.2, R13.2, U2.42 (PB6), U3.2 (SCK/SCL), U7.8 (SCL/SCK)
SDA: J3.1, R14.2, U2.43 (PB7), U3.4 (SDI/SDO/SDA), U7.9 (SDA/SDI)
SERVO1: J1.1, U2.26 (PB13)
SERVO2: J1.2, U2.27 (PB14)
SERVO3: J4.1, U2.28 (PB15)
SERVO4: J4.2, U2.46 (PB9)
USART1 RX: J5.3, U2.31 (PA10)
USART1 TX: J5.2, U2.30 (PA9)
USB D+: R3.1, R5.2, U2.33 (PA12)
USB D-: R4.2, U2.32 (PA11)
