prs2026/Lyra-flight-computer/avionics/kicad/Lyra_flight_computer/lyra V3/Lyrav3og.kicad_pcb

## KiCad design avionics/kicad/Lyra_flight_computer/lyra V3/Lyrav3og.kicad_pcb (2023-11-27)

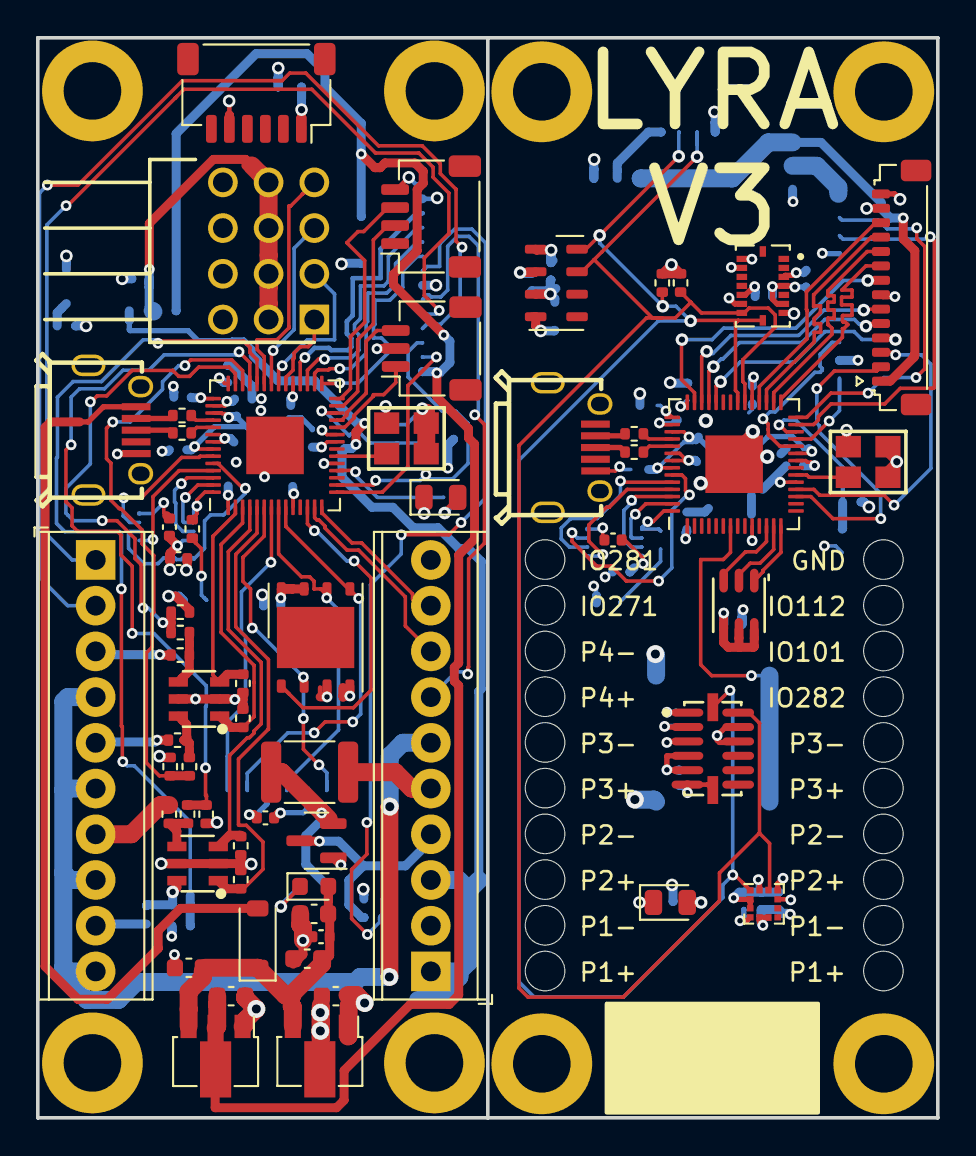
[picture p90: board Lyrav3og.kicad_pcb from above]

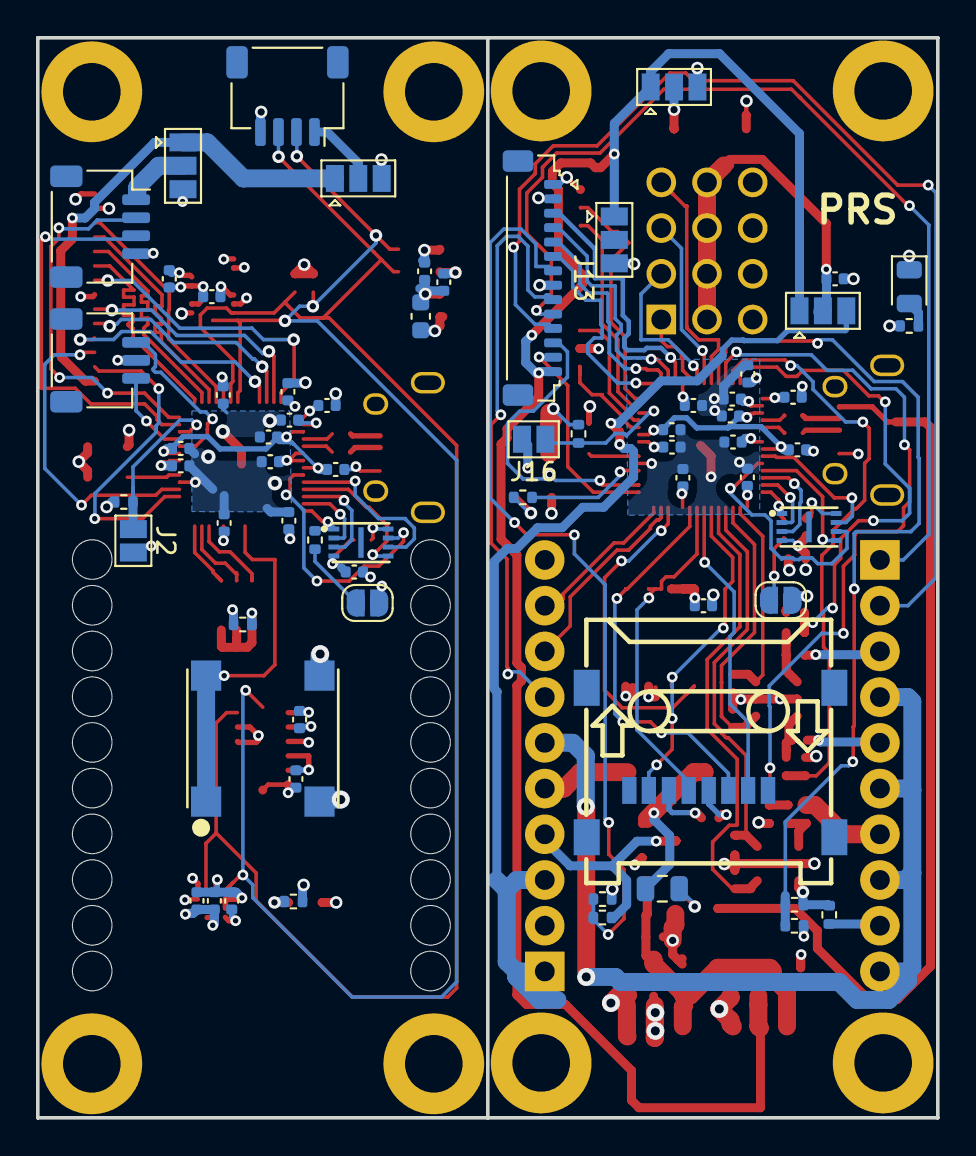
[picture p91: board Lyrav3og.kicad_pcb from below]

Board: 4 copper layers, 50.0 x 60.0 mm, 135 parts (66 on the bottom side), 114 nets.

Parts:
BUZZER1: MLT-7525; BUZ-SMD_4P-L7.5-W7.5-P7.59-TL
C1, C6, C7, C8, C9, C13, C15, C17, C19, C20, C21, C24, C25, C26, C27, C28, C29, C30, C32, C35, C38, C39, C40, C41, C42, C43, C44, C46: 100n; C_0402_1005Metric
C2, C3, C4, C5: 22u; C_0603_1608Metric
C10, C11: 10u; C_0603_1608Metric
C12, C14, C16, C22, C23, C33, C34, C36, C37: 1u; C_0402_1005Metric
C31, C45: 2u2; C_0402_1005Metric
Card2: TF-002-H18; SIM-SMD_TF-002-H18
D1: D_Small; D_SOD-123
D2, D3, D4: LED; LED_0805_2012Metric
F1: 2a; Fuse_1812_4532Metric
F2: 200ma; Fuse_0805_2012Metric
FB1: FerriteBead_Small; D_0603_1608Metric
H1, H2, H3, H4, H5, H6, H7, H8: MountingHole_Pad; MountingHole_3.2mm_M3_DIN965_Pad
H9, H10: Access Hole; 1x10 2.54mm pitch acess hole
J1, J3, J5: Conn_01x04; JST_SH_SM04B-SRSS-TB_1x04-1MP_P1.00mm_Horizontal
J2, J16: Conn_01x02; SolderJumper-2_P1.3mm_Open_Pad1.0x1.5mm
J4, J17: Conn_01x03; JST_SH_SM03B-SRSS-TB_1x03-1MP_P1.00mm_Horizontal
J6, J15: USB_B_Micro; MICRO-USB-SMD_U254-051T-4BHJ25-F2S
J7: Conn_02x03_Odd_Even; JST_SH_SM06B-SRSS-TB_1x06-1MP_P1.00mm_Horizontal
J8, J13: Conn_01x14; JST_SUR_SM14B-SURS-TF_1x14-1MP_P0.80mm_Horizontal
J9, J12: Conn_01x02; SolderJumper-2_P1.3mm_Open_RoundedPad1.0x1.5mm
J10: TSW-104-08-T-T-RA; HDRRA12W64P254_3X4_1016X254X810P
J11, J18: Screw_Terminal_01x10; TerminalBlock_Phoenix_MPT-0,5-10-2.54_1x10_P2.54mm_Horizont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
JP1, JP2, JP3, JP4, JP5: SolderJumper_3_Open; SolderJumper-3_P1.3mm_Open_Pad1.0x1.5mm
LED1: FM-Z2727RGBA-SH; LED-SMD_6P-L2.7-W2.8-TL
Q1: AO3401A; SOT-23
Q2, Q3: KY6802; SOT-23-6_L2.9-W1.6-P0.95-LS2.8-BL
R1, R4, R26, R27, R28, R32: 1k; R_0402_1005Metric
R2, R7, R8, R17, R18: 20k; R_0402_1005Metric
R3, R9, R10, R19, R20: 6k; R_0402_1005Metric
R5, R6, R15, R16: 10R; R_0402_1005Metric
R11, R12, R23, R24: 470R; R_0402_1005Metric
R13, R14: 2k2; R_0402_1005Metric
R21, R22, R29, R30: 27R; R_0402_1005Metric
R25, R31: 10k; R_0402_1005Metric
U1: AMS1117-5.0; SOT-89-3
U2: AMS1117-3.3; SOT-89-3
U3: W25Q32JVZP; WSON-8-1EP_6x5mm_P1.27mm_EP3.4x4.3mm
U4: BMI088; PQFN50P450X300X100-16N
U5: MPL3115A2; NXP_LGA-8_3x5mm_P1.25mm_H1.1mm
U6: ADXL375BCCZ-RL7; LGA-14_L5.0-W3.0-P0.80-BL
U7: LIS3MDL; LGA-12_2x2mm_P0.5mm
U8, U10: RP2040; QFN-56-1EP_7x7mm_P0.4mm_EP3.2x3.2mm
U9, U11: W25Q16JVUXIQ; USON-8_L3.0-W2.0-P0.50-BL-EP
X1, X2: S3D12.288000B20F30T; OSC-SMD_4P-L3.2-W2.5-BL_SIT8008BI

Connections:
+1V1: C20.1, C21.1, C22.1, U8.23 (DVDD), U8.45 (VREG_VOUT), U8.50 (DVDD)
+1V2: C6.1, C35.1, C36.1, U10.23 (DVDD), U10.45 (VREG_VOUT), U10.50 (DVDD)
+3V3: C1.1, C5.1, C7.1, C8.1, C9.1, C10.1, C14.1, C15.1, C16.1, C17.1, C23.1, C24.1, C25.1, C26.1, C27.1, C28.1, C29.1, C30.1, C31.1, C32.1, C34.2, C37.1, C38.1, C39.1, C40.1, C41.1, C42.1, C43.1, C44.1, C45.1, C46.1, Card2.4 (VDD), J8.13, J13.2, JP1.3 (B), JP2.3 (B), JP3.3 (B), JP4.3 (B), R1.2, R4.2, R13.1, R14.1, R25.1, R27.2, R31.1, U2.2 (VO), U3.3 (IO2), U3.7 (IO3), U3.8 (VCC), U4.3 (VDD), U4.7 (PS), U4.11 (VDDIO), U4.14 (CSB1), U5.1 (VDD), U5.4 (VDDIO), U6.1 (VDDI/O), U6.3 (RESERVED), U6.6 (VS), U6.7 (~CS), U7.5 (Vdd), U7.6 (Vdd_IO), U7.10 (~CS), U8.1 (IOVDD), U8.10 (IOVDD), U8.22 (IOVDD), U8.33 (IOVDD), U8.42 (IOVDD), U8.43 (ADC_AVDD), U8.44 (VREG_IN), U8.48 (USB_VDD), U8.49 (IOVDD), U9.8 (VCC), U10.1 (IOVDD), U10.10 (IOVDD), U10.22 (IOVDD), U10.33 (IOVDD), U10.42 (IOVDD), U10.43 (ADC_AVDD), U10.44 (VREG_IN), U10.48 (USB_VDD), U10.49 (IOVDD), U11.8 (VCC), X1.1 (Tri-state), X1.4 (VDD), X2.1 (Tri-state), X2.4 (VDD)
+5V: J8.1, JP2.1 (A), JP3.1 (A)
+5VD: C3.1, J13.14, JP1.1 (A), JP4.1 (A), JP5.1 (A), U1.2 (VO)
+12P: F1.2, J18.5
+12V: J18.4, Q1.3 (D), R2.1
+12VA: C2.1, C4.1, C11.1, C12.1, D1.1 (K), FB1.2, U1.3 (VI), U2.3 (VI)
+BATT: J18.1, J18.3, JP5.3 (B)
/ BOT RP USB_D+: R29.2, U10.47 (USB_DP)
/BATT SENSE: J8.8, U8.41 (GPIO29_ADC3)
/BATT SENSE BOT: J13.7, R2.2, R3.1
/BOOTSEL: J9.2, R26.2
/BOOTSEL BOT: J12.2, R32.2
/BOT RP USB_D-: R30.1, U10.46 (USB_DM)
/BOT USB_D+: J15.3 (D+), R29.1
/BOT USB_D-: J15.2 (D-), R30.2
/BRKOUT CS BOT: J7.6, U10.11 (GPIO8)
/BUZZER: BUZZER1.1 (+), BUZZER1.4, U8.7 (GPIO5)
/FLASH CS BOT: U3.1 (~CS), U10.12 (GPIO9)
/GPIO26: J8.4, U8.38 (GPIO26_ADC0)
/GPIO26 BOT: J11.2, J13.11
/GPIO27: J8.5, U8.39 (GPIO27_ADC1)
/GPIO27 BOT: J11.1, J13.10
/GPIO28: J8.6, U8.40 (GPIO28_ADC2)
/GPIO28 BOT: J13.9, J18.7
/GPIO 102 BOT: J18.8, U10.13 (GPIO10)
/GPIO 112 BOT: J18.9, U10.14 (GPIO11)
/I2C1 SCL: J3.2, R13.2, U4.8 (SCL/SCK), U5.8 (SCL), U6.14 (SCL/SCLK), U7.1 (SCL/SPC), U8.35 (GPIO23)
/I2C1 SDA: J3.3, R14.2, U4.9 (SDA/SDI), U5.7 (SDL), U6.13 (SDA/SDI/SDIO), U7.11 (SDA/SDI/SDO), U8.34 (GPIO22)
/I2C PWR: J3.1, JP2.2 (C)
/INT12: J8.3, U8.18 (GPIO15)
/INT12 BOT: J13.12, U10.16 (GPIO13)
/INT21: J8.2, U8.17 (GPIO14)
/INT21 BOT: J13.13, U10.15 (GPIO12)
/LED BOT: R28.2, U10.18 (GPIO15)
/LEDBLUE: LED1.1 (-), U8.14 (GPIO11)
/LEDGREEN: LED1.2 (-), U8.13 (GPIO10)
/LEDRED: LED1.3 (-), U8.12 (GPIO9)
/P1 CONT BOT: R7.2, R9.1, U10.38 (GPIO26_ADC0)
/P1 EN BOT: Q2.1 (G), R11.2, U10.5 (GPIO3)
/P1-: J11.9, R5.1
/P2 CONT BOT: R17.2, R19.1, U10.39 (GPIO27_ADC1)
/P2 EN BOT: Q2.3 (G), R23.2, U10.4 (GPIO2)
/P2-: J11.7, R15.1
/P3 CONT BOT: R8.2, R10.1, U10.40 (GPIO28_ADC2)
/P3 EN BOT: Q3.1 (G), R12.2, U10.3 (GPIO1)
/P3-: J11.5, R6.1
/P4 CONT BOT: R18.2, R20.1, U10.41 (GPIO29_ADC3)
/P4 EN BOT: Q3.3 (G), R24.2, U10.2 (GPIO0)
/P4-: J11.3, R16.1
/PYRO PWR: J11.4, J11.6, J11.8, J11.10, J18.6
/QSPI_SCLK: U8.52 (QSPI_SCLK), U9.6 (CLK)
/QSPI_SCLK BOT: U10.52 (QSPI_SCLK), U11.6 (CLK)
/QSPI_SD1: U8.55 (QSPI_SD1), U9.2 (DO(IO1))
/QSPI_SD1 BOT: U10.55 (QSPI_SD1), U11.2 (DO(IO1))
/QSPI_SD2: U8.54 (QSPI_SD2), U9.3 (WP#(IO2))
/QSPI_SD2 BOT: U10.54 (QSPI_SD2), U11.3 (WP#(IO2))
/QSPI_SD3: U8.51 (QSPI_SD3), U9.7 (HOLD#orRESET#(IO3))
/QSPI_SD3 BOT: U10.51 (QSPI_SD3), U11.7 (HOLD#orRESET#(IO3))
/QSPI_SDO: U8.53 (QSPI_SD0), U9.5 (DI(IO0))
/QSPI_SDO BOT: U10.53 (QSPI_SD0), U11.5 (DI(IO0))
/QSPI_SS: R26.1, U8.56 (QSPI_SS), U9.1 (~CS)
/QSPI_SS BOT: R32.1, U10.56 (QSPI_SS), U11.1 (~CS)
/RP USB_D+: R21.2, U8.47 (USB_DP)
/RP USB_D-: R22.1, U8.46 (USB_DM)
/RUN: J2.1, R25.2, U8.26 (RUN)
/RUN BOT: J16.1, R31.2, U10.26 (RUN)
/SD CS BOT: Card2.2 (CD/DAT3), U10.7 (GPIO5)
/SERVO1: J10.1, U10.34 (GPIO22)
/SERVO2: J10.4, U10.35 (GPIO23)
/SERVO3: J10.7, U10.36 (GPIO24)
/SERVO4: J10.10, U10.37 (GPIO25)
/SERVO PWR: C33.1, J10.2, J10.5, J10.8, J10.11, JP5.2 (C)
/SPI0 CSn: J8.12, U8.32 (GPIO21)
/SPI0 CSn BOT: J13.3, U10.32 (GPIO21)
/SPI0 MISO: J8.10, U8.30 (GPIO19)
/SPI0 MISO BOT: J13.5, U10.30 (GPIO19)
/SPI0 MOSI: J8.11, U8.31 (GPIO20)
/SPI0 MOSI BOT: J13.4, U10.31 (GPIO20)
/SPI0 SCK: J8.9, U8.29 (GPIO18)
/SPI0 SCK BOT: J13.6, U10.29 (GPIO18)
/SPI1 MISO BOT: Card2.7 (DAT0), J7.4, U3.2 (DO(IO1)), U10.6 (GPIO4)
/SPI1 MOSI BOT: Card2.3 (CMD), J7.3, U3.5 (DI(IO0)), U10.9 (GPIO7)
/SPI1 PWR BOT: J7.1, JP4.2 (C)
/SPI1 SCLK BOT: Card2.5 (CLX), J7.2, U3.6 (CLK), U10.8 (GPIO6)
/SWCLK: J4.1, U8.24 (SWCLK)
/SWCLK BOT: J17.1, U10.24 (SWCLK)
/SWD: J4.3, U8.25 (SWD)
/SWD BOT: J17.3, U10.25 (SWD)
/UART0 RX: J5.2, U8.28 (GPIO17)
/UART0 RX BOT: J1.3, U10.28 (GPIO17)
/UART0 TX: J5.3, U8.27 (GPIO16)
/UART0 TX BOT: J1.2, U10.27 (GPIO16)
/UART PWR: J5.1, JP3.2 (C)
/UART PWR BOT: J1.1, JP1.2 (C)
/USB_D+: J6.3 (D+), R21.1
/USB_D-: J6.2 (D-), R22.2
/XIN: U8.20 (XIN), X1.3 (OUTPUT)
/XIN BOT: U10.20 (XIN), X2.3 (OUTPUT)
GND: BUZZER1.2 (-), BUZZER1.3, C1.2, C2.2, C3.2, C4.2, C5.2, C6.2, C7.2, C8.2, C9.2, C10.2, C11.2, C12.2, C13.2, C14.2, C15.2, C16.2, C17.2, C19.2, C20.2, C21.2, C22.2, C23.2, C24.2, C25.2, C26.2, C27.2, C28.2, C29.2, C30.2, C31.2, C32.2, C33.2, C34.1, C35.2, C36.2, C37.2, C38.2, C39.2, C40.2, C41.2, C42.2, C43.2, C44.2, C45.2, C46.2, Card2.6 (VSS), D2.1 (K), D3.1 (K), D4.1 (K), H1.1, H2.1, H3.1, H4.1, H5.1, H6.1, H7.1, H8.1, J1.4, J2.2, J3.4, J4.2, J5.4, J6.5 (GND), J7.5, J8.7, J8.14, J9.1, J10.3, J10.6, J10.9, J10.12, J12.1, J13.1, J13.8, J15.5 (GND), J16.2, J17.2, J18.2, J18.10, Q1.1 (G), Q2.2 (S), Q2.5 (S), Q3.2 (S), Q3.5 (S), R3.2, R9.2, R10.2, R11.1, R12.1, R19.2, R20.2, R23.1, R24.1, U1.1 (GND), U2.1 (GND), U3.4 (GND), U4.4 (GNDA), U4.6 (GNDIO), U4.10 (SDO2), U4.15 (SDO1), U5.3 (GND), U6.2 (GND), U6.4 (GND), U6.5 (GND), U6.11 (RESERVED), U6.12 (SDO/ALTADDRESS), U7.2 (GND), U7.3 (GND), U7.9 (SDO/SA1), U7.12 (GND), U8.19 (TESTEN), U8.57 (GND), U9.4 (GND), U10.19 (TESTEN), U10.57 (GND), U11.4 (GND), X1.2 (GND), X2.2 (GND)
unnamed: D2.2 (A), R1.1
unnamed: D3.2 (A), R27.1
unnamed: D4.2 (A), R28.1
unnamed: F2.2, FB1.1
unnamed: LED1.4 (+), LED1.5 (+), LED1.6 (+), R4.1
unnamed: F1.1, F2.1, Q1.2 (S)
unnamed: Q2.6 (D), R5.2, R7.1
unnamed: Q2.4 (D), R15.2, R17.1
unnamed: Q3.6 (D), R6.2, R8.1
unnamed: Q3.4 (D), R16.2, R18.1
unnamed: C13.1, U5.2 (CAP)
unnamed: C19.1, U7.4 (C1)
VBUS: D1.2 (A), J15.1 (VBUS)
