prs2026/Lyra-flight-computer/Hardware/datasheets/STM32F4_REV2.kicad_sch

## KiCad design Hardware/datasheets/STM32F4_REV2.kicad_sch (2023-11-15)

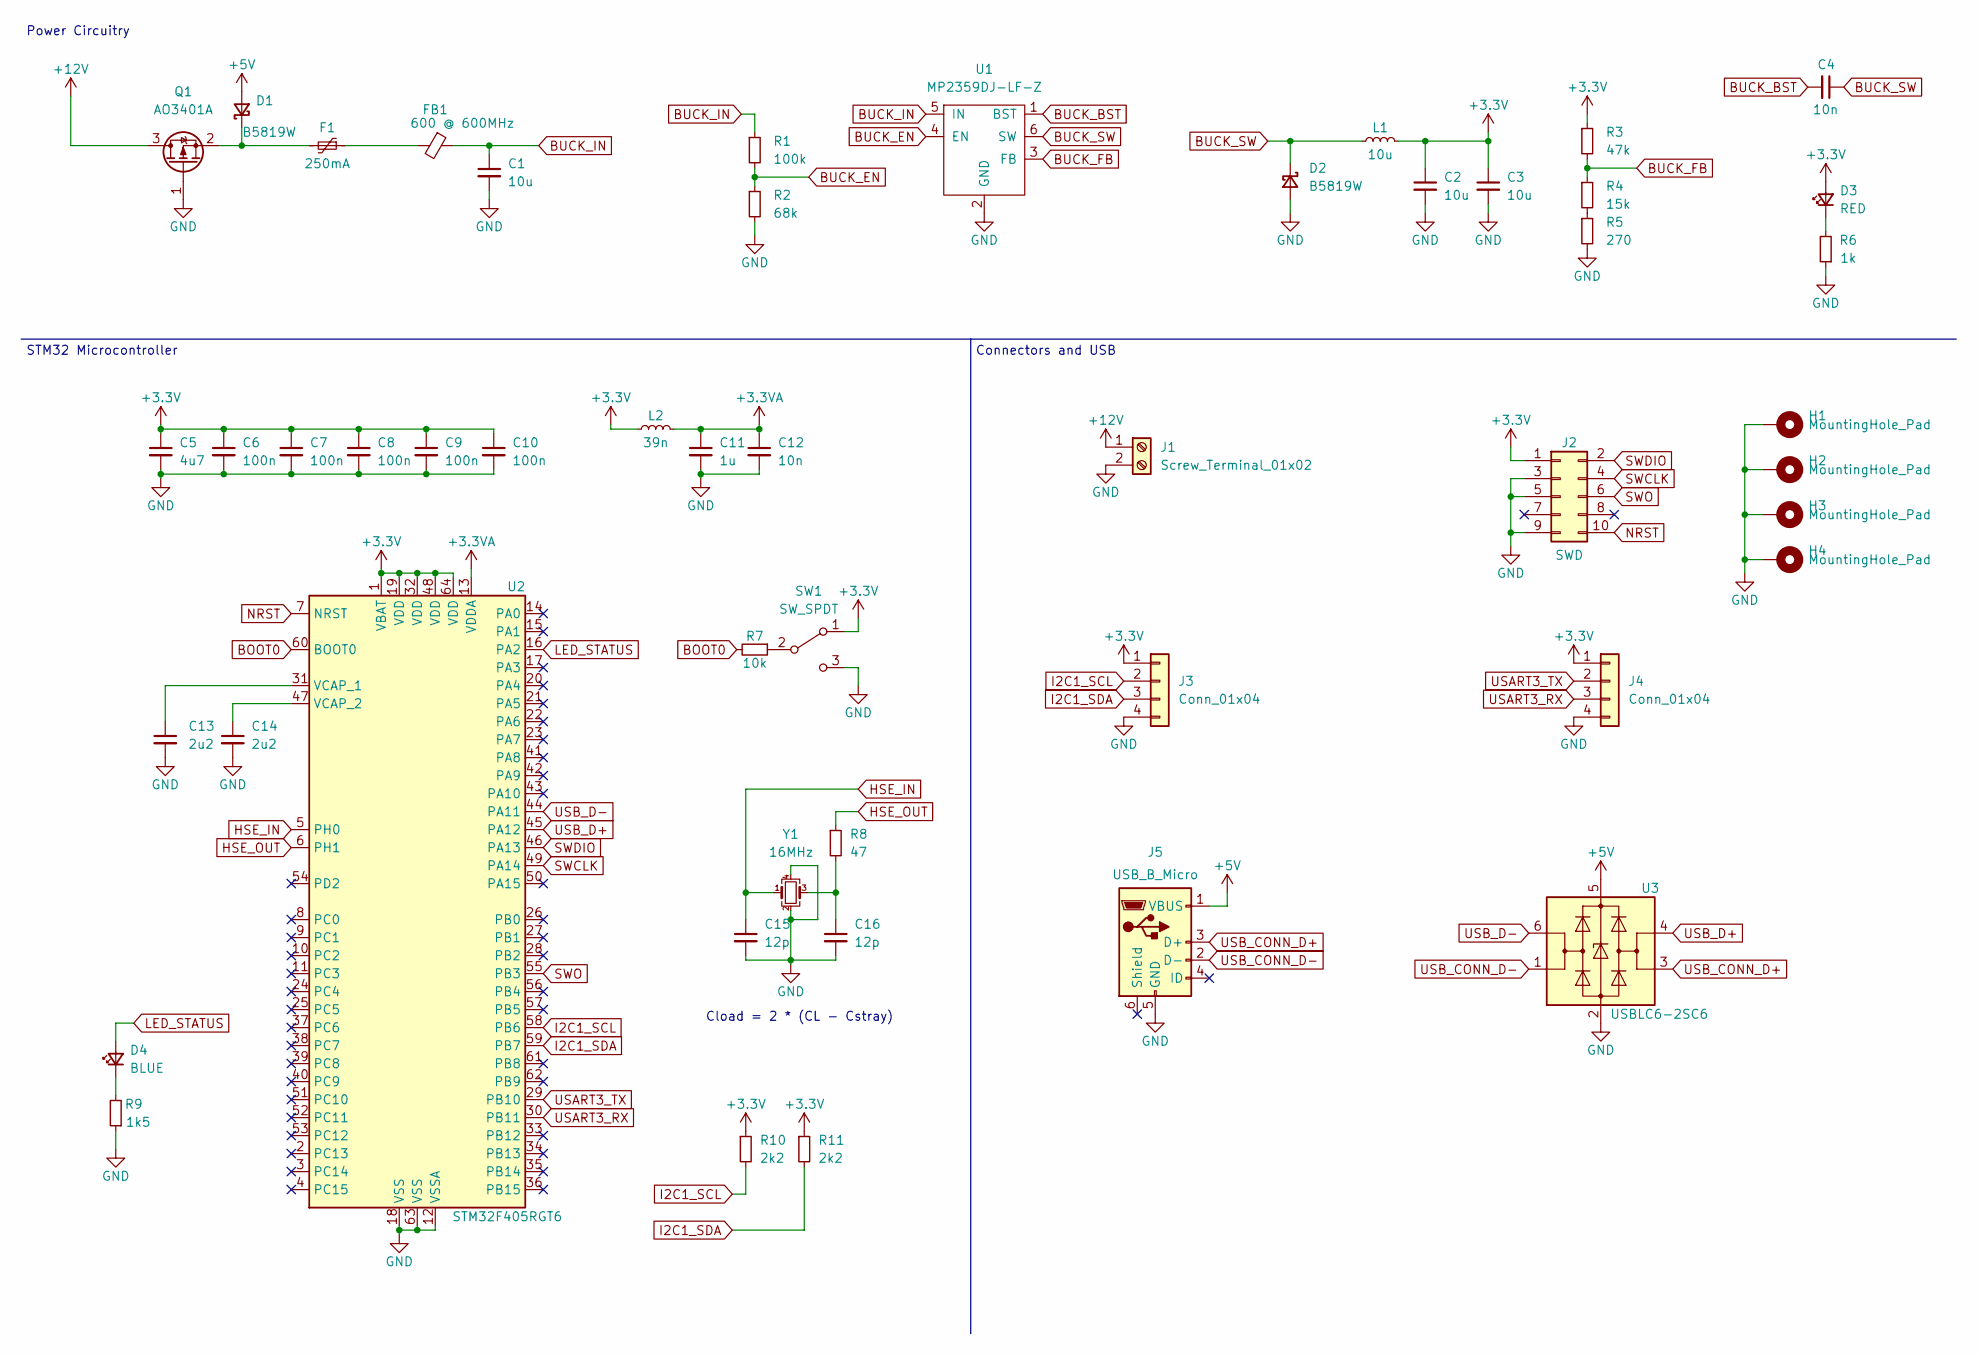
[picture p92: schematic STM32F4_REV2.kicad_sch]

Parts:
C1, C2, C3: 10u; C_1206_3216Metric; LCSC Part # C13585
C4: 10n; C_0603_1608Metric; LCSC Part # C57112
C5: 4u7; C_0603_1608Metric; LCSC Part # C19666
C6, C7, C8, C9, C10: 100n; C_0402_1005Metric; LCSC Part # C1525
C11: 1u; C_0402_1005Metric; LCSC Part # C52923
C12: 10n; C_0402_1005Metric; LCSC Part # C15195
C13, C14: 2u2; C_0603_1608Metric; LCSC Part # C23630
C15, C16: 12p; C_0402_1005Metric; LCSC Part # C1547
D1, D2: B5819W; D_SOD-123; LCSC Part # C8598
D3: RED; LED_0603_1608Metric; LCSC Part # C2286
D4: BLUE; LED_0603_1608Metric; LCSC Part # C72041
F1: 250mA; Fuse_1206_3216Metric; LCSC Part # C369159
FB1: 600 @ 600MHz; L_0805_2012Metric; LCSC Part # C1017
H1, H2, H3, H4: MountingHole_Pad; MountingHole_4.3mm_M4_Pad_Via
J1: Screw_Terminal_01x02; TerminalBlock_Phoenix_PT-1,5-2-3.5-H_1x02_P3.50mm_Horizontal
J2: SWD; PinHeader_2x05_P1.27mm_Vertical_SMD
J3, J4: Conn_01x04; Molex_PicoBlade_53048-0410_1x04_P1.25mm_Horizontal
J5: USB_B_Micro; USB_MICRO_B_101181930001LF
L1: 10u; L_Sunlord_MWSA0518_5.4x5.2mm; LCSC Part # C139506
L2: 39n; L_0402_1005Metric; LCSC Part # C26443
Q1: AO3401A; SOT-23; LCSC Part # C15127
R1: 100k; R_0603_1608Metric; LCSC Part # C25803
R2: 68k; R_0603_1608Metric; LCSC Part # C23231
R3: 47k; R_0603_1608Metric; LCSC Part # C25819
R4: 15k; R_0603_1608Metric; LCSC Part # C22809
R5: 270; R_0603_1608Metric; LCSC Part # C22966
R6: 1k; R_0603_1608Metric; LCSC Part # C21190
R7: 10k; R_0402_1005Metric; LCSC Part # C25744
R8: 47; R_0402_1005Metric; LCSC Part # C25118
R9: 1k5; R_0603_1608Metric; LCSC Part # C22843
R10, R11: 2k2; R_0402_1005Metric; LCSC Part # C25879
SW1: SW_SPDT; SW_SPDT_PCM12
U1: MP2359DJ-LF-Z; SOT-23-6; LCSC Part # C14259
U2: STM32F405RGT6; LQFP-64_10x10mm_P0.5mm; LCSC Part # C15742
U3: USBLC6-2SC6; SOT-23-6; LCSC Part # C7519
Y1: 16MHz; Crystal_SMD_3225-4Pin_3.2x2.5mm; LCSC Part # C13738

Connections:
+3.3V: C2.1, C3.1, C5.1, C6.1, C7.1, C8.1, C9.1, C10.1, D3.2 (A), J2.1, J3.1, J4.1, L1.2, L2.1, R3.1, R10.1, R11.1, SW1.1 (A), U2.1 (VBAT), U2.19 (VDD), U2.32 (VDD), U2.48 (VDD), U2.64 (VDD)
+3.3VA: C11.1, C12.1, L2.2, U2.13 (VDDA)
+5V: D1.2 (A), J5.1 (VBUS), U3.5 (VBUS)
+12V: J1.1, Q1.3 (D)
BOOT0: R7.2, U2.60 (BOOT0)
BUCK_BST: C4.2, U1.1 (BST)
BUCK_EN: R1.2, R2.1, U1.4 (EN)
BUCK_FB: R3.2, R4.1, U1.3 (FB)
BUCK_IN: C1.1, FB1.1, R1.1, U1.5 (IN)
BUCK_SW: C4.1, D2.1 (K), L1.1, U1.6 (SW)
GND: C1.2, C2.2, C3.2, C5.2, C6.2, C7.2, C8.2, C9.2, C10.2, C11.2, C12.2, C13.2, C14.2, C15.2, C16.2, D2.2 (A), H1.1, H2.1, H3.1, H4.1, J1.2, J2.3, J2.5, J2.9, J3.4, J4.4, J5.5 (GND), Q1.1 (G), R2.2, R5.2, R6.1, R9.1, SW1.3 (C), U1.2 (GND), U2.12 (VSSA), U2.18 (VSS), U2.63 (VSS), U3.2 (GND), Y1.2, Y1.4
HSE_IN: C15.1, U2.5 (PH0), Y1.1
HSE_OUT: R8.1, U2.6 (PH1)
I2C1_SCL: J3.2, R10.2, U2.58 (PB6)
I2C1_SDA: J3.3, R11.2, U2.59 (PB7)
LED_STATUS: D4.2 (A), U2.16 (PA2)
NRST: J2.10, U2.7 (NRST)
unnamed: C13.1, U2.31 (VCAP_1)
unnamed: C14.1, U2.47 (VCAP_2)
unnamed: C16.1, R8.2, Y1.3
unnamed: D1.1 (K), F1.2, Q1.2 (S)
unnamed: D3.1 (K), R6.2
unnamed: D4.1 (K), R9.2
unnamed: F1.1, FB1.2
unnamed: R4.2, R5.1
unnamed: R7.1, SW1.2 (B)
SWCLK: J2.4, U2.49 (PA14)
SWDIO: J2.2, U2.46 (PA13)
SWO: J2.6, U2.55 (PB3)
USART3_RX: J4.3, U2.30 (PB11)
USART3_TX: J4.2, U2.29 (PB10)
USB_CONN_D+: J5.3 (D+), U3.3 (I/O2)
USB_CONN_D-: J5.2 (D-), U3.1 (I/O1)
USB_D+: U2.45 (PA12), U3.4 (I/O2)
USB_D-: U2.44 (PA11), U3.6 (I/O1)

Notes on the sheet:
Power Circuitry
Cload = 2 * (CL - Cstray)
Connectors and USB
STM32 Microcontroller
