prs2026/Lyra-flight-computer/CamControl/camcontrolstm32cubepleaseworkibegofyou/Core/Inc/main.h

#define PRW_A_EN_Pin GPIO_PIN_4
#define PRW_A_EN_GPIO_Port GPIOB
#define PWR_B_EN_Pin GPIO_PIN_5
#define PWR_B_EN_GPIO_Port GPIOA
#define BATT_SENSE_A_Pin GPIO_PIN_13
#define BATT_SENSE_A_GPIO_Port GPIOA
