prs2026/Lyra-flight-computer/Hope/Firmware/HopeArduino Reciever/src/main.cpp

#include <Arduino.h>
/*******************************************************************************************************
  Programs for Arduino - Copyright of the author Stuart Robinson - 08/02/20

  This program is supplied as is, it is up to the user of the program to decide if the program is
  suitable for the intended purpose and free from errors.
*******************************************************************************************************/

/*******************************************************************************************************
  Program Operation - The program listens for incoming packets using the LoRa settings in the 'Settings.h'
  file. The pins to access the lora device need to be defined in the 'Settings.h' file also.

  There is a printout of the valid packets received, the packet is assumed to be in ASCII printable text,
  if its not ASCII text characters from 0x20 to 0x7F, expect weird things to happen on the Serial Monitor.
  The LED will flash for each packet received and the buzzer will sound, if fitted.

  Sample serial monitor output;

  1109s  Hello World 1234567890*,CRC,DAAB,RSSI,-61dBm,SNR,9dB,Length,23,Packets,1026,Errors,0,IRQreg,50

  If there is a packet error it might look like this, which is showing a CRC error,

  1189s PacketError,RSSI,-111dBm,SNR,-12dB,Length,0,Packets,1126,Errors,1,IRQreg,70,IRQ_HEADER_VALID,IRQ_CRC_ERROR,IRQ_RX_DONE

  Serial monitor baud rate is set at 9600.
*******************************************************************************************************/

#include <SPI.h>                                 //the lora device is SPI based so load the SPI library
#include <SX128XLT.h>                            //include the appropriate library   
#include <basiclib.h>

//*******  Setup hardware pin definitions here ! ***************

//These are the pin definitions for one of my own boards, the Easy Pro Mini,
//be sure to change the definitions to match your own setup.

#define NSS PIN_CS
#define RFBUSY PIN_BUSY
#define NRESET PIN_DIO3
#define LED1 PIN_LED
#define DIO1 PIN_DIO1
#define RX_EN -1                                //pin for RX enable, used on some SX1280 devices, set to -1 if not used
#define TX_EN -1                                //pin for TX enable, used on some SX1280 devices, set to -1 if not used  
#define BUZZER -1                               //pin for BUZZER, set to -1 if not used 


#define LORA_DEVICE DEVICE_SX1280               //we need to define the device we are using  

//LoRa Modem Parameters
const uint32_t Frequency = 2450000000;           //frequency of transmissions
const int32_t Offset = 0;                        //offset frequency for calibration purposes
const uint8_t Bandwidth = LORA_BW_0400;          //LoRa bandwidth
const uint8_t SpreadingFactor = LORA_SF7;        //LoRa spreading factor
const uint8_t CodeRate = LORA_CR_4_5;            //LoRa coding rate

const int8_t TXpower = 10;                       //Power for transmissions in dBm

const uint16_t packet_delay = 1000;              //mS delay between packets

#define RXBUFFER_SIZE 255                        //RX buffer size  


SX128XLT LT;                                     //create a library class instance called LT



uint32_t RXpacketCount;
uint32_t errors;

uint8_t RXBUFFER[RXBUFFER_SIZE];                 //create the buffer that received packets are copied into

uint8_t RXPacketL;                               //stores length of packet received
int16_t  PacketRSSI;                             //stores RSSI of received packet
int8_t  PacketSNR;                               //stores signal to noise ratio of received packet

void printElapsedTime()
{
  float seconds;
  seconds = millis() / 1000;
  Serial.print(seconds, 0);
  Serial.print(F("s"));
}


void packet_is_OK()
{
  uint16_t IRQStatus, localCRC;

  IRQStatus = LT.readIrqStatus();                  //read the LoRa device IRQ status register

  RXpacketCount++;

  printElapsedTime();                              //print elapsed time to Serial Monitor
  Serial.print(F("  "));
  LT.printASCIIPacket(RXBUFFER, RXPacketL);        //print the packet as ASCII characters

  localCRC = LT.CRCCCITT(RXBUFFER, RXPacketL, 0xFFFF);  //calculate the CRC, this is the external CRC calculation of the RXBUFFER
  Serial.print(F(",CRC,"));                        //contents, not the LoRa device internal CRC
  Serial.print(localCRC, HEX);
  Serial.print(F(",RSSI,"));
  Serial.print(PacketRSSI);
  Serial.print(F("dBm,SNR,"));
  Serial.print(PacketSNR);
  Serial.print(F("dB,Length,"));
  Serial.print(RXPacketL);
  Serial.print(F(",Packets,"));
  Serial.print(RXpacketCount);
  Serial.print(F(",Errors,"));
  Serial.print(errors);
  Serial.print(F(",IRQreg,"));
  Serial.print(IRQStatus, HEX);
}


void packet_is_Error()
{
  uint16_t IRQStatus;
  IRQStatus = LT.readIrqStatus();                   //read the LoRa device IRQ status register

  printElapsedTime();                               //print elapsed time to Serial Monitor

  if (IRQStatus & IRQ_RX_TIMEOUT)                   //check for an RX timeout
  {
    Serial.print(F(" RXTimeout"));
  }
  else
  {
    errors++;
    Serial.print(F(" PacketError"));
    Serial.print(F(",RSSI,"));
    Serial.print(PacketRSSI);
    Serial.print(F("dBm,SNR,"));
    Serial.print(PacketSNR);
    Serial.print(F("dB,Length,"));
    Serial.print(LT.readRXPacketL());               //get the real packet length
    Serial.print(F(",Packets,"));
    Serial.print(RXpacketCount);
    Serial.print(F(",Errors,"));
    Serial.print(errors);
    Serial.print(F(",IRQreg,"));
    Serial.print(IRQStatus, HEX);
    LT.printIrqStatus();                            //print the names of the IRQ registers set
  }

  delay(250);                                       //gives a longer buzzer and LED flash for error

}

void loop()
{
  RXPacketL = LT.receive(RXBUFFER, RXBUFFER_SIZE, 60000, WAIT_RX); //wait for a packet to arrive with 60seconds (60000mS) timeout

  digitalWrite(LED1, HIGH);                      //something has happened

  if (BUZZER > 0)                                //turn buzzer on
  {
    digitalWrite(BUZZER, HIGH);
  }

  PacketRSSI = LT.readPacketRSSI();              //read the recived RSSI value
  PacketSNR = LT.readPacketSNR();                //read the received SNR value

  if (RXPacketL == 0)                            //if the LT.receive() function detects an error, RXpacketL == 0
  {
    packet_is_Error();
  }
  else
  {
    packet_is_OK();
  }

  if (BUZZER > 0)
  {
    digitalWrite(BUZZER, LOW);                    //buzzer off
  }

  digitalWrite(LED1, LOW);                        //LED off

  Serial.println();
}







void led_Flash(uint16_t flashes, uint16_t delaymS)
{
  uint16_t index;

  for (index = 1; index <= flashes; index++)
  {
    digitalWrite(LED1, HIGH);
    delay(delaymS);
    digitalWrite(LED1, LOW);
    delay(delaymS);
  }
}


void setup()
{

  delay(5000);

  pinMode(LED1, OUTPUT);                        //setup pin as output for indicator LED
  led_Flash(2, 125);                            //two quick LED flashes to indicate program start

  Serial.begin(9600);
  Serial.println();
  Serial.println(F("4_LoRa_Receiver Starting"));

  if (BUZZER > 0)
  {
    pinMode(BUZZER, OUTPUT);
    digitalWrite(BUZZER, HIGH);
    delay(50);
    digitalWrite(BUZZER, LOW);
  }

  pinMode(PIN_TXCOEN,OUTPUT);
  digitalWrite(PIN_TXCOEN,HIGH);
  delay(3);

  SPI1.setSCK( PIN_SCK ); // bool setSCK(pin_size_t pin);
  SPI1.setTX( PIN_MOSI );  // bool setTX(pin_size_t pin);
  SPI1.setRX( PIN_MISO );  // bool setRX(pin_size_t pin);
  SPI1.begin();


  //SPI beginTranscation is normally part of library routines, but if it is disabled in the library
  //a single instance is needed here, so uncomment the program line below
  //SPI.beginTransaction(SPISettings(8000000, MSBFIRST, SPI_MODE0));

  //setup hardware pins used by device, then check if device is found
  if (LT.begin(NSS, NRESET, RFBUSY, DIO1, RX_EN, TX_EN, LORA_DEVICE))
  {
    Serial.println(F("LoRa Device found"));
    led_Flash(2, 125);
    delay(1000);
  }
  else
  {
    Serial.println(F("No device responding"));
    while (1)
    {
      led_Flash(50, 50);                                       //long fast speed LED flash indicates device error
    }
  }

  //The function call list below shows the complete setup for the LoRa device using the information defined in the
  //Settings.h file.
  //The 'Setup LoRa device' list below can be replaced with a single function call;
  //LT.setupLoRa(Frequency, Offset, SpreadingFactor, Bandwidth, CodeRate);

  //***************************************************************************************************
  //Setup LoRa device
  //***************************************************************************************************
  LT.setMode(MODE_STDBY_RC);
  LT.setRegulatorMode(USE_LDO);
  LT.setPacketType(PACKET_TYPE_LORA);
  LT.setRfFrequency(Frequency, Offset);
  LT.setBufferBaseAddress(0, 0);
  LT.setModulationParams(SpreadingFactor, Bandwidth, CodeRate);
  LT.setPacketParams(12, LORA_PACKET_VARIABLE_LENGTH, 255, LORA_CRC_ON, LORA_IQ_NORMAL, 0, 0);
  LT.setDioIrqParams(IRQ_RADIO_ALL, (IRQ_TX_DONE + IRQ_RX_TX_TIMEOUT), 0, 0);
  LT.setHighSensitivity();
  //***************************************************************************************************


  Serial.println();
  LT.printModemSettings();                                     //reads and prints the configured LoRa settings, useful check
  Serial.println();
  LT.printOperatingSettings();                                 //reads and prints the configured operting settings, useful check
  Serial.println();
  Serial.println();
  LT.printRegisters(0x900, 0x9FF);                             //print contents of device registers
  Serial.println();
  Serial.println();

  Serial.print(F("Receiver ready - RXBUFFER_SIZE "));
  Serial.println(RXBUFFER_SIZE);
  Serial.println();
}













// #include <SPI.h>                                //the lora device is SPI based so load the SPI library                                         

// #include "basiclib.h"
// #include "sx1280lib.h"
// #include <gpslib.h>

// #define MODEFLIGHT
// //#define MODESTATION

// #if !defined(MODEFLIGHT)
// #if !defined(MODESTATION)
// #define MODEGROUND

// #endif // MODE FLIGHT
// #endif // MODE STATION
// sx1280radio radio;
// gpsinput gps;

// const uint32_t checkinterval = 500;
// uint32_t checktime;

// const uint32_t sendpacketinterval = 2000;
// uint32_t sendpackettime;

// uint8_t camstatus;


// void setup( ) {
//   delay(3000);
//   Serial.begin();
//   Serial.println("init");
//   pinMode( PIN_LED, OUTPUT);

//   pinMode( PIN_TXCOEN, OUTPUT );
//   digitalWrite( PIN_TXCOEN, HIGH );

//   radio.initradio();

//   Serial1.setRX(UART_RX_PIN);
//   Serial1.setTX(UART_TX_PIN);

//   Serial1.begin(9600);
 
  

//   #if defined(MODEFLIGHT)
//   Serial.print("flightuni");
//   radio.setuptorange(0x01);
  
//   pinMode(UART_TX_PIN,OUTPUT);
//   digitalWrite(UART_TX_PIN, HIGH);
  
//   #endif // MODEFLIGHT
  
//   #if defined(MODEGROUND)

//   Serial.print("pingstation");

//   radio.setuptorange(0x00);
//   radio.settolisten();
  
//   #endif // MODEGROUND
//   #if defined(MODESTATION)

//   Serial.print("groundstation");
  
//   #endif // MODEGROUND

// }

// void loop() {
//   #if defined(MODEFLIGHT)

//   packet testtest;

//   testtest.uptime = millis();
//   testtest.battvoltage = 4;
//   testtest.command = camstatus;
  
//   radio.sendpacket(testtest);

//   //radio.pingrange();

//   delay(1000);
  
//   #endif // MODEFLIGHT
  
//   #if defined(MODEGROUND)

//   if(millis() - checktime > checkinterval){

//     checktime = millis();
//     radio.checkforping();
//   }

  

//   //gps.checkformessages();
  
//   #endif // MODEGROUND

//   #if defined(MODESTATION)
  
//   packet newpacket = radio.receivepacket();

//   //Serial.printf("\n>uptime: %d",newpacket.uptime);
//   //Serial.printf("\n>battvolts: %f",newpacket.battvoltage);
//   //Serial.printf("\n>status: %d",newpacket.command);
//   #endif // MODESTATION
  

  
// }
