prs2026/Lyra-flight-computer/CamControl/firmware/attemptthree/main copy.c

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
/* Includes ------------------------------------------------------------------*/
#include "main.h"

UART_HandleTypeDef huart2;

/* USER CODE BEGIN PV */
/* Buffer used for transmission */
uint8_t aTxStartMessage[] = "\n\r ****UART-Hyperterminal communication based on IT ****\n\r Enter 10 characters using keyboard :\n\r";
uint8_t aTxEndMessage[] = "\n\r Example Finished\n\r";

/* Buffer used for reception */
uint8_t aRxBuffer[RXBUFFERSIZE];
/* USER CODE END PV */

void SystemClock_Config(void);
static void MX_GPIO_Init(void);
static void MX_USART2_UART_Init(void);
/**
  * @brief  The application entry point.
  * @retval int
  */
int main(void)
{

  /* USER CODE BEGIN 1 */
  /* STM32WLxx HAL library initialization:
       - Configure the Flash prefetch
       - Systick timer is configured by default as source of time base, but user 
         can eventually implement his proper time base source (a general purpose 
         timer for example or other time source), keeping in mind that Time base 
         duration should be kept 1ms since PPP_TIMEOUT_VALUEs are defined and 
         handled in milliseconds basis.
       - Set NVIC Group Priority to 4
       - Low Level Initialization
     */
  /* USER CODE END 1 */

  /* MCU Configuration--------------------------------------------------------*/

  /* Reset of all peripherals, Initializes the Flash interface and the Systick. */
  HAL_Init();

  /* Configure the system clock */
  SystemClock_Config();

  // /* USER CODE BEGIN SysInit */
  // /* Configure leds */
  // /* Configure LED1 and LED3 */
  // BSP_LED_Init(LED1);
  // BSP_LED_Init(LED3);
  // /* USER CODE END SysInit */

  /* Initialize all configured peripherals */
  MX_GPIO_Init();
  MX_USART2_UART_Init();
  /* USER CODE BEGIN 2 */

  /*##-1- Start the transmission process #####################################*/
  /* While the UART in reception process, user can transmit data through
     "aTxBuffer" buffer */
  if(HAL_UART_Transmit_IT(&huart2, (uint8_t*)aTxStartMessage, TXSTARTMESSAGESIZE)!= HAL_OK)
  {
    /* Transfer error in transmission process */
    Error_Handler();
  }

  /*##-2- Put UART peripheral in reception process ###########################*/
  /* Any data received will be stored in "aRxBuffer" buffer : the number max of
     data received is 10 */
  if(HAL_UART_Receive_IT(&huart2, (uint8_t *)aRxBuffer, RXBUFFERSIZE) != HAL_OK)
  {
    /* Transfer error in reception process */
    Error_Handler();
  }

  /*##-3- Wait for the end of the transfer ###################################*/
  /*  Before starting a new communication transfer, you need to check the current
      state of the peripheral; if it is busy you need to wait for the end of current
      transfer before starting a new one.
      For simplicity reasons, this example is just waiting till the end of the
      transfer, but application may perform other tasks while transfer operation
      is ongoing. */
  while (HAL_UART_GetState(&huart2) != HAL_UART_STATE_READY)
  {
  }

  /*##-4- Send the received Buffer ###########################################*/
  if(HAL_UART_Transmit_IT(&huart2, (uint8_t*)aRxBuffer, RXBUFFERSIZE)!= HAL_OK)
  {
    /* Transfer error in transmission process */
    Error_Handler();
  }

  /*##-5- Wait for the end of the transfer ###################################*/
  /*  Before starting a new communication transfer, you need to check the current
      state of the peripheral; if it is busy you need to wait for the end of current
      transfer before starting a new one.
      For simplicity reasons, this example is just waiting till the end of the
      transfer, but application may perform other tasks while transfer operation
      is ongoing. */
  while (HAL_UART_GetState(&huart2) != HAL_UART_STATE_READY)
  {
  }

  /*##-6- Send the End Message ###############################################*/
  if(HAL_UART_Transmit_IT(&huart2, (uint8_t*)aTxEndMessage, TXENDMESSAGESIZE)!= HAL_OK)
  {
    /* Transfer error in transmission process */
    Error_Handler();
  }

  /*##-7- Wait for the end of the transfer ###################################*/
  while (HAL_UART_GetState(&huart2) != HAL_UART_STATE_READY)
  {
  }

  /* Turn on LED1 if test passes then enter infinite loop */
  //BSP_LED_On(LED1);

  /* USER CODE END 2 */

  /* Infinite loop */
  /* USER CODE BEGIN WHILE */
  while (1)
  {
    /* USER CODE END WHILE */
      /*##-6- Send the End Message ###############################################*/
    if(HAL_UART_Transmit_IT(&huart2, (uint8_t*)aTxEndMessage, TXENDMESSAGESIZE)!= HAL_OK)
    {
      /* Transfer error in transmission process */
      Error_Handler();
    }


    /* USER CODE BEGIN 3 */

  }
  /* USER CODE END 3 */
}

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
/* USER CODE BEGIN 4 */


/**
  * @brief  Tx Transfer completed callback
  * @param  UartHandle: UART handle.
  * @note   This example shows a simple way to report end of IT Tx transfer, and
  *         you can add your own implementation.
  * @retval None
  */
void HAL_UART_TxCpltCallback(UART_HandleTypeDef *UartHandle)
{
}

/**
  * @brief  Rx Transfer completed callback
  * @param  UartHandle: UART handle
  * @note   This example shows a simple way to report end of IT Rx transfer, and
  *         you can add your own implementation.
  * @retval None
  */
void HAL_UART_RxCpltCallback(UART_HandleTypeDef *UartHandle)
{
}

/**
  * @brief  UART error callbacks
  * @param  UartHandle: UART handle
  * @note   This example shows a simple way to report transfer error, and you can
  *         add your own implementation.
  * @retval None
  */
void HAL_UART_ErrorCallback(UART_HandleTypeDef *UartHandle)
{
  /* Turn LED3 on: Transfer error in reception/transmission process */
  //BSP_LED_On(LED3);
}


/* USER CODE END 4 */
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
