prs2026/Lyra-flight-computer/Software/Ground/lero reciver/audio player arduino/audio_pgm.ino/audio_pgm.ino.ino

#include "SD.h"
#define SD_ChipSelectPin 10
#include "TMRpcm.h"
#include "SPI.h"

TMRpcm tmrpcm;

void setup()
{
tmrpcm.speakerPin=9;
Serial.begin(9600);
if(!SD.begin(SD_ChipSelectPin))
{
  Serial.println("SD fail");
  return;
}
tmrpcm.setVolume(6);
tmrpcm.play("test.wav");

}

void loop() {
  // put your main code here, to run repeatedly:

}
