prs2026/Lyra-flight-computer/avionics/Lyra_flight_computer/RP2040/lyrav2/sketch_3d_reviewer/sketch_3d_reviewer.pde

import shapes3d.*;


Box shape;

float angles[][] = {
{0,0.913366,32.394470,-78.808840},
{5143,0.913366,32.394470,-78.808840},
{7202,1.304961,38.347793,-78.352577},
{8697,4.640881,34.546988,-91.814572},
{8854,4.229540,34.294557,-91.559943},
{8925,4.229540,34.294557,-91.559943},
{8998,4.229540,34.294557,-91.559943},
{9159,4.125159,34.328312,-90.874916},
{9235,4.125159,34.328312,-90.874916},
{9316,4.125159,34.328312,-90.874916},
{9544,3.693514,34.252398,-90.388053},
{9624,3.693514,34.252398,-90.388053},
{9707,3.496246,34.303440,-90.132843},
{9878,3.331200,34.403161,-89.999149},
{9965,3.161312,34.270935,-89.837949},
{10053,3.161312,34.270935,-89.837949},
{10230,2.865241,34.394985,-89.687521},
{10323,2.711562,34.435895,-89.668151},
{10564,2.687906,34.268432,-89.750701},
{10659,2.687906,34.268432,-89.750701},
{10756,2.687906,34.268432,-89.750701},
{10986,1.534927,34.897725,-90.183700},
{11052,1.534927,34.897725,-90.183700},
{11123,1.534927,34.897725,-90.183700},
{11282,1.460594,35.068496,-90.495157},
{11411,1.460594,35.068496,-90.495157},
{11578,2.933282,34.743427,-90.981036},
{11656,2.933282,34.743427,-90.981036},
{11734,2.933282,34.743427,-90.981036},
{11899,15.823506,32.473168,-98.514994},
{11979,15.823506,32.473168,-98.514994},
{12062,15.823506,32.473168,-98.514994},
{12233,35.140862,24.559639,-105.528656},
{12379,35.140862,24.559639,-105.528656},
{12551,51.179881,18.453851,-109.960001},
{12640,51.179881,18.453851,-109.960001},
{12730,51.179881,18.453851,-109.960001},
{12909,66.119544,15.342010,-110.770683},
{13004,66.119544,15.342010,-110.770683},
{13098,71.269472,13.156701,-110.018986},
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



};

int index = 0;
int starttime = 0;
void setup(){
  size(800, 600, P3D);
  //perspective(PI/3, float(width)/height, 1, 200);
  shape = new Box(
    100,    // width
    200,    // height
    40      // depth
   );
  starttime = int(angles[0][0]);
  print(starttime);
}

float x,y,z = 0;
//------------------------------------------------------------------ 
void draw(){
  if(millis()+starttime >= angles[index][0]){
  printArray(angles[index]);

  x = angles[index][1]*PI/180;
  y = angles[index][2]*PI/180;
  z = angles[index][3]*PI/180;
  index++;
  }
  
  background(0);
  pushMatrix();
  // Move the world view coordinates [0,0,0] 
  // to the centre of the display.
  translate(width/2, height/2);
  // The next few lines rotate the graphics 
  // context so we view the shape from dfiierent 
  // angles making it appear to be tumbling.
  rotateX(x);
  rotateY(z);
  rotateZ(y);

  // Render the shape on the main display area
  shape.draw(getGraphics());

  popMatrix();
  // Display a status bar and show the results from the
  // last shape pick operation (see mouseClicked method)
  fill(200, 255, 200);
  
}
