prs2026/Lyra-flight-computer/avionics/Lyra_flight_computer/RP2040/lyrav2/sketch_3d_reviewer/parser.py

f = open("input.csv","r")

import csv
content = list(csv.reader(f,delimiter=","));

output = []
outstring = ''
l = 0
for i in content:
    output.append([0.0,0.0,0.0,0.0])
    output[l][0] = i[1]
    output[l][1] = i[20]
    output[l][2] = i[21]
    output[l][3] = i[22]
    outstring = outstring + "{" + ','.join(output[l]) + "},\n"
    l = l+1
    
f.close()

fd = open("output.csv","w+")
fd.write(outstring)
# print(content)
# print(output)
print(outstring)
