prs2026/Lyra-flight-computer/Software/Flight/testing/test sketch/src/main.cpp

#include <Arduino.h>

// led pins
#define LEDPIN 17


//scans the i2c bus, returns 1 if none are found, otherwise 0
uint8_t scani2c(bool printout){
    byte error, address;
    int nDevices;
     printout ? Serial.print("Scanning..")  : 0;
    
    nDevices = 0;
    for(address = 1; address < 127; address++ )
    {
        // The i2c_scanner uses the return value of
        // the Write.endTransmisstion to see if
        // a device did acknowledge to the address.
        Wire1.beginTransmission(address);
        error = Wire1.endTransmission();
        if (error == 0)
        {
        printout ? Serial.print("I2C device found at address 0x") : 0;
        if (address<16)
            Serial.print("0");
        printout ? Serial.print(address,HEX) : 0;
        printout ? Serial.println("  !") : 0;
    
        nDevices++;
        }
        else if (error==4)
        {
        printout ? Serial.print("Unknown error at address 0x") : 0;
        if (address<16)
            printout ? Serial.print("0") : 0;
            printout ? Serial.println(address,HEX) : 0;
        }    
    }
    if (nDevices == 0){
        printout ? Serial.println("No I2C devices found\n") : 0;
        return 1;
    }
    else
        printout ? Serial.println("done\n") : 0;
    
    return 0;
}




void setup() {
  pinMode(LEDPIN,OUTPUT);
  Serial.begin();
}

void loop() {
  digitalWrite(LEDPIN,HIGH);
  delay(1000);
  digitalWrite(LEDPIN,LOW);
  delay(1000);
  Serial.println("i live");
}
