prs2026/Lyra-flight-computer/(commit log)

2023-11-16 lyrav3 init
    [Lyrav3.kicad_pcb, Lyrav3.kicad_sch]
2023-11-16 lyrav3 init fo real
    [Lyrav3.kicad_pcb, Lyrav3.kicad_sch]
2023-11-16 lyra v3 work
    got most of the sensors and other stuff picked out
    [Lyrav3.kicad_pcb]
2023-11-17 lyrav3 work and more orientation work
    [Lyrav3.kicad_sch]
2023-11-19 lyra v3 work
    [Lyra V2.kicad_sch, Lyrav3.kicad_pcb, Lyrav3.kicad_sch]
2023-11-19 more lyra v3 work and stuff
    [Lyrav3.kicad_sch]
2023-11-21 lyrav3 and kf work
    added 2nd mcu for lyra and got z accel working for kf
    [Lyrav3.kicad_pcb, Lyrav3.kicad_sch]
2023-11-22 more lyrav3 work
    [Lyrav3.kicad_pcb, Lyrav3.kicad_sch]
2023-11-24 more lyrav3 work and improved logging schema
    [Lyrav3.kicad_pcb, Lyrav3.kicad_sch]
2023-11-24 cadded it, it fits!
    [Lyrav3.kicad_pcb, Lyrav3.kicad_sch]
2023-11-27 bunch of stuff, new rouiting
    [Lyrav3.kicad_sch, Lyrav3og.kicad_pcb, freerouting.dsn]
2023-11-28 got the radio responding to uart
2023-11-30 more lyrav3 work as well as more work on new text file and DMA
    [Lyrav3.kicad_pcb, Lyrav3.kicad_sch]
2023-12-04 more lyrv v3 work
    [Lyrav3.kicad_pcb, Lyrav3.kicad_sch]
2023-12-04 more lyra v3 work
    got rid of the second MCU, just going to use I/O expanders and an ADC
    [Lyrav3.kicad_sch]
2023-12-04 sync hole footprint
2023-12-08 simplified lyrav3
    [Board2.kicad_sch, Lyrav3.kicad_pcb, Lyrav3.kicad_sch, Lyrav3complicated.kicad_pcb, Lyrav3complicated.kicad_sch, Lyrav3og.kicad_pcb, accessaryboard.kicad_sch, boardmain.kicad_sch]
2023-12-09 lyrav3 work
    [Lyrav3.kicad_pcb, Lyrav3.kicad_sch]
2023-12-10 more everything to back of board, find JLC components for everything
    [BOM.csv, Board2.kicad_sch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]
2023-12-11 routing init
    [Lyrav3.kicad_sch]
2023-12-11 silkscreen work and add parser to display rotation data
    [Lyrav3.kicad_pcb, input.csv, output.csv]
2023-12-11 more work on the data displayer
    [input.csv, output.csv]
2023-12-13 move aruond
    [Lyrav3.kicad_pcb, Lyrav3.kicad_sch]
2023-12-13 routing twioce
    [Lyrav3.kicad_pcb, Lyrav3.kicad_sch]
2023-12-13 rout lyrav3 fully
    [Lyrav3.kicad_pcb, Lyrav3.kicad_sch]
2023-12-13 routing and updating lcsc part nums
    [Lyrav3.kicad_pcb]
2023-12-14 bom and stuff
    [bom.csv, designators.csv, positions.csv]
2023-12-16 real pretrip
    [Lyrav3-B_Cu.gbr, Lyrav3-B_Mask.gbr, Lyrav3-B_Paste.gbr, Lyrav3-B_Silkscreen.gbr, Lyrav3-Edge_Cuts.gbr, Lyrav3-F_Cu.gbr, Lyrav3-F_Mask.gbr, Lyrav3-F_Paste.gbr]
2023-12-18 change baro to dps310
    [BOM-Lyrav3.csv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]
2023-12-19 fixed more stuff with the library, got telemetry down
    [main.cpp]
2023-12-19 autosave before slep
    [Lyrav3.kicad_pcb, Lyrav3.kicad_sch]
2023-12-23 found new brownout cap
    [Lyrav3.kicad_pcb, Lyrav3.kicad_sch]
2023-12-24 new routing and other stuff
    add brownout cap
    [Lyrav3.kicad_pcb, Lyrav3.kicad_sch]
2023-12-25 post order commit
    [BOM-Lyrav3.csv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]
2023-12-28 restructure and divide into cpp vs h files
    [BOM-Lyrav3.csv, BOM.csv, Board2.kicad_sch, Computing Board.kicad_sch, LOGFILE1.CSV, LOGFILE2.CSV, Lyra V2 og rountign.kicad_pcb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]
2024-01-04 built cad
    [Lyrav3.kicad_pcb, Lyrav3.kicad_sch]
2024-01-05 adxl working and datalogging work
    [test1.csv]
2024-01-06 lero schematic
    [lero ground station.kicad_sch]
2024-01-06 Create lero ground station-2024-01-05_203944.zip
2024-01-06 schemtic before soildering
    [lero ground station.kicad_sch]
2024-01-08 lcd kinda workign with nano
    [lero ground station.kicad_sch]
2024-01-11 lcd working on main board
2024-01-17 lots of stuff
    radios working, filter sort of working, reciver talking to itself and talking, lcd working
2024-01-22 log creats
    [pyxis data log far 1-20.csv, pyxis data log far 1-20raw.csv]
2024-01-24 python getter script
    [logfile.csv]
2024-01-25 logging and logging script work
    [logfile 01,23,2024, 22,29,56.csv, logfile.csv]
2024-01-25 add gps module init
    [BOM-Lyrav3.csv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]
2024-01-28 post flight commit
    [logfile 01,23,2024, 22,29,56.csv, logfile 01,28,2024, 10,42,35.csv, logfile 01,28,2024, 11,30,10.csv, reciver log 1-28 - Copy.csv, reciver log 1-28 flight 1- .csv, reciver log 1-28.csv, reciver log flight 2 1-28.csv, testtube flight 1 01,28,2024, 10,42,35 - Copy.csv]
2024-02-04 post flght commit
    [alex data log 2.3 - Copy.csv, alex data log 2.3.csv, logfile 01,23,2024, 22,29,56.csv, logfile 02,03,2024, 12,00,48.csv, logfile 02,03,2024, 15,59,32.csv, logfile 02,03,2024, 16,02,55.csv, logfile 02,03,2024, 16,50,15.csv, logfile 02,03,2024, 16,56,46.csv]
2024-02-14 logging totally working
    [logfile 01,23,2024, 22,29,56.csv, logfile 01,28,2024, 10,42,35.csv, logfile 01,28,2024, 11,30,10.csv, logfile 02,03,2024, 12,00,48.csv, logfile 02,03,2024, 15,59,32.csv, logfile 02,03,2024, 16,02,55.csv, logfile 02,03,2024, 16,50,15.csv, logfile 02,03,2024, 16,56,46.csv]
2024-02-14 got it reciving the logs baybee
    [flight 1.csv, flight 2.csv, flight 3.csv, flight 4.csv, flight 5.csv, rawfile.csv]
2024-02-19 init v3r1
    [BOM-Lyrav3.csv, BOM.csv, Board2.kicad_sch, Lyrav3complicated.kicad_pcb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]
2024-02-20 fixed klauch deyect
    [lyrav3r1.kicad_sch]
2024-02-20 got logs down
    [flight 2.csv, flight 3.csv, flight 4.csv, flight 5.csv, flight 6.csv, flight 7.csv, rawfile.csv]
2024-02-27 gps thingings
    [BOM-Lyrav3.csv, BOM.csv, Board2.kicad_sch, Lyrav3complicated.kicad_pcb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]
2024-02-27 more radio stuffs
    [lyrav3r1.kicad_pcb, lyrav3r1.kicad_sch]
2024-02-28 stuffs
    more telemetry work, selected oscilator
    [lyrav3r1.kicad_sch]
2024-02-29 gps init, moar librarys
    [lyrav3r1.kicad_pcb, lyrav3r1.kicad_sch]
2024-03-03 magswitch lol
    [BOM-magswitch.csv, lyrav3r1.kicad_sch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]
2024-03-04 magswitch work
    [magswitch.kicad_pcb, magswitch.kicad_sch]
2024-03-05 gps and rf
    [lyrav3r1.kicad_pcb, lyrav3r1.kicad_sch]
2024-03-08 change back to sx1262
    [lyrav3r1.kicad_pcb, lyrav3r1.kicad_sch]
2024-03-20 redoing stuff
    [lyrav3r1.kicad_pcb, lyrav3r1.kicad_sch]
2024-03-21 found new gps chip and getting close t oend of schematic
    [Lyrav3.kicad_sch, lyrav3r1.kicad_pcb, lyrav3r1.kicad_sch]
2024-03-23 first pass at routing
    [BOM-lyrav3r1.csv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]
2024-03-25 reciver and stuff
    [MCU.kicad_sch, recivier.kicad_pcb, recivier.kicad_sch]
2024-03-26 added batt protection for lyra, added more parts for reciver
    [lyrav3r1.kicad_pcb, lyrav3r1.kicad_sch, recivier.kicad_pcb]
2024-03-27 reciver work and finalized lyrav3r1
    [BOM-lyrav3r1.csv, BOM-recivier.csv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]
2024-03-28 work, lyra mostly final
    [lyrav3r1.kicad_pcb, lyrav3r1.kicad_sch, recivier.kicad_pcb, recivier.kicad_sch]
2024-03-28 reciver rework
    [recivier.kicad_pcb, recivier.kicad_sch]
2024-04-02 post order omcmit
    [BOM-recivier.csv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]
2024-04-03 post sending to watuh
    [recivier.kicad_pcb]
2024-04-09 prod files
    [BOM-magswitch.csv, BOM-screw switch.csv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]
2024-04-17 maybe hitl?
    [inputfile.csv]
2024-04-23 new hitl test
    [inputfile.csv]
2024-04-24 kf init, orientation broken
    [main.cpp]
2024-04-24 kf kinda working, orientation no longer super bugged
    [main.cpp]
2024-04-25 gps not working but kalman kinda working
    [inputfile.csv]
2024-05-11 log upload
    [teleplot_2024-5-11_12-16.csv]
2024-05-12 got real data off, also fixed data printing
    [check123flight1.csv, flight 3.csv, flight 4.csv, flight1.csv, flight2.csv, test.csv]
2024-05-26 lyrav3r2 init
    [lyrav3r2.kicad_pcb, lyrav3r2.kicad_sch]
2024-06-18 work, inital layout
    [lyrav3r2.kicad_pcb, lyrav3r2.kicad_sch]
2024-06-24 EOD 6/24
    [lyrav3r2.kicad_pcb, lyrav3r2.kicad_sch]
2024-06-25 fixed the crystal cap
    [lyrav3r2.kicad_sch]
2024-07-03 new boards sort of brought up, gps getting time fix but no pos fix
    [check123flight1.csv, flight 1.csv, flight 2.csv, flight 3.csv, flight 4.csv, flight 5.csv, flight 6.csv, flight 7.csv]
2024-07-04 updated contiunity checking to work with new boards
2024-10-01 shtuff, leo init
    [teleplot_2024-7-21_14-39.csv]
2024-10-01 leo workl
    [BOM-lyrav3r1.csv, BOM-lyrav3r2.csv, BOM-recivier.csv, LEO.kicad_pcb, LEO.kicad_sch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]
2024-10-21 step file
    [Lyrav3r2.step]
2024-10-30 logging at 50 hz(:
    [check123flight1.csv, flight 1.csv, flight 2.csv, flight 3.csv, flight 4.csv, flight 5.csv, flight 6.csv, flight 7.csv]
2024-12-15 updates, turns on camera on chan1
2024-12-31 hopefully fix leo printing data
2025-01-23 hope start
    [Hope.kicad_pcb, Hope.kicad_sch, MCU.kicad_sch, Power.kicad_sch, Radio Module.kicad_sch]
2025-01-25 ping pong routing
    [BOM-Hope.csv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]
2025-01-26 ping pong sent for fab
    [Hope-CuBottom.gbr, Hope-CuIn1.gbr, Hope-CuIn2.gbr, Hope-CuTop.gbr, Hope-EdgeCuts.gbr, Hope-MaskBottom.gbr, Hope-MaskTop.gbr, Hope-NPTH.drl]
2025-02-06 hangoverflight pulled
    [Hope.step]
2025-05-10 it doesnt work - tryied to write custom library
    [camcontrol.kicad_sch]
2025-05-11 its communicating w/ sx1280 over spi library
2025-05-14 switched to other library which seems to work, trying to get ranging working again
2025-07-02 modified: Hope/Firmware/HopeArduino/lib/basiclib/basiclib.h modified: Hope/Firmware/HopeArduino/lib/sx1280lib/src/sx1280lib.cpp modified: Hope/Firmware/HopeArduino/platformio.ini modified: Hope/Firmw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
    [teleplot_2025-6-22_7-54.csv]
2025-08-10 it sure is getting hot in here
    [BOM-it sure is getting hot in here.csv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]
2025-08-23 it sure is getting hot in here software
    [BOM-it sure is getting hot in here.csv, check123flight1.csv, flight 1.csv, flight 2.csv, flight 3.csv, flight 4.csv, flight 5.csv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]
2025-08-24 data transfer and ranging working in parallel
    [teleplot_2025-6-22_7-54.csv]
2025-08-25 yo it could work rn
    [teleplot_2025-6-22_7-54.csv]
2025-09-30 metrumizing it
    [it sure is getting hot in here.kicad_pcb, it sure is getting hot in hererev1.step, it sure is getting hot in hererev2.step, metrumizer.kicad_pcb, metrumizer.kicad_sch]
2025-10-02 new pyro, looking at new RF. still no baord
    [TPS2H160 calculator.ods, metrumizer.kicad_pcb, metrumizer.kicad_sch]
2025-10-08 dan f10, n511 module, board layout
    [metrumizer.kicad_pcb, metrumizer.kicad_sch, metrumizeroldradio.kicad_sch]
2025-12-03 cam control
    [Hope.kicad_pcb, camcontrol.kicad_pcb, camcontrol.kicad_sch, it sure is getting hot in here.kicad_sch, metrumizer.kicad_pcb, metrumizer.kicad_sch]
2025-12-03 first routing pass
    [camcontrol.kicad_pcb, camcontrol.kicad_sch]
2025-12-03 cam control work and start on gruond station
    [BOM-camcontrol.csv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]
2025-12-04 cam control rework
    [BOM-camcontrol.csv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]
2025-12-08 camcontrol stm32
    [BOM-camcontrol.csv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]
2025-12-08 final version?
    [camcontrol stm32.kicad_pcb, camcontrol stm32.kicad_sch]
2025-12-09 rf rework and redrawing
    [camcontrol stm32.kicad_sch]
2025-12-09 shit make it good
    [camcontrol stm32.kicad_pcb]
2025-12-09 fixed dumb issue
    [camcontrol stm32.kicad_pcb, camcontrol stm32.kicad_sch]
2025-12-10 hopefully prod version
    [BOM-camcontrol stm32.csv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]
2025-12-10 nvm i missed it up
    [camcontrol stm32-CuBottom.gbr, camcontrol stm32-CuIn1.gbr, camcontrol stm32-CuIn2.gbr, camcontrol stm32-CuTop.gbr, camcontrol stm32-EdgeCuts.gbr, camcontrol stm32-MaskBottom.gbr, camcontrol stm32-MaskTop.gbr, camcontrol stm32-NPTH.drl]
2025-12-16 trying to get hope code working again
    [LEO.kicad_pcb, camcontrol stm32.kicad_pcb, camcontrol stm32.kicad_sch, camcontrol stm32.step]
2025-12-26 reconfigure trilateration to happen on ground station
2025-12-27 more work, made ground stations talk to each other
2026-02-20 duplex coms on stm32hal
    [BOM-camcontrol stm32.csv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]
2026-05-24 fixed logging, pre mass storage
    [main.cpp]
2026-05-30 mass storage and junk
    [teleplot_2026-5-24_15-12.csv, teleplot_2026-5-24_15-4.csv, teleplot_2026-5-24_17-20.csv, teleplot_2026-5-24_18-24.csv]
