prs2026/Lyra-flight-computer/(notices)

Notices in the files:
CamControl/firmware/attemptthree/main copy.c:
Copyright (c) 2020 STMicroelectronics.
All rights reserved.
This software is licensed under terms that can be found in the LICENSE file
CamControl/camcontrolstm32cubepleaseworkibegofyou/Core/Inc/main.h:
Copyright (c) 2026 STMicroelectronics.
